antevens/sladdseg/pcb/eu/fab/README.md

# EU boards v0.7 – PCBWay order packs

Generated by `make pcb` (`pcb/eu/tools/build.sh`), one folder per board. Do the review checklist
below before ordering. Spacing values are design targets, not a compliance claim, and the EU stack
depth is still to be tried in a real box (D-36).

| File (in each board's folder) | Use |
| --- | --- |
| `<board>_v0.7_gerbers.zip` | Upload as the PCB file: RS-274X Gerbers, Excellon drills in mm (PTH and NPTH separate), drill maps |
| `<board>_v0.7_bom.csv` | Assembly BOM with MPNs (the mains board's S1 and BAR1–BAR4 have quantity 0: do not fit) |
| `eu_mains_board_busbar_v0.7_bars.dxf` | The mains board's four bars for PCBWay's CNC / laser cutting: mm, one closed outline per bar with its pin holes |
| `<board>_v0.7_centroid.csv` | Centroid, both sides, origin = board centre (S1 and the mounting holes left out) |
| `<board>_v0.7_assembly_front.pdf`, `_assembly_back.pdf` | Assembly drawings (back mirrored) |
| `<board>_v0.7_schematic.pdf` | Schematic |
| `erc.rpt`, `drc.rpt` | ERC and DRC reports of this build (all severities, schematic parity on) |
| `gerbers/` | The unzipped Gerber and drill files |

## Mains board (`eu_mains_board_busbar/`)

- Round, 57.9 mm across, notched for the box's four screw domes; 2 layers, standard FR-4, 1.6 mm, **1 oz** (no PE on
  the board, D-94), **HASL lead-free**; the bars' lands have no solder mask.
- The load runs in four straight laser-cut copper bars on the front, along each WAGO pole's pin row to the rocker
  (D-153). Bars (PCBWay CNC / laser cutting): `eu_mains_board_busbar_v0.7_bars.dxf`, mm, copper C110 **0.5 mm**, tin
  plated, four pieces (BAR1–BAR4 in the BOM, not fitted). Soldered on the front before the board goes onto the
  barrier's bosses; S1 from the back after.
- **The outline has a routed relief slot under the PSU.** It is part of Edge.Cuts, not a drill: add
  "routed isolation slot in outline, do not omit" to the order remarks.
- Three Ø2.2 holes for the barrier's long bosses (M2), no copper within 1.0 mm.
- Front (F): F1, RV1, J3 (SMD). Back (B): J1, J2 (WAGO 2604-3102), PS1 (Zettler ZPI03S0500WC), THT.
- S1 (Marquardt 1802.2504) is **not fitted** by PCBWay: it snaps into the barrier's cup first. **Solder it by
  hand only after the mains board is screwed onto the barrier's bosses**: its holes are 5.2 mm plated slots
  (D-88), so the cup's panel cutout, not the board, locates the rocker.

## pin board (`eu_pin_board/`)

- D-shaped, 57.9 × 27.9 mm, notched round the domes and the mains board's boss; 2 layers, FR-4, 1.6 mm,
  1 oz.
- Front (F): C1 and four Harwin P70-2200045 SMT spring pins with pegs (D-59): P1 (GND) and P2 (+5V) onto the barrier
  board's pads, P3 (+5V) and P4 (GND) onto the battery-free back cover's pads (D-54). Back (B): J1, Samtec
  SSW-102-01-G-S socket (THT, gold contacts) onto the mains board's TSM header.

## Review checklist (before ordering)

- [ ] Isolation targets on the mains board (any two mains nets ≥ 3.2 mm on standard FR4, IEC 60664-1 creepage at
      the 320 V row, PD2; mains to the 5 V island ≥ 8.0 mm plus the slot, D-153) reviewed against IEC 60664-1 /
      62368-1 and the switch standard (IEC 60669-1); L and N bars both on the front (hard constraint 1).
- [ ] Thermal review of the bars (0.5 mm copper) and the 1 oz feeds to F1, RV1 and the PSU (under 1 A).
- [ ] The rocker's pin stems over the bars: on a sample, whether the 1802.2504's stems reach the board at the pads
      (our model of its drawing says they do); the bars lift it by 0.5 mm plus solder (D-153).
- [ ] The room between the board's front and the barrier for the bars (not in the CAD yet).
- [ ] WAGO 2604 pin size against the bars' 1.3 mm holes (MEASURE on a part).
- [ ] Optional conformal coating after assembly (D-152, docs/ASSEMBLY.md): used or not, the coating chosen; not counted towards the spacing.
- [ ] PS1 Zettler ZPI03S0500WC (D-100): its insulation class (reinforced?) and overvoltage category are not in the
      datasheet (I/P-O/P 3600 VAC, UL/EN 62368-1): confirm with Zettler or its UL / CB file before mains use.
- [ ] F1 T1A (Zettler's application circuit shows 0.5 A / 250 V) against the branch circuit's prospective fault current
      (UMT 250 breaking capacity).
- [ ] WAGO 2604-3102 pin rows checked on a part (from WAGO's 3D model).
- [ ] Header / socket stack: TSM-102-02-L-SV post 8.13 mm into the SSW socket (body 8.5 mm), 16.1 mm
      between the boards; 3.07 mm engagement as designed (D-59).
- [ ] Spring pin working height on a printed barrier (6.4–7.2 mm, designed 6.8 ± 0.3).
- [ ] EU stack depth tried in the printed test socket (D-76), then a real 47 mm box (−43.8 mm deepest part).
- [ ] Approvals of S1, J1, J2, PS1, F1 and RV1 adequate for the installation.
- [ ] PE (D-94): joined in the box in a WAGO 221-412, not on the boards; the steel piece in the barrier's pocket floor
      is the one metal part a user can touch with the remote out, insulated from mains only by the V-0 barrier: whether
      that is double / reinforced insulation (no PE needed) is for review.
- [ ] Second-source rocker E-Switch RA412C1100 (D-88): its tab rows on a sample, tabs soldered into the
      slots outside the maker's listed terminations (D-86), its 10(4) A ENEC rating accepted; S1's slot pads
      reach the WAGO bodies' edge (0.05 mm), 3.85 mm from their pins.
