antevens/sladdseg/docs/DESIGN.md

# Design: requirements and decision log

## Context

- NA single-gang device boxes, 2" × 3" opening (≈50.8 × 76.2 mm).
- Every light socket has an IKEA Matter (Thread) smart bulb(s). Typically controlled by Home Assistant.

## Requirements

| ID | Requirement |
|----|---|
| R1 | Replace each light switch with a plate that holds an IKEA BILRESA scroll-wheel remote, flush/recessed. |
| R2 | mmWave presence sensing in every switch location. |
| R3 | Temperature + humidity in every location. |
| R4 | Emergency means to (a) turn lights on when Home Assistant is down and (b) de-power the circuit. Need not be easily accessible. |
| R5 | Emergency off must also de-power the presence sensor. |
| R6 | Keep the face plate as thin as practical. |
| R7 | Same electronics usable in EU/UK (250 VAC-rated parts). |
| R8 | Printable on a hobby FDM printer (Elegoo Centauri Carbon 2 Combo, ElegooSlicer); PCB fab + THT assembly by PCBWay. |
| R9 | No soldered or plugged connection between the face plate and the barrier: every electrical interface across that split is a spring ("pogo") contact, so the face plate lifts off and goes back on blind (human requirement 2026-10-08). |
| R10 | No wires and no soldering at assembly between any two boards or modules. 5 V, NA and EU: spring (pogo) contacts preferred; a flex with a latching connector, long enough to plug and unplug by hand with the latch in view, only where spring contacts cannot reach. Mains: house wiring and mains leads end in WAGO push-in terminals on the board, never soldered (human requirements 2026-10-08). |

## Decision log

| ID | Decision | Why / rejected alternatives |
|----|---|---|
| D-1 | No existing product does R1+R2+R4 → custom plate. | Inovelli Blue mmWave dimmer (Zigbee, smart-bulb mode) considered; has no humidity, no Bilresa mount. |
| D-2 | Don't design own mains switching electronics or put Li-ion cells in the box. | Certification (CEC approved-equipment requirement), heat, fire risk. |
| D-3 | Presence: Apollo MSR-2 (ESPHome, Wi-Fi) rather than Matter sensor. | Aqara FP300 too big (42×42×50) and battery-tuned; IKEA has no mmWave (MYGGSPRAY is PIR); Everything Presence Lite too big, no climate. HA is the controller, so ESPHome native API is fine/better. MSR-2 is 40×24×15 cased. |
| D-4 | Climate: SHT45 on MSR-2 I²C, thermally isolated bay at plate bottom. | MSR-2's DPS310 reads high from ESP32 heat (Apollo says so); IKEA TIMMERFLOTTE (70×70×30) too big. |
| D-5 | Keep BILRESA intact (batteries in), recessed in box, removable. | De-cased board option explored (I-beam PCB, encoder + tactile) but intact is simpler, stays usable as handheld. |
| D-6 | Emergency control = mechanical rocker in series with the load, hidden behind the remote. | Shelly relay dropped: all bulbs are smart, a relay adds nothing. Spring-carrier "push the remote" idea dropped once the switch could be hidden. |
| D-7 | PSU fed from the load side of the rocker. | R5. |
| D-8 | Bulbs' Matter power-on behaviour set to On. | Off→on of the rocker then turns lights on without HA (R4a). Must be verified per bulb. |
| D-9 | **Superseded by D-26.** Rocker: Bulgin/Arcolectric C1300AABBEN602A (16 A 250 VAC, CSA/UL, 27.3×12.3 cutout). | R7. E-Switch RB141C1100 is 125 V only. Würth 471005264152 has ENEC/UL but no Canadian mark listed. ENEC on the Bulgin part still to be confirmed from datasheet. |
| D-10 | **Partly superseded (D-24: the carrier PCB is now the mains board).** PSU: Mean Well IRM-03-5 (85–305 VAC, 5 V 600 mA, 37×24×15, cURus/CB/TÜV) on a carrier PCB with fuse + MOV. | Encapsulated, reputable, universal input (R7). Headroom for MSR-2 CO₂ variant. |
| D-11 | **Partly superseded (D-66: the plate is 14.4 mm thick).** Low-voltage electronics in the plate, mains parts in the box; plate stands ~13 mm proud. | 50 mm box width can't hold remote + sensor side by side; puts sensors in room air; clean barrier. |
| D-12 | **v0.2 (done):** split into V-0 "box insert" (all barrier geometry) + "trim plate". | Face-down single-piece print needs supports in the pocket; limits flame-rated material to the part that needs it. |
| D-13 | Fix the v0.1 scoop leak: the region between the pocket shell and the collar is now **solid barrier material**, and the scoops sit wholly inside the barrier. | In v0.1 that region was hollow under a 2 mm face skin; the finger scoops (bottom at z = 8.5) cut through the skin, opening the mains side to the room. Found by the new barrier test in `checks_na.py`. |
| D-14 | **Partly superseded (D-50, D-68: printed plug-down on supports under the seal lip and the pin board pocket; D-24: no PSU rails or roof).** Barrier printed floor-down with no supports: thick floor down to the bed, 45° taper carrying the flange underside, flange underside chamfered outside a 1.25 mm flat seal band on the wall, PSU rails integral with a **gabled (45°) roof** over the PCB back instead of a flat bridge. | Every downward face is either on the bed, ≤ 45°, or a ≤ 2.3 mm ledge (checked). A separate screwed PSU cradle was considered; no room for screws that don't block the PCB or breach the floor. |
| D-15 | **Superseded by D-23, D-24.** PSU carrier 42 × 44 mm (was 40 × 36), slides in from the bottom end of the rails, stops at a top end stop; the box wall keeps it in. | 37 mm IRM-03 + 2 mm rail keep-outs need ≥ 41 mm; J1/F1/RV1 and the isolation slot need the extra height. Top edge stays 4 mm under the rocker body. |
| D-16 | Face plate–barrier interface: the barrier's island is flush with the face; the face plate's face clamps the barrier flange; both are held by the two #6-32 box screws; two asymmetric Ø3 pins key the orientation. | One screw set, no extra fasteners in the barrier, can't be assembled rotated. |
| D-17 | **Partly superseded (D-74: one straight bore; D-50: stock FFC, no flex jumper).** 5 V pass-through: vertical leg out of the box (room-right, J2 side) then 45° out through the flange into the face plate hollow; carries the 5 V flex jumper (D-31). | Only barrier opening; the jumper never crosses the box rim below the wall plane. |
| D-18 | Barrier material: **Elegoo PC-FR** (retailer listing: UL 94 V-0; Elegoo's data sheet states no UL94 class or thickness. Certification deferred: a spool with a stated V-0 rating is chosen before an installed build, human decision 2026-10-08 → `V0_RATED_T`). Stock "Elegoo PC-FR @ECC2" slicer profile, 6 walls. | Printable on the CC2 (280 °C), has a vendor profile. A filament's V-0 rating is for moulded bars; a printed part is not certified by it. |
| D-19 | F1 = T1A 250 V TR5 (Littelfuse 39211000000). **Designer's choice, needs human review.** | Mean Well's IRM-03 spec and PCB installation manual give no external fuse rating; inrush 20 A typ at 230 VAC (datasheet). |
| D-20 | PCB: all THT, one side, PCBWay turnkey. Isolation targets enforced as KiCad 9 netclass + custom DRC rules (clearance and `creepage`). | See `pcb/SPEC.md` (removed with the v0.2 carrier; in git history). Targets, not a compliance claim. |
| D-21 | BILRESA modelled as 45 × 70 mm with an R8.5 back round-over; pocket clearance `CLR` 0.6 → 0.5 mm. | IKEA UK lists the product at 45 × 70 × 20 mm; a third-party wall mount's pocket measures 45.4 × 70.4 with a quarter-circle back of R≈8.5. At 45 mm, `CLR` 0.6 put the pocket shell 0.1 mm outside the barrier's box-clearance outline. Reference values until measured. |
| D-22 | **Partly superseded (D-44, D-52: the remote's plate is the magnet, the supplied part is steel).** The supplied adhesive magnet goes in a recess in the pocket floor, centred under the remote's flat back, 0.5 mm below the seat (`MAGNET_SETBACK`). | The remote carries a steel plate; the magnet ships separately for wall mounting. Recessing it keeps the seat flat. The setback gap weakens the pull without cutting the magnet; spacers or shims tune it. Replaces the v0.1 "steel target" recess, which assumed the reverse. |
| D-23 | **Mains board:** the house cables (line, neutral, ground in and out) land on push-in terminals on the PCB; the rocker switches line on the board; the PSU is fed from the switched line on the same board. Line on one side, neutral on the other, ground copper along both sides. Copper may be 2–6 oz. Supersedes hard constraint 1 ("15 A never on the PCB"), lifted by the human on 2026-10-07. | No tool-free termination exists for the certified rocker: the screw-terminal Bulgin 6000 option could not be confirmed as made, and users should not solder or crimp pigtails. Removes wire nuts and the internal pigtail. Cost: the uncertified board now carries the branch circuit. |
| D-24 | **Partly superseded (D-102: L–N, in to switched and mains to PE 3.0 mm on high-CTI FR4; D-153, D-155: 3.2 mm on standard FR4, the load in bus bars).** **One board, OVC III (human decision 2026-10-07):** L/N/PE in and out on push-in terminals, rocker on the board in the line path, PSU fed from the switched side, 5 V side isolated; must fit a single-gang box no deeper than 2.5". Spacing targets: L–N and L or N to PE ≥3.5 mm, mains to 5 V ≥8.0 mm plus a routed slot (IEC 60664-1 Tables F.2/F.5: 4 kV basic 3.0 mm, 6 kV reinforced 5.5 mm, 320 V PD2 group III creepage 3.2 mm basic / 6.4 mm reinforced; EN/UL/CSA 62368-1 to be checked for anything stricter). The IRM-03 is rated OVC II, so the fuse + MOV ahead of it carry the OVC III surge duty. | Replaces the two-board concept: the single board fits once the terminals (back, middle) and PSU (back, bottom) no longer overlap and the 5 V connector is surface-mount on the front. |
| D-25 | Field wiring lands on one 6-pole WAGO 2604-1106 push-in lever block (PE, L in, L out, N in, N out, PE; 4 mm², 12 AWG, 5 mm pitch), wire entry parallel to the board, on the board's back. Its pin spacing is covered by its voltage rating; the D-24 spacings apply to the board copper around it. | Human decision 2026-10-07. Rated for the voltage at OVC III / PD2 (verify the exact rating on the WAGO datasheet), so separate 1-pole blocks are not needed. |
| D-26 | Rocker: **Marquardt 1802.2504** (DPST, PCB pins, drawing 1802.2504 rev g 2003-09-16): ENEC 12(4) A 250 V~, UL-recognized/CSA 15 A 125–250 VAC; 5.3 mm above the panel, PCB seat 16.2 mm below; holes 1.3 mm on 7 × 10.2 mm; cutout 19.4 × 21.9 (1.25–2 mm panel). Human decision 2026-10-07. | Stack 21.5 mm against 28.5 mm for the Marquardt 1552.2602 (16(4) A), leaving ~12 mm behind the terminal block in a 2.5" box instead of ~5 mm. 12 A EU rating is above the usual 10 A wall-switch rating; inspector to confirm. Pinout to be checked with a meter on a sample. |
| D-27 | **Superseded by D-50.** **Sensor flex.** One single-layer flex in the face plate connects the MSR-2 and the SHT45 and takes 5 V from the barrier: plug end under the MSR-2 on its rear connector CN2 (stiffened, flex + stiffener + mated stack fit the 1.8 mm behind the board), out through the bay frame, up the top-right corner to just under the face skin, down the right channel (X 34.8-38.8, leaving a 1.2 mm strip along the flange face for the 5 V jumper), along the bottom to the SHT45 bay, the SHT45 soldered on the flex tail under the vents. Signals: 5V, GND, 3V3, SDA = IO1, SCL = IO0 (Apollo pinout + ESPHome config). CN2: 0.4 mm pitch, 2 rows, ~26-30 contacts (measured from Apollo photos, scale from the board in the same plane); P4S / SlimStack / DF40 class; exact part and contact map open. Power contact: two Harwin S7081-42R SMT spring fingers (+5 V, GND; gold contact, 4 A, recommended working height 2.10 mm, minimum 1.70, free 2.30; drawing S7081-42R iss. 7) on the stiffened flex underside, working at 2.0 ± 0.2 mm on the gold pads of the 5 V jumper's stiffened end (0.6 mm, D-31), which lies on a shelf off the flange's right face (flat underside at z 7.0, where the flange is solid to its face, 2.8 mm wide, then 45° to the edge: prints unsupported). The MSR-2 is powered through CN2's 5V (human confirmed 2026-10-07). The flex is single-layer: each 90° corner of the route is a 45° fold, which turns the strip over, so the plug, fingers and SHT45 all sit on the copper side and the flat pattern is one straight strip (`pcb/shared/`). | Replaces the sensor-board + pogo + breakout concept: one part, nothing to unplug when the face plate comes off, and the flex fits the 1.8 mm behind the MSR-2 where a rigid board with Apollo's GPIO add-on (8.5 mm header) does not. Mill-Max 0907 / 825 pins dropped: their 6.5 mm height puts the target below the printable part of the flange (45° chamfer below z 6.8, printed floor-down); spring fingers need ~2 mm. |
| D-28 | **Superseded by D-57.** **Board mounting: screw-in snap posts.** Four PC-FR posts screw into bosses on the barrier's underside and snap through Ø2.6 holes near the board's corners (top right lowered to clear the 5 V pass-through). Bosses stand on the barrier's print-bed plane; their blind holes are printed at M4 tap-drill size (Ø3.3, 7 mm + 45° cone tip) and tapped M4 × 0.7; the posts' studs are printed at Ø4.0 and cut with an M4 die. Post: stud, hex collar, Ø4.5 shoulder under the board's front face, Ø2.3 shaft, split Ø3.2 cone head over the back face; printed lying on a flat. All four board holes are unplated, with a 2.75 mm copper keep-out on both layers; the PE ring detours round MH1 and MH3 and is interrupted at MH2, so PE continuity (checked on F.Cu alone, no vias) never depends on copper under a post (human request 2026-10-08). | Edge arms needed space the box doesn't have; posts grown from the barrier would have to be printed with supports under the whole floor and their snap heads across the layers; a separate frame would be flimsy. Screw-in posts keep the barrier support-free, print the snap prongs along the layers, and a broken post is replaced alone. The top-right boss rises into the pocket corner under the remote's back round-over for a full thread (checked against the remote with `CLR`). |
| D-29 | **Partly superseded (D-50: the microphone on a carrier on the sensor board, no sensor flex; D-61: sound path 1.6 mm; D-83: SPK0641HT4H-1 + ADAU7002 on the board, no carrier; D-154: I²S SCK = IO7, SD = IO4).** **Microphone: push-to-talk voice to Home Assistant** (human decision 2026-10-08). PUI Audio DMM-4026-B-I2S-R (I²S, bottom port, 4.00 × 3.00 × 1.00 mm, 1.62–3.63 V) on the sensor flex's underside in the right channel at y 40.75, on a section widened towards the flange (where the flange corner rounds away; since D-47 below the flange's right band, sound hole at the bottom right). The port faces the face skin through a Ø0.5 hole in flex + stiffener, an adhesive gasket ring and a Ø1.0 sound hole through the skin. I²S on MSR-2 GPIOs SCK = IO4, WS = IO6, SD = IO7 (free on CN2; IO18/IO19 are the USB pins, IO2 a strapping pin); LR and CONFIG to GND (left channel), 100 nF, 100 kΩ SD pull-down per the datasheet. The mic had its own GND and 3.3 V contacts on CN2 (nets MIC_GND, MIC_3V3) so its lanes didn't cross the others on the single layer (since D-47: two layers, GND_SENS and +3V3 shared with the SHT45). Listening starts from Home Assistant (e.g. a BILRESA button) via an ESPHome action calling `voice_assistant.start`; no on-device wake word, no speaker. | The ESP32-C3 on the MSR-2 has one I²S peripheral and no PSRAM; ESPHome supports PDM mics only on ESP32/ESP32-S3, and warns audio components use much RAM/CPU, so streaming only on demand is the realistic load. Rejected: ICS-43434 (TDK: EOL), SPH0645LM4H-B (DigiKey: obsolete), T5848 (1.62–1.98 V, needs a 1.8 V rail and level shifting), MSM261S4030H0R (top port: would have to sit on the SHT45 tail, 150 mm of flex from the MSR-2). Server-side wake word = continuous streaming; an S3-based voice board = a new board. |
| D-30 | **Partly superseded (D-36: rocker and two boards; D-56, D-70: sensor board, no flex, snap-on face plate; D-72: steel piece in the pocket floor; D-78: plate 84.6 × 122.4 mm).** **EU variant (concept, in progress; the push-button and single PSU board below are replaced by D-36)**: a design of its own for a round DIN 49073 flush box (68 mm hole saw, Ø60 inside), neutral assumed present, in `cad/build123d/eu/` (`make eu`). Shares only the BILRESA, the MSR-2, the SHT45 and the microphone with the NA plate (human decision 2026-10-08). The remote sits on a 1.6 mm V-0 barrier floor over the box, centred on it, top flush with the face: plate 79.7 × 122.4 mm, 21.6 mm proud. The barrier is the whole barrier: floor, a cup under the remote's upper half holding a latching DPST push-button (Marquardt 1684.1101, 16(4) A 250 VAC, ENEC/UL/CSA, 4.8 mm tabs), two holes for the spring pins (below); two countersunk screws into the box's top and bottom dome pair, in the pocket floor under the remote; the PSU board is notched round all four screw domes, which the checks model as obstacles. The push-button is hidden until the remote is lifted out. The supplied magnet is glued under the floor (box side). A D-shaped board (`pcb/eu/`, ERC/DRC clean) 6 mm behind the floor carries the PSU (Traco TMPS 03-105, D-32) on its back and fuse, MOV, capacitor on its front, held by two M2 screws in barrier bosses; it carries only the PSU's current; L_SW from the push-button and N from the house neutral end in a WAGO 2604-3102 push-in block on its back (400 V III/2, conductors enter from the back of the box), no soldered leads (D-32). The sensor flex follows the NA topology in the face plate's right channel (MSR-2 CN2, mic with its sound hole, SHT45 under its vents); two SMT spring pins on the PSU board's front (Harwin P70-2200045, 2 A, working height 6.4–7.2 mm, designed at 6.8 ± 0.3) stand through two Ø1.9 holes in the barrier and press on gold pads on the flex where it dips in the channel, backed by a rib in the face plate: no lead, no target board, no solder joint across (R9, R10). The pin barrels fill the holes (0.18 mm radial gap); the barrier check treats the holes as plugged by the pins. The PETG face plate carries the face, pocket walls, 45° finger notches, MSR-2 and SHT45 bays, held by two M2 screws under the remote's rounded back edge. Deepest part −27.8 mm (the WAGO block): 19.2 mm free in a 47 mm box. | The remote cannot go below the wall in a Ø60 box (its flat back alone spans ~Ø60), so the plate is at least the remote's height plus the barrier floor; the magnet under the floor saves 2 mm (holding force to be tested). One piece with the floor and the cup would need supports either way up, hence the flat barrier + face plate split. Open: the push-button's 4.8 mm tabs take crimped receptacle leads (no PCB-mount latching DPST at 16 A 250 VAC found); push-button dimensions above / below the panel (MEASURE), magnet holding force through the floor, face plate tab clearance against the remote's real back shape, KiCad EU sensor flex, fab files, box dimensions (MEASURE). |
| D-31 | **Superseded by D-50.** **5 V flex jumper (NA).** The 5 V lead and the target board are replaced by one single-layer flex (`pcb/shared/`, `cad/build123d/na/jumper_na.py`): a stiffened 6-contact end plugs into J2 on the mains board (Hirose FH12-6S-0.5SH(55), 0.5 mm, slide lock; contacts 1–3 GND, 4–6 +5 V), the strip (3.0 mm wide) runs through a 40 mm Z-fold service loop between board and barrier, up the pass-through (the 3.5 × 0.3 end threads the Ø4.5 hole) and out of the flange, and ends in a stiffened pad end (0.6 mm) on the barrier shelf under the sensor flex's spring fingers. 156 mm flat. Plugged with the board held beside the barrier, latch in view. Connector-end dimensions MEASURE (Hirose FPC drawing). | R10 (human requirement 2026-10-08). Spring pins board-to-flex are not possible on the NA plate: the board's front is about 37 mm behind the flange and the only route is the 45° pass-through, so pogo was the first choice and the human's second choice, a flex plus a snap connector, is used. The service loop sets the length: a 1-2 mm FPC latch needs room for fingers and eyes. |
| D-32 | **EU PSU and mains terminal (board split by D-36).** The IRM-03-5 (37 × 24 mm) is replaced on the EU board by a Traco TMPS 03-105 (25.4 × 25.4 × 16.3 mm, 5 V 600 mA, 780 mA peak 30 s; IEC/UL 62368-1, IEC 60335-1, CB, cURus; OVC II, PD2, reinforced, 3 kVAC; datasheet rev. 2026-07-01), which frees room for a WAGO 2604-3102 (12.4 × 16.7 × 21.3 mm, 2-pole, 4 mm², conductor entry 90° to the PCB, 400 V III/2, 32 A) beside it on the back. L on F.Cu, N on B.Cu. The soldered L_SW / N leads are gone (R10). | Human decision 2026-10-08 (shrink the PSU). A 2604 does not fit next to the IRM-03 in the Ø60 box; the smaller WAGO 2601 is rated 160 V at OVC III / PD2, below hard constraint 3. The 90° entry takes the house wires straight from the back of the box, where the round box has room; a 0° entry would point the wires at the box wall. |
| D-33 | **3.3 V rail for a battery-free BILRESA (EU board, first step). Superseded by D-35: the regulator moves to the face plate side, off the PSU board.** TI TLV75533PDBV (3.3 V, 500 mA, SOT-23-5) on the 5 V side with 1 µF in and out (TLV755P datasheet), net +3V3. Target: an barrier version where the remote rests without batteries and back cover, powered on its battery contacts by spring pins (not placed yet). The IKEA manual (AA-2675003-2) gives 2 × AAA HR03 and recommends LADDA HR03 rechargeables (NiMH, 2.4 V nominal): 3.3 V is above that and near fresh alkaline cells. zigbee2mqtt (E2490 page) reports the remote's battery percentage as tuned for 1.5 V alkaline cells, i.e. a 3.0-3.2 V pack, and the remote reports its supply voltage in mV, so the voltage it sees can be read back. | Human decision 2026-10-08 (3.3 V rather than ~2.7 V). An LDO from 5 V keeps the certified AC-DC module unchanged; no 1 x 1 in certified module with 5 V + 3.3 V outputs was found. FCC ID FHO-E2490 internal photos: the cells are in series (strap at the radio-module end, GND / P1 terminals at the system-button end); the battery contacts face along the cell axis, so a spring pin square to the remote's back cannot press on them directly: a printed dummy-cell pair carrying the 3.3 V to the terminal contacts is the likely interface. Open: battery-contact positions (approx. in MEASUREMENTS) and spring travel, the remote's sleep and peak current, its response to 3.3 V (low-battery indication), the NA board's 3.3 V. |
| D-34 | **Dummy-cell barrier (BILRESA E2490, first design). Superseded by D-35 (code removed).** A printed part replaces the remote's back cover and both AAA cells (`cad/build123d/dummy.py`): the remote's outline up to the parting line with a flat back (45° edge chamfer) and two D-shaped dummy cells (Ø10.3; dummy + stiffener + flex = 44.5, the AAA maximum). A single-layer flex (`pcb/shared/` cell_flex) lies copper-down in a recess on the back with two gold pads 0.3 mm above the back face (+3V3, GND at (15, 2.8) and (15, −1.2), over the EU board's free SELV area at the EU spring pins' working height), runs to the terminal end, bends up once through a slot and stands against the dummy cells' end faces on a 0.4 mm FR4 stiffener, copper outwards: 6 × 6 mm gold pads on each cell axis meet the remote's VBAT (P1) and GND (P2) contacts; between the cells only a 2 mm band passes under the remote's PCB strip. The bridge-end contacts touch plastic (the remote's strap needs no current). The remote's steel plate moves into a pocket in the barrier between the cells (0.4 mm under it). | No wires, no solder at assembly (R10); one bend, copper on the right side at both ends. Positions are REF from the FCC internal photos or MEASURE (cell axis height, PCB strip, steel plate, latch features), so the flex has no fab files (`CELL_CONFIRMED`). Open: how the barrier clips to the remote (the cover's latches, MEASURE), the EU barrier holes and pins for +3V3 / GND (two barrier openings: human approval), E2489 version. |
| D-35 | **Partly superseded (D-41: regulator on the cover flex; D-50, D-54: pads under spring pins, no floor insert or tongue; D-55: end section in slots).** **Replacement back cover (BILRESA E2490).** A printed cover (`cad/build123d/backcover.py`) replaces the remote's back cover: the remote's back shape (below the round-over's 45° point filled out to its 45° tangent so it prints back down without supports) and the remote's steel plate in a pocket (0.4 mm wall under it). Inside, a single-layer flex (`pcb/shared/` cover_flex) lies copper down on a ledge 2.0 mm above the back face; two Harwin S7081-42R spring fingers on it (free 2.30, working 2.0 ± 0.2, ≥ 1.2 N at 2.10, 4 A, 1000 cycles; drawing S7081-42R iss. 7) reach through windows onto the plate's floor pads. The flex runs (3 mm strip, slot under the GND contact block) to the terminal end, bends up once and stands on a 0.4 mm FR4 stiffener against two contact blocks: S7081-42R spring fingers on the cell axes press on the remote's VBAT (P1) and GND (P2) battery contacts (D-40); no dummy cells. On the face plate side a 0.6 mm printed pocket-floor insert (`eu/floor_eu.py`, bonded to the face plate, openings over the push-button and round the face plate tabs) carries a tongue of the sensor flex in a recess, its 4 × 7 mm gold pads flush; the tongue enters under the right pocket wall (notch) and folds 45° once so its copper faces up. The magnet holds the cover's back on the barrier: that hard stop sets the fingers' working height. The 3.3 V regulator goes on the cover flex (D-41). EU plate +0.6 mm (remote seat on the barrier). | Spring contact on the removable cover, flat wipeable pads in the plate (human: pad to pad is not reliable); no new openings in the barrier (D-34's pins would have needed two, exposed under the remote). Open: cover latches, steel plate, cell axis height, contact positions (MEASURE / REF), magnet hold vs. 2 fingers through 2.6 mm (barrier + floor + cover wall), NA pocket (follows the original curve; the cover's 45° fill does not fit it), EU sensor flex KiCad layout with the tongue and regulator, E2489 version. |
| D-36 | **Partly superseded (D-56: sensor pins onto the sensor board; D-59: TSM-102-02-L-SV header, 3.07 mm engaged).** **EU: two boards, PCB rocker.** The latching push-button and the single PSU board are replaced. The emergency rocker is the NA part (Marquardt 1802.2504, PCB pins, D-26), its panel in the barrier's cup under the remote (SW_Y 12.5; the back cover's steel plate and the magnet move to y −8, clear of the cup). Mains board, round, at the rocker's PCB seat (front −20.3): rocker, two WAGO 2604-3102 blocks (L in / switched, N in / switched, wires from the back of the box), F1, RV1, TMPS 03-105 on the back over a routed relief slot; L pours on F.Cu, N pours on B.Cu, ≥ 3.5 mm between any two mains nets; the PSU's outputs land on the 5 V island below the slot, with a 2-pin header. pin board, just under the barrier (as the old board): pin socket on the header (13.8 mm stack, 3.2 mm engagement), C1, the two P70 spring pins to the flex. Three long V-0 barrier bosses carry the mains board (two beside the cup, one through the pin board). | Human request 2026-10-08: the single board had no relief slot and carried 230 V and 5 V side by side, and the push-button needed leads; the rocker on PCB pins removes them, and the only 5 V copper on the mains board is the island behind the slot. Depth: the stack reaches −43.2 mm, 3.8 mm short of 47 mm box; to be tried in a box before changing (human decision 2026-10-08), a 61 mm Elektronikdose leaves 18 mm. Open: load-path copper sizing (2 oz), header / socket engagement with the parts, PE joined in the box. |
| D-37 | **NA J1 re-laid from WAGO's 3D model.** The 2604-1106 has its two solder-pin rows 8.2 mm apart (not 5.0 as inferred from the 2601), the first row 5.0 behind the entry face, the second 2.9 inside the closed back; body 16.1 mm deep at the board, the levers overhang the entry side up top (≥ 13.9 mm above the board past the S1 pads). J1 moves to pin rows y 8.1 / −0.1 (centre at the board y 5.05), pads round 2.2 mm (drill 1.3), the pours reach both rows, the PE ring notch inner edge moves to y −8.9, the N_SW feed under J1 is 0.5 mm at y −5.0 (PSU current, behind F1). J1's closed back is 6.4 mm from the PSU; its entry face 0.2 mm short of the S1 pads. ERC / DRC clean; WAGO's model is the J1 3D model (kept in scratch/). | Human decision 2026-10-08 (re-lay the NA board). The old footprint would not take the part. Cost: the pours beside J1's pads narrow to 1.3–1.8 mm (were 2.4–2.9), for the thermal review. |
| D-38 | **Through-hole pads clear of bodies on the other side; EU WAGO from WAGO's 3D model.** Every through-hole pad keeps its edge `PAD_BODY_GAP` = 1.0 mm from the fab outline of any part on the other side of the board (pin tail, solder fillet, iron); `make check` / `make eu` check it on the KiCad files. NA: rocker S1 moves to y 19.5 (was 18.0; its body sat 0.5 mm over J1's first pin row), J2 to y −19.5 (PS1.5 was 0.95 mm from it). EU: the 2604-3102 has its pin rows 8.2 mm apart, 0.65 mm off the body centre towards the entries; footprint, round 2.2 mm pads and the vendor 3D model follow it; blocks at x ±16.6, y 7.5 with the levers towards the centre (J1 turned 180° from J2), the in / switched pour split steps from the rocker's poles to the blocks', F1 at y −3.0. | Human observation 2026-10-08: the rocker sat on the WAGO pins. EU J3 header pins under the PSU body: see D-39. |
| D-39 | **Partly superseded (D-59: header TSM-102-02-L-SV, 8.13 mm post).** **Rocker footprint centred on the body; combined rocker 3D model; EU pin board kept, SMT header.** Drawing 1802.2504 rev g puts pins 1 / 2 on the body's centre line and 1a / 2a 7 mm off it; the footprint had the body centred on the 7 mm grid (3.5 mm off the panel opening). Footprint origin = body centre (SW_Y in params); `SW_SW_DIR`: NA switched pins 7 mm above (in pins at 19.5, switched at 26.5, pours extended), EU 7 mm below (in 12.5, switched 5.5). 3D model: the 1802.1108 housing (Marquardt LIB_1802.1108: same flange 21 × 24, rocker 5.3, body 22 wide, terminals on the same 10.2 × 7.05 grid, but solder lugs and no PCB seat) above its body bottom, on the 1802.2504 underside from its drawing. EU: the pin board stays; J3 becomes a Samtec TSM-102-01-L-SV SMT header (insulator 2.54, post 5.84, 4.7 A per pin with SSW; datasheet F-226), 3.08 mm into the socket. | Human decisions 2026-10-08: build the combined model; remove the pin board only if it is easier. Board-mount spring pins top out near 10 mm (Mill-Max 3 mm stroke series 9.6 mm, SMT 807 series 8.5 mm); the 22.2 mm span from the mains board to the flex would need test-fixture probes in receptacles, and the 13.8 mm between the boards is too long for a spring pin, so header / socket stay. |
| D-40 | **Back cover: spring fingers on the battery contacts.** The E2490 has, at each end of the compartment, one leaf spring (− side) and one fixed plate with a dimple set in a pocket in the end wall (+ side; FCC FHO-E2490 internal photo 1), so at the terminal end only GND springs back; VBAT is a fixed plate. The cover flex's 6 × 6 mm pads are replaced by two Harwin S7081-42R (J3 VBAT, J4 GND) on the cell axes, long axis across x; the end section stands FINGER_WH (2.0 mm) in from the plate (`BC_COPPER_Y`; plate setback `BC_TERM_SETBACK` MEASURE, 0 for now), so J3 works at 2.0 mm on the plate and J4 shares the travel with the leaf spring. One flat end section, one bend, as before. | Human observation 2026-10-08 (one terminal is recessed and needs a spring); human decision: S7081 at VBAT. A flat GND pad on the same end section would meet the leaf spring 2 mm before the cell end plane, with little or no preload, so GND gets a finger too; it also works whichever side turns out to be the fixed one. Open: plate setback and pocket opening, leaf spring travel (MEASUREMENTS). |
| D-41 | **Partly superseded (D-49, D-50: no NA floor insert, jumper tongue or tunnel; D-54: no EU floor insert; D-53, D-79: pad positions; the regulator on the cover flex stands).** **Battery-free remote on NA and EU.** The 3.3 V regulator moves to the replacement back cover's flex (TI TLV75533PDBVR, SOT-23-5, 1 µF in / out, TLV755P datasheet; copper down in a recess in the cover, 0.4 mm wall left), so the plate brings +5 V and GND to the floor pads on both variants (supersedes D-35's regulator on the sensor flex). Cover fingers at (14, 4.0) +5V and (14, −5.0) GND (moved 0.5 mm down so the NA floor strip clears the switch well's opening). End fingers stand vertical, bend end up: the battery contacts ride down the arm's ramp onto the dome as the cover goes on. NA: a printed floor insert (`floor_na.py`, 0.6 mm, openings over the switch well and the corner board-post boss) raises the remote 0.6 mm (face 2.6 mm proud); the 5 V jumper becomes a 2-layer flex (0.2 mm) whose pad end grows a tongue between its two contact pads (y 18.65): through a 2.8 mm tunnel in the barrier flange at the pad end's height, down a 0.4 mm groove in the pocket wall (the stadium's curved end, wall position computed) to z 0.5, down the wall into the floor's recess, then to two 7 × 4 mm pads under the fingers; copper stays up after the two bends. Tunnel and groove lie wholly above the wall plane, between the face plate hollow and the remote pocket (both low voltage); the mains-air check passes. EU: the floor insert and the tongue from the sensor flex's pin pads already exist in CAD (`floor_eu.py`, `sensor_eu.py`), carrying +5V / GND. | Human decisions 2026-10-08: battery-free on both variants; allow a slot above the wall plane (AGENTS hard constraint 2 wording updated); end contacts with the ramp into the remote. On one copper layer the jumper's GND edge lane cuts +5V off from any tongue on the inner edge (and the sensor flex has no +5V past its fingers), hence two layers. Open: the EU sensor flex has no KiCad layout yet (tongue included), jumper stack-up thickness, plate setback / leaf spring travel (MEASUREMENTS), magnet hold through floor + cover (90 % of the NA magnet over the cover's steel). |
| D-42 | **Partly superseded (D-56: no EU sensor flex; D-53, D-79: pad positions; D-72: EU steel piece; the ESTIMATE values stand).** **EU sensor flex in KiCad; estimates from photos.** `pcb/shared/kicad/eu_sensor_flex` (`eu_flex_parts.py`): the NA topology on the EU route (plug, fold 1, mic on the outer side, dip to the spring-pin pads, fold 2, SHT45), single layer, ERC / DRC clean; fab files withheld with the CN2 placeholder. The battery-free tongue leaves the pad section between the pin pads; to need no crossing after its 45° fold the spring pins swap (P1 GND above, P2 +5V below; C1 on the pin board turned) and the plug brings GND out twice (GND, GND_SHT). EU floor pads x 13.5–16.3 (clear of the switch cup's opening), tongue at y −6.8 between the pins (face plate notch moved), fold at x 17.6. Back cover fingers at x 14.4 (strip to x 16.5 for the estimated back curve), steel plate at y −5.5; NA magnet recess at y −1.0 (`MAGNET_REC_Y`, over the remote's own plate and the cover's steel), EU magnet derived (clear of the cup). `ESTIMATE` values from the FCC photos, the IKEA label drawings (1:1) and the IKEA product page (MEASUREMENTS) replace placeholders for the remote's outline details, seam, wheel, LEDs, steel plate, cell axes. | Human request 2026-10-08: estimates from pictures, finish the EU version. Open: the supplied magnet looks ~47 × 17.5 mm (drawing), too long for the space under the remote (decision); BC_TERM_SETBACK, BC_BRIDGE_H, leaf spring travel stay MEASURE; CN2 part. |
| D-43 | **Partly superseded (D-52: the supplied part is steel; D-72: EU piece in the pocket-floor recess).** **Supplied magnet cut to length.** The BILRESA's magnet (~47.4 × 17.5 mm, full round ends, ESTIMATE from the label drawing) is cut once across by the user: an 18.5 mm piece from one round end. NA: in the barrier's recess from y −13.0 (round end, in the recess's round end) to +5.5 (cut edge, SEAT_T clear of the switch well), 82 % under the remote's own steel plate (battery use) and 93 % under the back cover's. EU: the same piece under the barrier, cut edge 0.5 below the switch cup, 79 % under the cover's steel. | Human decision 2026-10-08. Open: the real magnet size and thickness, pull test. |
| D-44 | **Back cover snap clips, side ribs, plate clips.** As the original cover (human photos IMG_5088-5090 and measurements 2026-10-09): cover 9.8 mm rim to back, 1.6 mm shell; snap clips at the top and bottom ends (x 0), 3.1 × 1.2 mm, standing on the curved floor below the rim, 0.5 mm hook inwards over the housing's wall, the bottom one at the flat-blade pry notch in the rim (top 4.7 mm above the inside floor, hook tip 4.3 mm in from the outside rim); the top one 1.0 mm below the rim, hook tip 3.0 mm in from the outside rim (2.8 measured on the original); both hooks 0.7 mm, 0.2 deeper than the original's after the printed clips did not catch; its back merged into the end wall; free-standing ribs at mid-length on the curved floor, 0.8 mm thick, 36.2 mm apart inside, tops 3.6 mm below the rim (stiffening, no hook); the plate in the cover (a magnet, 12 × 20 × 2) on the full 1.6 mm shell (a thinner floor under it flexed and let the magnet pop out on the first print), located by a ridge round it (0.8 × 1.2 mm, 0.05 mm clearance after 0.15 rattled on the first print, open beside the clips) and held by a clip at each end (6.0 mm wide, 0.8 mm tab rising from a relief down to 0.4 mm of shell, 0.45 mm hook, 0.3 mm over the plate, 2.9 % strain snapping in; the first 4.0 × 0.8 mm tabs on the floor broke in PLA). All print back down without supports. | Human corrections 2026-10-09; the 6.0 mm plate clips also broke in PLA, kept for PETG (the cover's print material, human decision 2026-10-09). Open: whether the plate clips survive in PETG (verify on the first PETG print; fallback: crush ribs or a rigid-lip seat), clip and rib rise, hook size, pry notch size (MEASURE). |
| D-45 | **Partly superseded (D-50, D-56: no flexes or tape in the plates; D-66, D-68: MSR-2 on spacers under the face plate's posts; D-55: end section in slots, no side hooks; D-79: five flex hooks).** **Every part held.** Review 2026-10-09 found loose parts; now: MSR-2 board by two snap hooks at its short ends hanging from the radar skin (0.5 mm lip over its back face, a relief in the bay frame behind each so it flexes; NA and EU face plates); the back cover's flex by a 0.8 mm FR4 stiffener on its pad and regulator sections pressed down past six printed snap hooks on its long edges (each side of each finger and of the regulator; 0.7 mm posts rising from a relief to 0.4 mm of shell, 0.3 mm lip, 0.2 mm over the stiffener's edge, 0.05 mm above it, 2.8 % strain on snapping in; heat-staked pegs replaced, human 2026-10-09: they don't hold on a flex), its end section by a 1.2 mm lip at each contact block's foot and a snap hook beside each block's outer side (1.0 mm post from a relief to 0.4 mm of shell, 0.35 mm lip over the section's outer edge, z 7.0–9.0 below the rim, outside the battery contacts, 1.2 % strain; PETG only, human 2026-10-09; the earlier hooks on the blocks' tops broke in PLA and rose into the housing's contact slots); above the rim the blocks, the end section and its stiffener stay inside a 5.0 mm radius round each cell axis (rounded tops; the square corners stopped the cover snapping on, human 2026-10-09); the 5 V jumper's pad end by a stop at the shelf's lower end plus tape; tape (3M 467MP) at named points for the light parts (sensor-flex stiffeners, SHT45 tail, NA floor insert, tongues). Inventory in docs/ASSEMBLY.md. | Human review 2026-10-09 ("the more I look the more parts I find that aren't secured"); mechanical holds where a spring loads the part, tape where nothing does. Open: MSR-2 board thickness and edge clearances, hook feel on a print. |
| D-46 | **Face plate screw holes for #6 heads.** 3.6 mm clearance hole and an 82° countersink 6.8 mm across at the face (ASME B18.6.3 #6 oval / flat heads 6.05–6.65 mm, 82°), 1.84 mm deep in the 2 mm face skin, the barrier's boss under it. The MSR-2 bay follows the smaller head (0.6 mm lower); the mic's widened flex section ends 0.5 mm earlier. | First print 2026-10-09: the 58° / 8.0 mm countersink and 3.8 mm hole let typical heads sink through. |
| D-47 | **Partly superseded (D-50: no sensor flex, spring fingers or tongue; the plate size stands).** **Smaller NA plate: 72 × 132 mm, centre 7.2 mm above the box centre.** Nothing sits beside the flange any more: the face plate's side wall is 0.25 mm outside it. The 5 V spring fingers (side by side, +5V outer, GND inner) and the jumper's pad end move to the top-right corner, on a shelf printed 45° out from the seal band (the fingers' domes within its 9.8 mm print limit); the pass-through keeps its vertical leg (y 33.5) and leaves the flange's corner at 45°. The sensor flex leaves CN2 to the right, rises, folds into the corner, narrows to 2.4 mm and runs down the flange's right band on the flange top in a 0.3 mm groove of the face plate, then on below the flange (the microphone, turned 180°, its sound hole at the bottom right) to the bottom fold and the SHT45 (bay just under the bottom screw). The flex has two copper layers (0.2 mm): the microphone and the SHT45 share +3V3 and a ground contact of their own (GND_SENS) on B, so the lanes route without crossings whatever CN2's pinout turns out to be; 0.1 mm FR4 under the plug keeps the stack behind the MSR-2. The battery-free tongue needs no tunnel: it lies in the band above the flange, crosses the flange in an open groove and the island rim in a notch a tab on the face plate fills flush, turns in its plane to meet the pocket's top arc square, goes down an open groove in the arc and runs straight down the floor at x 15.4 to the pads. | Human choice 2026-10-09 (plate felt big; the tunnel was hard to print and to thread). Open: the corner shelf and tab on a print; the 2-layer flex's stack-up from PCBWay. |
| D-48 | **Superseded by D-50, D-56.** **Flex retention audit.** Each flex was walked along its centre line against the printed parts: the sensor flexes' sloped runs (NA: the rise from CN2 to the corner fold, 13 mm up to 4.3 mm from any part; EU: the rise and both slopes of the dip to the spring-pin pads, 15–22 mm up to 5.3 mm) hung free. The face plates now carry a ramp over each, down from the skin, the flex 0.1 mm under it and taped to it. Every other run lies within 0.3 mm of a printed surface and has a named tape point (band groove, bottom run, tongue grooves; groove depths checked against the 0.06 mm tape). The 5 V jumper's service loop stays loose on purpose. | Human request 2026-10-09. |
| D-49 | **Partly superseded (D-50, D-54: no tongues or floor inserts; D-55: end section in slots, no side hooks; D-79: run notch along the GND post; the visibility rules stand).** **No flex in sight; the NA tongue on the face plate side; clips over tape.** Human rules 2026-10-09: no bare flex on the barrier with the face plate off, none anywhere with the remote lifted out (inside the face plate is allowed); every opening a flex passes lets its ends through; clips rather than tape where they fit. NA: the battery-free tongue moves from the 5 V jumper to the sensor flex (already two layers): off the finger section's left edge, left in the band above the flange, a 45° fold down the plate (copper up), in a 2.8 × 0.3 mm groove in the face plate's underside over the flange (0.5 at the fold) and under the face plate's tab in the island notch, the in-plane turn to the pocket's top arc, down the arc behind a 4.4 × 1.0 mm strip on the face plate (flush in a 1.35 mm groove in the barrier down to z 0.5, in front of the wall below, 45° between, the groove's end 0.15 behind the strip's jog), onto the pocket floor under the floor insert (a channel in its underside), up through a 2 mm slot onto the pad strip on its top (pads flush), the tail down a second slot; a notch from each slot to the floor's edge lets the tongue in sideways, so nothing is threaded. The floor insert hangs from the strip's foot (0.4 mm hook in the window of a 3.4 mm tab on the floor, 0.3 % strain), so face plate, strip, tongue and floor insert come off together and the barrier keeps only the jumper's pad end; a remote with its own battery cover sits on the floor insert too (on the pocket floor it would touch the strip). The jumper loses its tongue, the barrier its flange groove; the tongue's tape points and the NA floor insert's tape are gone. EU: the tongue runs under the floor insert from the wall notch, folds there, its neck rises through a slot onto the top; the flex is slit 0.3 mm beside the neck so the part carrying the GND pad lies on the top; GND turns to its pad above the slit; a notch from the slot to the edge. Back cover: the closed slot under the GND block (neither end of the flex passes it) becomes a 2.9 mm notch from the ledge up, spanned by the end section's 0.4 mm stiffener behind the GND finger; a snap hook beside each contact block's outer side holds the end section (PETG; replaces its tape). | Visible with the remote out: the floor insert, the strip, the pads with the flex just round them, and the tongue where it turns through the two slots. Open: the jumper's pad end keeps its tape (no room for a clip: MSR-2 frame on its left, finger bodies 0.1 mm from its sides, the shelf cannot reach its top edge); the EU floor insert is still glued to the face plate; hook and window fit, the slit width against PCBWay's flex rules, the 45° fold and the slot bends on a sample. |
| D-50 | **Partly superseded (D-68: no flat back, nuts or screws, sensor board on crush ribs; D-59: Harwin P70 pins on 7 mm spacers; D-74: straight bore; D-79: pin positions).** **v0.4: sensor board, passive face plate, spring pins through the pocket floor.** The barrier's 45° flange underside becomes a flat back (2.8 mm over the board) with a 0.5 mm skirt; under it, against the wall, one 1.6 mm FR4 **sensor board** round the plug, held by five M2 × 4 screws from the front into Würth WA-SMSI M2 L1.5 SMT nuts (9774015243R). On it: the MSR-2 on CN2 (placeholder mate), the SHT45 under its vents, the I²S microphone on a 7 × 6 × 0.8 mm **carrier** soldered flat by castellated edge pads (the bottom-port DMM-4026 on its underside hangs into a milled window in the sensor board, port up through the carrier, a printed sound tube from a 0.3 mm gasket on the carrier to the face hole), and J1 (FH12-6S). Copper keeps 8 mm along the wall from the box opening (front layer 6.4 mm in plan plus the board edge): the back layer only above and below the box, the right side carries three front-layer lanes (SDA, SCL, +3V3, 0.15 / 0.18 mm) to the SHT45, the left side a GND pour. 5 V comes from the mains board's J2 over a stock 152 mm 6-way 0.5 mm FFC (Würth 687606152002) through the pass-through into a pocket under the flat back; J1 / J2 pinout mirror-symmetric (GND 1, 3, 4, 6; +5V 2, 5) so a flipped or other-type FFC keeps the polarity; C1 (22 µF) moves to the sensor board. The **face plate** carries no electronics and no contacts. **Battery-free remote:** two Mill-Max 0919-0-15-20-89-14-11-0 SMT spring pins (3 mm stroke, 85 g at mid-stroke, catalog p. 24) on a 0.8 mm **pin board**, in a pocket under the pocket floor, through two pin-filled holes in the floor (barrel Ø1.50 in Ø1.90) onto Ø2.6 mm gold pads on the back cover flex behind Ø2.1 mm windows (the cover's fingers there become pads); compressed 1.93 of 3.0 mm, the barrels 0.93 mm above the floor inside the windows, the plungers 3.9 mm proud with the remote out. The pin board stands on two spacer posts on the mains board's 5 V area: Würth WA-SMSI M2 L6 SMT spacers (9774060243R, P1 +5V, P2 GND, below J2) with WA-SBRIE M2 male-female 10 mm brass studs (971100244, 5 mm male thread, ending inside the 6 mm spacer short of the board and the PSU behind it), M2 × 5 screws through the pin board into the studs (heads in recesses in the pocket ceiling), heatshrink over each post. Gone: the NA sensor flex, the 5 V jumper, the NA floor insert, the island notch, the face plate's tab, strip, grooves and ramps, the NA tape points. The barrier now prints plug-down on supports from the plate under the flat back, skirt and pockets (+19 g). | Human decisions 2026-10-09/10: the taped, laid-in flexes were "horrible" and flimsy; one sturdy board under the barrier, the face plate on and off without cables; the pin holes are approved barrier openings (2026-10-10, hard constraint 2). No single spring pin spans the 26 mm from the mains board to the pads, and the PSU fills the board behind the 5 V area, hence the pin board on posts; the posts carry the 5 V themselves (human suggestion). No top-port I²S microphone is in production and ESPHome has no PDM input on the ESP32-C3, hence the carrier. Open: the CN2 part and map (sensor board fab withheld), the carrier's castellations and window on a sample, the pins' feel through the windows, the Mill-Max 0919 pad (.082", from the 837 / 839 strips that use the same pin). |
| D-51 | **Partly superseded (D-64, D-66: plate 14.4 mm, skin 0.3 mm clear of the MSR-2).** **Thin radar skin; MSR-2 straight on CN2.** The face skin over the MSR-2 bay is 0.6 mm (three 0.2 mm layers, was 1.2) and the MSR-2 rests on it, plugged on CN2 on the sensor board: plate 13.7 mm (sensor board 1.6 + CN2 stack 1.5 + MSR-2 10.0 + skin 0.6). The remote's seat, the barrier's interior, the spring pins' compression and the mains board stay where they were; the remote stands 2.6 mm proud of the face (was 2.0). Fallback if CN2 has no board-mount mate (only a flex with its own plug): the bare MSR-2 on two clip towers from the barrier's flat back (1.2 mm towers, 0.4 mm lips over its front ends, ledges under its back), front 0.6 mm under the skin, a small flex from CN2 to a 10-way FH12 on the sensor board under it; plate 15.1 mm. | Human request 2026-10-10: thinner skin for better radar readings, the MSR-2 close to the skin, no extra PCB; straight on CN2 when the boards are this close. Open: the CN2 mate (board-mount or flex only), MSR[2], B2B_STACK and the board's edge clearances, all to measure on an MSR-2 (none on hand yet). |
| D-52 | **Partly superseded (D-81: the marker gauge removed).** **Microphone paths; steel plate cutting jigs.** Prior art (InvenSense AN-1003, ST AN4427) and a lossy-tube model: at voice frequencies (wavelengths 43 mm to 1.1 m) a funnel or horn a few millimetres across adds no pressure; what matters is a short, sealed, unobstructed path, or a deliberate resonance. EU (mic under the face skin): the sound hole is Ø1.6 through a 0.6 mm web, with a Ø3.0 recess from the face over it, gasket ID Ø1.6 (model: flat within 0.1 dB to 3.4 kHz, 0.6 dB at 8 kHz; was Ø1.0 through 2.0 mm, +0.3 / +1.7 dB). NA keeps its sound tube as it is (Ø1.0, 11 mm; a quarter-wave resonance near 6 kHz, +3.8 dB at 3.4 kHz in the model; human decision 2026-10-10). The supplied part the remote's magnet holds is a steel plate (human 2026-10-10); two printed jigs (PETG) cut its 18.5 mm piece: a hacksaw guide (walls 8 mm above the plate, 1.2 mm slot at the cut, 0.6 mm into the floor; clamp in a vise) and a marker gauge (a 3 mm fence over the plate at the cut line; mark, then shears, grinder or saw). The whole plate lies in a pocket 0.15 mm larger, round end on the stop. | Human choices 2026-10-10 (E2, NA tube unchanged, both jigs). Horn and tuned-chamber designs avoided: they gain little here, and US 11,432,066 B2 (horn before a MEMS microphone) and US 11,653,143 B2 (Helmholtz resonator, Knowles) are live. Open: the microphone's front volume (the model assumes 1 mm³), the plate's real size and thickness. |
| D-53 | **Partly superseded (D-60: pin board 14 × 10, posts level; D-79: pads 4.7 mm up, pin board 14 × 12).** **Pin board between its posts (B2); back cover pads lower.** The spring pins move to (13.2, −13.6) +5V and (13.2, −18.2) GND, between the two spacer posts at (9.85, −15.9) and (16.65, −16.5): one pin either side of the line through the posts, so the pins' push hardly levers the pin board (it was cantilevered 23.5 mm past the posts). The pin board shrinks to 12.6 × 8.6 mm; its post pads are Ø3.8 under the M2 heads. On the mains board J2 moves to (13.5, −24.8), turned 90° so the FFC leaves to the right, up past the posts at x 21.3 and back to its old run; the service loop shortens to 32 mm so the route (141 mm + 4 mm into each connector) fits the 152 mm stock FFC. P2 sits 0.6 mm below P1 to clear the PSU's unconnected pin 5. The back cover's pads follow the pins; the flex's regulator section moves above the pad section (regulator +3.8 mm, section 6.6 mm), the pad section ends just above the terminal bend, the strip widens to x 10.7 so +3V3 passes inside both pads and GND runs up the outer edge. Same positions on EU (both over its pin board, below the rocker cup); until the EU sensor board is built the EU floor pads stay on the earlier finger positions (params_eu). | Human review 2026-10-10: the B pin board had "way too much leverage on the pcb and the posts"; pins may move within the 5 V area to keep NA and EU compatible. Conductive posts must stand in the mains board's 5 V area (x 7–19.5, y −33.5 to −13), the cover's pads above its terminal bend (y −20.25). |
| D-54 | **Partly superseded (D-59: Harwin P70 pins at 6.8 mm; D-56: no EU sensor flex; D-79: pin positions).** **EU battery-free remote on spring pins through the barrier; floor insert and tongue removed.** Two Mill-Max 0919-0-15-20-89-14-11-0 SMT pins (P3 +5V, P4 GND) on the EU pin board's front at the NA pin positions (13.2, −13.6) / (13.2, −18.2) reach through two pin-filled holes in the barrier (barrel Ø1.50 in its hole) onto the shared back cover's pads; the remote sits straight on the barrier (seat z 1.6, was 2.2 on the 0.6 mm floor insert). Compressed 1.03 of 3.0 mm, barrels 0.03 mm above the barrier inside the cover's windows, 3.1 mm proud with the remote out. P3 takes +5V from the socket's lane, which now runs past it to C1; P4 returns GND to the socket on the front layer. The rocker and mains board drop 0.6 mm with the seat; the P70 pins' design working height goes from 6.8 to 6.9 mm (inside 6.4–7.2 with ±0.3) so the header keeps 2.58 mm in the socket. Gone: the EU floor insert, the sensor flex's tongue and its floor pads (TP3 / TP4), the face plate's tongue notch, the floor print job. | Human review 2026-10-10: the EU plate still had a floor plate with flex contacts beside the pin holes. The EU sensor flex itself stays until the EU sensor board replaces it (microphone placement open). Low compression margin: check the pins' contact force on a printed barrier. |
| D-55 | **Back cover: end section slides into slots inside the contact blocks; terminal end inside the cells' room.** The two snap hooks on the blocks' outer sides (posts at \|x\| 15.6–16.6 mm, up to 9.0 mm above the back face) are removed. Each block's outer face carries a slot inside the block's outline: a 0.8 mm side wall and a 0.8 mm lip 0.1 mm in front of the copper, reaching 0.5 mm over the section's outer edge, from the ledge to the block's top (trimmed to the cell's room above the axis). The end section narrows by 0.9 mm each side (outer edges at \|x\| 14.63, finger pads 1.62 mm inside them) and slides straight down the two slots into the slot behind the foot lips before the strip is laid on the ledge; held at the foot and along both outer edges, the rigid stiffener keeps the inner edges in place (the band joins them below the PCB strip, so no slot can guide them). At the terminal end the blocks, end section and stiffener stay inside r 5.0 round each cell axis outboard of the cells above the axes (before: only above the rim); `make check` tests that and the slide-in path. Same print: the bottom snap clip moves 0.2 mm towards the rim (top 4.9 above the inside floor) and its hook 0.1 mm deeper (0.8, clip face unchanged at 2.9 mm in from the rim). | Test print 2026-10-10: both outer hooks hit the inside of the remote's battery holder shell, which wraps the cells outboard of them (the model has no holder shell); human: side retention is needed, inside the blocks' footprint, "make it a slot where we slide the pcb in". Open: the holder's inner side wall position and how far down it reaches (MEASURE); the slots' fit on a print (0.1 mm round the 0.52 mm flex + stiffener). |
| D-56 | **Partly superseded (D-70: no adapter board, socket or bracket; the MSR-2 straight on a 1.6 mm sensor board).** **EU: no flex; sensor board + adapter board (concept).** The EU sensor flex (D-42) is rejected. It is replaced by a 1.6 mm FR4 sensor board on the barrier (the P70 spring pins from the pin board press on pads on its underside, the SHT45 on it) and a 0.8 mm adapter board carrying the MSR-2's CN2 mate and the microphone on a carrier in a window, joined to the sensor board by a 2×3 2.54 mm SMT socket and header (Samtec SSM / TSM, 5.5 mm stack within the listed 3.81–6.22 mm; part numbers from Samtec's drawings before params), a printed bracket holding the MSR-2 0.6 mm under the radar skin, a 9.3 mm printed tube from the mic to a sound hole beside the MSR-2. Until built, the EU renders and the EU sensor flex KiCad project show the superseded flex. | Human 2026-10-10: "A flex cable is out of the question for the EU board"; adapter board with the mic on it, from the rendered concept. Open: the P70 working height against the battery-free pins' compression once the pads sit on the sensor board's underside; the CN2 part and map (no MSR-2 yet). |
| D-57 | **Partly superseded (D-134: MH3 back at (21, 33.5), its stud full length).** **NA mains board on nylon standoffs (replaces the printed snap posts, D-28).** Four Keystone 25503 nylon 6/6 M3 male-female hex standoffs (15 mm body, 5.0 mm hex, 8 mm stud, 8 mm internal thread; UL94 V-2; catalog M65 p.76) screw into M3 tapped blind holes (2.5 mm tap drill, 8.5 mm deep) in the barrier's bosses, whose faces move to z −11.2 (the board front plus 15 mm, 0.3 above the barrier's lowest point). At the top right (MH3) the pocket corner leaves 1.6 mm wall round a 5.5 mm hole only: that standoff's stud is cut to 5 mm (1.67 × M3 engaged in the printed thread). Nylon M3 × 8 slotted pan head screws (ISO 1580) go through the board from the back, 6.4 mm into the standoff. Board holes 2.6 → 3.2 mm, copper keep-out r 2.75 → 3.39 mm (hex corners 2.89, head 2.8, + 0.5); at MH2 / MH4 the heads reach into PS1's courtyard margin (1.95 mm round its body) but stay 1.35 mm clear of the body: a DRC rule allows that pair, `make check` tests the heads against the board STEP. The printed posts, their print job and the M4 tap / die are gone. | Human 2026-10-10: the printed posts "don't work"; option A (screwed nylon standoffs) of the two proposed, the other being the Keystone 8850 snap support. |
| D-58 | **Superseded by D-68.** **NA MSR-2 held on a ledge; the flat back keeps its top edge.** The barrier's opening over the MSR-2 was sized for the 40 × 24 mm parts envelope and cut past the flat back's top edge (−0.25 mm web: no skirt over 41 mm), and the board hung on CN2 alone. Now a pocket for the bare board (38 × 21.5 mm + 0.25 mm round it) ends on a 1 mm ledge under the board's edges, 0.1 mm below its back so CN2 seats first; CN2 and the board's back parts go through the smaller opening below. The board is held by the ledge underneath and the radar skin on its front. Webs to the top edge: 1.25 mm above the ledge, 2.5 mm below it with the skirt. The MSR-2 model is the bare board (thickness MSR_BOARD_T, MEASURE) with the parts' envelope above it. | Test print 2026-10-10: "not enough material in the skirt at the edge of the mmWave sensor area, it's too flimsy", "how is the mmwave board supposed to be supported?". Open: the board's back must be free of parts for 1 mm along its edges (MSR_LEDGE, MEASURE, no MSR-2 in hand). |
| D-59 | **Partly superseded (D-64, D-67, D-70: sensor board 1.6 mm, no adapter or towers; D-71: carrier pinned by the barrier; D-79: battery-free pin positions).** **All spring pins Harwin P70-2200045 (locating peg); EU sensor board and adapter built.** The Mill-Max 0919 battery-free pins have no peg; Harwin's P70 table has no pegged pin above 7.2 mm working height, so each pin's board moves closer instead. NA: the pin board's spacers become Würth WA-SMSI 9774070243R (7 mm, same land as the 6 mm), the pin board rises 1.0 mm, the pins work at 6.7 mm (6.4–7.0 with ±0.3; range 6.4–7.2); the pocket floor keeps 1.9 mm under the magnet recess and 3.5 mm over the pins' flange recesses; the barrels stand 1.5 mm above the floor in the cover's 2.0 mm windows (0.2 mm under the pads at the shortest working height); pegs 1.3 mm below the pin board. EU: all four pins on the pin board at 6.8 mm (6.5–7.1): the sensor board's underside (pads) is level with the back cover's pads (z 3.6), the pin board's front at z −3.2; the mains header becomes Samtec TSM-102-02-L-SV (8.13 mm post, 3.07 mm into the socket); the sensor pins move to (26.4, −4.8) / (26.4, −7.6) (box edge, dome notch and pocket), the pin board's hole MH2 to (16.8, −20.6) (the pins' Ø2.0 flange). D-56 is built: a 1.0 mm FR4 sensor board on a printed carrier (2.0 mm over the barrier, 3.6 mm beyond it, located by a recess round the barrier disc, two M2 screws), SHT45 on it, a 2 × 3 socket; a 0.8 mm adapter (CN2 mate, header underneath, the NA mic carrier in a window) at a 4.1 mm stack; two printed towers hold the MSR-2's long edges on 1 mm ledges; the face plate's bay frames stop 0.5 mm above the sensor board, the MSR-2 frame has a slot for the adapter, a 9.3 mm sound tube from the skin to the carrier's gasket. KiCad: eu_sensor_board and eu_adapter replace eu_sensor_flex (ERC / DRC clean, no fab files yet). | Human 2026-10-10: "find a pogo pin with a peg at the right height", "yes, do both". Open: the Samtec SSM / TSM parts and stack, the CN2 part and map, the carrier's weight (17.9 cm³ solid, to lighten). |
| D-60 | **Partly superseded (D-79: pin board 14 × 12, pins above and between the posts).** **NA pin board: larger, posts level.** The pin board grows from 12.6 × 8.6 to 14 × 10 mm (centre (13.25, −15.9)); the two spacer posts sit on one line at y −16.5, x 9.85 and 16.65 (before: P1 at y −15.9, P2 at −16.5), the pins either side of it at the back cover's pads (13.2, −13.6) / (13.2, −18.2). The posts' spacing stays 6.8 mm: their footprints plus margin fill the mains board's 5 V area in x (7–19.5), and P2 keeps more than 4.2 mm to the PSU's unconnected pin 5. The mains board's +5V track ends 0.6 mm lower on P1's ring. | Human 2026-10-10: "increase the size of the pcb holding the pogo pins for the remote, just space things out a bit and make the posts line up". |
| D-61 | **Partly superseded (D-83: a sound column with a boot over the mic replaces the tube).** **Sound path 1.6 mm.** The NA face-plate sound hole and the sound tube's bore (NA and EU) go from 1.0 to 1.6 mm (the EU face hole already 1.6); the tube keeps its 3.2 mm OD (0.8 mm wall, two lines). `make check` and the EU checks keep every printed sound path at 1.5 mm or more (MIN_PRINT_HOLE). The gasket under the tube's foot becomes ID 1.6. | Test print 2026-10-10: "the sound guide hole is too small, it's fully plugged". A wider bore also loses less sound in the tube (D-52). |
| D-62 | **Superseded by D-74.** **NA 5 V pass-through as a tunnel in solid barrier; no loop in the box.** The pass-through sat in the barrier's 45° corner taper: below z −6 there was no barrier round it and up to the wall plane only 30–79 % of a 1.6 mm wall, so the FFC climbed in the open beside the plug's corner, about 4 mm from the box's metal wall, where the box rim and corner pass during insertion; a 32 mm Z-fold service loop hung loose in the mains-side gap. Now the pass-through is a Ø4.5 tunnel: up from its mouth on the barrier's underside at (15.6, 26.6) (7.5 mm in from the box wall), across at z −7.6 (1.65 mm under the pocket floor), up at (19.5, 31.5) (1.98 mm from the pocket's wall) past the wall plane, then the 45° leg and the flat slot as before; it passes the top-right standoff boss's side 1.86 mm from its tapped hole (cut after the bosses). The FFC runs from J2 out to the right, up past the spacer posts, straight to the mouth (taut, inside the board outline), 140 mm along the route. The stock 152 mm Würth cable's spare (46 mm) lies folded flat in four layers in a pocket under the flat back beside J1 (y 40.25–44.75, over the sensor board, clear of the #6 screw boss); the 100 mm stock length is 4 mm short. J2 is latched from the side with the board on its standoffs. The overhang check's fallback normal now averages the surface normals at a triangle's corners. | Human 2026-10-10: the routing "seems odd", the cable "is vulnerable to damage from the metal wall socket when the insert is being put in place"; option A (the tunnel), the stock cable for now. Open: a custom-length FFC if the fold's volume is needed; the fold and the tunnel's bends on a print. |
| D-63 | **F1 stays a one-time fuse (D-19); no PTC or e-fuse.** The IRM-03-5's output is short-circuit and overload protected with auto-recovery, so a fault on the 5 V side does not open F1; F1 opens only on an internal PSU failure, which needs the PSU replaced (box opened) anyway. A resettable primary device would re-energise a failed PSU in a closed box; e-fuses are DC parts. F1's rating stays open for human review (D-19). | Human 2026-10-10: "keep the fuse". |
| D-64 | **Partly superseded (D-66: NA plate 14.4 mm; D-67, D-70: EU sensor board thickness).** **MSR-2 modelled part by part, CO2 version.** Apollo publishes no board model (its repository has firmware and datasheets; its "3D files" are the case on Printables). `msr2.py` builds the MSR-2 with the SCD40 add-on from the module datasheets (ESP32-C3-MINI-1 13.2 × 16.6 × 2.4, LD2410B 7 × 35, SCD4x 10.1 × 10.1 × 6.5), Apollo's case (cavity 38.08 × 21.67, face 10.41 above the board plane, USB-C opening, button holes) and Apollo's wiki photos for the positions (ESTIMATE): USB-C at the −x end, the ESP's antenna over a board notch at the −y edge, the radar along the +y edge on a 5-pin header, CN1 at the +x / −y corner with the add-on and the SCD4x on it (front 10.4, the case's face 10.41), Boot / RST side-push switches on the back at the +y edge, two small plated holes on CN2's axis (Ø0.9, ± 4.7, ESTIMATE; too small and too close to one end to mount the board by). The model replaces the box envelope on both variants; MSR[2] is its front, 10.4 (was 10.0): the NA plate is 14.1 mm (was 13.7). The back switches (2.0 deep, ESTIMATE) stand 0.5 mm past the CN2 stack: two notches in the sensor board's top edge (0.5 mm corner radius; two GND stitching vias moved beside them) and reliefs in the barrier's MSR-2 ledge; `make check` tests the MSR-2 against the sensor board. EU: the plate face is fixed by the box, so the MSR-2 sits 0.4 mm lower; the sensor board goes to 0.8 mm FR4 (was 1.0) to keep the socket + header stack in Samtec's range (3.90 mm). | Human 2026-10-10: "find a model or model the msr-2 properly with the addons stacked (co2 version)". Open: caliper readings for every ESTIMATE; the switch depth decides the notches. |
| D-65 | **Partly superseded (D-69: one grille, the light sensor under the middle slot, no light-sensor hole).** **Vents over the CO2 sensor (NA and EU face plates).** The SCD4x sits at the MSR-2's bottom-right corner, under the radar skin and the far side from the bay's top-edge vents. Three 2.0 mm slots (pitch 3.5, along y) go through the 0.6 mm skin over it, inside its 10.1 × 10.1 outline (1.0 mm in from its edges): 45 mm² open, 4.35 mm clear of the radar module's outline; the slot that meets the light-sensor hole stops 0.8 mm short of it. The skin rests on the sensor's cap (both at the stack's front). `msr2.scd_vents()` cuts both face plates; `make check` and the EU checks test that each slot is open, over the sensor, off the radar and clear of the light-sensor hole. | Human 2026-10-10: "add vents over the SCD40 for the CO2 sensor". Open: the sensor's response through the slots on a built plate; the light-sensor hole moves when LUX_POS is measured. |
| D-66 | **NA: the face plate clamps the MSR-2's board, not its add-ons.** With the part model (D-64) the skin rested only on the SCD4x's cap and the radar's header pin tips (both at the stack's front, 10.4), so the clamp went through the CO2 add-on's CN1 and the radar's header. Now three Ø1.8 posts on the face plate (9.1 long) press the MSR-2's board onto the barrier's ledge at part-free spots on its front (board frame (−9.8, −5.0) between USB-C and the ESP32, (6.35, −5.0) between the ESP32 and the add-on, (−17.5, 1.5) at the USB end; ESTIMATE from the photos), and the skin stands 0.3 mm clear of the MSR-2's front: the NA plate is 14.4 mm (was 14.1). `make check` tests each post on solid board inside the outline, 0.05 mm clear of every part, ending on the board's front, and the skin's gap to the SCD4x and the radar. EU: D-67. | Human 2026-10-10: "yes, build it into the NA model" (after the concept render). Open: the post feet against the real board (small parts near them, the ESP32 / add-on gap is 0.15 mm a side). |
| D-67 | **Partly superseded (D-70: no adapter, 1.6 mm sensor board, skin 1.3 mm over the MSR-2).** **EU: the same clamp; thinner sensor board and adapter.** The EU face plate gets the NA posts (`msr2.posts()`, same spots on the MSR-2's board) and the skin stands 0.3 mm clear of the MSR-2's front. The EU face is fixed by the box, so the MSR-2 sits 0.3 mm lower; the sensor board and the adapter go to 0.6 mm FR4 (both were 0.8; a standard PCBWay thickness) and the socket + header stack is 4.00 mm, inside Samtec's 3.81..6.22. The posts and their checks are shared: each post is part of the face plate (this caught the bay's hollow cutting the NA posts away: both face plates now add them after that cut), on solid board, clear of every part, the skin 0.3 mm clear of the SCD4x and the radar. | Human 2026-10-10: "work out the EU clamp". Open: as D-66. |
| D-68 | **NA sensor board straight on the barrier; no flat back.** The barrier's flat back over the sensor board (2.8 mm, with its skirt, pockets for J1, the passives, the FFC fold and the MSR-2's ledge, five M2 screws into SMT nuts) printed on supports and is gone, with the solid block under the flange's sides: the barrier is 55.6 cm³ (was 63.5). The flange's underside is a flat 1.8 mm land over the board's inner edge, then a 45° taper out to the flange's outline; the FFC channel out of the tunnel has a peaked 45° roof. Supports remain only under the seal lip on the wall plane and in the pin board pocket. Fixing: the copper keep-out (8 mm along the wall from the box opening) covers every place the flange overlaps the board, so no SMT nut or spacer can sit there, and hooks cannot catch the board's back (it lies on the wall); the board presses onto eight crush ribs on the collar's outside (1.0 wide, 0.15 mm into its window edge, 45° lead-in at the wall end) for handling, and in the box the land clamps its inner edge, the face plate's posts and frames the rest (frames end 0.25 mm over the board's tallest part). The MSR-2 rests on CN2 and three Würth WA-SMSI 9774015243R spacers (1.5 mm, the CN2 stack; the part the five nuts were) on the sensor board under the face plate's posts, which move 1.1 mm to y −3.9 (EU posts follow; EU otherwise unchanged). The FFC's spare fold moves to y 43.4, between the flange and J1. `make check`: no barrier over the board beyond the flange, the ribs' bite, the land on the board, the spacers under the posts on solid board, clear of the MSR-2's back parts; a crush rib coupon (0.10 / 0.15 / 0.20). | Human 2026-10-10: "investigate mounting the circle pcb directly onto the insert ... get rid of all the extra plastic and simplify printing/manufacturing", then "yes, build it into the NA model". Open: the rib interference on the coupon; the MSR-2's back under the spacers and the CN2 stack (MEASURE); the FFC fold is held only by the face plate above it. |
| D-69 | **One grille for the CO2 and light sensors; no light-sensor hole (NA and EU).** The Ø3 light-sensor hole at LUX_POS cut into the CO2 vents (D-65). The hole is gone; the grille's middle slot is centred on the light sensor (LUX_POS, x and y), the other two beside it at 3.5 mm pitch. The slots keep 1.0 mm off the radar module (VENT_RADAR_CLR): with the placeholder LUX_POS (12, 0) they are 5.5 mm long (the SCD4x allows 8.1), 33 mm² open, 17.8 mm² of it over the SCD4x (was 45). The grille follows LUX_POS when it is measured; Apollo's backplate window and a part on the board's back at (16.7, −8.5) suggest the LTR-390 may face backwards, under the CO2 add-on. `make check` and the EU checks: middle slot centred on the light sensor, >= 15 mm² over the SCD4x, off the radar. | Human 2026-10-11: "remove the hole and line up the grill so the light sensor is in the middle of the middle slit". Open: LUX_POS and the sensor's face (MEASURE). |
| D-70 | **Partly superseded (D-71: carrier bored round the barrier and pinned by it, no cone; D-77: snaps into closed windows in the carrier; D-78: plate 84.6 mm wide).** **EU: the MSR-2 straight on the sensor board, the remote proud as on NA, a snap-on face plate.** The face plate is 19.0 mm (was 21.6): the remote stands 2.6 mm proud, as the NA one. That only fits without the adapter: the adapter board, its 2 × 3 socket / header and the MSR-2 bracket are gone; the sensor board is 1.6 mm FR4 (was 0.6) with the MSR-2 on its CN2 mate and three Würth WA-SMSI 9774015243R spacers under the face plate's posts and the mic carrier over a window, as on the NA sensor board (skin 1.3 mm over the MSR-2; notches in its top edge for the MSR-2's back switches; four M2 × 6 screws into the carrier). The printed carrier is beefed up with a 1.6 mm rim round the board; over the barrier disc its underside is a 45° cone from the disc's edge (open inside r 35.8), so it prints bottom down without supports. The face plate's screws, tabs and the barrier's screw bosses are gone: four snap fingers (2.4 × 6 mm, 16.8 mm long, from the face skin) at the corners, outside the pocket walls, drop into flat notches in the barrier disc's edge (0.6 deep; they locate the plate and stop it turning; the top right one 8 mm wide keys it) and a 45° bump on each catches a 0.6 mm groove in the notch face (0.4 mm engaged, 0.7 % bend), 1.15 mm outside the seal band. Snaps under the barrier floor (closed bosses inside the box) did not fit between the pocket walls and the Ø60 box. The sensor board's lanes run outside the snap windows and screws; ERC / DRC clean. Checks: the remote's protrusion, the skin gap, the spacers, the snaps (part of the face plate, keyed, bump in the groove, strain, clear of the barrier, carrier and board, barrier band), the carrier's printability. | Human 2026-10-11: "The snaps need to be more beefy and there need to be at least 4 of them ... corners ... the circular plate should have the snaps and should include a socket ... can't be rotated. The depth of the faceplate should be reduced ... get rid of the extra backplate ... bare PCB mounted into the ring plate ... beefed up"; "the printed carrier, build it into the EU model". Open: the snaps' hold on a PETG test fit; the 1.6 mm board spans the open centre over the barrier (only the sensor pins push it there). |
| D-71 | **Partly superseded (D-77: no snap notches in the barrier, the teeth stay; D-78: carrier whole at the sides).** **EU: the barrier pins the carrier to the wall.** The carrier goes on the wall before the barrier. A 0.8 mm lip on its wall face (from r 35.95) reaches 1.65 mm under the barrier's edge into a 0.8 mm rebate in the barrier's underside, which starts 0.5 mm outside the seal band (r 35.75; the barrier stays 1.6 mm over the seal band and 0.8 mm over the lip); the barrier's two dome screws pin the lip to the wall, line-to-line. Round each snap notch the barrier keeps a full-thickness tooth (notch + 1.5 mm each side) that sits in a gap in the lip (0.2 mm each side, ≤ 0.32° turn); the key tooth is 11.3 mm against 9.7 mm gaps elsewhere, so the carrier fits one way only. The 45° cone over the barrier's edge is gone: the carrier is bored 0.2 mm round the barrier disc from the lip up, so the barrier goes in from the front; the rim stops where the bore cuts through the carrier's sides (x ±37.35 < r 37.8), and the two halves are joined there by the lip only (1.4 × 0.8 mm). The face plate no longer holds the carrier. Checks: rebate outside the seal band, barrier over the lip, lip on the wall against the rebate, carrier clear of the barrier disc above the lip, the teeth and keying. | Human 2026-10-11: "the carrier plate is simply locked in place by the cap plate ... pinned against the wall and all we'll need are some guides to make sure it doesn't twist/turn". Open: the clamp on a PETG print (line-to-line; crush ribs on the lip if it rattles); the lip's side links when handling the carrier. |
| D-72 | **EU: the steel piece in a recess in the pocket floor.** The cut steel piece (D-43) was glued under the barrier, inside the box, with nothing to locate it. It moves to a recess in the barrier's pocket floor as on NA: the NA outline (round end down, 0.3 mm clearance), its face 0.5 mm below the seat (`MAGNET_SETBACK`), centred at y −9.65 (1.6 mm from the switch cup; 82 % under the back cover's magnet). A cup under the recess keeps 1.6 mm of barrier under and round it, its underside at z −2.5, 0.7 mm over the pin board's front. The gap to the cover's magnet drops from 3.2 to 2.1 mm. The barrier prints face down, so the recess floor is an 18.1 mm bridge (the overhang check accepts bridges up to 20 mm at that level). Checks: the cup in the box, the wall to the switch cup, the setback and the floor, the cup over the pin board, the bridge. | Human 2026-10-11: "we're missing the place for the steel plate in the eu version for the magnet in the remote to latch on". Open: the bridge's sag under the piece on the PC-FR print; the pull test (MEASUREMENTS). |
| D-73 | **EU: finger scoops both sides, NA style.** The single 45° rectangular finger notch left of the pocket is replaced by two rounded scoops, one each side, centred 0.6 mm outside the pocket as on NA. Each follows the NA ellipsoid, wider (radii 7.5 × 16 × 9, NA 6 × 16 × 9; centre 2.5 mm above the face): 14.4 × 30.7 mm at the face (NA 11.5 × 30.7). The face plate prints face down, so where a wall of the ellipsoid gets flatter than 45° it carries on at 45° to a 2.0 × 15.3 mm flat bottom, 8.2 mm deep (NA 6.5, which would leave an unsupported ~8 mm wide dome in a face-down print). A 1.6 mm solid wall round each, 3.2 mm over the sensor board's parts. Checks: open at the face, through the pocket wall, the wall over the sensor board, the face plate's overhangs. | Human 2026-10-11: "the cutout to lift the remote out for the eu version should be replaced with NA style rounded cutouts on both sides, they can be a bit wider though". Open: the grip on a test print. |
| D-74 | **Superseded by D-134 (slit in the bottom wall).** **NA 5 V pass-through: one straight bore.** The D-62 tunnel (up 3.9, across 6.3 under the pocket floor, up 7.2, 45° for 2.8, then the slot: 90°, 90°, 45° and 45° bends in 20 mm, the cable twisting at each) could not be threaded, and it was not enclosed: its second bend broke through the barrier's 45° corner taper (z −9.2 to −4.9). It is replaced by one Ø4.5 bore, 13.4 mm, 77° from horizontal along the corner (45° in plan), from the underside to the same flat slot at (20.9, 32.9, 2.3); its run in plan (3.0 mm) is the most that keeps 1.6 mm to the remote pocket (2.61 mm). In this corner only the taper is left between the pocket wall and the box outline, so the bore's lower part is an open groove in the taper; it is closed from z −4.4. Its axis meets the underside plane at (18.8, 30.8), 6.6 mm from the box wall; 2.91 mm from MH3's tapped hole. The FFC is pushed up from the underside round one bend into the slot. The mouth moved behind the top-right standoff, so the free span passes a waypoint at (15.5, 24.8, −14) between the rocker and that standoff; the route stays 140 mm, the fold grows to 12.0 mm. Checks: the bore's walls, the groove's top, the mouth, threading through one bend. | Human 2026-10-11, after the renders of the current and straight routes and the full cable path: "looks good to me, update the tunnel". Open: pushing the stock FFC through on a print. |
| D-75 | **Back cover: 0.1 mm more room inside.** The printed cover could not snap onto the remote. Its side wall goes from 1.6 to 1.5 mm on the inside (`BC_SIDE_WALL`): 0.1 mm more room all round; the outside and the 1.6 mm back stay. | Test print 2026-10-11: "the remote back cover is slightly too small, it can't snap onto the remote". Open: the fit on the next print. |
| D-76 | **EU test socket.** A printed stand-in for the flush box (`eu/testbox_eu.py`, `print/eu_testbox_PLA.3mf`) to try the EU stack before a real wall: the box Ø60 inside / Ø68 outside (`BOX_DIA`, `BOX_HOLE`), 65 mm inside depth, 2 mm floor; the four device screw domes (Ø7, 60 mm pitch, `DOMES`) with Ø2.7 × 20 mm pilots for the barrier's screws; 0.5 mm V-grooves inside and outside at 40, 43, 60 and 63 mm below the wall plane; a 10 mm inspection window at −45° (45° gable top) and a fin beside it with a tick and the depth engraved at each marker. A 3 mm wall plate, 10 mm beyond the face plate's outline, sits on a 45° shoulder on the box so the box's rim is flush with its face; a key at the top sets the orientation. Box floor down, plate flat, no supports. Checks: depth, domes and pilots, markers, the stack inside (deepest part 43.8 mm, 21.2 mm above the floor), the plate's size and fit, overhangs. | Human 2026-10-11: "make a 3d print project of an eu wall socket for testing, 68mm ... with markers for 40mm, 43mm, 60mm and 63mm depths, total inside depth 65mm"; 68 mm is the box's outer diameter, the screws stay 60 mm apart (human answer). |
| D-77 | **EU: the face plate snaps into the carrier; closed windows.** The snap fingers reached notches in the barrier's edge, so their windows opened into the carrier's bore and cut its inner edge at all four corners. The fingers move out 3.0 mm (inner face r 40.15) into closed windows in the sensor board and the carrier: 1.6 mm of carrier (`SNAP_WEB`) stays between each window and the bore over the full height; 0.75 mm room inside each finger to bend in; the bump (now on the finger's outer face) catches a 0.6 mm 45° groove in the carrier window's outer wall (z 0.2–1.4), reaching 0.40 mm into it; the sensor board's windows let the bumps through. The barrier loses its notches and grooves and keeps its teeth, which key the carrier (D-71); the face plate is held by the carrier, which the barrier pins to the wall. The windows stay keyed (8 mm top right, 6 mm elsewhere). Three sensor board screws move from y ±30 to ±36 (2.78 mm from a window). The lip's tooth gaps now cut only the lip. Checks: windows closed towards the bore, bend room, bump in the groove, strain (0.70 %), screws clear of the windows. | Human 2026-10-11: "having the edge cutouts in the eu carrier would severely weaking it"; "go with A" after the renders of the as-built windows, windows cut to the finger (B) and closed windows (A). |
| D-78 | **EU face plate 4.9 mm wider: the carrier whole at the sides.** The carrier's bore round the barrier disc (r 37.8, the barrier goes in from the front after the carrier, D-71) reached past the carrier's side edges (37.35 from the centre), so for \|y\| < 5.8 only the 0.8 mm lip joined its top and bottom halves. The face plate's width now follows the carrier: `PW = 2 × (CAP_R + CARRIER_CAP_CLR + CARRIER_SIDE + SB_EDGE + SKIN)`, 79.7 → 84.6 mm, leaving 2.0 mm of carrier (`CARRIER_SIDE`) outside the bore along both sides, full height. The sensor board and the test socket's wall plate grow with it; the sensor board's KiCad outline and snap windows (D-77) are regenerated (ERC / DRC clean). Check: the carrier's side wall, full height. | Human 2026-10-11: "the curved cutouts ... cut into the edge of the carrier on both sides and weaken it"; "1" (wider face plate) after the renders of a wider plate and flats on the barrier. |
| D-79 | **Back cover: the GND contact post one piece; spring pins 4.7 mm up.** The post that backs the end section and the GND battery contact (x 6.3–15.5, y −19.7 to −15.7) was cut into three pieces: the run's drop-in notch through its middle (x 10.55–13.45, 102 mm³), the reliefs round the GND pad's snap hooks (31 mm³), the pad section and its stiffener under it (26 mm³) and the GND pin's window (5 mm³). The pads move 4.7 mm up to (13.2, −8.9) / (13.2, −13.5), so the pad section, its hooks and the windows clear the post; the regulator, its recess and the regulator section move with them. The run moves to x 7.2–9.8, past the post's inner face and clear of the steel plate's ridge, with a 2 mm jog from the pad section's inner edge (no snap hook on that edge beside the GND pad); its notch runs along the post's inner face, so the post stays one piece from x 9.95 (208 mm³) and the end section's stiffener spans 2.1 mm of the GND finger's pad over the notch. The pin board's spacer posts stay in the mains board's 5 V area (y −16.5); the pin board grows to 14 × 12 mm (centre (13.25, −13.4)) with the pins above and between the posts. The NA floor holes, the EU pin board's pins and the EU barrier's holes follow the pads. KiCad: cover flex (jog, +3V3 down the pad section's inner edge and across the jog above the GND lane), pin board (label between the pins), EU pin board regenerated; ERC / DRC clean. Checks: the post one piece, the stiffener's span over the notch, the hook count. | Human 2026-10-11: "The pogo pins into the remote cover ... interfere with the battery post and cut it in half, the smaller part is too weak"; "go head and make the change" after the analysis of what cuts the post. |
| D-80 | **Barrier rules cover the EU barrier; one pin-hole size; unsourced values retagged.** AGENTS hard constraint 2 and SAFETY rules 8–9 now name both barriers: NA, the barrier (5 V bore D-74, two pin holes); EU, the barrier (four pin holes D-54/D-59, two device-screw holes, each filled by its pin or screw); the rocker cutout closed by the rocker body on both. The removed island notch and tongue groove (D-41, D-49) are dropped from the rule. All four EU barrier pin holes (and the carrier's) are Ø1.94, the barrel plus PIN_RADIAL each side as on NA (the sensor pins' were Ø1.9); `make eu` checks the count and size. `V0_RATED_T` and the EU pin `SOCKET` were tagged DATASHEET without a cited source; both are MEASURE placeholders now. | Human 2026-10-11: "apply 1, 3 restore, 4 and 5" after the review. |
| D-81 | **Steel plate: the hacksaw guide only.** The marker gauge (a fence to mark the cut line for shears or a grinder, D-52) is removed; the hacksaw guide stays (`plate_jig.py`, `print/plate_jig_PLA.3mf`). | Human 2026-10-11: "delete the cutting guide that isn't meant for saws". |
| D-82 | **Superseded by D-154.** **CN2: Molex SlimStack, assumed 51338-2474 on the MSR-2.** The MSR-2's CN2 is taken to be a Molex 51338-2474 receptacle (24 contacts, 0.4 mm, 2 rows), the more common of the two receptacles the add-ons' Molex 55909-2474 plug mates (the other, 500913, stacks 1.8 mm). J2 on the sensor board and the EU sensor board becomes the 55909-2474: 24 contacts (was a 30-contact placeholder), 0.4 mm; `B2B_STACK` 1.5 mm is Molex's mated height for 55909 on 51338, so the stack, the MSR-2's height and the 1.5 mm spacers stay. The land pattern beyond pitch and count (row spacing, pads, fitting nails) and the contact map are still placeholders: Molex's drawing could not be downloaded here, and Apollo's pinout is open; `CN2_CONFIRMED` stays false, the two boards stay fit-test prototypes and PCBWay does not fit J2. The placeholder map moved to contacts 13–24; the sensor board's vias follow the pins. ERC / DRC clean. | Human 2026-10-11: "Make a guess on which one they use based on popularity, assume they use the more popular one". Open: confirm on an MSR-2 (or with Apollo), Molex drawing SD-55909 for the land pattern, the contact map. |
| D-83 | **Microphone on the board: Knowles SPK0641HT4H-1 (top port, PDM) + Analog Devices ADAU7002 (PDM to I²S); no mic carrier.** The mic sits on the sensor board's front (NA) and the EU sensor board, port end up, port at `MIC_AT`; the ESP32-C3 has no PDM receiver, so the ADAU7002 (WLCSP-8, 0.4 mm pitch) beside it turns the PDM into I²S on CN2's I²S lines (CONFIG high = I²S, PDM clock = 64 × fs, so ≥ 16 kHz keeps the mic in its 1.0–4.8 MHz performance mode). Land patterns from the datasheets (SPK0641 rev A example land pattern; ADAU7002 rev C ball map, 0.20 mm NSMD lands as KiCad's ADI 0.4 mm WLCSPs, the datasheet gives none). Parts round the port in `MIC_PARTS` (U2, C4 100 nF, R1 SD pull-down, C3 100 nF), shared by both boards (`mic_parts`, `route_mic`); the placeholder CN2 map puts WS before SCK so the lanes reach U2's balls without crossings. The face plate's sound tube becomes a column (`sound_column`, NA and EU): rounded 5.0 × 6.0 mm, from the skin down to a 0.3 mm gasket on the board round the mic, hollow over it (0.2 round, 0.3 over), the Ø1.6 bore from the cavity up over the port; vertical walls only, prints face down without overhangs. A round foot cannot seal on the mic's top: its port is 1.03 mm from the body's end. EU: the mic moves right to x 32.0 (`MIC_SPAN`) so its parts and lanes sit between it and the MSR-2's bay frame. The sensor board takes the EU sensor board's fine vias (0.45 / 0.2 mm); pads 5 and 6 of the mic's GND ring get their own vias (the signal escapes enclose them). Removed: the mic carrier board, its land and window, `MIC_CARRIER`, `MIC_WIN`, `MIC_FLEX_HOLE_D`, its fab and order packs and renders. Both boards ERC / DRC clean; `make check` and the EU checks verify the column (foot on the gasket, cavity clear of the mic, bore over the port and open, no part under the gasket). The ADAU7002 is not a hand part: the two boards need PCBWay assembly in either order option. | Human 2026-10-11: "Investigate options to drop the mic board for both NA and EU versions", then "yes, implement option A"; parts rule: active and stocked at DigiKey or Mouser (SPK0641HT4H-1 active, DigiKey 11,697 / Mouser 19,290; ADAU7002ACBZ-R7 active, Mouser 1,487, DigiKey 0 with stock due; search snapshots 2026-10-11). Open: the face hole is 1.6 nominal against Knowles' 1.0–1.5 (prints smaller, D-61); firmware: which I²S slot carries the mic with SELECT low, on an MSR-2. |
| D-84 | **Parts rule: in production and stocked at DigiKey or Mouser; audit.** Every part must be active (not NRND, last-time-buy or obsolete) and in stock or normally stocked at DigiKey or Mouser. Audit of the order lists: F1's MPN was wrong: 3404.2416.22 is the UMZ 250 (fuse in a clip, 11.3 × 4.2 mm) in Schurter's datasheet, the boards carry the UMT 250 footprint; now 3403.0166.11 (UMT 250 T1A, bag of 100; .24 = reel), same rating. The cover flex's 1 µF CL05A105KP5NNNC was out of stock at both: now CL05A105KO5NNNC (16 V, same 0402 and thickness code). The Harwin P70-2200045 is a surface-mount pin with a peg (Harwin's drawing title); DigiKey's "T/H" refers to the peg. The Marquardt 1802.2504 rocker: Mouser 979-1802.2504, in stock (human, from Mouser 2026-10-11; not at DigiKey; 01802.2504-03 is a separate, non-stocked Mouser listing). Several parts showed 0 at DigiKey with stock at Mouser or due (the posts' 9774070243R and 971100244, the P70 and S7081 pins, FH12, the FFC). | Human 2026-10-11: "We only want to go with components that are listed as normally stocked or in stock at digikey/mouser and still being manufactured"; "audit all parts". Distributor pages could not be read from here: stock figures are search snapshots, to be checked when ordering. Since 2026-10-11 `make stock` (and `make order` with keys) checks the rule against DigiKey's and Mouser's APIs (`pcb/tools/distributors.py`). First live DigiKey check (2026-10-11): 24 of 26 active with stock; the 100 nF 0402 GRM155R71C104KA88D had 0, now GRM155R71C104KA88J (the same capacitor on the larger reel, 7.6 M); the Hirose FH12-6S-0.5SH(55) has 0 at DigiKey (Mouser to confirm); the Marquardt rocker is Mouser-only. |
| D-85 | **Mic decoupling C3: KEMET C1206C104J3GACTU (100 nF C0G, 25 V, 1206) on both boards.** Knowles (SPK0641HT4H-1 rev A): bypass capacitors next to the mic's VDD pin, no Class 2 dielectrics near the mic (piezoelectric). Moving C3 away does not help: it stays on VDD electrically, and the column's gasket already shuts the acoustic path. 100 nF C0G starts at 1206 (KEMET C1003_C0G 2/20/2025; TDK, Kyocera AVX, Murata catalogs: none in 0603 / 0805). Body 3.20 × 1.60 ± 0.20, thickness code EH 1.60 ± 0.20 (1.8 max, as C1: no new height over the sensor board). Upright at (3.5, −2.525) from the port, pin 1 on the +3V3 bus, outside the gasket. Both boards ERC / DRC clean, no GND islands; `make check` and the EU checks pass. | Human 2026-10-11: "can the c3 cap be moved away from the mic", then "Yes" to a stocked C0G part, "digikey has stock from Kemet". |
| D-86 | **Rocker sourcing: push-on and solder tabs count as board terminals.** A rocker with 6.3 × 0.8 (or 4.8 × 0.8) push-on tabs or flat solder tabs can be soldered into plated slots on the mains board (slot ≈ tab + 0.2, e.g. 1.0 × 6.6 for 6.3 × 0.8): no leads, so R10 holds. This widens the choice well beyond PCB-pin parts. Conditions, for the human safety review: the maker's approvals were tested with the termination it lists (push-on receptacles on wire, wire solder, or PCB pins), so a tab soldered into a board is outside that; the board must carry the tab's heat at 15 A; a large tab takes a high-power iron, its heat goes into the contacts and body. Parts checked 2026-10-11 (drawings in `scratch/sources/datasheets/rocker_alts/`, `rocker_bulgin/`): **Marquardt 1802.6123-01** (Mouser 979-1802.6123-01): the 1802.2504's body, cutout (19.4 × 21.9), 7 × 10.2 terminal pattern and ratings (ENEC 12(4) A 250 V~, UL/CSA 15 A 125–250 VAC), solder tabs "2.6x1.6" (cross-section to confirm on a sample) to 16.0 below the panel, body 11.7 deep: the board would sit ≈ 12.5 below the panel (now 16.2) with slots; nearest fallback. Marquardt 1832.9103: right-angle PCB pins, board at right angles to the panel, 30.2 × 22.2 cutout. Marquardt 1552.0102 (27.2 × 12.2 cutout, 26 deep), 1832.0113 (30.2 × 22.2), Bulgin C1350AABB-602AW (6.3 tabs, 27.2 × 22.3, 25.3 deep, ENEC 16(4) A, UL/CSA 20 A 250 VAC), C6050ALBB-1197W (6.3 tabs, 30.0 × 22.1, 30 deep, UL/CSA 20 A 277 VAC): new well, latches and ≈ 9–14 mm more depth. Bulgin C1553PBNAW (lit, neon) and Carling LTGNO500-TB-B-R/125N (lit, 125 V neon, no ENEC): unsuitable. The 1802.2504 stays (PCB pins, Mouser 979-1802.2504 in stock). | Human 2026-10-11: Mouser stock list of rockers, Bulgin C1350AABB-602AW, C1553PBNAW, C6050ALBB-1197W; "can't push tabs be soldered onto pcbs?"; "make a note of the fact that push tabs can be soldered onto boards since this drastically changes the availablity of suitable rocker switches". |
| D-87 | **Back profile gauges: the modelled back (flat, quarter-ellipse round-over, straight sides), round-over in five sizes.** The new back cover must snap onto the remote, so the back's round-over (`B_BACK_RUN` 9.1 × `B_BACK_RISE` 9.0, ESTIMATE, likely within 1 mm) is read from the original cover. `coupons.back_gauges()` / `print/back_gauges_PLA.3mf`: five flat gauges, 2 mm thick, the original cover's inside side to side as modelled (B_W − 2 × BC_WALL = 41.8 wide, floor to the rim B_SEAM_Z − BC_WALL = 8.2, the round-over as in `bilresa.back()`), with run and rise changed by −2 / −1 / 0 / +1 / +2 (engraved R7.1 … R11.1; the 45° point moves ≈ 0.4 mm per step), a line at the rim. No clearance: the matching gauge sits on the floor and touches round the curve. Reading (human 2026-10-11): R8.1 fits best, the gauge had 0.1–0.2 of burr: `B_BACK_RUN` 8.1, `B_BACK_RISE` 8.0 (MEASURED); the gauges now step −0.5 / −0.25 / 0 / +0.25 / +0.5 round it (R7.60 … R8.60, deburr before use) to confirm. | Human 2026-10-11: "round out the radius ... contious radius", then "I spoke incorrectly, the back of the remote should not be a contignious curve. Revert back to the previous profile for the remote and base the gauges on that ... less than 1mm but it needs to be exact for the new back lid to snap into place". |
| D-88 | **Rocker second source: E-Switch RA412C1100 on the NA mains board and the EU mains board.** Search 2026-10-11 (two passes, files in `scratch/sources/datasheets/rocker_search_a/`, `rocker_search_b/`): no part with both approvals has ≥ 1,000 at DigiKey or Mouser. Ranked: **E-Switch RA412C1100** (RA4: DPST off-on, 4.8 × 0.8 tabs, cutout 22.0 × 19.2 (19.4 for a 1.25–2 mm panel), bezel 21.0 × 24.2, tab rows 7.1 apart, poles 10.2, body 12.2 deep, tabs to 18.4, rocker 6.0 above the panel; UL/cUL 16 A 125 VAC, 10 A 250 VAC (E194579); ENEC 10(4) A 250 V~ T125, Intertek SE-ENEC-2600045 to 2030, tab versions only; DigiKey 584, 9 weeks; Mouser 2,497 per a search snippet): the 1802.2504's cutout and terminal grid. Marquardt 1802.1121 / 1802.1123 (the 1802.2504 with 4.8 tabs; Mouser 314 / not at DigiKey or Mouser) and 1802.2112 (pins, not stocked at either). Bulgin H8550VBBBEN551W (DigiKey 11,027; 19.3 × 12.9 cutout, 14 deep; ENEC 2013 10(6) A; UL 15 A at 250 V, none stated at 125 V): new well, human decision. Würth 471016264143 (DigiKey 480; UL rating at 125 V not confirmed). The NA footprint (`Rocker_DPST_Marquardt_1802.2504_E-Switch_RA412C1100`) has plated slots 5.2 × 1.2, pads 6.2 × 2.3, on 10.2 × 7.05 (`SW_PAD`, `SW_SLOT_DY`): the 1802.2504's 0.8 pins (7.0) and the RA4's tabs (7.1) both fit; the RA4 snaps in whichever way round puts its tabs on the slots (no marking). Its tabs reach 0.6 mm through the board at the 16.2 seat. The slots leave the pins free along x, so the panel cutout locates the rocker: it is soldered last, after the board is screwed down (`docs/ASSEMBLY.md`, both fab READMEs). Rocker top 0.3 mm under the remote's back at nominal (1802.2504: 0.5 at max tolerance); RA4 tolerance not stated. EU mains board, the same footprint: the 6.2 mm pads come 0.05 mm from the WAGO blocks' bodies on the back (moving the blocks out hits the box's domes and the PSU); accepted by the human as long as the pads stay off the WAGO pins: `S1_WAGO_BODY_GAP` 0 and `S1_WAGO_PIN_GAP` 3.5 (closest 3.85 mm, S1.1a to J1.1, same net; other nets 5.36), checked by `make eu`; the IN / LOAD labels moved between the slots, the WAGO silk outlines open on the lever side. Open: which of the RA4's three tab rows the DPST version has (sample; both ends would put one over J1), its ENEC 10 A rating vs the 1802.2504's 12 A, D-86's conditions for soldered tabs. | Human 2026-10-11: "now look for suitable alternatives for the switch if push tabs are a valid option, only having a supply of a dozen or so switches is going to be a big bottleneck"; "yes, record it and add the RA412C1100 footprint"; "If the slot pad is 0.05 from the case of the wago that's fine as long as it's not close to any of the pins, go ahead and make the change to the EU version". |
| D-89 | **Superseded by D-154.** **CN2 plug land pattern from Molex's drawing.** J2 (`Molex_SlimStack_55909-2474_2x12_P0.40mm_Vertical`, NA and EU sensor boards) from Molex SD-55909-003 rev J (released 2023-02-23, sheet 2 "P.C.BOARD PATTERN DIMENSION (REFERENCE)"; the series drawing, its table lists 55909-2474, B = 4.4): signal pads 0.22 × 0.9 at 0.4, rows 1.73 apart at the inner edges (centres ±1.315), four fitting nail pads 0.5 × 0.85 centred 0.8 beyond the end pads (±3.0) and 0.63 apart (±0.74); housing 6.8 × 2.13, tails 3.13, 1.14 high, 1.5 mated on 51338. `B2B` (the mated pair's footprint) 7.9 × 3.4 from SD-51338-003 rev K (51338-2474 A = 7.9, 3.4 with tails), was 7.6 × 3.0 from a photo. The drawing numbers no pins: pin 1 and the contact map stay placeholders (`CN2_CONFIRMED` false). The fan-out follows the pads (pad ends from `CN2_PAD`; the EU +5V via 0.4 over the upper row; the I²S SCK lane 2.5 below the mic's port, was 2.6). The pads' mask webs are 0.18 mm, under PCBWay's 0.19 (green): one opening per row (PCBWay's "without solder bridge"). Both boards ERC / DRC clean, no GND islands. | Human 2026-10-11: PCBWay's solder-bridge query on the sensor board prototype; "Since you now know which connector we're using you should be able to use it's real footprint". Drawings in `scratch/sources/datasheets/molex_55909/` (Wayback copies of Molex's series drawings). |
| D-90 | **Back cover: small tabs inside both long side walls, into slots in the housing.** The original cover has four small tabs on the inside of its long side walls, two per side either side of the mid-length rib, that sit in slots in the remote housing's long sides (seen by the blue rub on the gauges, photo `scratch/IMG_5097.jpg`). Measured (human): the slots 18 apart inside, 25 apart outside along y (corrected from 23 / 25; the human gives each slot as about 4 long, the spacings give 3.5), the tab's top 1.0 below the rim, 0.8 high; protrusion 0.25 (the human's 0.5, then halved) (`BC_TAB`). The replacement cover's tabs (`backcover.tabs()`): y 9.15–12.35 either side of mid-length (3.2 long), 0.15 clear of each slot end (`BC_TAB_CLR`), 1.0–1.8 below the rim, a vertical inner face 0.25 in from the side wall's inside face at the tab's mid-height (the wall still curves there: 0.18 out at the tab's foot, 0.30 at its top). `make check`: size and position, clear of the snap clips and the side ribs; no unsupported overhangs (back down). First modelled as slots in the end walls, then in the side walls: corrected by the human the same day. | Human 2026-10-11: "there are very small tabs on the side of the remote housing now visible because of the blue highlight rub"; "23mm inside to inside and 25mm outside to outside they start 1mm from the edge and are 0.8mm in width"; "some clearance is required on 11.5/12.5. Let's go with 0.5mm protrusion, they are on both sides"; "the tabs are on the long sides of the remote, the slots are in the mating piece"; "the tabs are in the cover we're building, the slots are in the mating piece"; "each slot is 4mm wide so they will fit, the correct measurements for the slots they fit in is 25mm outside to outside, 18mm inside to inside, adjust size for appropriate clearance, also cut the protrusion of the tabs by half". |
| D-91 | **NA pin board: snap clips in its pocket.** The pin board (14 × 12 × 0.8 FR4) sits on the two posts at its lower corners; the pins stand above and between them, so the remote's push on the pins bent its free edge back. Two clips in the barrier's pin board pocket (`sensor_board_na.pin_board_clips()`, `PB_CLIPS`, `PB_CLIP`): fingers 3.0 wide, 0.8 thick, hanging from the pocket floor past the pin board's edge, freed by a 0.3 mm relief slot all round from the barrier's underside up to 1.6 mm (`POCKET_WALL`) under the seat; a hook 0.4 under the pin board's back face, its catch 0.1 below it, a 45° ramp underneath. The pin board snaps past them as the mains board goes on. Clips at the top edge (x 13.25, in line with the pins: a three-point hold with the posts) and the right edge (y −11.2, between the pins); none on the left edge, where the steel piece's recess above leaves no 1.6 mm floor over a relief slot. Fingers 4.9 mm free: 2.0 % bending strain at 0.4 mm deflection (PC-FR snap limit to check on a print; PLA test prints are more brittle). `make check`: barrier (mains air) unchanged, 1.6 mm over the steel recess, the pin holes and the remote pocket, hooks under the pin board, clear of the pins, posts, sleeves and screws; barrier overhangs unchanged. | Human 2026-10-11: "make sure there are clips in the pogo stick mini-pcb in the NA version to hold the PCB in as the pogo pins are pressed down". |
| D-92 | **Back cover after the first print: bottom clip wider and deeper, side tabs further out.** The cover snapped on once, then not again. Bottom clip (the battery-contact end, −y): 3.1 → 3.7 wide (`BC_LATCH_W` per end: the housing's slot there is 4.0, less 0.15 each side), hook 0.8 → 1.1 inwards (`BC_LATCH_HOOK`; its tip 4.0 in from the outside rim, the clip's body unchanged, its back 1.7 from the outside). Top clip unchanged (3.1, hook 0.7). Side tabs (D-90): protrusion 0.25 → 0.45 at mid-height (0.38 at the foot, 0.50 at the top). `make check`: clip widths and hook reach, clips clear of the flex, stiffener, contacts and regulator, tabs clear of the clips and ribs, no unsupported overhangs. | Human 2026-10-11: "modify the size of the bottom tab in the remote cover, the one on the end on the side of the battery posts. The slot it goes into is 4mm wide so it can be wider and it can also protrude further out, another 0.3mm should do it. The lid snapped on for the first time but after the first time it doesn't snap again"; "The four tabs on the sides can protrude out 0.2mm more". |
| D-93 | **Superseded (D-96: back to 1.50 mm walls, the narrower inside fit better).** **Back cover: inside 0.1 wider across x.** The long side walls go from 1.50 to 1.45 (`BC_SIDE_WALL_X`); the outside stays 45.0 (flush with the housing), the ends stay 1.50 (`BC_SIDE_WALL`). Inside at the rim 42.10 × 67.00 (was 42.00 × 67.00). `back_shape()` takes a separate inset across x; the side tabs (D-90) stand from the new wall face. | Human 2026-10-11: "The shell needs to be 0.1mm wider on the short axis"; "Inside only" (more room for the housing, outside unchanged). |
| D-94 | **EU: protective earth joined in the box in a WAGO 221-412.** The EU boards carry no PE (D-36): an all-insulating light switch has no PE terminal, the lights' PE stays continuous by joining the supply's and the lights' PE conductors in the box. A WAGO 221-412 (2 conductors, 0.2–4 mm²; DigiKey 2946-221-412-ND, active, 397,434 in stock 2026-10-11) is in the EU order lists (`EXTRA_EU`), BOM and ASSEMBLY (step 5); a third PE conductor (a looped feed) takes a 221-413. Open for review: the steel piece in the barrier's pocket floor is the one metal part a user can touch with the remote out, insulated from mains by the V-0 barrier only (double / reinforced insulation or not); older circuits without PE. Not a compliance statement. | Human 2026-10-11: "The EU board doesn't include any ground, is it not required in the EU?"; "We only need a wago 221-412, one ground in one ground out I believe". |
| D-95 | **22 µF C1: KEMET C1206C226M4PACTU (16 V X5R 1206) on the sensor board, the EU sensor board and the EU pin board.** The Samsung CL31A226KPHNNNE (10 V X5R) is active with 152,280 at DigiKey, but its maker shows a 61-week lead time and no stock (DigiKey: in-stock date unavailable). DigiKey keyword search 2026-10-11, 22 µF 1206 ≤ 1.8 mm, active: KEMET C1206C226M4PACTU (16 V X5R ±20 %, 1.80 max, 67,951, 19 weeks; cut tape 399-12290-1-ND), Murata GCM31CR71A226KE02L (10 V X7R, 79,827, 21 weeks), Taiyo Yuden EMK316BB7226ML-T (16 V X7R, 78,696, 21 weeks); Murata GRM31CR61A226 obsolete, several Taiyo Yuden NFND, the 1.9 mm parts too tall. 16 V keeps more capacitance at 5 V than 10 V. Same 1206 footprint and 1.8 mm height (`SB_SMALL`). | Human 2026-10-11: the DigiKey list's "Estimated in-stock date unavailable" on CL31A226KPHNNNE; "KEMET 16 V X5R". |
| D-96 | **Back cover: D-93 undone; the steel plate, its ridge and clips 0.3 mm deeper.** On the print the old width fitted better than D-93's (inside 42.1); a post holding the plate touched the housing. The long side walls are 1.50 again (inside 42.0 × 67.0, `BC_SIDE_WALL_X` and the separate x inset removed). `BC_STEEL_FLOOR` 1.6 → 1.3: the plate's seat, the ridge round it and the clips' hooks sit 0.3 lower (1.3 mm of wall under the plate). The clip tabs still root 0.4 above the back face (less would leave under one printed layer under their reliefs), so they are 0.3 shorter: 0.65 thick (was 0.8) keeps the snap-in strain at 2.8 % (target ≤ 3 %); the hook still reaches 0.30 over the plate's ends. | Human 2026-10-11: "the old width was better than the new width, it looks like one of the posts for holding the magnet is interfering, can we sink the magnet another 0.3mm deeper and the posts that hold it?" |
| D-97 | **Order lists: one NA plate, one EU plate and a devkit of each; the NA lists order the E-Switch rocker.** `make order` writes `unit_na`, `unit_eu`, `devkit_na`, `devkit_eu` (4 sets of parts per variant, `DEVKIT_SETS`), exact counts, no spares, each with its DigiKey / Mouser file and the `_rest_` files; the PCBWay packs are the devkit (5 PCBs of every design, PCBWay's minimum; 8 cover flexes, used by both variants). The test-plate lists (3 NA + 2 EU with spares) are gone. Rocker: both variants' lists take the E-Switch RA412C1100 (D-88; at DigiKey, a fraction of the Marquardt's price): E-Switch's RA4 datasheet (https://configured-product-images.s3.amazonaws.com/Datasheets/RA4.pdf), rating option C: UL/cUL 16 A 125 VAC and 10 A 250 VAC; Intertek ENEC SE-ENEC-2600045: 250 V AC, 10(4) A, tab versions; against the Marquardt's ENEC 12(4) A. First NA only (the human read it as 125 V only), then both once the datasheet's 250 VAC rating was shown. The Marquardt stays the design's reference part on the same footprint. `make order-push` follows the lists (its DigiKey-only swap is gone). The ADAU7002 goes to the DigiKey list in Mouser orders: Mouser does not restock it once sold out. | Human 2026-10-11: "make sure we have BOM files for 1 unit each EU and NA and then a \"devkit\" which is 5 PCBs and 4 sets of all the parts, given the cost of the rocker switch perhaps we should also switch the default for mouser"; "(north americal only since it's not rated for EU voltages)"; Mouser's notice on the ADAU7002; "If the eswitch is truly rated for 250v then we should default to it everywhere". |
| D-98 | **Cost: SHT40, Murata C0G, GCT FFC.** DigiKey prices (API, 2026-10-11, CAD, quantity 1): a plate's parts 90.04 (NA) / 88.51 (EU). Same footprint and function, cheaper: U1 SHT45-AD1B-R2 (9.76) → **SHT40-AD1B-R2** (3.10; same SHT4x DFN-4 and I²C address 0x44; Sensirion SHT4x datasheet: ±0.2 °C / ±1.8 %RH typical against the SHT45's ±0.1 / ±1.0, enough for room climate); C3 KEMET C1206C104J3GACTU (3.52) → **Murata GRM3195C1H104JA05D** (0.58; 100 nF C0G 50 V ±5 % 1206, 0.95 max, so lower than before: D-85's Class 1 rule holds); W1 Würth 687606152002 (4.67) → **GCT 05-06-A-0152-A-4-06-4-G** (3.26; 6 × 0.5 mm, 152 mm, contacts on the same side at both ends, 4.0 exposed; DigiKey 476, the Würth stays the alternative). About 11.0 (NA) / 9.6 (EU) less per plate. Not done, for a decision: the EU PSU Traco TMPS 03-105 (24.09) → Zettler ZPI03S0500WC (8.72; 25 × 25 × 16, 600 mA, 3.6 kVAC, UL/EN 62368-1; other pinout: a new footprint and the mains board's slot and 5 V island re-laid, safety review); the WAGO blocks (NA 16.70, EU 2 × 6.26) and the FH12 connectors (2 × 3.05) only with new footprints. | Human 2026-10-11: "Let's see if we can find a way to bring the prices down, go over the bom and see if we can easily reduce the price". |
| D-99 | **Back cover: the magnet plate as deep as its clips allow.** A lower plate pulls harder on the steel piece in the pocket floor. The limit is the plate clips, not the floor: their tabs flex from a root 0.4 above the back face (the relief round them needs that much shell), so a lower plate means shorter tabs, and a thinner tab to stay at ≤ 3 % snap-in strain. `BC_STEEL_FLOOR` 1.3 → 0.8 (the plate, its ridge and the clips' hooks 0.5 lower, 0.8 below the original's full shell; gap to the steel piece ≈ 1.3, was ≈ 2.1 on the original cover), clip tabs 0.65 → 0.48 (2.7 free, 2.9 % strain; the hook still 0.30 over the plate's ends). Below 0.8 the tabs would print thinner than about one nozzle line: the plate would need another retention. The cover's print settings detect thin walls so the 0.48 tabs print. To try on a PETG / ABS print: the clips hold the plate, the 0.8 floor under it. | Human 2026-10-11: "the magnet compartment and the arms that hold it need to move further, another 0.2mm"; "If we have that much clearance why don't we move the magnet down as far as it can safely go"; "Floor 0.8". |
| D-100 | **EU PSU: Zettler ZPI03S0500WC instead of the Traco TMPS 03-105.** DigiKey 2026-10-11: 8.72 against 24.09 CAD (an EU plate's parts ≈ 63.5 from 78.9); 5 V 600 mA, 90–264 VAC / 120–370 VDC, I/P-O/P 3600 VAC 60 s, UL/EN 62368-1, EN 61558-2-16, plastics to EN 60335-1 clause 30, CB / cURus / TÜV / UL (DigiKey); body 25.0 × 25.0 × 16.0 ± 0.5 (`PSU` the maximum, 25.5 × 25.5 × 16.5: 0.2 deeper than the Traco). Datasheet ZPI03SXX00WC (issue 2021-11-22) PCB layout, top view: AC/N, AC/L 15.0 apart, V−, V+ 5.0 apart, rows 15.0 apart (`PSU_ROWS`), Ø1.2 holes (pads 2.2); no NC pin (its DRC rule gone). Mains board re-laid round it: the fused line's track 5.2 under the AC row (3.5 to the N pin), the relief slot y −17.5 → −15.0 (between that track and the outputs, 8.2 mm mains to 5 V copper), the 5 V header J3 x −5.0 → 8.5 (beside V+; 1.0 clear of the PSU pins' tails on the front, the pin board's socket follows), F1 (14.0, −3.0) → (15.0, −2.5) (1.0 clear of AC/L's tail), the front logos above the slot. Both EU boards ERC / DRC clean; `make eu` passes (slot between the rows, header on the 5 V island, PSU inside the box, pad-body gaps). Open for review: the datasheet does not state reinforced insulation or the overvoltage category (the Traco's: reinforced, OVC II); Zettler's application circuit shows a 0.5 A / 250 V input fuse (F1 is T1A); DigiKey stock 142. The NA plate keeps the IRM-03-5 (8.24, cheaper than the Zettler). | Human 2026-10-11: "commit existing changes and then work on the Zettler for the EU variant". |
| D-101 | **Remote end shape: plan-view gauges.** Print 2 of the replacement cover (photo `scratch/IMG_5099.jpg`) shows the housing rubbing just below the rim where the rounded ends meet the long sides: the model's outline is a stadium (45 × 70, semicircular ends), the remote's ends are likely squarer. Measuring it with calipers is not practical, so `coupons.end_gauges()` / `print/end_gauges_PLA.3mf`: five flat 2 mm '#' frames for the original back cover, bars along y at x ±13 (4 wide: tips on the ends where the marks are, clear of the end clips at x 0) and along x at y +7.5 and −20 (3 wide: above and below the magnet holder, clear of the side tabs at |y| 9–12.5), the open centre clear of the holder; the bar tips cut to the original's inside outline (B_W, B_H less BC_WALL each side, 0.05 under) as a rounded rectangle with corner radius 20.9 (the stadium) / 18 / 15 / 12 / 9. The model's outline changes once the radius is read (`B_END_R`, MEASUREMENTS). Reading: R18 fits best of R20.9 / 18 / 12 / 9 (R15 failed in print). A flat gauge sits wherever its tips wedge, possibly low in the round-over, so a second set checks the whole inside up to the rim: `coupons.shell_gauges()` / `print/shell_gauges_PLA.3mf`, liners 1.6 thick whose outside is the cover's inside (plan corner radius 15 / 16.5 / 18 / 19.5 / 20.9, the measured round-over from its 45° point, the wall to the rim; nothing below the 45° point, where a printing chamfer would stand 0.7 proud of the curve), open in the middle, notched for the end clips (bridged round their inner side at the top), side ribs and side tabs; the right one sits on the curve with its top flush with the rim. Result (human 2026-10-11): the roundest shell gauge, R20.9, fits the original best: the model's stadium outline is right (our cover's inside 42.0 × 67.0, 0.1 more each side by D-75); the flat gauges' R18 was the outline lower in the round-over. The rub marks on print 2 come from something else (the side tabs, the clips, print shrink or that print's older geometry). | Human 2026-10-11: "It looks what is preventing the remote backcover from working correctly is the curvature of the case, see blue areas"; "I can't measure that with calipers, let's try printed gauges but they would have to have to be in a # stile pattern with two arms touching each side but without interfering with the original magnet holder"; "R15 got messed up, printer dragged it R18 seems to fit the best out of the ones I have"; "don't we also need a set that fits inside the whole shell and stands up to the edge to verify the curve there?"; "yes, build the set". |
| D-102 | **Superseded by D-153 / D-155 (standard FR4, 3.2 mm, the load in bus bars).** **Mains spacing 3.0 mm on high-CTI FR4 (hard constraint 3).** D-24's 3.5 mm came from IEC 60664-1 (as recorded there): OVC III, 4 kV basic clearance 3.0 mm; creepage at 270 V (the 320 V row), PD2, material group III 3.2 mm; plus margin. The mains boards (NA mains board, EU mains board) are to be made in high-CTI FR4 (CTI ≥ 600, material group I): creepage then about 1.6 mm (from Table F.5 as I understand it, to confirm in the review), so the 3.0 mm clearance sets the target: L–N, in to switched / fused, mains to PE ≥ 3.0 mm (`MAINS_GAP`, NA `pcb/na/tools/parts_na.py`, EU `params_eu.py`: DRC rules, the EU pours and fused line track, the EU rocker-slot check). Mains to 5 V stays 8.0 mm with the slot; the rated-part exception stays (the WAGO 2604 pads 2.8 mm apart on their 5 mm pitch, covered by WAGO's 400 V III/2 rating). OVC II was considered and set aside: a fixed-installation switch is OVC III, and the varistor protects only the PSU feed. Solder mask does not count as insulation in IEC 60664-1, so our copper is not taken as closer than the WAGO's poles. Routed slots between terminals help creepage only, not clearance. PCBWay notes ask for high-CTI FR4 on both mains boards. Boards ERC / DRC clean, `make check` / `make eu` pass. Open: the switch product standard (IEC 60669-1), the copper weight (2 oz recommended for the mains boards). Not a compliance claim. | Human 2026-10-11: "make a note of the preference for High-CTI FR4 and use 2.8mm like the Wago since our conductors have insulation while their poles are bare"; then, told that solder mask does not count and 3.0 is the OVC III clearance, "3.0 mm". |
| D-103 | **Superseded (D-107: undone, the longer inside did not improve the fit).** **Back cover: 0.2 mm longer inside.** The end walls go from 1.50 to 1.40 mm (`BC_END_WALL`): 0.1 mm more room at each end, inside 42.0 × 67.2 at the rim (was 42.0 × 67.0); the long side walls stay 1.50 (`BC_SIDE_WALL`), the outside stays 45.0 × 70.0. `back_shape()` takes a separate inset along y. The end clips stay where they were (their reach is from the outside rim). | Print in ABS after D-75 (`scratch/IMG_5101`): the housing still rubs on the rounded short ends. Human 2026-10-12: "perhaps increasing the internal area from end to end (lengthening up/down) by 0.1 or 0.2mm would help". Open: the fit on the next print. |
| D-104 | **NA mains board: switched line kept 3.0 mm from the fused line; switched-line pour towards the rocker.** A rule now holds any two different mains nets 3.0 mm apart (`MAINS_GAP`); before, only L_IN–L_SW / L_F and N_IN–N_SW had rules, and the L_SW pour came within 0.20 mm of PS1.1 (L_F) and 0.85 mm of it near F1. The fused line runs from F1.2 straight to RV1.1, F1 takes L_SW through two vias below it, and the L_SW pour also runs up from J1.4 into the band between J1's upper pin row and the rocker's in pins (a second path in parallel with the one under J1). The necks between the WAGO pins stay about 1.9 mm (5 mm pitch less the pads and 2 × 3.0). The EU mains board already had the general rule: its L_SW pour is 3.0 mm from F1.2 and PS1.2, its pour necks are wider than the pads, no change. Extending the PE arms to the WAGO pads' inner edges was dropped: it would narrow the L and N copper at the same pins. | Human 2026-10-11/12: "pull back the Neutral fill around the square pad of the power supply"; "keep separation between the paths before the fuse and after the fuse"; "up and then to the right between the rocker and the wago"; PE arms: "that would impact the thermals and copper of the mains leads". |
| D-105 | **Silkscreen: rocker second source; bare renders of every board.** The rocker's label on the NA mains board and the EU mains board reads "E-Switch RA412C1100 or Marquardt 1802.2504" (the order lists take the RA412C1100, D-97); the EU pin board's socket reads its part (Samtec SSW-102-01-G-S). `make renders` writes the bare 3D views (all components removed) for every board, not only the mains board. | Human 2026-10-12: "some of the component silkscreens need to be updated ... like with switches alternative components"; "make sure there are renderings of the PCBs without any components". |
| D-106 | **Version v0.5.** Board revisions, title blocks, silkscreen, fab and PCBWay packs, the order lists' names and the plate renders go from v0.4 to v0.5 (2026-10-12); the v0.4 files are removed. v0.5 holds D-80..D-106. | Human 2026-10-12: "bump the version to 0.5 and commit changes". |
| D-107 | **Back cover: D-103 undone; both end clips nearer the ends.** The end walls are 1.50 again (`BC_END_WALL` and the separate y inset removed; inside 42.0 × 67.0). Bottom clip: hook tip 3.25 mm in from the outside rim (was 4.0), the whole clip 0.75 nearer the end. Top clip: 0.3 nearer the end, hook tip 2.7 (was 3.0), its back 0.8 from the outside (was 1.1). Both clips' backs now merge into the end wall (`BC_LATCH_REACH`). | Human 2026-10-12: "undo the 0.2mm lengthening, it did not improve the back cover fit, then move the tab at the bottom from 4mm from the edge to 3.25mm from the edge"; "move the top side tab from 1.3mm from the edge to 1mm from the edge" (measured on the print: the top clip's back; the model moves it 0.3). Open: the fit on the next print. |
| D-108 | **Back cover: bottom hook 0.2 deeper; side tabs 0.1 higher.** The bottom clip stays where D-107 put it; its hook stands 1.3 mm in (was 1.1), the tip 3.45 mm in from the outside rim (`BC_LATCH_HOOK`, `BC_LATCH_REACH`). The four tabs in the long side walls (D-90) move 0.1 towards the rim: 0.9..1.7 below it (was 1.0..1.8, `BC_TAB`). | Human 2026-10-12: "the lower tab on the remote back cap needs to protrude out 0.2mm more, the 4 tabs on the sides need to come up 0.1mm". Open: the fit on the next print. |
| D-109 | **Partly superseded (D-122: three editions; D-127: one barrier; D-146: EU plain plate 84.6 × 84.6).** **Two editions per variant: full and plain.** Full: rocker, battery-free remote, MSR-2 (optional CO2), SHT40, microphone. Plain: rocker and battery-free remote only, on the same mains board(s), 5 V parts, spring pins, pin board (NA), back cover and cover flex. NA plain: `barrier_na.build(plain=True)` without the 5 V cable channel and bore (its only barrier openings are the two spring-pin holes), no sensor board, FFC or J2; face plate `face_plate_na.build(plain=True)`, a standard-size single-gang outline, 2-3/4 × 4-1/2 in (69.85 × 114.3 mm, NEMA WD 6), centred on the box, the same keys and #6 screws; its side wall beside the barrier's flange is 1.11 mm (`PLAIN_WALL_MIN` 1.0). EU plain: `barrier_eu.build(plain=True)` with the battery-free pins' holes only, no sensor board, P1 / P2 left off the pin board; carrier without the sensor board's rim, screws or pin holes (its lip under the barrier and the four corner snap windows; nothing beside the barrier at the sides); face plate 80 × 80, centred, 0.4 mm between its walls and the barrier. `make check` / `make eu` check both editions (barrier, fits, snaps, printability); order lists `unit_*_plain`, `make order-push VARIANT=na-plain|eu-plain|both-plain`; print jobs `plain_*`, `eu_plain_*`. | Human 2026-10-12: "We should have ... versions of both the NA and EU boards: 1. Fully featured ... 2. Just batteryless operation and the rocker switch. Make separate face plate designs ... which can be smaller ... They can still re-use the core PCBs and pogo pin components and backplate + flex PCB setup"; two versions only; plate size: standard wallplate size. |
| D-110 | **Back cover: bottom hook 0.2 deeper again, the bottom clip 0.1 further from the end.** Hook 1.5 mm (was 1.3), tip 3.75 mm in from the outside rim (was 3.45); the clip's body moves 0.1 inwards (`BC_LATCH_HOOK`, `BC_LATCH_REACH`). | Human 2026-10-12: "The bottom tab on the remote back-cover needs to protrude even more out to the middle, another 0.2mm and move 0.1mm further away from the edge". Open: the fit on the next print. |
| D-111 | **Back cover: magnet plate clips 0.8 thick.** The two tabs that hold the steel plate go from 0.48 to 0.8 mm (`BC_STEEL_CLIP`): about 2.8 times the bending strength; snap-in strain 4.8 % (the check's limit raised from 3 to 5 %: strength before flex). Width 6.0 and the 0.30 hook over the plate's ends unchanged. | Human 2026-10-12: "Make the magnet holding clips a fair bit more stiff/thicker, flex hasn't been an issue so far but they snap off far too easily". Open: the fit on the next print (the plate still snaps in). |
| D-112 | **Back cover: bottom clip's hook 0.2 deeper, 0.1 lower.** Hook 1.7 mm (was 1.5), tip 3.95 mm in from the outside rim (was 3.75); the clip's body stays; its top 4.8 above the inside floor (was 4.9), so the hook sits 0.1 lower (`BC_LATCH_HOOK`, `BC_LATCH_REACH`, `BC_LATCH_TOPS`). | Human 2026-10-12: "Move the hook tip of the bottom clip 0.2mm further away from the edge and 0.1mm down". Open: the fit on the next print. |
| D-113 | **Back cover: the bottom clip's hook gets a flat underside.** The bottom hook sits in the shell's round-over: at its tip (3.95 mm in) the inner surface is at z 3.87, so its 45 deg underside and the lower part of its tip face lay inside the wall and nothing faced down to catch the housing's slot. Now a 0.3 mm tip face under the 45 deg top, then a flat underside back to the column (`BC_LATCH_CATCH`): 2.80 above the inside floor, 0.51 mm proud of the shell's inner surface (check: >= 0.4, clear under the tip); printed as a 0.5 mm ledge. The top clip keeps its 45 deg underside (it stands about 1 mm clear of the wall and holds). | Human 2026-10-12: "If the renderings in scratch are correct the clip doesn't actually hold anything down because the angle on the bottom side is vertical". Open: the fit on the next print. |
| D-114 | **Cover flex 0.10 mm thick.** `FLEX_T` 0.12 → 0.10 mm: PCBWay's default single-sided flex thickness (polyimide base, copper, coverlay), cheaper than a custom one; 0.12 was a round figure without a source. The pads sit 0.02 lower in the cover, inside the spring pins' 0.3 mm tolerance. | Human 2026-10-12: PCBWay's default "without stiffeners"; "set it to 0.10 and rebuild, it's probably cheaper". |
| D-115 | **Back cover: the bottom clip 0.77 mm higher, its hook's top 3.25 mm below the rim.** On the print the hook's top (where its 45 deg ramp leaves the shell's curved inner surface) measured 4.6 mm below the rim (model 4.35). The clip's top goes from 4.8 to 5.57 above the inside floor (`BC_LATCH_TOPS`), so that point is 3.25 below the rim in the model (`BC_LATCH_SHOW`, held by `make check`); hook 1.7, tip 3.95 in from the rim and the flat underside (D-113) move up with it. The print measured 0.25 deeper than the model here. | Human 2026-10-12: "the top of the catch/tab should be 3.25mm down from the edge/rim instead of the currently measured 4.6mm". Open: the fit on the next print. |
| D-116 | **Cover flex: review fixes (parts, bend, stiffeners, coverlay, fab files, hooks).** Parts: C3 / C4 1 µF X5R 0603 Samsung CL10A105KO8NNNC (0.85 µF at 5 V, 0.93 µF at 3.3 V; the 0402 CL05A105KO5NNNC kept 0.31 µF at 5 V, below the TLV755P's 0.47 µF effective minimum, TI SBVS320D §5.3 / Samsung DC-bias data); D1 TI TPD1E10B06DYAR (bidirectional TVS, 5.5 V, SOD-523, TI's DYA0002A land pattern) on +5V, the pin pads being exposed with the cover off; the regulator section 6.6 → 8.0 mm long and its recess to y 1.1 for them. Bend: inside r 0.6 mm (`BC_BEND_R`, 6 × the 0.10 mm flex, IPC-2223 single-sided bend-to-install; PCBWay 3–6 ×), copper outside (the fingers face the contacts and the pads the windows); the run leaves the ledge 0.7 mm short of the copper face; relief slits 0.9 mm wide either side of the run up to 0.4 mm past the bend zone keep the end section's lower edge on the ledge; the flat layout maps heights with the bend's developed length (`flat_y`). Tracks cross the bend zone straight; the +3V3 lane turns 0.85 mm past it (`BC_LANE_H` 0.6 → 1.55, 0.3 under the band's top edge). Outline inside corners r 0.76 (slit ends full round). Stiffeners: real outlines on User_1 (named, filleted); the 0.4 mm one notched round the run and slits up to 0.76 mm past the bend zone, the finger pads still wholly on it. Coverlay: openings 0.1 mm beyond the pads, gang openings over U1 / D1's pin rows; the pin pads Ø3.0 copper under a Ø2.6 opening (the coverlay holds the edge); teardrops at the pads. Cover: the stiffeners on 0.05 mm of adhesive (`BC_STIFF_ADH`), the snap hooks 0.15 mm over the stack (was 0.05) and 0.30 mm over its edges (was 0.20; post strain 3.7 %). Fab: the drawing says FIT-TEST PROTOTYPE with a stackup note and a title block; no empty drill files, no 2-layer job file, no bottom silkscreen in the PCBWay pack. KiCad keeps the board 2-layer internally (B.Cu empty). Battery polarity checked on a unit (MEASUREMENTS). | Human 2026-10-12: "We'd better get all the details about the flex PCB correct, validate all assumptions and parameters, routing and attachment"; "make all the flex fixes and regenerate the files". Review: TI, Harwin, Samsung, Mean Well datasheets; IPC-2223 summaries, PCBWay / JLC / FCT / Sierra flex guides. Open: positions REF / MEASURE (cell axes, VBAT setback, PCB strip clearance), the remote's current, whether PCBWay takes two stiffener thicknesses in one order, 3.3 V vs the remote's SoC. |
| D-117 | **Back cover: the bottom clip 0.7 mm lower, to test.** The print of D-115 measured the hook's top 1.1 mm too high; it moves 0.7 lower: its top (where the ramp leaves the shell) 3.95 mm below the rim in the model (`BC_LATCH_SHOW`), the clip's top 5.07 above the inside floor (`BC_LATCH_TOPS`); the flat underside moves with it. The full 1.1 would put it back where it was before D-115 (model 4.35, measured 4.6). | Human 2026-10-12: "the catch/tab on the bottom side of the remote now measures 1.1mm too high"; "let's move it down by 0.7 and test again". Open: the fit on the next print. |
| D-118 | **Back cover: the bottom clip set by its catch height and the top clip's protrusion.** D-117 did not snap. The bottom clip's flat underside goes 0.15 mm up, 3.22 mm above the inside floor (`BC_LATCH_CATCH_Z`), and its tip stands as far clear of the shell's inner surface as the top clip's tip, 0.89 mm (`BC_LATCH_PROUD`, from the top clip's 2.7 mm reach at the foot of its tip face): the reach follows the round-over, 3.99 mm in from the outside rim, so moving the catch up or down keeps the protrusion. Clip top 5.22 above the floor, hook 1.7. `BC_LATCH_SHOW` removed; `make check` holds the two protrusions equal. | Human 2026-10-12: "The remote backplate now doesn't snap ... we moved it too far down (need to move it back up 0.15mm) and as you move the clasp/tab up and down the amount it protrudes from the inside face changes, we need to keep that constant. make it protrude the same amount from the inside surface as the top claps/tab". Open: the fit on the next print. |
| D-119 | **Order lists: three per distributor.** `make order` writes `unit_na`, `unit_eu` and `devkit` (5 NA and 5 EU plates, `DEVKIT_SETS` default 5) for DigiKey and Mouser, nothing else; parts a distributor does not carry are listed last in its file with the other's part number (no `_rest_` files). The battery-free edition's lists and the separate per-variant devkit lists are gone; `make order-push VARIANT=na-plain|eu-plain` still uploads the battery-free parts. The PCBWay devkit packs take 5 sets of parts per variant. | Human 2026-10-12: "Clean up the csv bom files, all we need is single board eu for mouser and digikey, single board na for mouser and digikey, one devkit with 5 of each na/eu for both mouser and digikey". |
| D-120 | **Version v0.6.** Board revisions, title blocks, silkscreen, fab and PCBWay packs, the order upload's name and the plate renders go from v0.5 to v0.6 (2026-10-12); the v0.5 files are removed. v0.5 is tagged and kept on the `v0.5` branch at its last commit. | Human 2026-10-12: "commit, tag v0.5 and bump to v0.6". |
| D-121 | **NA face plate: the edge chamfer uniform all round.** The MSR-2 and SHT40 bay frames were added after the 1.2 mm front edge chamfer and filled it where their outer walls reach the plate's edge: a square step about 0.8 mm tall above the MSR-2. The frames and the sound column are now clipped to the chamfered outline; `make check` probes the chamfer along the top and bottom edges. The EU face plate was already uniform. | Human 2026-10-12: "Looking at a print of the NA fully featured front trim the edge is not uniform all the way around, where the MSR-2 is located it turns into a sharp corner, we should fix to make uniform". |
| D-122 | **Three editions: switch only, battery-free, full.** Switch only: the rocker switch and the terminal blocks on the mains board, nothing else; the remote runs on its own cells and back cover. NA: the mains board with S1 and J1 and its standoffs; `barrier_na.build(switch=True)` without the spring pins' holes, the pin board pocket and clips or the cable bore (the pocket floor solid there; barrier check without pin plugs); the plain face plate. EU: the mains board with S1, J1, J2; no pin board; `barrier_eu.build(switch=True)` without pin holes or pin board bosses; the plain carrier and face plate; the PE lever connector. Battery-free: the mains board fully populated (NA: J2 now fitted too), the 5 V path to the spring pins, the back cover with its flex. Order: `make order-push VARIANT=na-switch|eu-switch` (`switch_keep`); print jobs `switch_*`, `eu_switch_*`; renders `switch_*`, `eu_switch_*`; `make check` / `make eu` check both switch-only barrier parts. | Human 2026-10-12: "The \"Switch only\" version should have the rocker switch and the wago terminals but nothing else. The battery free should have the fully populated back board plus any parts required to deliver 5v to the pogo pins plus the battery back cover with the parts inside it". |
| D-123 | **Back cover: the walls 0.2 mm further out, the inside round-over 0.2 wider.** It still rubbed in the middle of the round-over. The side walls go from 1.5 to 1.3 mm (`BC_SIDE_WALL`, inside 42.4 × 67.4 at the rim) and the inside round-over from 8.1 to 8.3 mm across (`BC_IN_RUN`, 8.0 up as before), so it still leaves the flat back where it did and its middle is 0.10 mm further from the housing. The clips keep their tips where they were (now 1.08 mm proud of the wall, both). | Human 2026-10-12: "There is still a little bit of rubbing on the remote back cover, it's in the same spot as before, in the middle of the radius. Can we move the walls out by 0.2mm on back and increase the radius to compensate hopefully giving us 0.1mm more clearance on the inside in the middle of the radius". Open: the fit on the next print. |
| D-124 | **Gauges removed.** The back profile gauges (D-87), the end gauges and the shell gauges (D-101) have done their job (the round-over and end shape are measured, `docs/MEASUREMENTS.md`): their models, print jobs and OrcaSlicer projects are deleted. | Human 2026-10-12: "delete the gauges, they are no longer needed". |
| D-125 | **Variants equal: no default variant.** Every file, render, print job, board and part name that belonged to the NA plate without saying so now carries its variant, as the EU ones did, and equivalent parts share one name. Parts: barrier (NA insert, EU cap), face plate (was trim), mains board (NA wiring board), sensor board (NA ring board, EU cap board), pin board (NA riser, EU 5 V board); the EU carrier and test socket keep theirs. CAD: the parts both variants use stay in `cad/build123d/` (`params.py` holds only shared values, `checks.py` the shared checks, `render.py` the render helpers, `render_shared.py` the shared parts' renders); NA code moves to `cad/build123d/na/` (`params_na.py`, `barrier_na.py`, `face_plate_na.py`, `sensor_board_na.py`, `standoff_na.py`, `jumper_na.py`, `coupons_na.py`, `assembly_na.py`, `checks_na.py`, `render_na.py`, `sections_na.py`), EU's to `barrier_eu.py`, `face_plate_eu.py`, `sensor_board_eu.py`; parameters renamed to match (`MB` mains board, `SB_` sensor board, `PB_` pin board, `MSR_NUT`, `PIN_WORK`, `SCOOP`, `WAGO2`). Builds go to `build/na/`, `build/eu/`. PCB: `pcb/na/`, `pcb/eu/` and `pcb/shared/` (cover flex and the low-voltage generator `gen_lv.py na|eu|shared`), each with `kicad/`, `tools/`, `fab/`; shared helpers in `pcb/tools/` (`fplib.py` from `gen_libs.py`, `common_parts.py`); boards `na_mains_board`, `na_sensor_board`, `na_pin_board`, `eu_mains_board`, `eu_pin_board`, `eu_sensor_board`, `cover_flex`; silkscreen titles to match. Renders `na_*` (the NA plate renders lose the version in their name, as the EU ones never had it), print jobs and projects `na_*` / `eu_*`; `make na` beside `make eu`, `make check` runs both. Earlier entries in this log are rewritten to the new names and paths, quotes excepted. | Human 2026-10-12: "go back and rename and rephrase all things so that we don't assume that the default variant is the NA variant, each file that has an _eu_ indicates that perhaps there is an equivelent file that probably should have a _na_ in it, variants shouldn't be second class citizens they should all be equal"; layout na/ eu/ shared, the same names for equivalent parts, paths rewritten in the log (human choices 2026-10-12). |
| D-126 | **Back cover: no ledges, the inside eased out where the housing rubs; bottom clip 0.1 nearer the rim with a 30° ramp under its hook.** The 45° frustum below the round-over met the curve at the curve's 45° parameter point, which is not where its slope is 45° when run ≠ rise: since D-123 (inside 8.3 across, 8.0 up) that left a 0.09 mm step inside at z 3.9–4.0, in the band that rubbed, and 0.03 mm outside at z 2.35 (8.1 / 8.0). The frustum now meets the curve where its slope is 45° (`params.back_run`), outside and inside. The inside (`params.shell_in`, `backcover.cavity()`) is eased out by up to 0.42 mm (horizontal) at 4.0 above the back face (`BC_EASE`), sin² taper to nothing at the floor and at the straight wall; the outside stays, the thinnest wall is 1.30 mm, as the straight side walls. The bottom clip's catch goes from 3.22 to 3.32 above the inside floor (`BC_LATCH_CATCH_Z`) and a 30° ramp (`BC_LATCH_RAMP`) under the hook carries it; the clips' tips and the side tabs stay where they were (placed from the profile before the ease, `shell_in_base`): bottom 3.95, top 2.7 in from the outside rim, so they stand 1.46 / 1.19 mm clear of the eased wall. `make check`: no steps, thinnest wall, room gained, tips. | Human 2026-10-12: "Move the bottom clasp/tab on the remote back cover closer to the rim by 0.1mm, also but a 30 degree ramp on the bottom to make sure it doesn't get crushed"; on the proposal (scratch/bc_bottom_clip_proposal_green.png): "that area needs more clearance, we can either move the outside wall further out or thin the walls depending on structural integrity"; "yes, keep the tip where it is and build it". Open: the fit on the next print. |
| D-127 | **One barrier per variant for every edition; a printed blank board in place of the pin board in switch only.** The edition barriers (D-109, D-122) differed only by holes: NA by the spring pins' holes, the pin board's pocket and clips and the cable bore, EU by the four pin holes and the pin board's bosses. Now each variant has one barrier with all of them (`barrier_na.build()`, `barrier_eu.build()`). Switch only: a blank board, printed in the barrier's job (`na_barrier_*` / `eu_barrier_*` take `na_blank_board` / `eu_blank_board`), in V-0, takes the pin board's place. NA (`sensor_board_na.blank_board()`): the pin board's outline and thickness, held in its pocket by the same clips, a peg up each pin hole to 0.1 under the seat (`BLANK_CLR`). EU (`boards_eu.blank_board()`): the pin board's outline on its bosses and screws, a peg up each of the four holes to 0.1 under the barrier's face, a ledge along the round edge up to 0.2 under the barrier (`BLANK_LEDGE`) closing the box. Gone: the plain and switch-only barrier print jobs. `make check` / `make eu`: the blank boards clear of the barriers and the boards, held, their pegs in the holes, the barrier test with them. Open: in battery-free and switch only the NA cable bore is not filled (no FFC), in EU battery-free the sensor pins' two holes (P1 / P2 not fitted); the barrier tests plug them and print OPEN. | Human 2026-10-12: "we don't need different versions of the barriers/inserts, the only difference is 2 or 4 holes that can just always be there, just have one version with the holes for each the NA and EU versions"; "For the NA version we simply print a small plate that replaces the PCB with pogo pins, it always prints with the insert/barrier. For the eu version we do the same, blank plate to replace the PCB holding the pogo pins. with a ledge that closes off the box."; "Both of the fake PCBs can have printed pins on them to fill the holes, I think the fake EU board should be able to fill/cover all 4 holes"; the cable bore to be addressed after this. |
| D-128 | **Partly superseded (D-129: the ridge rests on the pin board's front, round its edge).** **EU: a ridge along the pin board's straight edge; the sensor pins' holes stay open in battery-free. NA: a third pin board clip.** EU: a ridge under the barrier (`barrier_eu.ridge()`, `PB_RIDGE`), 1.6 thick, 0.2 from the pin board's straight edge, from the barrier's underside to 0.5 below the board's back, 51.7 mm across the box between the dome notches (it joins the switch cup and the steel piece's cup). In battery-free the sensor pins P1 / P2 stay off and their two holes stay open, over the pin board, behind the ridge, under the face plate. Measured: mains air still reaches those two holes round the pin board's round edge (0.75 mm from the box wall) and through its screw holes, long-boss holes and dome notches; the EU barrier test plugs them and prints a note. NA: a clip on the pin board's bottom edge, between the posts (`PB_CLIPS`): with the top and right ones it holds the printed blank board (switch only), which has no posts; strain and clearances as the other two. | Human 2026-10-12: "Add a ridge on the EU barrier board that would sit up against the straight edge of the EU pin board, this way we don't need to plug the sensor holes since they don't provide access to high voltage and are covered by the face plate."; "The NA pin board will need more more clip to support a blank without the posts". Open: whether the open path round the pin board is acceptable (human review). |
| D-129 | **EU: the pin board rests on a ridge that ties its bosses together; two more screws.** The ridge (`barrier_eu.ridge()`) now stands from the barrier's underside down onto the pin board's front face, 1.6 wide, 0.3 in from the board's edges: from the far left boss out to the round edge, round it to the straight edge, along the straight edge, down inside the two sensor pins by the round edge (`PB_RIDGE_PATH`), back out to the round edge and round to the far right boss; 0.4 clear of the parts on the front and of the mains board's long boss, 521 mm3. Two more M2 screws into bosses on it (`PB_MOUNT`, the board's MH3 / MH4): at the straight edge's left end (−16, −3.2) and by the sensor pins (22.4, −11.0), where the board has no copper on either side; none in the middle (under the steel piece the boss would be too short for the thread, a track runs on the board's back beside it). Four M2 × 5 thread-forming screws per plate. The board's front bears on the ridge; the spring pins push it away from the barrier, which the four screws take, the two new ones near the pins. The blank board (switch only) rests and screws the same way. `make eu`: the ridge one piece on the board's front, inside its outline, joined to all four bosses, clear of the parts. | Human 2026-10-12: "The EU pin board could use more support close to the straigt edge and to support the pogo pins from flexing the PCB, we also might as well have it rest on a complete ridge along the edge that ties into the standoffs it attaches to for added rigidity of the barrier"; "The ridge can be interrupted by pogo pins, it can simply run on the other side of the ones by the edge"; "then we can add more screws/bosses for rigidity". |
| D-130 | **Back cover: bottom clip 0.3 nearer the rim, its tip kept.** The catch goes from 3.32 to 3.62 above the inside floor (`BC_LATCH_CATCH_Z`), the clip's top to 5.62 (2.58 under the rim); the hook tip stays 3.95 in from the outside rim (`BC_LATCH_TIP_Z`, the height it was placed at), so it stands 1.29 mm clear of the wall before the ease, 1.64 with it. | Human 2026-10-12: "The remote back cover now fits quite well, we need to move the lower tab up closer to the rim by 0.3mm". Open: the fit on the next print. |
| D-131 | **EU: the barrier's ridge and the blank board's ridge drawn as a pair, rounded.** Both come from one plan (`ridges_eu.py`, shapely): the barrier's ridge along the path of D-129, merged into its four bosses with r 0.5 fillets (`RIDGE_ROUND`), 0.3 in from the board's edges, 0.4 clear of the parts on the front and the long boss; the blank board's ridge replaces its ledge round the edge (D-127): 1.6 wide, its centre line the barrier ridge's moved 1.8 towards the board's middle, 0.2 from the barrier's ridge (`BLANK_GAP`), from the blank board up to 0.2 under the barrier, so the two stand side by side; it breaks, with round ends, at the steel piece's cup (it hangs 2.5 under the barrier over the board's middle), the long boss and the bosses, in four pieces (69 mm2; stubs under 8 mm2 dropped). Every corner of both is rounded in plan (r ≥ 0.45, checked); both print standing up from their faces, no overhangs. `make eu`: gap, rounding, clearances. | Human 2026-10-12: "we might as well extend the ridge on the faux pcb board to meet up with the ridge on the ridge on the barrier board, redesign both ridges so that they provide ridigity to the pieces they are on but also complement each other without creating hard to print patterns or sharp corners." |
| D-132 | **NA: the face plate surrounds each screw and forms the top of the pocket's ends.** The #6 countersinks (6.8 across, centred 41.65 from the box centre) reached into the face plate's window round the barrier's island (edge at 38.55), so neither part was whole round the screw. Each screw now has a face plate lobe (`face_plate_na.screw_lobes()`, `SCREW_LOBE`): 7.0 round the screw, from the window's edge in to the remote pocket's end arc, so the face plate forms the pocket wall's top 2 mm there (6 mm along the arc each end), filleted r 1.5 where it meets the window's edge, its tips rounded; it sits on the barrier's pocket wall, which is cut to the lobe's shape with a 0.15 seam (both editions' face plates). The boss clearance under the face plate ended 1 mm into its 2 mm skin; it now ends at the skin, so the plate is solid 1.0 mm all round each countersink, down to its underside. `make check`: countersink surround, seam, the lobes on the pocket wall. | Human 2026-10-12: "I don't like how on the NA faceplate there isn't a solid piece of plastic surrounding the screws, add an area around the screw to the faceplate that can be substracted from the insert so that the faceplate forms part of the inside of the chamber for the remote, something nice and curved but making a close seam." |
| D-133 | **EU: the barrier's ridge a loop round the pin board's whole edge.** It ended at the two bosses at the far edge, leaving the bottom of the round edge open. It now runs round the whole board (`ridges_eu.path()`): along the straight edge, inside the two sensor pins, round the round edge, smoothly inside the bottom dome notch (r = notch + 0.3 + half its width), with a spur out to each far boss; 866 mm3. J3 (the mains board's header) and the socket J1 on it stay where they are: the loop passes 2 mm from the socket, 0.4 or more from its pin tails (added to the keep-outs). The blank board's ridge becomes a ring just inside the loop, 0.2 from it, broken at the bosses, the long boss and the steel piece's cup, in five pieces (113 mm2). | Human 2026-10-12: "If we move the Samtec J3 connector I believe we can have a ridge along the whole edge of the pin board again" (it did not need to move). |
| D-134 | **NA 5 V cable straight from J2 to J1 through a slit in the barrier's bottom wall (replaces the bore, D-74).** Threading the 152 mm FFC up the bore and folding its spare was too fiddly. J2 on the mains board turns to 0° at (12.7, −23.3), cable out downwards between PS1's +5V and GND pins (its +5V pins to vias above them, joined on the back to PS1.16; GND to a bar above the vias; the +5V track from PS1.16 to P1 moves to x 7.8). J1 moves to the bottom of the sensor board, 180° at (12.7, −50.0), cable in from above; C1 at (20.0, −54.2), the KiCad logo in the bottom-right corner at (26.4, −49.6). The cable stays in the plane x 12.7 (`params_na.ffc_curve()`): 1 mm straight out of J2, a 3 mm bend up, one straight run (20.4 mm high, 81° from horizontal), a 4 mm bend over onto the sensor board, into J1; no folds, no twist. The barrier's slit (`barrier_na.ffc_slot()`) follows it, 4.4 mm wide, 0.25 mm round the cable: its mouth in the taper under the plug's bottom face, the straight run up through the wall behind a lip (0.84 mm at its lower end, z −8.1, cut back below that so no knife edge prints; 0.87 at the wall plane), the bend guided by the slit's curved wall, a channel under the flange to J1. Open along its left side through a 1.1 mm notch: the cable, bent to shape, slides in sideways. Below the wall plane the cable stays inside the plug's outline; it crosses the box wall's line 1.45 mm in front of the wall plane. Slit 1.87 mm from the remote pocket (≥ 1.6), 4.86 from the nearest tapped hole. Two arrows (4.5 mm, 0.35 deep) engraved in the plug's bottom face either side of it. The collar's crush ribs on the top and bottom sides move from x ±14 to ±18 (the bottom one sat in the cable's channel). Cable: GCT 05-06-A-0050-A-4-06-4-G (50 mm, contacts on the same side at both ends, Würth 687606050002 the alternative; DigiKey 2026-10-12: active, 486 in stock, CAD 2.06 against 3.26): the route 37.1 mm + 4.0 into each connector leaves 4.9 mm to bow in the free span. Sensor board: +5V from J1 runs on the back along the bottom band, on the front up the left edge (0.35 mm, outside the 6.4 mm keep-out) beside a 0.3 mm GND track, on the back across the top band to CN2: about 0.4 Ω round trip in 1 oz copper, 40 mV per 100 mA. With the bore gone MH3 returns to (21, 33.5), in line with the other holes, its stud full length (8 mm, boss top −1.6). Silkscreen: mains board "↑ UP / THIS SIDE TO THE ROOM" (front), "↑ UP THIS SIDE INTO THE BOX" (back), "FFC ↓ TO THE SLOT" (both); sensor board "↑ UP THIS SIDE TO THE ROOM" (front), "THIS SIDE TO THE WALL ↑ UP" (back), "↑ FFC FROM THE SLOT" (both). The slit is the barrier's single cable opening (hard constraint 2); the barrier test plugs it. Checks: J2, J1 and the slit on one x, the run leaning outwards, the stock length, the cable inside the plug's outline, the lip, the slit's walls to the pocket and the tapped holes, clearances, KiCad J1 against SB_J1. All three NA boards ERC / DRC clean. Open: sliding the bent cable in on a print. | Human 2026-10-12: "The cable between NA ring board and main power board running through insert is going to be way too fiddly to install, let's change strategies and just provide a slot in the top of the insert"; then "if we put the cable on the bottom and rotate J2 we should be able to have a straigt cable without any folds", "a single 90 degree bend is sufficient and we can do gendle curve into the barrier", "the entry into the the barrier/insert also doesn't need to be vertical, it can be at the natural angle for the cable"; on the renders: "Now that's a lovely design", "Do it". |
| D-135 | **NA: the cable slit stays open in battery-free and switch only.** With no FFC in these editions the slit (D-134) is not filled, and nothing is added to fill it. It is 0.5 mm wide (4.4 long); its mouth faces into the box under the plug's bottom face, and its upper end lies under the barrier's flange, behind the face plate, where it turns 81° into the wall along a 4 mm bend. Reaching the box through it from the front needs the face plate off and something 0.5 mm thick pushed round that bend. The barrier test still plugs it and prints a NOTE (not OPEN) for these editions. Supersedes the open item on the NA cable opening in D-127. | Human 2026-10-12: "Mark the slit unfilled as not an issue due to angles and placement, it would be almost impossible to stick anything in there from the front." |
| D-136 | **Back cover: the flex's pad and regulator section 1.5 mm towards the middle.** On the print the cover fitted except that one side of the remote rested on the snap hooks beside the stiffened pad section: the outer hooks reached x 17.3, past the cell's room (axis x 11.2 ESTIMATE, Ø10.5: x 5.95–16.45). The section (`BC_STRIP` 10.7–16.5 → 9.2–15.0), its pads (`BC_FINGERS` x 13.2 → 11.7), the regulator's parts (`BC_REG`) and its recess move 1.5 mm in; the hooks now span x 8.40–15.80, where the cell would be. The run to the terminal end stays at x 7.2–9.8 (clear of the steel plate's ridge). The battery-free spring pins follow the pads on both pin boards and through both barriers. 2 mm, as asked, puts the NA pin board's GND pin 3.29 mm from the +5V post P1: 0.29 mm between the pin's flange and the M2 screw head, courtyards overlapping; 1.5 mm leaves 0.52 mm and moves the hooks inside the cell's room. EU pin board: its GND tracks re-routed round the moved pins (front: straight down from the GND pin to the socket; back: right of the pins). New check: the hooks within the cell's room. ERC / DRC clean, `make check` passes. | Human 2026-10-12: "The remote control lid is very very close to fitting, right now the only issue is that one of the sides rests against the tabs for the PCB holding the pads for the 5v. Can we move the 5v flex cable backed with FR4 towards the middle, say 2mm?" |
| D-137 | **Superseded by D-142 (0.3 mm, tapered).** **Back cover: rim 0.2 mm lower round the bottom end.** On the print the cover's rim stopped the remote's lower lip, so its lower button could not be pressed. The shell's wall (not the contact blocks or clips inside) is cut 0.2 mm down from y −12.5 (where the straight sides end) round the bottom end, with a 3 mm straight ramp back up to the full rim (`BC_LIP_RELIEF`, `backcover.lip_relief()`): 18.6 mm3. The rim elsewhere, the clips' and tabs' heights below it are unchanged. | Human 2026-10-12: "the lower lip of the remote needs to be able to be pressed to operate the lower button on the remote, currently the rim/edge of the back cover prevents it from operating, can we pull the edge of the rim down by 0.2mm" |
| D-138 | **Back cover: the steel plate's clips 10 mm wide (were 6).** Still too weak on the print. Thicker tabs would raise the strain as the plate snaps in past the 5 % limit (D-111: 0.8 thick, 2.7 mm free, 4.8 %); wider ones do not: 10 of the plate's 12 mm ends, so 1.67 × the strength and stiffness at the same 4.8 %. The ridge round the plate stays open 0.4 mm each side of each clip; the reliefs widen with them. | Human 2026-10-12: "the clips around the magnet are still a bit too weak, beef them up more" |
| D-139 | **45° chamfer round the remote pocket's mouth.** The same 45° × 1.2 mm as the face plates' outer edge (`POCKET_CHAMFER = FACE_CHAMFER`, `common.mouth_chamfer()`), round the pocket's stadium at the face: NA in the barrier's island and in the face plate's screw lobes where they form the pocket's ends (D-132), EU in the face plate's pocket walls; every edition. The finger scoops are left as they are. | Human 2026-10-12: "apply the same sort of 45 degree angle that's on the outside of all the face places to the slot for the remote so the corners arent as sharp" |
| D-140 | **Partly supersedes D-111, D-138.** **Back cover: the steel plate's clips solid in the shell.** At 0.8 mm thick on a 0.4 mm root in a relief they were still weak, at 6 and at 10 mm wide. Now the tabs are 1.6 mm thick (the shell's wall), 10 wide, and grow straight out of the floor: no relief round them, the cover's shell flexes to let the plate in, so the 5 % strain rule for the tab (D-111) goes. The hook (0.45, 0.30 over the plate) has a 0.2 mm vertical tip face and a 45° lead-in up to the tab's flat top, z 3.55 (was 3.8 at the tab's back, a lead-in of about 12° once the tab was this thick). The ridge round the plate runs 0.1 mm into each clip's sides (`BC_STEEL_RIDGE_GAP = -0.1`, was 0.4 open), so the clips are braced at both ends. Checks: the tabs at least the wall's thickness, the ridge joined to them, the hook's reach. | Human 2026-10-12: "The magnet holders are still structurally very weak, we can make them thicker and simply use the flex in the whole shell to allow the magnet to be pushed in" |
| D-141 | **Back cover: the bottom clip's lead-in 45°.** The lead-in on top of the bottom clip ran from the column's outer face down to the hook's tip over the hook's depth: 1.7 mm over 2.9, 30.4° from horizontal (drawn as 45° when the hook was shallower). It is now 45° (`BC_LATCH_LEAD`): the column's top rises 1.20 mm to 6.82 above the inside floor (z 8.42), 1.18 under the lowered rim at the bottom end, with more plastic over the hook against being pressed down. Catch (3.62), hook (1.7), tip and the 30° ramp under it (D-126) unchanged; the top clip unchanged. | Human 2026-10-12: "The ramp down to the bottom clasp on the remote back cover needs to be a bit more gentle and that will also strengthen the clasp"; on the dimensioned options: "Change the lead-in of the top of the bottom clip to 45 degrees leave the lower/back ramp the same" |
| D-142 | **Partly superseded by D-145 (0.45 mm, fine layers).** **Back cover: rim 0.3 mm lower at the bottom end, tapered, no ledge (replaces D-137's 0.2 mm cut).** The lower button still needed more room. The shell's wall is cut 0.3 mm down from the bottom end up to y −25, then in a straight taper to nothing at y +30 (5.5 µm per mm): 0.23 at y −12.5 where the bottom curve starts, 0.16 at the middle, 0.10 at y +12.5; full height from y +30 to the wheel end, so the top clip stays 1.0 under its rim (`BC_LIP_RELIEF = (0.3, −25, 30)`, `backcover.lip_relief()`, 38.6 mm3). The contact blocks and clips inside are not cut; the bottom clip's top is 1.08 under the rim at the bottom end. | Human 2026-10-12: "The edge/rim needs to be cut down a bit further on the bottom to allow the button to be pressed, by another .1mm and we should try to make the change gradual from the other side so there isn't a ledge"; "it should start angling at the -25 and finish at the 30 mark"; on the redrawn profile: "Looks great, update the model" |
| D-143 | **Back cover: the pry notch 0.3 mm deeper.** The screwdriver notch in the rim at the bottom end goes from 1.2 to 1.5 mm deep (`BC_PRY = (6.0, 1.5)`), 6 mm wide as before; its floor at z 8.3. It cuts the shell's wall only: the bottom clip, whose top (z 8.42, D-141) now stands above the notch's floor, is left whole. | Human 2026-10-12: "Make the little slot at the bottom 0.3mm deeper" |
| D-144 | **Print projects built with ElegooSlicer 1.5.3.5 (was OrcaSlicer 2.4.2).** ElegooSlicer warned that the projects might be incompatible and, with the whole project imported, still sliced the EU barrier with supports (a tangle in the steel piece's recess, an 18.1 × 19.1 mm ceiling 2.5 mm over the bed face down) and its own fill: OrcaSlicer 2.4.2's command line stamps its projects `BambuStudio-02.06.00.51`. ElegooSlicer (an OrcaSlicer fork on 2.4.2, same CLI) stamps them `ElegooSlicer-1.5.3.5` with the same settings (EU barrier: 6 walls, 6 top / bottom layers, 40 % gyroid, no supports). The Makefile pins its Linux AppImage (`SLICER_VERSION`, sha256 7b3b3f08…01afc); `SLICER=` still takes another fork. Estimates in PRINTING from it (about 0.4 g more per job than OrcaSlicer). The process overrides are also written onto each object in the project (`slice.object_settings()`): the slicer's command line will not load a process marked for every printer, and object settings stay with the parts on any printer or process preset; checked on a Bambu Lab P1S with its stock process (EU barrier 11.99 g, NA face plate 23.41 g, the same as with the overrides in the process; 11.40 / 23.08 without them). OrcaSlicer 2.4.2 opens and slices the projects with these settings. | Human 2026-10-13: "I'm using the default settings in ElegooSlicer"; "ElegooSlicer does warn when opening projects now that the 3MF file may be incompatible, I always instruct it to import the whole file rather than model only but the fill still seems to be wrong"; "Make sure the projects are still compatible with other printers" |
| D-145 | **Depth superseded by D-147 (0.64).** **Back cover: rim 0.45 mm lower at the bottom end, printed in 0.08 mm layers.** The print of D-142 still stopped the lower button and had a firm ledge at y −25. In 0.2 mm layers, sliced at each layer's mid-height (9.5, 9.7), the 0.3 mm cut printed as 0.2 (the rim 9.6 from the bottom end to y +11.7, 9.8 above, one 0.2 step), and the bottom end's flat top (z 9.5) lay on a slicing plane, which leaves that layer borderline there and a step at −25. Now the cut is 0.45 mm from the bottom end up to y −25, the same straight taper to nothing at y +30 (`BC_LIP_RELIEF = (0.45, −25, 30)`), and both back cover jobs print 0.08 mm layers from z 8.6 to the top (`COVER_FINE`, a height range in the project, `slice.layer_ranges()`). The flat (z 9.35) lies between the slicing planes 9.28 and 9.36. From the G-code: the rim prints at 9.32 (0.48 down) to y −23.8, then rises 0.08 mm at a time at y −23.8, −14.0, −4.2, +5.6, +15.3 and +25.1 to 9.80. The projects are now sliced as exported (the estimates include the fine layers): back cover in PETG 26 m / 8.1 g. | Human 2026-10-13: "the lower rim needs to come down further, probably another 0.15mm, there also seems to be a firm ledge at the -25 mark rather than a smooth trasition" |
| D-146 | **EU plain face plate 84.6 × 84.6 mm (was 80 × 80): the plain carrier whole on all four sides.** On the 80 × 80 plate the carrier's outline (±37.5) lay inside its bore round the barrier disc (r 37.8), so at the middle of each edge (over 9.5 mm) only the 0.8 mm lip joined it, as on the full plate's sides before D-78. The plain plate is now square and as wide as the full plate (`PLAIN_PW = PLAIN_PH = PW`: 2 × (disc 37.6 + 0.2 + `CARRIER_SIDE` 2.0 + 0.5 + skin 2.0)), so the carrier stands 2.0 mm outside its bore, full height, on all four sides; the barrier is unchanged. Plain face plate 44 m / 29.5 g, plain carrier 20 m / 7.5 g in PLA. Check: the plain carrier's room outside its bore on all four sides. | Human 2026-10-13: "the plain eu plane carrier still has weak spots on each side where the edge disappears"; "it's not enough to just fix the sides, we also need to fix the top/bottom, even if it means increasing the footprint of the plane switch" |
| D-147 | **Back cover: rim 0.64 mm lower at the bottom end.** 0.16 mm below what D-145 printed (0.48): `BC_LIP_RELIEF = (0.64, −25, 30)`, the same taper to nothing at y +30, 0.08 mm layers over the top. The flat (z 9.16) lies midway between the slicing planes 9.12 and 9.20; from the G-code the bottom end prints at 9.16 (0.64 down) and the rim rises 0.08 mm about every 6.9 mm. | Human 2026-10-13: "move the bottom rim down another 0.16mm" |
| D-148 | **Steel piece 1.0 mm thick; its recess 1.3 mm shallower.** The supplied steel plate is 0.5 mm steel and 0.5 mm tape (human reading), not the 2.0 mm estimate: `MAGNET[2] = 1.0`. The recess in both barriers' pocket floors goes from 2.5 to 1.2 mm deep, so the piece's face sits 0.2 mm below the seat (`MAGNET_SETBACK`, was 0.5): 1.0 mm from the back cover's magnet (0.2 + the cover's 0.8 floor; the cover's magnet stays 2.0 mm, measured). EU: the cup under the recess keeps its 1.6 mm floor. The steel plate hacksaw guide's pocket follows the thickness. | Human 2026-10-13: "the indentation for the steel plate can be reduced by 1.3mm"; "the steel plate isn't 2mm thick, it's 0.5mm and the tape is another 0.5mm"; "the magnet inside the remote control backplate is still 2mm thick" |
| D-149 | **MSR-2 12 mm left (NA and EU): its front grille on the face plate's centre line; ant logos in the sensor boards' lower-left corners.** The grille is centred on the MSR-2's light sensor, `LUX_POS` 12.0 mm right of the board's centre (MEASURE: Apollo's case has its light window nearer (16.7, −8.5)). The MSR-2 now stands at `MSR_X = −LUX_POS[0]` on both variants, so the grille follows the light sensor whatever it measures; CN2, the three spacers, the switch notches, the bay frame, the posts and the top-edge vents move with it (`common.frame` takes x; the MSR-2 checks take `msr_x`). NA: the bay's left wall reaches x −34.1, against the plate's side wall. EU: the microphone and its sound hole move with the bay; the top-left screw into the carrier moves from (−32, 48) to (−32, 36), out of the bay. Sensor boards: the existing routing follows CN2's pads; the NA board's GND stitching vias sit beside the moved switch notches (from `MSR_SW_CUTS`). The ant logo (8 mm) sits in each sensor board's lower-left corner, NA (−28.0, −48.5), EU (−31.0, −43.5); the NA URL and orientation texts and the EU board name move right. All boards ERC / DRC clean. | Human 2026-10-13: "Can we move the MSR-2 sideways on both the EU and NA versions so that the air vents on the front line up on the center of the face plate?"; on the prototype renders: "apply the changes, also move all ant logos on the sensor boards to the lower left corner, even if you have to resize" |
| D-150 | **EU plain carrier: the full carrier's rim.** The plain carrier stopped at the sensor board's level (z 3.6) and was still too flexible. It now has the same rim as the full carrier: 1.6 mm wide round its outer edge, up to z 5.2 (`CARRIER_RIM`, the sensor board's top), the snap windows through it as before. It clears the plain face plate and the barrier. | Human 2026-10-13: "the plain carrier plate needs more stiffnes, it needs the same height lip on it as the regular carrier for stiffness" |
| D-151 | **Version v0.7.** Board revisions, title blocks, silkscreen, fab and PCBWay packs, the order upload's name and the section renders go from v0.6 to v0.7 (2026-10-13); the v0.6 files are removed. v0.6 is tagged and kept on the `v0.6` branch at its last commit. | Human 2026-10-13: "commit the current changes bump the version". |
| D-152 | **Conformal coating on the mains boards (optional).** After assembly both mains boards may get a brushed-on conformal coating over their mains copper and solder joints, front and back, as protection against dust, moisture and solder residue between mains conductors; the design does not depend on it. The front is coated before the board is fitted (it faces the barrier after), the back after the rocker is soldered (its joints included). Kept out of the WAGO blocks' openings and levers and off the rocker's slots, the header / J2 and the spacer posts' threads. It is not counted towards clearance or creepage (IEC 60664-1 allows that only for a coating qualified to IEC 60664-3 on that board); the spacing targets are unchanged. Candidate: an acrylic-silicone coating that can be brushed on, such as MG Chemicals 422B / 422C (listed at DigiKey; stock and part number to check when ordering). | Human 2026-10-13: "We should also recommend conformal coating over the area after for added safety" |
| D-153 | **Since D-155 the only mains boards.** **Bus-bar versions of both mains boards (`na_mains_board_busbar`, `eu_mains_board_busbar`).** Beside each mains board (unchanged) a second board whose load paths are laser-cut copper bars soldered onto it, so the board copper no longer sets the current: the high-CTI laminate (PCBWay quoted 497.01 for five) is not needed. Standard FR4 (material group III), mains spacing 3.2 mm (IEC 60664-1 creepage at the 320 V row, PD2; `BB_GAP`), 8 mm to the 5 V side as before. **Bars only between the terminal blocks and the rocker**, on the front (the only side where both the WAGO pin tails and the rocker pads are reachable), 0.5 mm copper sheet, tin plated (`BB_BAR_T`); each bar covers its rocker pad and its terminal pole's pads with a hole per pin (WAGO pins 1.3 mm = the board drill, pin size MEASURE on a part; rocker tabs 5.4 × 1.4 mm). Its land is board copper of the same outline with no solder mask (HASL lead-free); vias inside a land are left open. Narrowest bar 1.4 mm (between two WAGO poles: 5.0 pitch less 2 × (1.1 pad + 3.2)): 0.70 mm², IPC-2221 about 21 A at 10 °C rise (15 A needs 0.44 mm²). Between the pins of the WAGO block its own pitch applies (hard constraint 3 exception). **NA** (`pcb/na/tools/bars_na.py`): L_IN / N_IN straight up from their pole (1.4 mm between the poles), then straight sides out to the rocker pad's lower corners; N_SW from J1.2 up the right of the rocker onto S1.2a (2.6 mm); L_SW from J1.4 down, round J1.5 and J1.6 at exactly 3.2 mm (inner edge concentric with their keep-outs, 3.0 mm wide), straight up the left, over the top with the same radii onto S1.1a. Thin feeds (board copper, under 1 A): J1.2 → back → via → RV1.2 → PS1.3 (via 8 mm from P1's ring); a via in the L_SW land → back → via → F1.1. PE as a ring: a 7 mm band round the front edge and all free copper on the back, arms to J1.1 / J1.6, 22 stitching vias (1.3 / 0.8 mm, 5 mm grid); PE J1.6 – J1.1 continuous on B.Cu alone (the L_SW bar runs between J1.6 and the left edge on the front). Narrowest PE: front 2.87 mm, back 4.60 mm over the top, 2.08 mm under the slot: at 2 oz about 27 A at 10 °C rise and about 1.5 kA for one cycle before it melts (14 AWG: about 4.6 kA); 2 oz recommended. The routed slot under the PSU is closed (2 mm, both ends full round for the router) and stops 5.5 mm above the bottom edge so the back ring closes under it; every mains copper stays 8 mm from the 5 V side by straight line, so the slot only adds. The inner PE leg beside the PSU is gone; logos on the back. **EU** (`pcb/eu/tools/bars_eu.py`): four straight bars along each pole's pin row (BB_BARS: in bars above their row 3.85 mm, switched below it 2.85 mm L / 1.95 mm N, the latter stopping above RV1), round ends past the outer pin, clear of the 6 mm barrier bosses; short links to F1.1 and to the RV1 / PSU feed. The EU board carries no PE (D-94), so 1 oz is enough. Both: DRC 0 at 3.2 mm, ERC 0, PCBWay packs with the bars' DXF (`<board>_<rev>_bars.dxf`, outlines with the pin holes, mm) and the bars in the BOM as not fitted; `kigen.place_labels` keeps silkscreen labels off solder-mask openings. No inline fuse on these boards: the bars carry the branch circuit's 15 A. Departures for review: L and N load copper on the same (front) side (hard constraint 1 says one side each); standard FR4 instead of high-CTI (hard constraint 3) for these boards. Open: the Marquardt's pin stems (2.8 × 2.8 in our model of its drawing) reach the board at the pads, so a bar under them lifts the rocker by the bar and its solder: check on a sample and in the CAD (the bars are not in the CAD yet), as is the room between the board's front and the barrier; the rocker tab to bar joint is made by solder through the plated slot from the back (the front faces the barrier once the board is fitted). | Human 2026-10-13: "The cost for 5 High-CTI(>=600V) boards is $497.01, it's out of the question"; "I'd use PCBWay cnc service to make the copper bus bars"; "bus bars should be a pretty tight fit around the pins"; "make sure bus bars are only used between Wago and the switch"; "Keep PE on the NA version with the ring"; "No need for a fuse with the bus bar version"; "Add both the bar versions". |
| D-154 | **CN2: Hirose DF40, Apollo's contact map and pin 1.** Apollo confirmed the MSR-2's board connector as a Hirose DF40C-24DS-0.4V(51) receptacle and sent its add-on schematics: J2 on both sensor boards becomes the mating DF40C-24DP-0.4V(51) header (was the assumed Molex 55909-2474). Land pattern from Hirose's DF40 catalog (2012-03, p. 7): contact pads 0.23 × 0.66 at 0.4 (rows 3.37 outside, 2.05 inside, centres ±1.355), 12 a row spanning 4.4, and a 0.35 × 0.66 corner bracket pad 0.3 past each end contact (Apollo's header symbol: pins 25–28, GND; left unnumbered here, Hirose: they carry no current). DS on DP stacks 1.5 mm (catalog p. 3), so `B2B_STACK`, the MSR-2's height and the 1.5 mm spacers stay; `B2B` 7.4 × 3.38 (the receptacle, was 7.9 × 3.4); the header is 6.32 × 2.97 × 1.14. Contact map (`CN2_MAP`): GND 1, 2, 4, 23, 24; SCL = IO0 3; IO7 5; IO6 7; +3V3 9; +5V 10; IO4 13; SDA = IO1 21; IO2 11, IO19 16, IO18 18; the rest open. The add-on's 2 × 6 header listing (IO2, 4, 6, 7, 18, 19, I²C, 3V, 5V, GND) agrees. **Pin 1** (the connector is not polarized): the GPIO add-on's silkscreen triangle marks pin 1 of its header CN4 at the corner nearest the add-on's X; the MSR-2's X sits at CN2's corner towards the board's centre, on the row away from the radar edge. The MSR-2's traces at CN2 (Apollo wiki photo, 4032 px) agree: on that row the contacts 15–19 counted from the X end (3rd–5th from the far end) have no traces, and the other row's traces leave near the far end (IO18 / IO19); with pin 1 at the far end, IO7 / IO6 / +3V3 would sit on those bare contacts. On the sensor boards (room view) pin 1 is the left end of the lower row, the odd contacts along it, +5V on the upper row. I²S on the free GPIOs in the order the lanes reach the ADAU7002 without crossing: SCK = IO7, WS = IO6, SD = IO4 (IO2 is a strapping pin, IO18 / IO19 the USB lines). Fan-out on both boards: I²S down from the lower row, right and on to the microphone's parts (NA: up round the header's right end; EU: down), +3V3 down to a via and on the back between the rows to the parts' +3V3, SCL and SDA down and out past the header's ends to vias, +5V up from the upper row to a via, GND 1 / 2 / 4 and 23 / 24 to two vias between the rows. Both boards ERC / DRC clean; `CN2_CONFIRMED` true, the sensor boards get fab files and PCBWay fits J2 (they stay fit-test prototypes: CN2's position on the MSR-2 is a photo estimate). DF40 contacts are rated 0.3 A each and the MSR-2's +5V comes in on contact 10 alone. DigiKey H11620CT-ND, active, 24,192 in stock (API 2026-10-13). | Human 2026-10-13: Apollo: "On the board side we use DF40C-24DS-0.4V(51)"; their schematics (CN1 DF40C-24DS, add-on CN4 DF40C-24DP) in `scratch/`; "Check the pictures in scratch, they have the pinout for the connector, compare with the datasheet and you'll know which corner holds pin 1". Hirose DF40 catalog in `scratch/sources/datasheets/hirose_df40/`. |
| D-155 | **High-CTI mains boards dropped: the bus-bar boards are the mains boards.** The NA and EU mains boards with the load in board copper on high-CTI FR4 (`na_mains_board`, `eu_mains_board`; D-24, D-102) are out of the design. `na_mains_board_busbar` and `eu_mains_board_busbar` (D-153) are the mains boards of every edition: standard FR4 (material group III), mains spacing 3.2 mm, the load in 0.5 mm copper bars on the front between the terminal blocks and the rocker, NA PE as a ring at 2 oz, EU 1 oz with no PE (D-94). Hard constraint 1 now reads with the bars and hard constraint 3 with 3.2 mm on standard FR4; BOM, ASSEMBLY, the board READMEs and the fab checklists describe one mains board per variant. The dropped boards' generator mode, KiCad projects, fab packs, STEP and renders are still in the tree, the Makefile and the CAD checks still read `na_mains_board.kicad_pcb` for the board positions, and the bus-bar files keep their `_busbar` names: removal and renaming are backlog item 4. | Human 2026-10-14: "We dumped the high-cti version"; the laminate's price (D-153: PCBWay 497.01 for five). |

## Known risks / to verify

- Metal boxes: ears may collide with the pocket; BILRESA Thread signal may drop when recessed.
- Neutral may be missing in switch-loop boxes → PSU can't be fed there.
- BILRESA scroll wheel reportedly laggy/flaky over Matter in HA; test before scaling.
- Concealed emergency switch vs. code expectation of a wall switch: ask inspector.
- Plate is 72 × 132 mm (D-47), 14.4 mm thick (D-51, D-64, D-66); larger than a standard plate.
- The barrier reaches z = −10.8 (rocker panel, `Z_BOT`) with a 45° corner taper to −10 mm, and the mains board with the WAGO block and PSU sits behind it: include both in the box-fill calculation. The taper reaches into the box's opening corners; check against your box ears / device-screw bosses.
- The rocker body closes the panel cutout and is part of the barrier: never energise with the rocker removed.
- The barrier's four standoff bosses (D-57) are tapped M3 by hand: cut the threads square and clear the chips before fitting.
- Elegoo PC-FR V-0 rating thickness unknown until the datasheet is on file.
- Microphone (D-83): the ADAU7002 clocks the mic at 64 × fs; the SPK0641 needs ≥ 1.0 MHz for its
  performance mode (350–800 kHz is its low-power mode), so sample at ≥ 16 kHz. Whether the C3 runs
  the voice pipeline alongside the radar, Wi-Fi and BLE is untested.
- Microphone and ADAU7002 pin 1: the footprints follow the datasheets' top views (SPK0641 example land
  pattern, ADAU7002 ball A1 top left); check against parts before the first assembly order.
- CN2 (D-154): pin 1 comes from Apollo's silkscreen and the MSR-2's traces in photos; check on an MSR-2 (meter
  from contact 10 to the MSR-2's 5 V) before the first sensor board is powered.
- CN2 (D-154): the MSR-2's +5V on one DF40 contact, rated 0.3 A; measure the MSR-2's 5 V current (Wi-Fi
  transmit peaks, radar) before relying on it.
- A microphone in every room: listening is on demand only, but the device can stream audio.
- The two spring-pin holes in the pocket floor (D-50) are barrier openings filled by the pins' barrels: never energise with the pin board or a pin missing.
- The spacer posts carry 5 V on bare metal between the mains board and the pin board; the heatshrink is their only cover. They sit in the SELV area, 8 mm from mains copper, behind the barrier.
- Sensor board: the copper keep-out from the box opening (8 mm along the wall) assumes the board lies flat on the wall; check the plate sits flat on uneven drywall.
