antevens/sladdseg/docs/renders/eu_mains_board_back.png

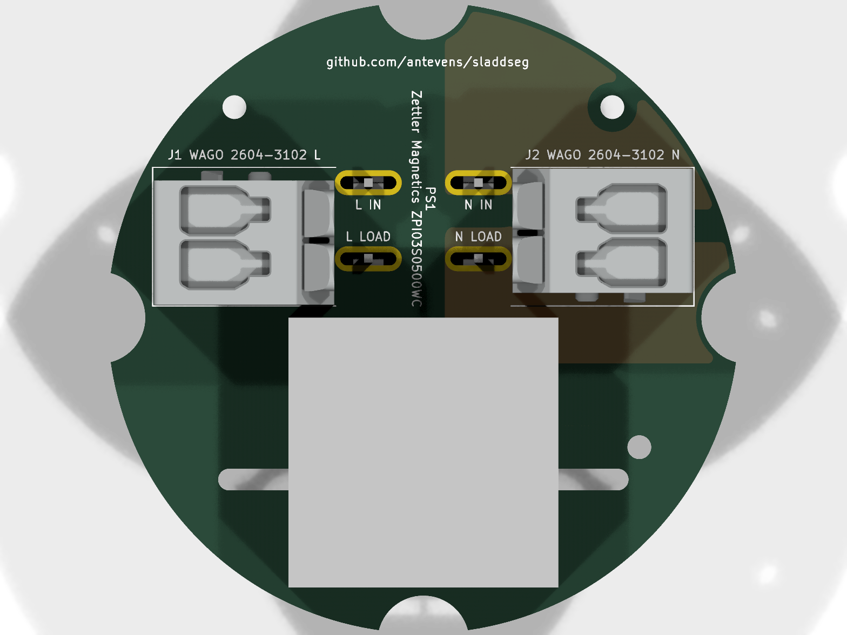
docs/renders/eu_mains_board_back.png
