antevens/sladdseg/docs/renders/eu_mains_board_bare_back.png

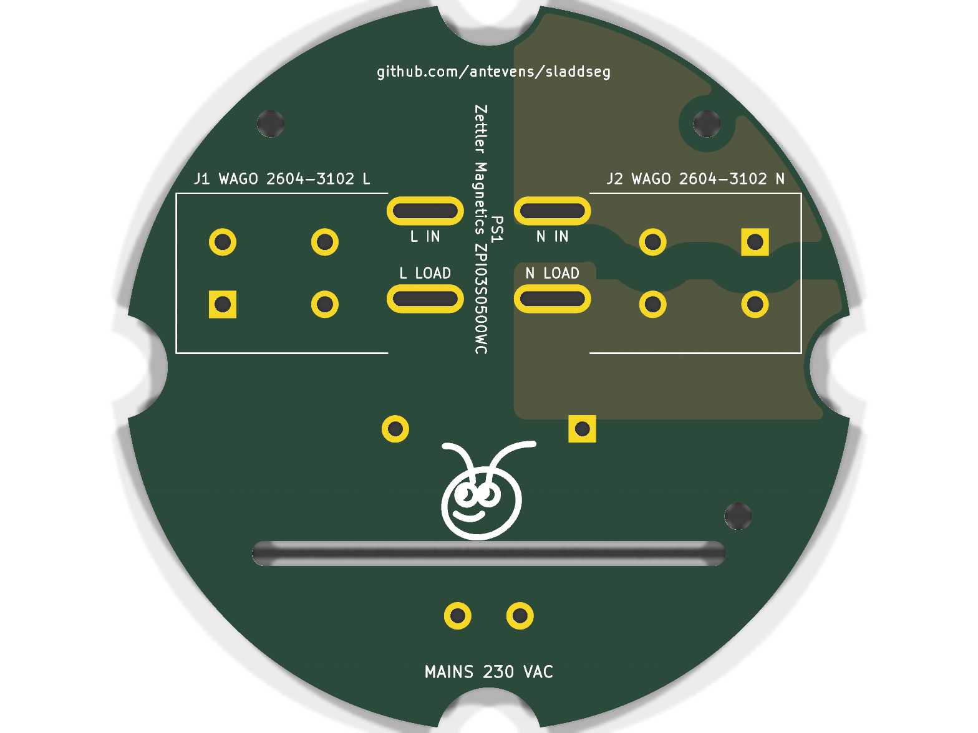
docs/renders/eu_mains_board_bare_back.png
