antevens/sladdseg/docs/renders/eu_mains_board_bare_front.png

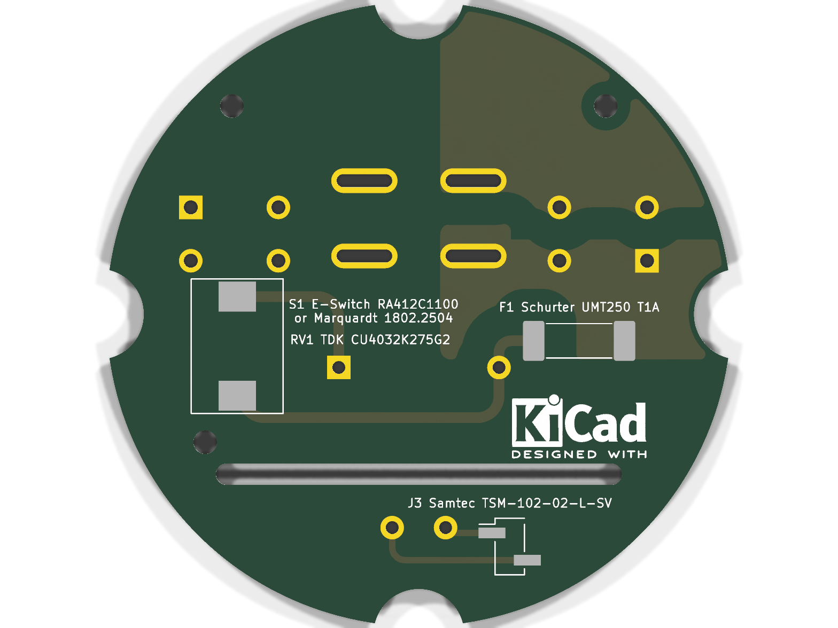
docs/renders/eu_mains_board_bare_front.png
