antevens/sladdseg/docs/renders/eu_mains_board_bare_iso.png

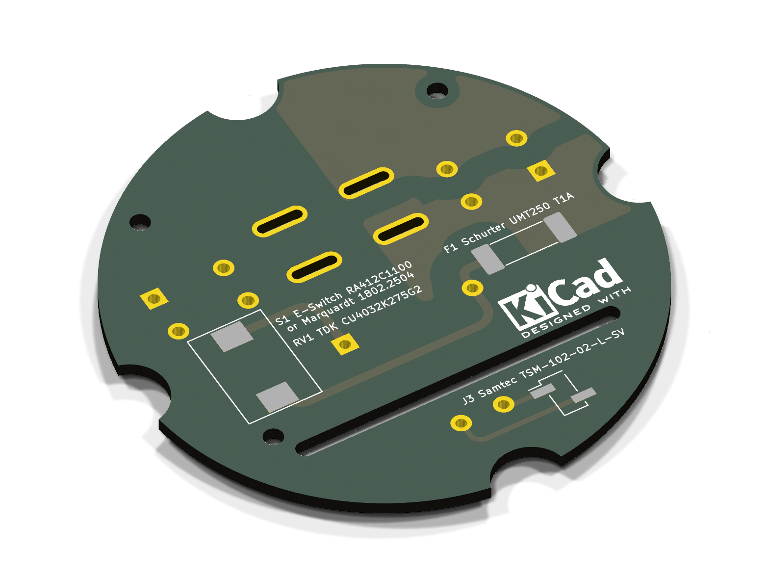
docs/renders/eu_mains_board_bare_iso.png
