antevens/sladdseg/docs/renders/eu_mains_board_copper_back.png

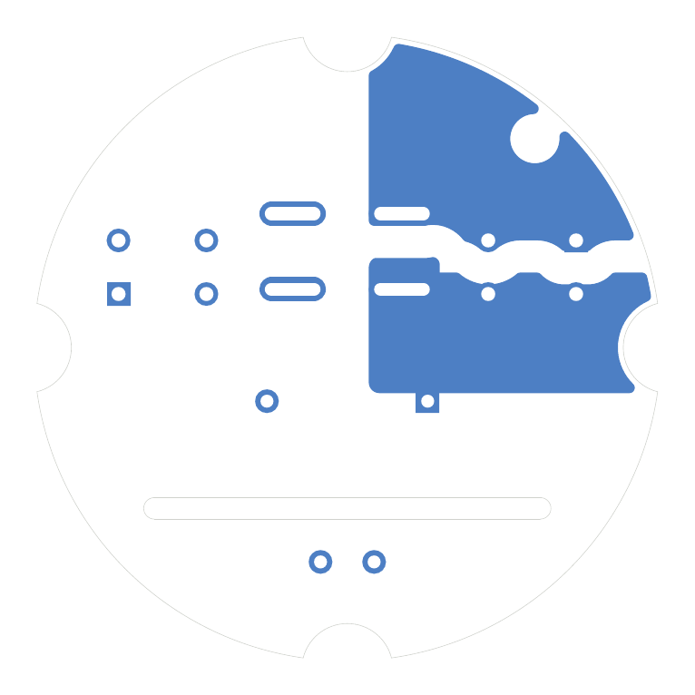
docs/renders/eu_mains_board_copper_back.png
