antevens/sladdseg/docs/renders/eu_mains_board_copper_front.png

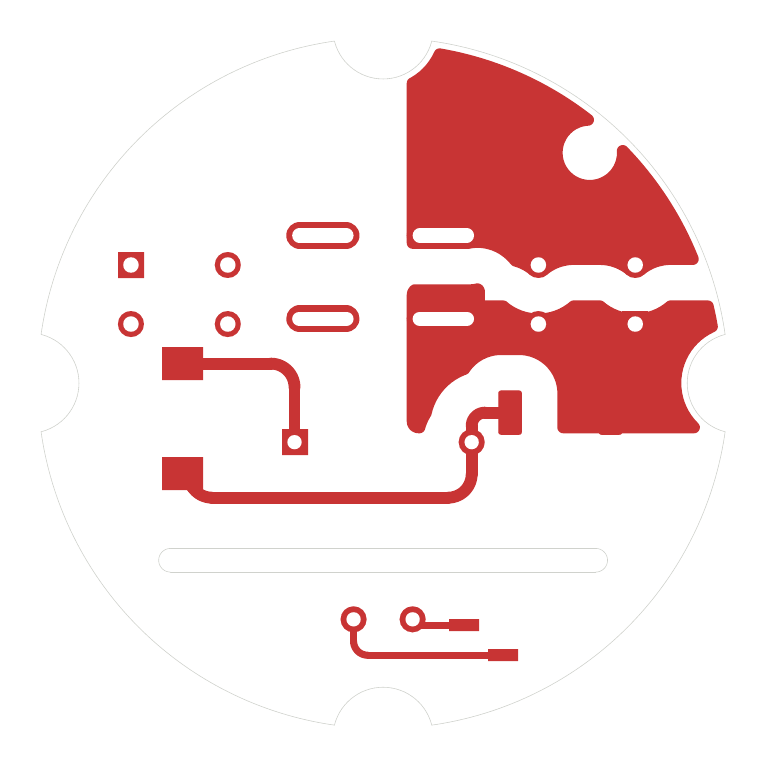
docs/renders/eu_mains_board_copper_front.png
