antevens/sladdseg/docs/renders/eu_mains_board_front.png

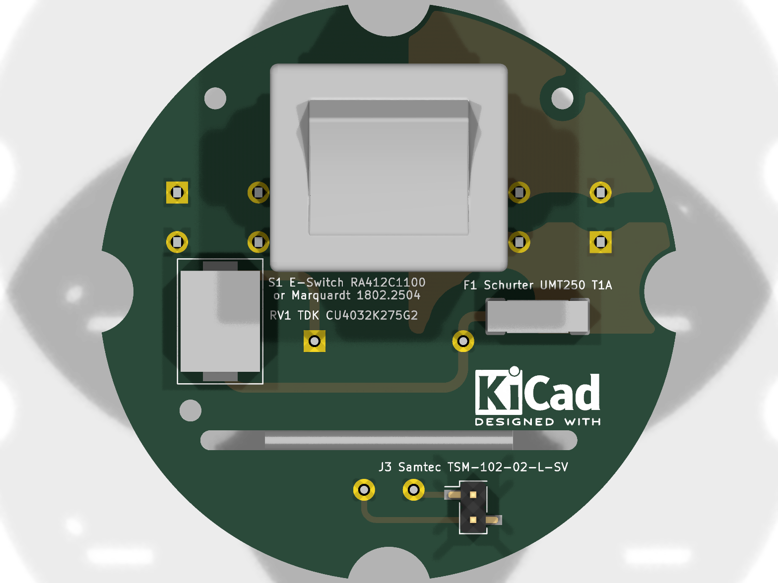
docs/renders/eu_mains_board_front.png
