antevens/sladdseg/docs/renders/na_mains_board_back.png

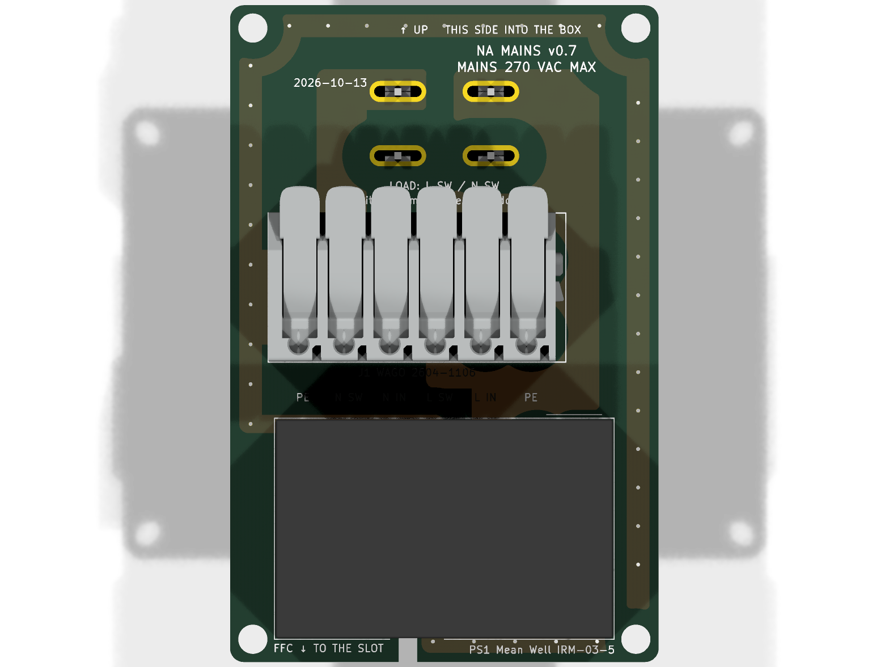
docs/renders/na_mains_board_back.png
