antevens/sladdseg/docs/renders/na_mains_board_bare_back.png

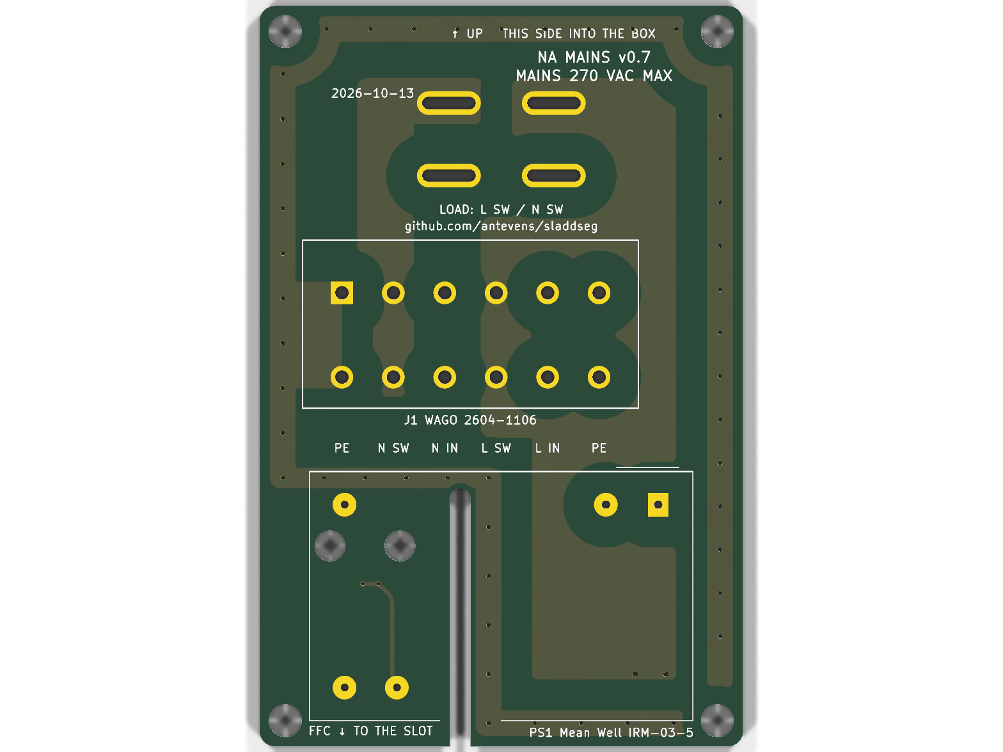
docs/renders/na_mains_board_bare_back.png
