antevens/sladdseg/docs/renders/na_mains_board_bare_front.png

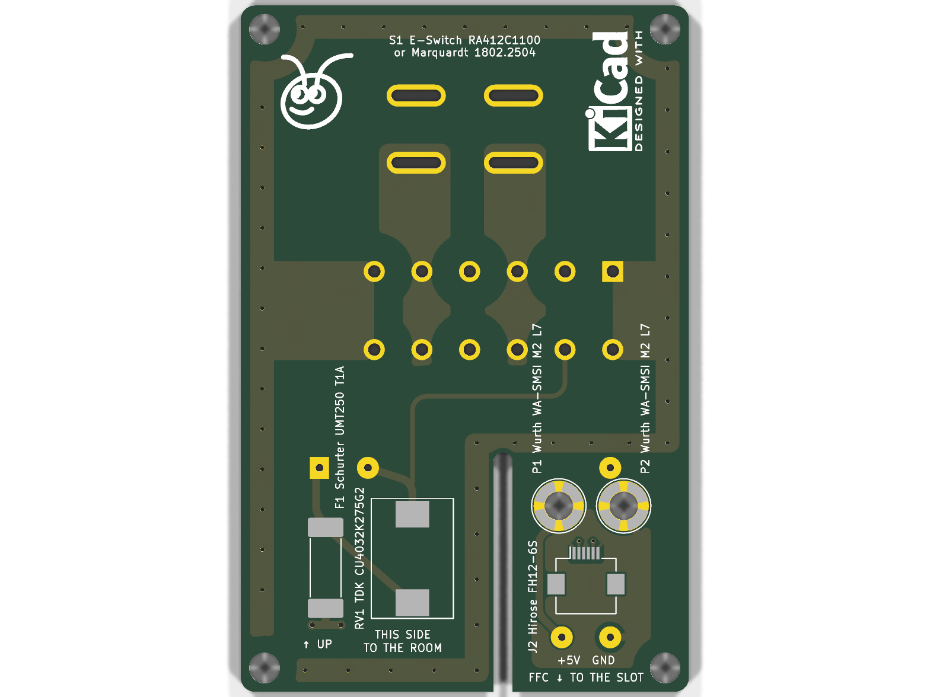
docs/renders/na_mains_board_bare_front.png
