antevens/sladdseg/docs/renders/na_mains_board_bare_iso.png

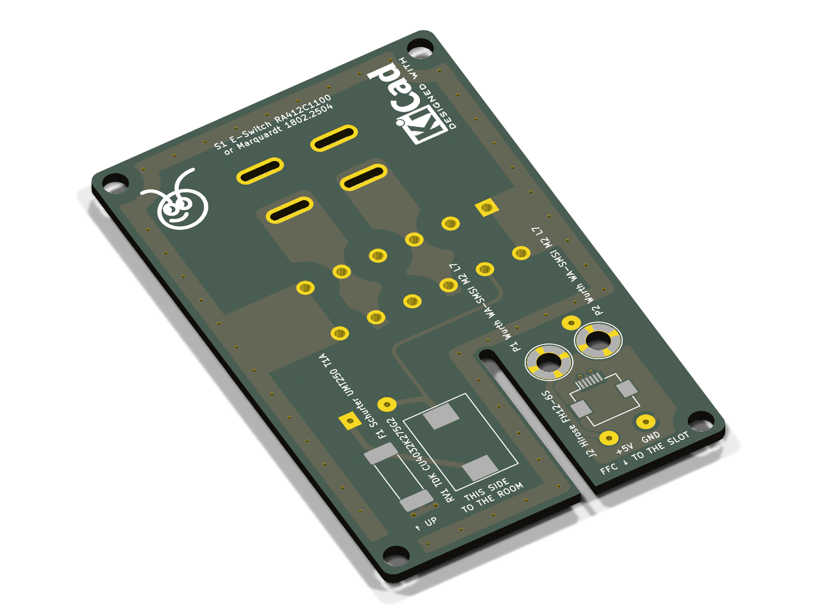
docs/renders/na_mains_board_bare_iso.png
