antevens/sladdseg/docs/renders/na_mains_board_copper_back.png

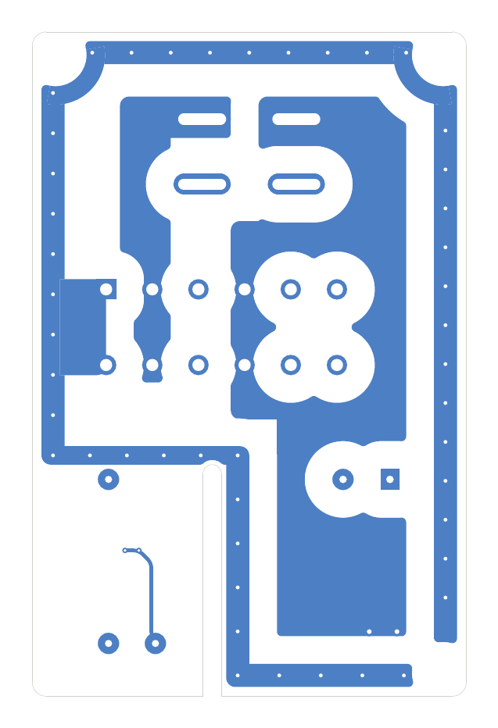
docs/renders/na_mains_board_copper_back.png
