antevens/sladdseg/docs/renders/na_mains_board_copper_front.png

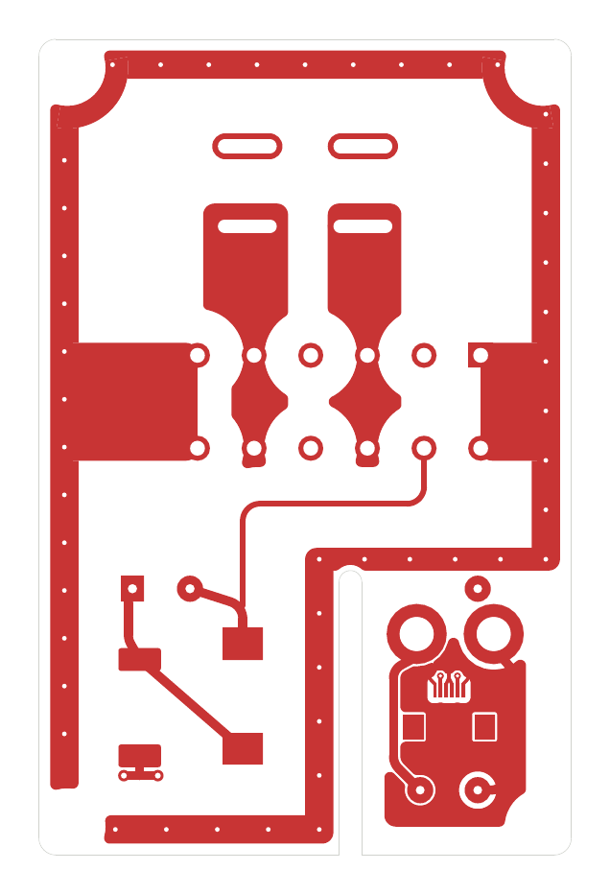
docs/renders/na_mains_board_copper_front.png
