antevens/sladdseg/docs/renders/na_mains_board_front.png

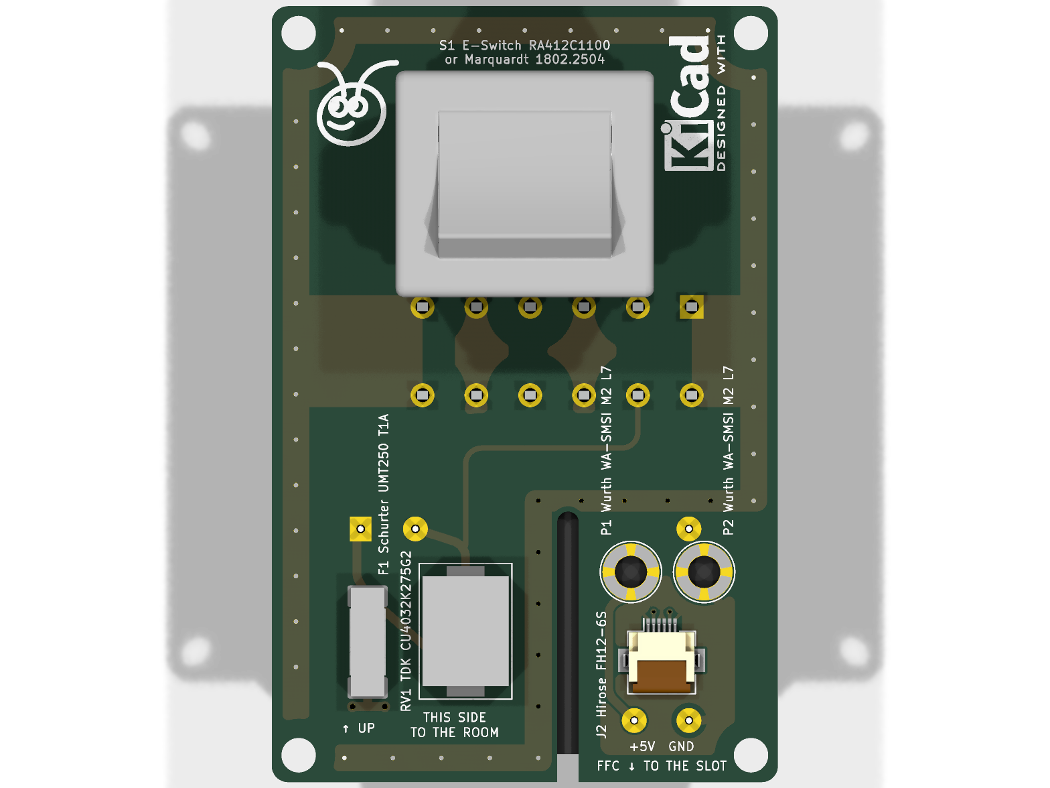
docs/renders/na_mains_board_front.png
