antevens/sladdseg/docs/renders/na_mains_board_iso_back.png

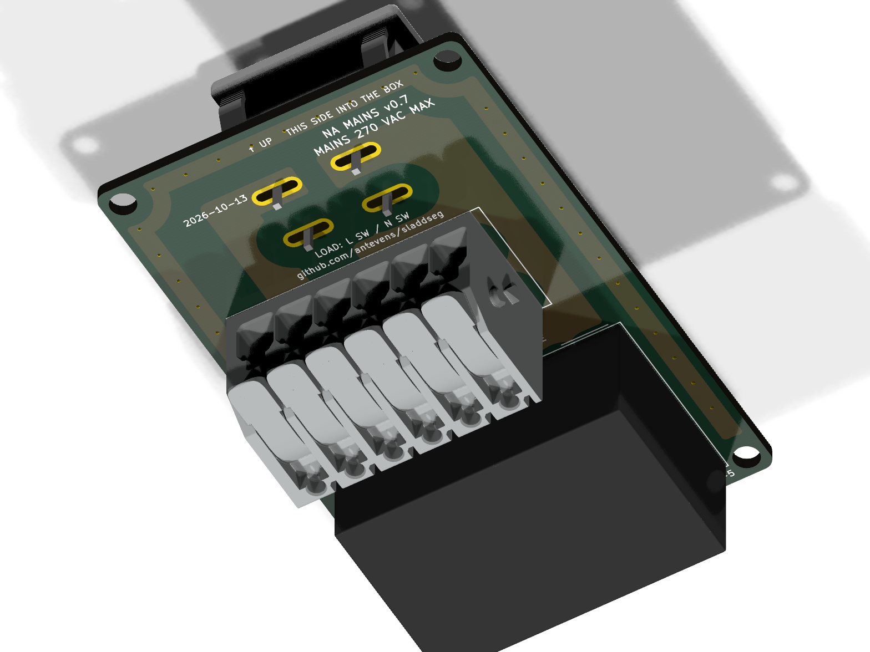
docs/renders/na_mains_board_iso_back.png
