antevens/sladdseg/docs/renders/na_mains_board_iso_front.png

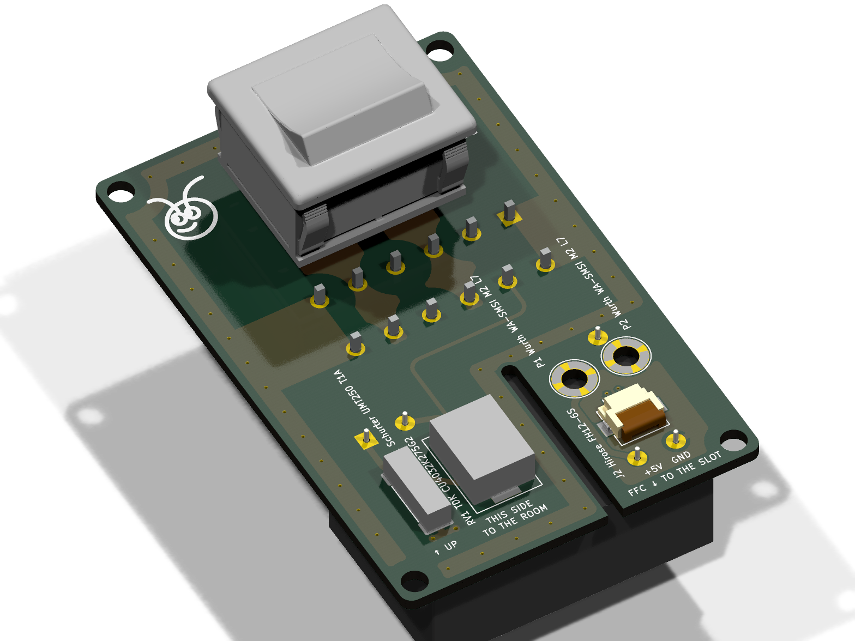
docs/renders/na_mains_board_iso_front.png
