antevens/sladdseg/pcb/order/pcbway/README.md

# PCBWay order

Generated by `make order` (`pcb/tools/order_pcbway.py`): a devkit of each variant, 5 PCBs of every design (PCBWay's minimum; more where both variants use the board) and 5 sets of parts per variant (`make order DEVKIT_SETS=…`), in two options:

- **Option A** (`option_a_pcbway_smt/`): PCBWay makes the boards and fits the SMD parts (turnkey, they source the parts). You solder the THT parts and the rockers.
- **Option B** (`option_b_self_solder/`): PCBWay makes bare boards; you buy every part and solder everything.

Do the human reviews in `pcb/na/fab/README.md` and `pcb/eu/fab/README.md` (fuse rating, isolation, thermal, approvals) before ordering the mains boards. Nothing here is a compliance claim.

**Prototypes.** The sensor board, the EU sensor board and the back cover flex are not confirmed yet; their files are named `_PROTOTYPE` and are for fit tests only:

- na_sensor_board: FIT-TEST PROTOTYPE: J2 is the Molex 55909-2474 plug for the MSR-2's CN2 (D-82) on Molex's land pattern (D-89), but its pin 1 and contact map are placeholders until Apollo's pinout is in hand: the MSR-2's signals will not line up. PCBWay does not fit J2.
- eu_sensor_board: FIT-TEST PROTOTYPE: J2 is the Molex 55909-2474 plug for the MSR-2's CN2 (D-82) on Molex's land pattern (D-89), but its pin 1 and contact map are placeholders until Apollo's pinout is in hand: the MSR-2's signals will not line up. PCBWay does not fit J2.
- cover_flex: FIT-TEST PROTOTYPE: pad, contact and regulator positions come from photos and drawings (REF / MEASURE) until measured on a remote.

## Boards

| Board | Plates | PCBs to order | Size | Copper / thickness | Finish | PCBWay fits (option A) | You fit (option A) |
| --- | --- | --- | --- | --- | --- | --- | --- |
| na_mains_board | 5 (NA) | 5 (assemble 5) | 47.0 × 72.0 mm | 2 layers FR4 / 1.60 mm | HASL lead-free or ENIG | F1, RV1, P1, P2, J2 | S1, J1, PS1 |
| na_pin_board | 5 (NA) | 5 (assemble 5) | 14.1 × 12.1 mm | 2 layers FR4 / 0.80 mm | ENIG | J1, J2 | - |
| eu_mains_board | 5 (EU) | 5 (assemble 5) | 58.0 × 58.0 mm | 2 layers FR4 / 1.60 mm | HASL lead-free or ENIG | F1, RV1, J3 | S1, J1, J2, PS1 |
| eu_pin_board | 5 (EU) | 5 (assemble 5) | 58.0 × 27.9 mm | 2 layers FR4 / 1.60 mm | ENIG | C1, P1, P2, P3, P4 | J1 |
| na_sensor_board (prototype) | 5 (NA) | 5 (assemble 5) | 66.4 × 125.9 mm | 2 layers FR4 / 1.60 mm | ENIG | J1, C1, U1, C2, MK1, U2, C4, R1, C3, H1, H2, H3 | - (not fitted: J2) |
| eu_sensor_board (prototype) | 5 (EU) | 5 (assemble 5) | 76.0 × 113.8 mm | 2 layers FR4 / 1.60 mm | ENIG | C1, MK1, U2, C4, R1, C3, U1, C2, H5, H6, H7 | - (not fitted: J2) |
| cover_flex (prototype) | 10 (NA, EU) | 10 (assemble 10) | 29.7 × 30.1 mm | 1 layer flex / 0.10 mm | ENIG | J3, J4, U1, C3, C4, D1 | - |

Order settings common to the rigid boards: FR4 TG150 or standard (the two mains boards: high-CTI FR4, see their notes), 1 oz copper (see the mains board's note), green solder mask and white silkscreen both sides, no impedance control, no V-cut. Gerbers are RS-274X with Excellon drills in mm; Gerbers, drills and centroid share the board's drill / aux origin.

Per board (add to the order remarks):

- **na_mains_board** (`na_mains_board_v0.7_gerbers.zip`): Routed isolation slot in the outline (Edge.Cuts), 5 mm wide from the bottom edge up under PS1: do not omit; Copper weight 1 oz as designed; 2 oz is the option under thermal review (pcb/na/fab/README.md); Four 3.2 mm unplated mounting holes; Laminate: high-CTI FR4, CTI >= 600 V (PLC 0, IEC 60664-1 material group I): the mains spacing targets assume it (D-102).
- **na_pin_board** (`na_pin_board_v0.7_gerbers.zip`): 0.8 mm FR4; Two plated 2.2 mm holes for the M2 screws (P1, P2) and plated 1.2 mm holes for the spring pins' pegs; Small board: let PCBWay panelize it for assembly.
- **eu_mains_board** (`eu_mains_board_v0.7_gerbers.zip`): Routed relief slot under the PSU in the outline (Edge.Cuts): do not omit; Mains board: do the review in pcb/eu/fab/README.md before ordering; Laminate: high-CTI FR4, CTI >= 600 V (PLC 0, IEC 60664-1 material group I): the mains spacing targets assume it (D-102).
- **eu_pin_board** (`eu_pin_board_v0.7_gerbers.zip`): Plated 1.2 mm holes for the spring pins' pegs.
- **na_sensor_board** (`na_sensor_board_v0.7_PROTOTYPE_gerbers.zip`): Copper keeps 8 mm from the box opening (do not let PCBWay add copper fill there); Fit test: outline, crush-rib window, spacers H1-H3, SHT40, FFC connector J1; microphone MK1 and the ADAU7002 U2 (WLCSP 0.4 mm pitch: order this board with PCBWay assembly, option A, either way).
- **eu_sensor_board** (`eu_sensor_board_v0.7_PROTOTYPE_gerbers.zip`): Closed snap windows at the corners (routed cut-outs inside the outline): do not omit; Fit test: outline, snap windows, screws, spacers H5-H7, SHT40, sensor pin pads; microphone MK1 and the ADAU7002 U2 (WLCSP 0.4 mm pitch: order this board with PCBWay assembly, option A, either way).
- **cover_flex** (`cover_flex_v0.7_PROTOTYPE_gerbers.zip`): FLEX PCB: one copper layer (F.Cu), polyimide, 0.10 mm thick without stiffeners (PCBWay's default), 1/2 oz copper, yellow coverlay, ENIG; no holes (no drill files); Coverlay openings as F_Mask: 0.1 mm beyond the pads; one opening over each pin row of U1 / D1; the two 3.0 mm pin pads open 2.6 mm (the coverlay holds their edges); FR4 stiffeners on the bottom (non-copper) side: 0.8 mm on the pad and regulator sections, 0.4 mm on the end section (notched round the run); outlines on the User_1 Gerber and the fab drawing; One 90 deg bend in the run, inside r 0.6 mm, copper outside, installed once: bend zone marked on the fab drawing, no stiffener or track turn within it.

## Option A: PCB + SMD assembly by PCBWay

Per board in `option_a_pcbway_smt/<board>/`: the Gerber zip, `<board>_pcbway_bom.csv`, `<board>_pcbway_centroid.csv`, the assembly or fab drawings.

1. pcbway.com → PCB Assembly → Turnkey (the cover flex: Flex PCB with assembly). Upload the Gerber zip and fill the board settings from the table.
2. Assembly: SMT only, the sides the centroid lists; the quantity to assemble is the plate count (column "PCBs to order").
3. Upload the BOM and the centroid. The BOM lists only the SMD parts PCBWay fits; THT parts, the rockers and the prototypes' placeholder CN2 mates are not in it (do not fit). Safety-critical parts (F1, RV1) must be the listed MPN: no substitutes without review.
4. Add the board's notes above to the order remarks.
5. Buy the rest from DigiKey or Mouser: `parts_digikey.csv` / `parts_mouser.csv` (the lines marked NOT AT … go to the other distributor), imported as described in `pcb/order/README.md`. They hold the THT parts, the rockers and the parts not on a board (NA: studs, standoffs, FFC; EU: the PE lever connector).

## Option B: bare boards, you solder

Per board in `option_b_self_solder/<board>/`: the Gerber zip (the prototypes also their fab drawing).

1. pcbway.com → PCB Instant Quote (the cover flex: Flex PCB). Upload the Gerber zip, fill the board settings from the table.
2. Optional: add a stencil (framework-less, top) for the boards with SMD parts: the paste layers are in the Gerbers. The microphone (LGA), the SHT40 (DFN), the WA-SMSI posts and spacers and the P70 spring pins are reflow parts (hot plate or hot air with paste). The ADAU7002 (WLCSP-8, 0.4 mm pitch) is not a hand part: order the sensor board and the EU sensor board with PCBWay assembly (option A) even here.
3. Buy every part: `parts_digikey.csv` / `parts_mouser.csv` (the lines marked NOT AT … go to the other distributor).

## Quantities

Part quantities are exactly 5 sets per variant, no spares (`pcb/order/README.md`). PCBWay's minimum is 5 boards per design; the spare board costs little and covers a failed assembly.
