antevens/sladdseg/pcb/order/devkit_digikey.csv

Digi-Key Part Number | Manufacturer Part Number | Manufacturer | Quantity | Customer Reference | Description
EG5628-ND | RA412C1100 | E-Switch | 10 | WP EU NA S1 | Rocker switch DPST, 4.8 mm tabs into the slots, UL/cUL 16 A 125 VAC and 10 A 250 VAC, (1/plate NA, 1/plate EU; NA mains board S1; EU mains board S1)
 | 2604-1106 | WAGO | 5 | WP NA J1 | PCB terminal block, push-in, lever, 6-pole, 5 mm pitch, 4 mm2 / 12 AWG, entry parallel to (1/plate NA; NA mains board J1)
1866-3020-ND | IRM-03-5 | Mean Well | 5 | WP NA PS1 | AC-DC module 85-305 VAC in, 5 V 600 mA, 37x24x15 mm (1/plate NA; NA mains board PS1)
 | 3403.0166.11 | Schurter | 10 | WP EU NA F1 | SMD fuse UMT 250, time-lag 1 A 250 VAC (1/plate NA, 1/plate EU; NA mains board F1; EU mains board F1)
495-1467-1-ND | B72660M0271K093 | TDK | 10 | WP EU NA RV1 | SMD varistor SIOV-CU4032K275G2K1, 275 VAC (1/plate NA, 1/plate EU; NA mains board RV1; EU mains board RV1)
 | 9774070243R | Wurth Elektronik | 10 | WP NA P1 | SMT steel spacer, internal thread M2, 7 mm, tin (2/plate NA; NA mains board P1; NA mains board P2)
HFJ106CT-ND | FH12-6S-0.5SH(55) | Hirose | 10 | WP NA J2 | FPC connector 0.5 mm, 6 contacts, slide lock (2/plate NA; NA mains board J2; NA sensor board J1)
399-12290-1-ND | C1206C226M4PACTU | KEMET | 15 | WP EU NA C1 | Ceramic 22 uF 16 V X5R 1206 at J1, 1.8 mm max (1/plate NA, 2/plate EU; NA sensor board C1; EU pin board C1; EU sensor board C1)
WM3787CT-ND | 55909-2474 | Molex | 10 | WP EU NA J2 | SlimStack plug 24 contacts, 0.4 mm, 2 rows, mating the MSR-2's CN2 (1/plate NA, 1/plate EU; NA sensor board J2; EU sensor board J2)
1649-SHT40-AD1B-R2CT-ND | SHT40-AD1B-R2 | Sensirion | 10 | WP EU NA U1 | Humidity and temperature sensor, I2C 0x44 (1/plate NA, 1/plate EU; NA sensor board U1; EU sensor board U1)
490-6328-1-ND | GRM155R71C104KA88J | Murata | 20 | WP EU NA C2 | Ceramic 100 nF 16 V X7R 0402 (2/plate NA, 2/plate EU; NA sensor board C2; NA sensor board C4; EU sensor board C4; EU sensor board C2)
6017-SPK0641HT4H-1CT-ND | SPK0641HT4H-1 | Knowles | 10 | WP EU NA MK1 | PDM MEMS microphone, top port, 1.6-3.6 V; SELECT low (1/plate NA, 1/plate EU; NA sensor board MK1; EU sensor board MK1)
505-ADAU7002ACBZ-R7CT-ND | ADAU7002ACBZ-R7 | Analog Devices | 10 | WP EU NA U2 | Stereo PDM to I2S converter, WLCSP-8 0.4 mm; CONFIG high = I2S (1/plate NA, 1/plate EU; NA sensor board U2; EU sensor board U2)
311-100KLRCT-ND | RC0402FR-07100KL | Yageo | 10 | WP EU NA R1 | Resistor 100 kOhm 1 % 0402 (1/plate NA, 1/plate EU; NA sensor board R1; EU sensor board R1)
490-GRM3195C1H104JA05DCT-ND | GRM3195C1H104JA05D | Murata | 10 | WP EU NA C3 | Microphone decoupling, C0G 50 V 1206 (1/plate NA, 1/plate EU; NA sensor board C3; EU sensor board C3)
 | 9774015243R | Wurth Elektronik | 30 | WP EU NA H1 | SMT steel spacer M2, 1.5 mm, tin (3/plate NA, 3/plate EU; NA sensor board H1; NA sensor board H2; NA sensor board H3; EU sensor board H5; EU sensor board H6; EU sensor board H7)
952-3124-ND | P70-2200045 | Harwin | 30 | WP EU NA J1 | SMT spring pin with peg, 2 A, gold (2/plate NA, 4/plate EU; NA pin board J1; NA pin board J2; EU pin board P1; EU pin board P2; EU pin board P3; EU pin board P4)
952-1734-1-ND | S7081-42R | Harwin | 20 | WP EU NA J3 | SMT spring finger, gold, 4 A, working height 2.0 mm (2/plate NA, 2/plate EU; NA cover flex J3; NA cover flex J4; EU cover flex J3; EU cover flex J4)
296-50411-1-ND | TLV75533PDBVR | Texas Instruments | 10 | WP EU NA U1 | LDO 3.3 V 500 mA, 1.45-5.5 V in, SOT-23-5 (1/plate NA, 1/plate EU; NA cover flex U1; EU cover flex U1)
1276-1034-1-ND | CL10A105KO8NNNC | Samsung Electro-Mechanics | 20 | WP EU NA C3 | LDO input capacitor, 1 uF 16 V X5R 0603 (2/plate NA, 2/plate EU; NA cover flex C3; NA cover flex C4; EU cover flex C3; EU cover flex C4)
296-TPD1E10B06DYARCT-ND | TPD1E10B06DYAR | Texas Instruments | 10 | WP EU NA D1 | ESD protection, bidirectional TVS, 5.5 V working, SOD-523 (1/plate NA, 1/plate EU; NA cover flex D1; EU cover flex D1)
 | 971100244 | Wurth Elektronik | 10 | WP NA ST1 | Brass spacer stud M2 male-female, 10 mm, 4 mm hex (2/plate NA; NA mechanical ST1; NA mechanical ST2)
36-25503-ND | 25503 | Keystone | 20 | WP NA SO1 | Nylon M3 male-female hex standoff, 15 mm, 5.0 mm hex (4/plate NA; NA mechanical SO1; NA mechanical SO2; NA mechanical SO3; NA mechanical SO4)
2073-05-06-A-0050-A-4-06-4-G-ND | 05-06-A-0050-A-4-06-4-G | GCT | 5 | WP NA W1 | FFC 0.5 mm, 6 contacts, 50 mm, Type 1 (1/plate NA; NA mechanical W1)
 | 2604-3102 | WAGO | 10 | WP EU J1 | PCB terminal block, push-in, 2-pole, 4 mm2, entry 90 deg to the PCB, 400 V III/2 (2/plate EU; EU mains board J1; EU mains board J2)
3388-ZPI03S0500WC-ND | ZPI03S0500WC | Zettler Magnetics | 5 | WP EU PS1 | AC-DC module 90-264 VAC in, 5 V 600 mA, 25x25x16 mm, I/P-O/P 3600 VAC, UL/EN 62368-1 (1/plate EU; EU mains board PS1)
SAM10268-ND | TSM-102-02-L-SV | Samtec | 5 | WP EU J3 | SMT pin header 1x2, 2.54 mm, 8.13 mm post, gold on post (1/plate EU; EU mains board J3)
612-SSW-102-01-G-S-ND | SSW-102-01-G-S | Samtec | 5 | WP EU J1 | 5 V from the mains board's header (1/plate EU; EU pin board J1)
2946-221-412-ND | 221-412 | WAGO | 5 | WP EU PE1 | Lever splicing connector, 2 conductors, 0.2-4 mm2 (1/plate EU; EU mechanical PE1)
