antevens/sladdseg/pcb/eu/fab/eu_mains_board/eu_mains_board_v0.7_bom.csv

Item | Designator | Qty | Manufacturer | Manufacturer Part Number | Description/Value | Package/Footprint | Layer | Datasheet | Notes
1 | S1 | 0 | Marquardt | 1802.2504 | 1802.2504 - Rocker switch DPST, ENEC 12(4) A 250 V~, UL/CSA 15 A 125-250 VAC, PCB pins: emergency off (line and neutral of the load) | Rocker_DPST_Marquardt_1802.2504_E-Switch_RA412C1100 | Top | Marquardt drawing 1802.2504 rev g, 2003-09-16 (K-drawing 18022504.03) | Do not fit. Soldered by hand after the rocker is snapped into the printed barrier
2 | J1 | 1 | WAGO | 2604-3102 | 2604-3102 - PCB terminal block, push-in, 2-pole, 4 mm2, entry 90 deg to the PCB, 400 V III/2: house line in, switched line to the load | WAGO_2604-3102_1x02_P5.00mm_Vertical | Bottom | https://www.wago.com/global/pcb-terminal-blocks-and-pluggable-connectors/pcb-terminal-block/p/2604-3102 | Safety-critical, do not substitute. Back (B) side, levers towards the board centre
3 | J2 | 1 | WAGO | 2604-3102 | 2604-3102 - PCB terminal block, push-in, 2-pole, 4 mm2, entry 90 deg to the PCB, 400 V III/2: house neutral in, switched neutral to the load | WAGO_2604-3102_1x02_P5.00mm_Vertical | Bottom | https://www.wago.com/global/pcb-terminal-blocks-and-pluggable-connectors/pcb-terminal-block/p/2604-3102 | Safety-critical, do not substitute. Back (B) side, levers towards the board centre
4 | F1 | 1 | Schurter | 3403.0166.11 | T1A 250V - SMD fuse UMT 250, time-lag 1 A 250 VAC (Zettler's application circuit shows 0.5 A / 250 V: review, D-100) | Fuse_Schurter_UMT250 | Top | https://us.schurter.com/bundles/snceschurter/epim/_ProdPool_/newDS/en/typ_UMT_250.pdf | T1A 250 V; Zettler's application circuit shows 0.5 A / 250 V for the ZPI03 - confirm before ordering (D-100)
5 | RV1 | 1 | TDK | B72660M0271K093 | CU4032K275G2 - SMD varistor SIOV-CU4032K275G2K1, 275 VAC | Varistor_TDK_CU4032 | Top | https://www.farnell.com/datasheets/2921094.pdf | Safety-critical, do not substitute without review
6 | PS1 | 1 | Zettler Magnetics | ZPI03S0500WC | ZPI03S0500WC - AC-DC module 90-264 VAC in, 5 V 600 mA, 25x25x16 mm, I/P-O/P 3600 VAC, UL/EN 62368-1 (D-100) | Converter_ACDC_Zettler_ZPI03_THT | Bottom | https://www.zettlermagnetics.com/media/pdfs/magnetics/datasheets/ZPI03SXX00WC.pdf | Safety-critical, do not substitute. Back (B) side over the routed relief slot, sit flush
7 | J3 | 1 | Samtec | TSM-102-02-L-SV | TSM-102-02-L-SV - SMT pin header 1x2, 2.54 mm, 8.13 mm post, gold on post: 5 V to the pin board's pin socket (5 V island) | PinHeader_1x02_P2.54mm_Vertical_SMD_Pin1Left | Top | https://suddendocs.samtec.com/catalog_english/tsm.pdf | SMT header on the 5 V island (no pin tails under the PSU)
