antevens/sladdseg/pcb/eu/fab/eu_pin_board/eu_pin_board_v0.7_bom.csv

Item | Designator | Qty | Manufacturer | Manufacturer Part Number | Description/Value | Package/Footprint | Layer | Datasheet | Notes
1 | J1 | 1 | Samtec | SSW-102-01-G-S | Socket 1x2 2.54 - 5 V from the mains board's header (5 V island) | PinSocket_1x02_P2.54mm_Vertical | Bottom | https://suddendocs.samtec.com/catalog_english/ssw.pdf | THT socket on the back (B), mates the mains board's J3 (Samtec TSM): confirm 8.51 mm body (SOCKET)
2 | C1 | 1 | KEMET | C1206C226M4PACTU | 22uF 16V X5R - Ceramic 22 uF 16 V X5R 1206, 1.8 mm max | C_1206_3216Metric | Top | https://yageogroup.com/content/datasheet/asset/file/KEM_C1006_X5R_SMD
3 | P1 | 1 | Harwin | P70-2200045 | P70-2200045 GND - Spring pin with peg, 2 A: GND to the sensor board's pad through the barrier | Harwin_P70-2200045 | Top | https://content.harwin.com/asset/7e702b12-8f84-42b5-9282-d7e22f3466f3/DRG-02624-Technical-Drawing-Datasheet-P70-220-pdf.pdf | SMT spring pin, front (F), peg into the 1.2 mm hole
4 | P2 | 1 | Harwin | P70-2200045 | P70-2200045 +5V - Spring pin with peg, 2 A: +5 V to the sensor board's pad through the barrier | Harwin_P70-2200045 | Top | https://content.harwin.com/asset/7e702b12-8f84-42b5-9282-d7e22f3466f3/DRG-02624-Technical-Drawing-Datasheet-P70-220-pdf.pdf | SMT spring pin, front (F), peg into the 1.2 mm hole
5 | P3 | 1 | Harwin | P70-2200045 | P70-2200045 +5V - Spring pin with peg, 2 A: +5V onto the back cover's pad through the barrier | Harwin_P70-2200045 | Top | https://content.harwin.com/asset/7e702b12-8f84-42b5-9282-d7e22f3466f3/DRG-02624-Technical-Drawing-Datasheet-P70-220-pdf.pdf | SMT spring pin, front (F), peg into the 1.2 mm hole
6 | P4 | 1 | Harwin | P70-2200045 | P70-2200045 GND - Spring pin with peg, 2 A: GND onto the back cover's pad through the barrier | Harwin_P70-2200045 | Top | https://content.harwin.com/asset/7e702b12-8f84-42b5-9282-d7e22f3466f3/DRG-02624-Technical-Drawing-Datasheet-P70-220-pdf.pdf | SMT spring pin, front (F), peg into the 1.2 mm hole
