antevens/sladdseg/pcb/na/fab/na_mains_board/na_mains_board_v0.7_bom.csv

Item | Designator | Qty | Manufacturer | Manufacturer Part Number | Description/Value | Package/Footprint | Layer | Datasheet | Notes
1 | S1 | 0 | Marquardt | 1802.2504 | 1802.2504 - Rocker switch DPST, ENEC 12(4) A 250 V~, UL/CSA 15 A 125-250 VAC, PCB pins, emergency off (line and neutral) | Rocker_DPST_Marquardt_1802.2504_E-Switch_RA412C1100 | Top | Marquardt drawing 1802.2504 rev g, 2003-09-16 (K-drawing 18022504.03) | Do not fit. Soldered by hand after the rocker is snapped into the printed barrier
2 | J1 | 1 | WAGO | 2604-1106 | 2604-1106 - PCB terminal block, push-in, lever, 6-pole, 5 mm pitch, 4 mm2 / 12 AWG, entry parallel to PCB | WAGO_2604-1106_1x06_P5.00mm_Horizontal | Bottom | https://www.wago.com/global/pcb-terminal-blocks-and-pluggable-connectors/pcb-terminal-block/p/2604-1106 | Safety-critical, do not substitute. Back (B) side, wire entries face the board's top edge
3 | PS1 | 1 | Mean Well | IRM-03-5 | IRM-03-5 - AC-DC module 85-305 VAC in, 5 V 600 mA, 37x24x15 mm | Converter_ACDC_MeanWell_IRM-03-xx_THT | Bottom | https://www.meanwell.com/Upload/PDF/IRM-03/IRM-03-SPEC.PDF | Safety-critical, do not substitute. Back (B) side, sit flush on the board
4 | F1 | 1 | Schurter | 3403.0166.11 | T1A 250V - SMD fuse UMT 250, time-lag 1 A 250 VAC. Rating is a designer's choice: human review | Fuse_Schurter_UMT250 | Top | https://us.schurter.com/bundles/snceschurter/epim/_ProdPool_/newDS/en/typ_UMT_250.pdf | Rating T1A is the designer's choice (Mean Well gives none) - confirm before ordering
5 | RV1 | 1 | TDK | B72660M0271K093 | CU4032K275G2 - SMD varistor SIOV-CU4032K275G2K1, 275 VAC | Varistor_TDK_CU4032 | Top | https://www.farnell.com/datasheets/2921094.pdf | Safety-critical, do not substitute without review
6 | P1 | 1 | Wurth Elektronik | 9774070243R | +5V post - SMT steel spacer, internal thread M2, 7 mm, tin: +5V to the pin board (D-50, D-59) | Wurth_WA-SMSI_M2_SMT_Spacer_L7mm | Top | https://www.we-online.com/catalog/datasheet/9774070243R.pdf
7 | P2 | 1 | Wurth Elektronik | 9774070243R | GND post - SMT steel spacer, internal thread M2, 7 mm, tin: GND to the pin board (D-50, D-59) | Wurth_WA-SMSI_M2_SMT_Spacer_L7mm | Top | https://www.we-online.com/catalog/datasheet/9774070243R.pdf
8 | J2 | 1 | Hirose | FH12-6S-0.5SH(55) | 5V out (FFC to the sensor board) - FPC connector 0.5 mm, 6 contacts, slide lock: 5 V to the sensor board FFC (D-50) | Hirose_FH12-6S-0.5SH_1x06-1MP_P0.50mm_Horizontal | Top | https://www.hirose.com/product/en/products/FH12/FH12-6S-0.5SH(55)/
