antevens/sladdseg/pcb/order/pcbway/option_a_pcbway_smt/cover_flex/cover_flex_pcbway_bom.csv

Item # | Designator | Qty | Manufacturer | Mfg Part # | Description / Value | Package/Footprint | Type | Your Instructions / Notes
1 | J3,J4 | 2 | Harwin | S7081-42R | S7081-42R VBAT - SMT spring finger, gold, 4 A, working height 2.0 mm | Harwin_S7081-42R | SMD | Source this MPN exactly
2 | U1 | 1 | Texas Instruments | TLV75533PDBVR | TLV75533PDBVR - LDO 3.3 V 500 mA, 1.45-5.5 V in, SOT-23-5 | SOT-23-5 | SMD | Source this MPN exactly
3 | C3,C4 | 2 | Samsung Electro-Mechanics | CL10A105KO8NNNC | 1uF 16V X5R 0603 - LDO input capacitor, 1 uF 16 V X5R 0603 | C_0603_1608Metric | SMD | Source this MPN exactly
4 | D1 | 1 | Texas Instruments | TPD1E10B06DYAR | TPD1E10B06DYAR - ESD protection, bidirectional TVS, 5.5 V working, SOD-523 | D_SOD-523_TI_DYA0002A | SMD | Source this MPN exactly
