antevens/sladdseg/pcb/order/pcbway/option_a_pcbway_smt/eu_pin_board/eu_pin_board_pcbway_bom.csv

Item # | Designator | Qty | Manufacturer | Mfg Part # | Description / Value | Package/Footprint | Type | Your Instructions / Notes
1 | C1 | 1 | KEMET | C1206C226M4PACTU | 22uF 16V X5R - Ceramic 22 uF 16 V X5R 1206, 1.8 mm max | C_1206_3216Metric | SMD | Source this MPN exactly
2 | P1,P2,P3,P4 | 4 | Harwin | P70-2200045 | P70-2200045 GND - Spring pin with peg, 2 A | Harwin_P70-2200045 | SMD | Source this MPN exactly
