antevens/sladdseg/pcb/order/pcbway/option_a_pcbway_smt/na_pin_board/na_pin_board_pcbway_bom.csv

Item # | Designator | Qty | Manufacturer | Mfg Part # | Description / Value | Package/Footprint | Type | Your Instructions / Notes
1 | J1,J2 | 2 | Harwin | P70-2200045 | +5V pin - SMT spring pin with peg, 2 A, gold | Harwin_P70-2200045 | SMD | Source this MPN exactly
