antevens/sladdseg/pcb/eu/kicad/3d/Sensirion_DFN-4_1.5x1.5mm_P0.8mm_SHT4x_NoCentralPad.step

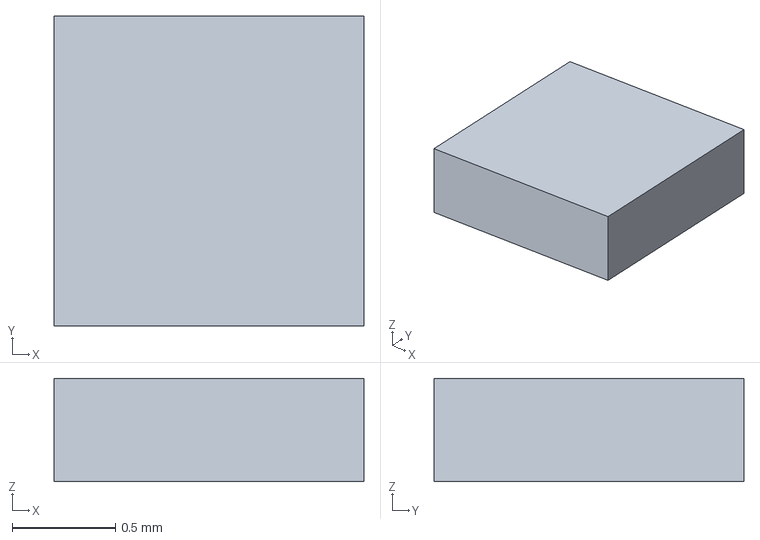
[picture p70: CAD file, 2026-10-13]
pcb/eu/kicad/3d/Sensirion_DFN-4_1.5x1.5mm_P0.8mm_SHT4x_NoCentralPad.step
1.50 x 1.50 x 0.5 mm
