antevens/sladdseg/pcb/na/kicad/3d/Harwin_P70-2200045.step

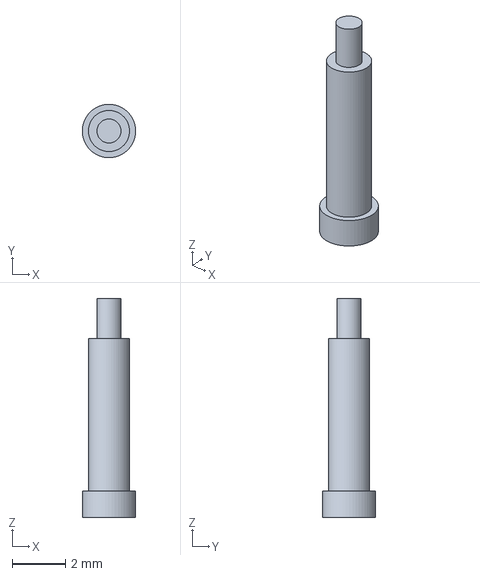
[picture p71: CAD file, 2026-10-13]
pcb/na/kicad/3d/Harwin_P70-2200045.step
2.00 x 2.00 x 8.20 mm
