antevens/sladdseg/pcb/shared/kicad/3d/Knowles_SPK0641HT4H-1_3x4mm.step

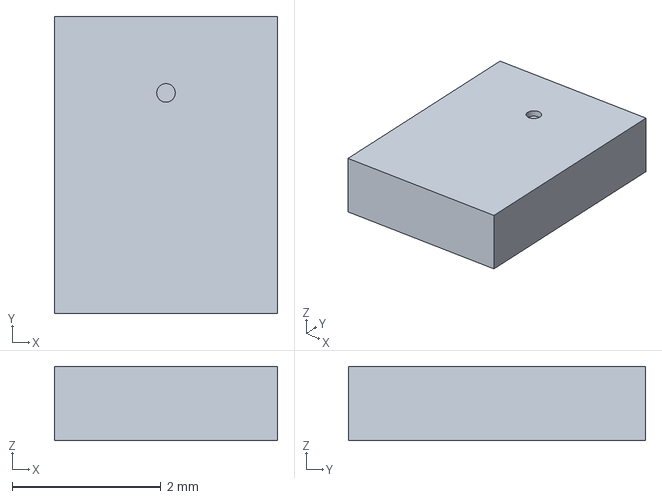
[picture p72: CAD file, 2026-10-13]
pcb/shared/kicad/3d/Knowles_SPK0641HT4H-1_3x4mm.step
3.00 x 4.00 x 1.00 mm
