antevens/sladdseg/print/plate_jig_PLA.3mf

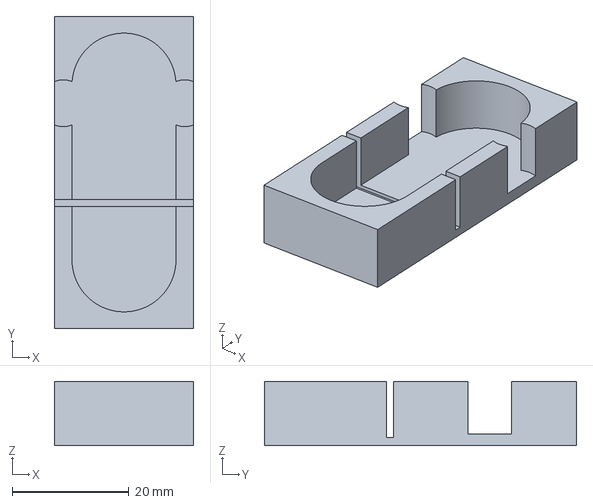
[picture p73: CAD file, 2026-10-13]
print/plate_jig_PLA.3mf
23.8 x 53.4 x 11.0 mm
