antevens/sladdseg/pcb/eu/kicad/3d/Analog_WLCSP-8_0.76x1.56mm_P0.4mm.step

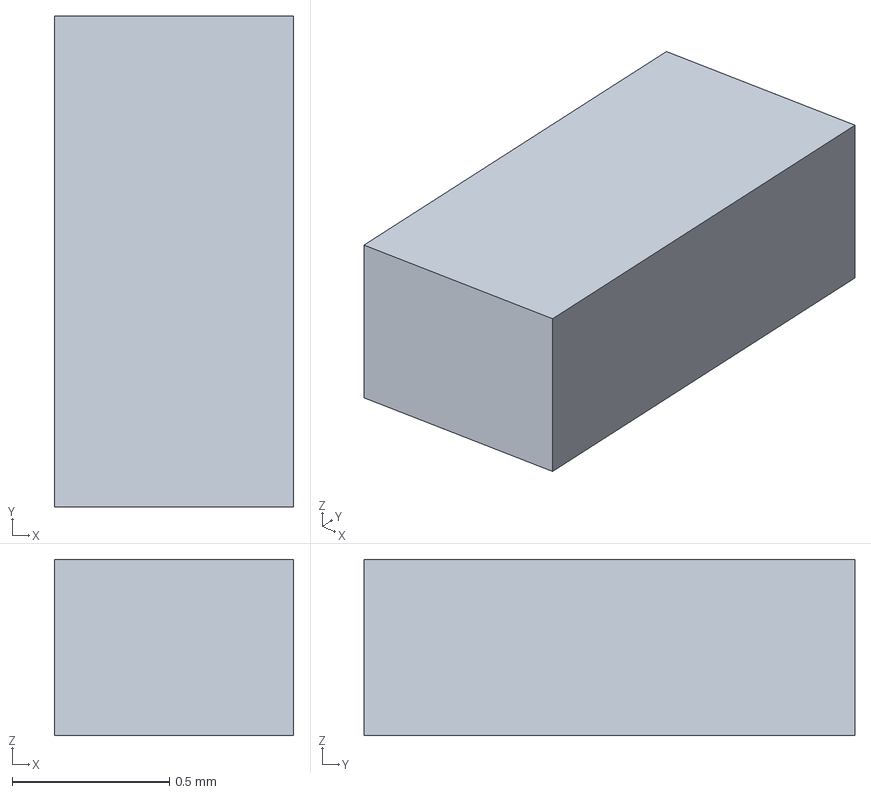
[picture p74: CAD file, 2026-10-13]
pcb/eu/kicad/3d/Analog_WLCSP-8_0.76x1.56mm_P0.4mm.step
0.76 x 1.56 x 0.56 mm
