antevens/sladdseg/pcb/na/kicad/3d/Harwin_S7081-42R.step

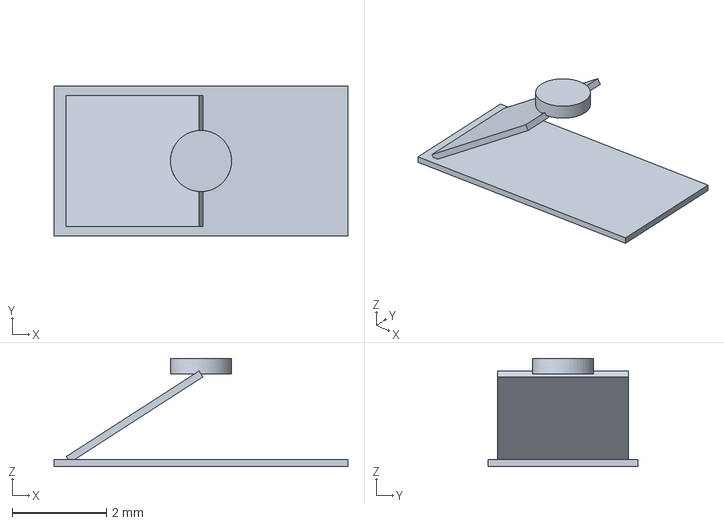
[picture p75: CAD file, 2026-10-13]
pcb/na/kicad/3d/Harwin_S7081-42R.step
6.25 x 3.18 x 2.30 mm
