antevens/sladdseg/print/backcover_ABS.3mf

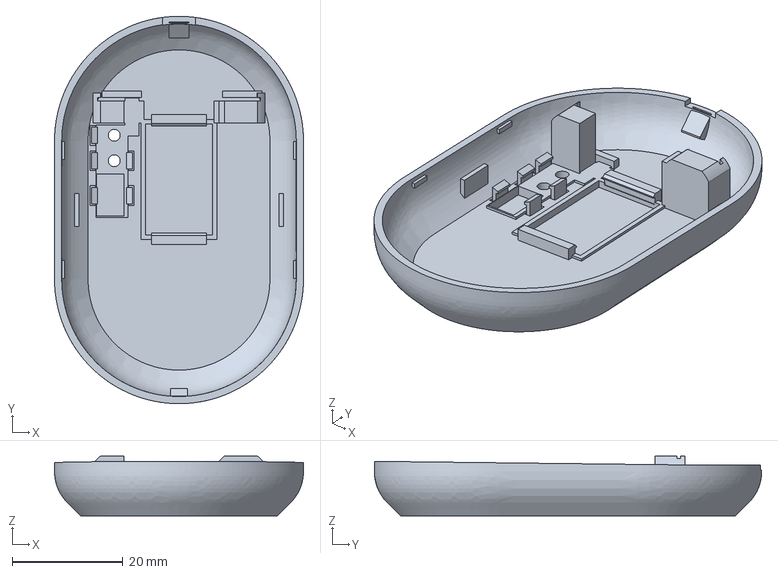
[picture p76: CAD file, 2026-10-13]
print/backcover_ABS.3mf
45.0 x 70.0 x 10.8 mm
