antevens/sladdseg/pcb/eu/kicad/3d/Fuse_Schurter_UMT250.step

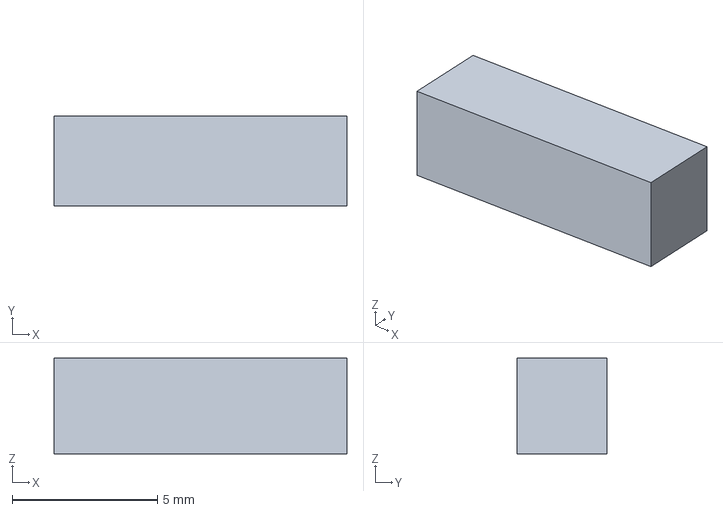
[picture p77: CAD file, 2026-10-13]
pcb/eu/kicad/3d/Fuse_Schurter_UMT250.step
10.1 x 3.10 x 3.30 mm
