antevens/sladdseg/pcb/eu/kicad/3d/Marquardt_1802.2504.step

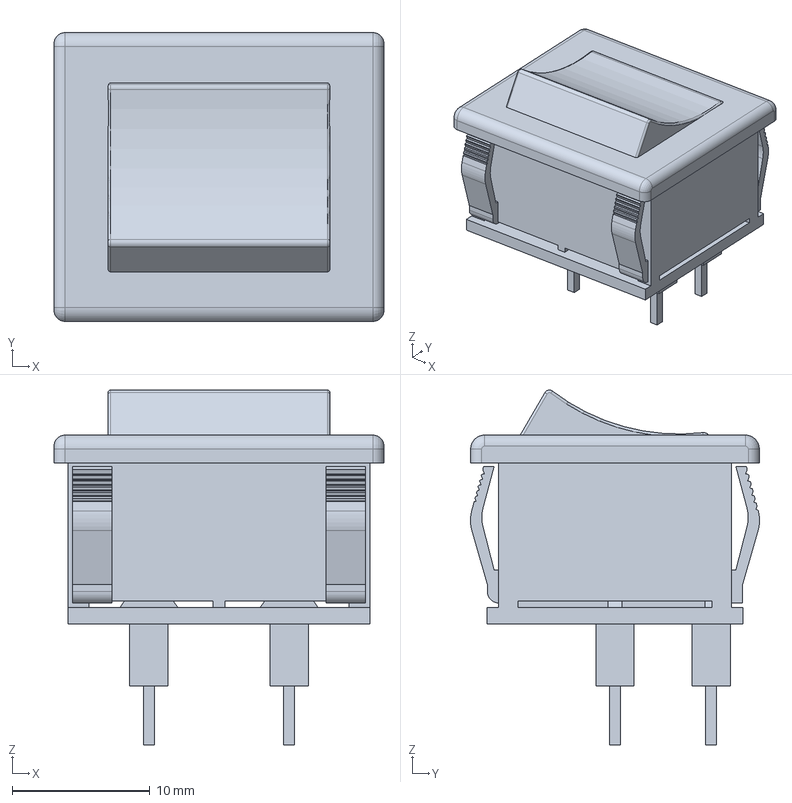
[picture p78: CAD file, 2026-10-13]
pcb/eu/kicad/3d/Marquardt_1802.2504.step
24.0 x 21.0 x 25.8 mm
