antevens/sladdseg/print/na_barrier_PLA_testfit.3mf

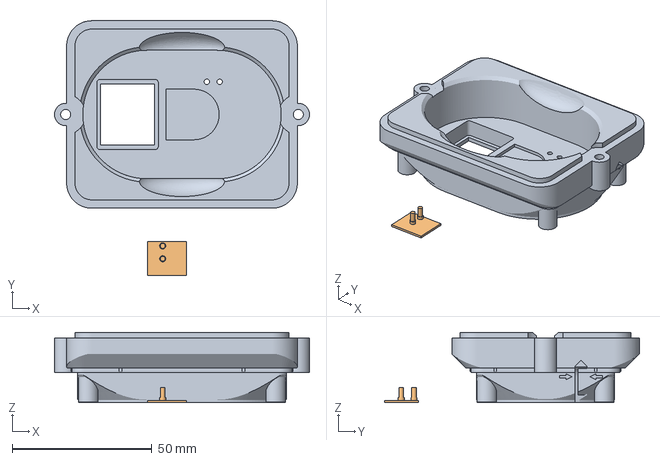
[picture p79: CAD file, 2026-10-13]
print/na_barrier_PLA_testfit.3mf
91.3 x 91.1 x 25.2 mm
na_barrier.stl
na_blank_board.stl
