antevens/sladdseg/print/eu_plain_carrier_PLA.3mf

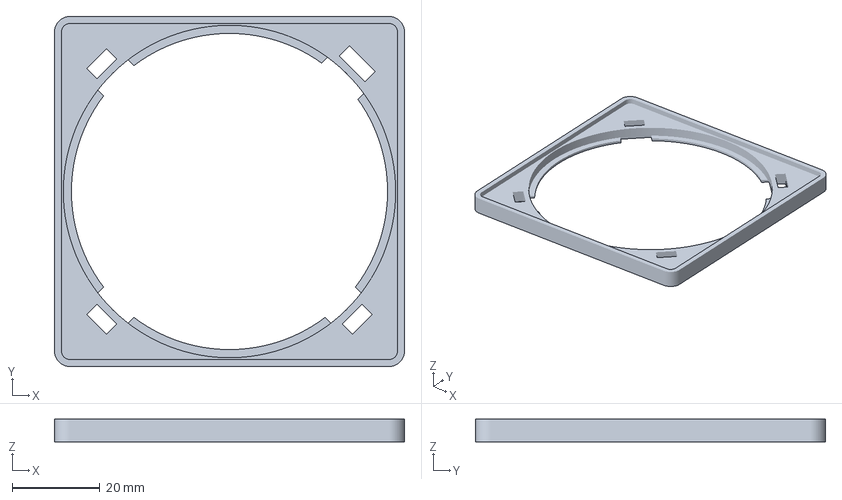
[picture p80: CAD file, 2026-10-13]
print/eu_plain_carrier_PLA.3mf
79.6 x 79.6 x 5.20 mm
