antevens/sladdseg/print/na_plain_face_plate_PLA.3mf

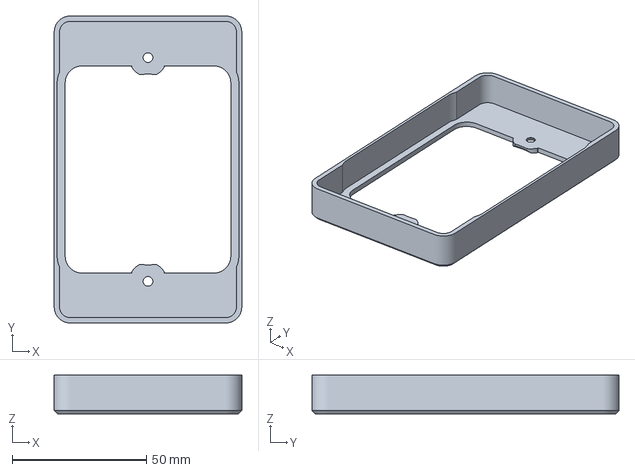
[picture p81: CAD file, 2026-10-13]
print/na_plain_face_plate_PLA.3mf
69.8 x 114.3 x 14.4 mm
