antevens/sladdseg/pcb/na/kicad/3d/WAGO_2604-1106.step

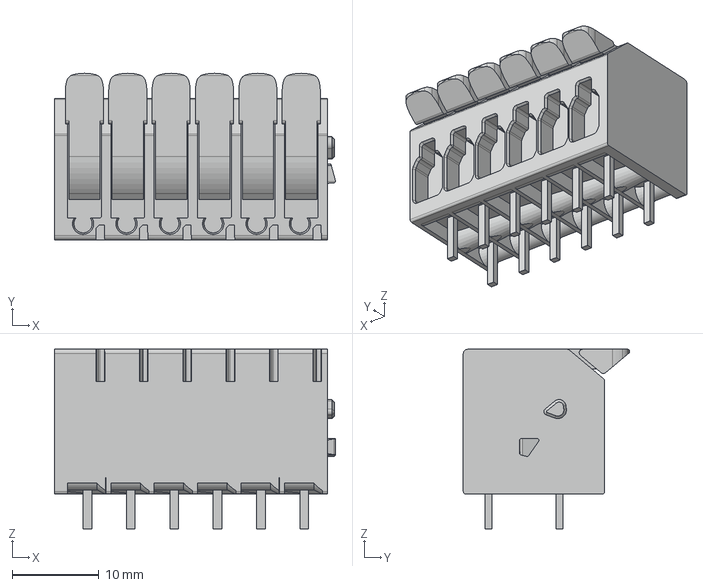
[picture p82: CAD file, 2026-10-13]
pcb/na/kicad/3d/WAGO_2604-1106.step
32.4 x 19.2 x 20.7 mm
