antevens/sladdseg/print/eu_barrier_PC-FR.3mf

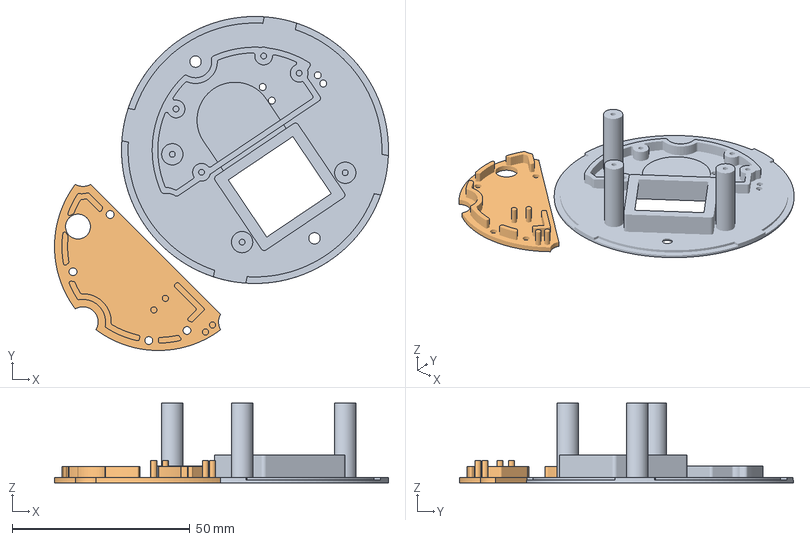
[picture p83: CAD file, 2026-10-13]
print/eu_barrier_PC-FR.3mf
94.1 x 94.1 x 22.5 mm
eu_barrier.stl
eu_blank_board.stl
