antevens/sladdseg/pcb/eu/kicad/3d/Converter_ACDC_Zettler_ZPI03_THT.step

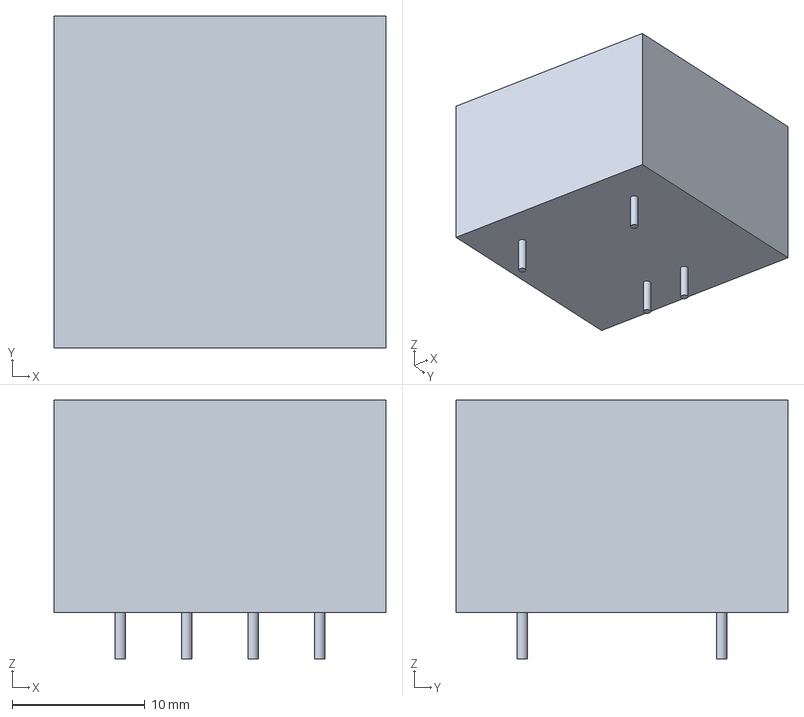
[picture p84: CAD file, 2026-10-13]
pcb/eu/kicad/3d/Converter_ACDC_Zettler_ZPI03_THT.step
25.0 x 25.0 x 19.5 mm
