antevens/sladdseg/print/na_face_plate_PLA.3mf

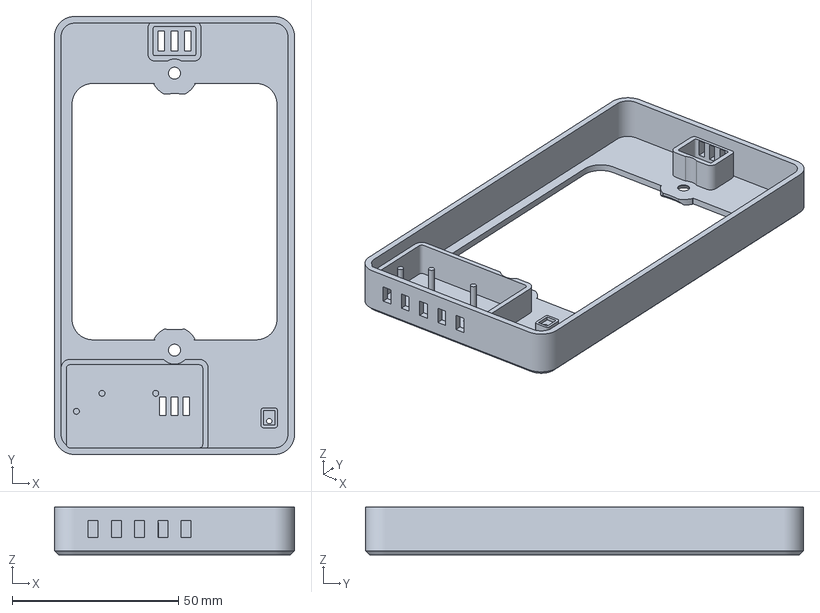
[picture p85: CAD file, 2026-10-13]
print/na_face_plate_PLA.3mf
72.2 x 131.8 x 14.4 mm
