antevens/sladdseg/pcb/na/kicad/3d/Varistor_TDK_CU4032.step

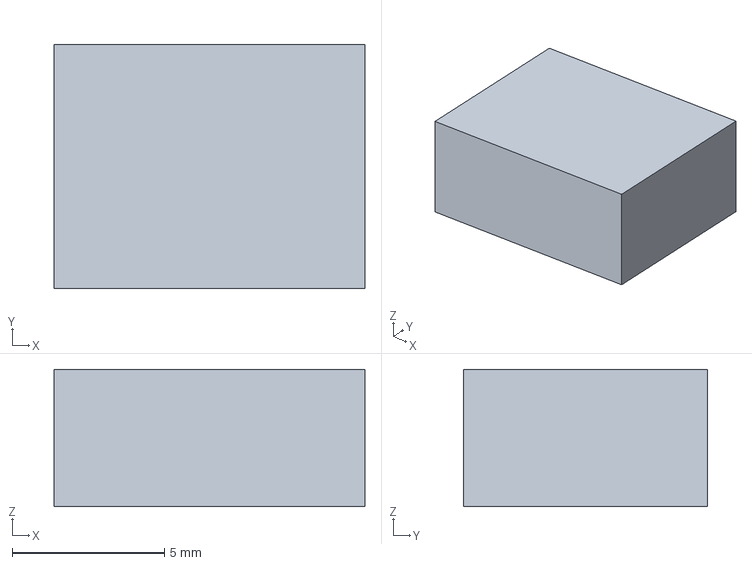
[picture p87: CAD file, 2026-10-13]
pcb/na/kicad/3d/Varistor_TDK_CU4032.step
10.2 x 8.00 x 4.50 mm
