antevens/sladdseg/print/eu_plain_face_plate_PLA.3mf

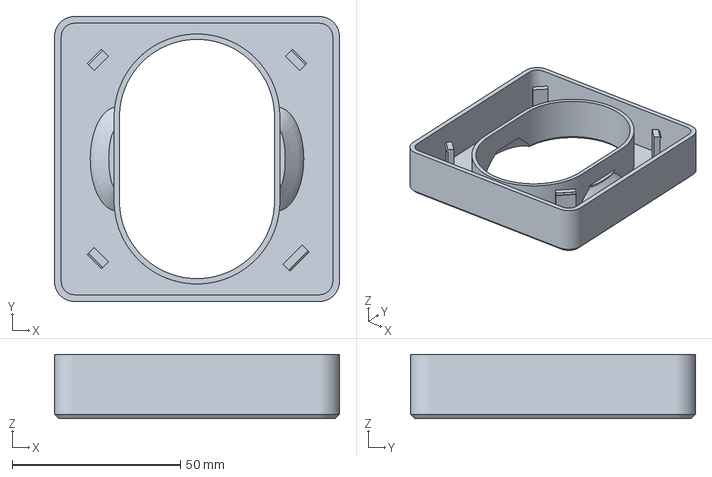
[picture p88: CAD file, 2026-10-13]
print/eu_plain_face_plate_PLA.3mf
84.6 x 84.6 x 19.0 mm
