antevens/sladdseg/print/eu_carrier_PLA.3mf

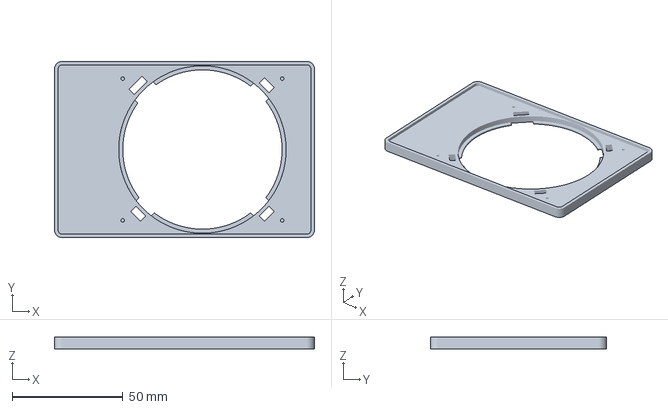
[picture p89: CAD file, 2026-10-13]
print/eu_carrier_PLA.3mf
117.4 x 79.6 x 5.20 mm
