antevens/sladdseg/print/na_coupons_PLA.3mf

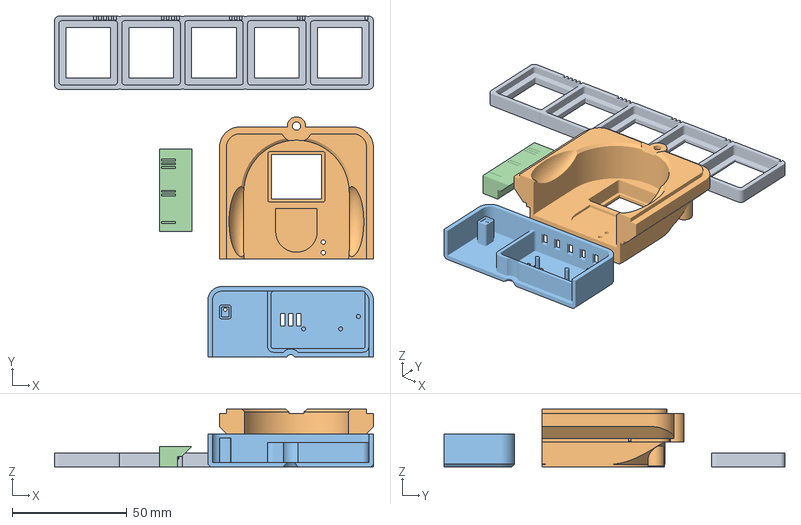
[picture p90: CAD file, 2026-10-13]
print/na_coupons_PLA.3mf
139.0 x 148.5 x 25.2 mm
na_coupon_rocker.stl
na_coupon_pocket_well.stl
na_coupon_msr.stl
na_coupon_ribs.stl
