antevens/sladdseg/print/eu_testbox_PLA.3mf

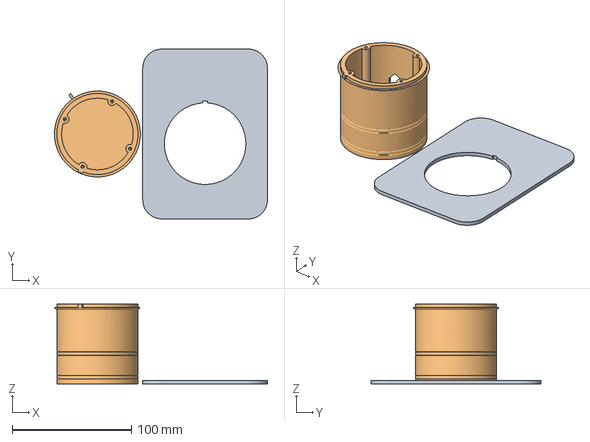
[picture p91: CAD file, 2026-10-13]
print/eu_testbox_PLA.3mf
178.6 x 142.4 x 67.0 mm
eu_testbox_plate.stl
eu_testbox.stl
