antevens/sladdseg/print/eu_face_plate_PLA.3mf

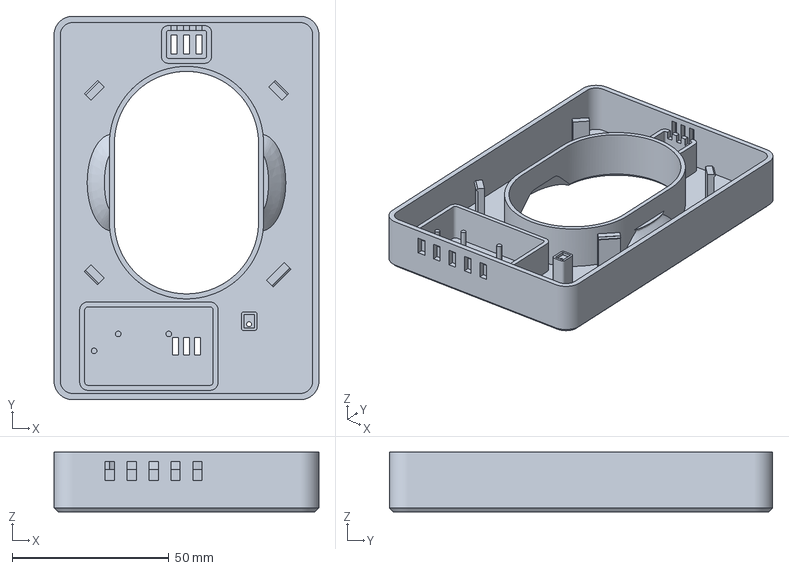
[picture p92: CAD file, 2026-10-13]
print/eu_face_plate_PLA.3mf
84.6 x 122.4 x 19.0 mm
