antevens/sladdseg/(list of files, cad)

Other CAD files:
pcb/shared/kicad/3d/Sensirion_DFN-4_1.5x1.5mm_P0.8mm_SHT4x_NoCentralPad.step
pcb/na/kicad/3d/Fuse_Schurter_UMT250.step
pcb/shared/kicad/3d/Analog_WLCSP-8_0.76x1.56mm_P0.4mm.step
print/backcover_PETG.3mf
pcb/na/kicad/3d/Analog_WLCSP-8_0.76x1.56mm_P0.4mm.step
pcb/shared/kicad/3d/Harwin_S7081-42R.step
pcb/eu/kicad/3d/Harwin_S7081-42R.step
pcb/na/kicad/3d/Sensirion_DFN-4_1.5x1.5mm_P0.8mm_SHT4x_NoCentralPad.step
print/na_barrier_PC-FR.3mf
pcb/eu/kicad/3d/Varistor_TDK_CU4032.step
print/eu_barrier_PLA_testfit.3mf
