antevens/sladdseg/docs/ASSEMBLY.md

# Assembly: what holds each part

Every board, flex and electronic part is held by a screw, a solder joint, or a printed snap, hook or slot; no
tape. Nothing here is a compliance statement; mains work is a human decision (SAFETY).

> **Solder the rocker (S1) last, NA and EU.** Snap the rocker into its panel first, mount the board on its
> standoffs (NA) or bosses (EU) and tighten all its screws, and only then solder the rocker's pins or tabs from the
> board's back. The board's rocker holes are plated slots 5.2 mm long (D-88), so they do not locate the rocker: the
> panel cutout does. A rocker soldered before the board is fixed can end up off its cutout, stressing the snap
> latches and the joints, or not seating in the panel.

## NA plate

| Part | Held by | Notes |
| --- | --- | --- |
| Barrier | the two #6-32 box screws through its flange | |
| Face plate | clamped by the same screws; two pins key it | passive: no electronics, no contacts (D-50) |
| Mains board | four nylon M3 standoffs (Keystone 25503) screwed into the barrier's tapped bosses, a nylon M3 × 8 screw through each corner hole (D-57) | studs as supplied (D-134) |
| Rocker, WAGO, PSU, F1, RV1, J2, spacer posts P1 / P2 | soldered; the rocker also snaps into the barrier's panel | rocker soldered last, with the board screwed down (see the note at the top) |
| Bus bars BAR1–4 | soldered on the board's front over the WAGO pin tails, before the board is fitted | D-153 |
| Spacer studs (WA-SBRIE) | screwed into P1 / P2; heatshrink over each post | D-50 |
| Pin board | two M2 × 5 screws into the studs; in its pocket under the pocket floor, three snap clips in the pocket (top, right and bottom edges) hold its back face against the pins' push (the bottom one also holds the blank board in switch only, D-128) | D-50, D-91 |
| Spring pins | soldered on the pin board; their barrels stand in the floor holes | D-50 |
| FFC, mains board end | FH12 slide latch on J2 | |
| FFC, run | in the plane x 12.7: down out of J2, one bend up, straight through the slit in the barrier's bottom wall (behind its lip), the slit's curved top bending it over onto the sensor board; no fold, no twist | D-134 |
| FFC, sensor board end | FH12 slide latch on the sensor board's J1 | |
| Sensor board | pressed onto eight crush ribs on the collar's outside (0.15 mm into its window edge) for handling; in the box the flange's 1.8 mm land clamps its inner edge against the wall, the face plate's posts and frames the rest | D-50, D-68 |
| MSR-2 | CN2 on the sensor board and three 1.5 mm SMT spacers under its board; three posts on the face plate press its board onto the spacers (the skin stands 0.3 mm clear of the CO2 add-on and the radar) | D-50, D-66, D-68 |
| SHT40, passives, J1, SMT spacers H1–H3 | soldered on the sensor board | D-68 |
| Microphone, ADAU7002 | soldered on the sensor board (PCBWay assembly: the ADAU7002 is a 0.4 mm WLCSP); the face plate's sound column presses its gasket on the board round the mic | D-83 |
| Supplied steel plate (cut piece) | its own adhesive in the pocket-floor recess; cut with the hacksaw guide | D-43, D-52 |

## Order of work for the NA plate

0. Cut the supplied steel plate: lay it whole in the hacksaw guide, round end on the stop, clamp the guide in a vise
   and saw down the slot. Deburr the cut edge.
1. Mains board: solder P1 / P2 with the SMD parts (reflow). Bars (D-153), S1 not fitted: lay each bar on its land on
   the front (bare copper, HASL) over its WAGO pin tails; solder it on a hot plate or with a large iron, filling the
   pin holes; clean the flux off. Screw the WA-SBRIE studs in; heatshrink.
   Optional (D-152): brush conformal coating over the front's mains copper and joints, the bars' edges included; keep
   it off the rocker's slots, J2 and the spacer posts' threads; let it cure.
2. Sensor board: solder the hand parts (PCBWay fits the SMD parts); stick the mic gasket round the mic; plug the MSR-2
   onto CN2.
3. Barrier: snap the rocker into its panel from the front. Do not solder it yet.
4. Pin board: screw it onto the studs (M2 × 5); check that each pin moves freely.
5. Latch the FFC into J2 (contacts towards the board; J2's cable side faces down), then fit the mains board on its
   standoffs (the pins enter the floor holes from behind; the rocker's pins or tabs pass the bars' slots into the board's; the pin
   board snaps past the two clips in its pocket; the cable hangs down past the board's bottom edge) and tighten all
   four screws. To take the board off again, press the two clip hooks outwards with a pick while pulling it back.
6. **Now solder the rocker** from the board's back, with the board screwed down and the rocker seated in the panel;
   its solder fills the plated slots up to the bars. Optional (D-152): clean the flux off and brush conformal coating over the back's mains copper and joints, the
   rocker's included, round the WAGO block's and the PSU's pins; keep it out of the WAGO block's openings and
   levers; let it cure.
7. Sensor board: slide it over the plug from behind (the window passes the mains board) and press it onto the collar's
   ribs until it sits under the flange's land. Then bend the cable roughly to its shape (up from J2, over at the top),
   slide it sideways into the slit in the barrier's bottom wall from the left through the notch, its end out under
   the flange over the sensor board, and latch it into J1 from the front. Follow the engraved arrows: the cable is in
   the slit, not between the barrier and the box.
8. In the box: wire the WAGO block, screw the barrier to the ears, put the face plate on.

## EU plate

| Part | Held by | Notes |
| --- | --- | --- |
| Barrier | two screws into the box's top and bottom domes | |
| Face plate | four snap fingers at the corners drop into closed, keyed windows in the sensor board and the carrier (the wide one top right) and catch the grooves in the carrier's windows | D-70, D-77 |
| Mains board | M2 screws on the barrier's long bosses | |
| Pin board | four M2 × 5 thread-forming screws into the barrier's bosses; its front rests on the ridge that runs along its straight edge, inside the sensor pins and round its edge between the bosses (switch only: the printed blank board, the same way; its own ridge stands beside the barrier's, D-131) | D-129, D-131 |
| Rocker, WAGO blocks, PSU, header, socket, spring pins | soldered; the rocker also snaps into the cup | rocker soldered last, with the mains board screwed onto the barrier's bosses (see the note at the top) |
| Bus bars BAR1–4 | soldered on the mains board's front over the WAGO pin tails, before the board goes onto the bosses | D-153 |
| Cut steel piece | adhesive, in the recess in the barrier's pocket floor (round end down), 0.5 mm below the seat | D-72 |
| Carrier | on the wall before the barrier; its lip under the barrier's edge, pinned to the wall by the barrier's two screws; the barrier's four teeth in gaps in the lip stop it turning (keyed, one way only) | D-56, D-71 |
| Sensor board | in the carrier's rim, four M2 × 6 screws into the carrier; the pin board's sensor pins press up on its pads | D-56, D-70 |
| MSR-2 board | CN2 on the sensor board and three 1.5 mm SMT spacers under its board; three posts on the face plate press its board onto the spacers (the skin stands 1.3 mm clear of its front) | D-67, D-70 |
| Microphone, ADAU7002 | soldered on the sensor board (PCBWay assembly); the face plate's sound column on its gasket round the mic | D-83 |
| SHT40 | soldered on the sensor board under its vents | D-56 |

## Order of work for the EU mains board

1. Snap the rocker into the barrier's cup from the front. Do not solder it yet.
2. Screw the pin board onto its bosses just under the barrier.
3. Bars (D-153), S1 not fitted: lay each bar on its land on the front (bare copper, HASL) over its WAGO pin tails;
   solder it on a hot plate or with a large iron, filling the pin holes; clean the flux off. Optional (D-152): brush
   conformal coating over the front's mains copper and joints, the bars' edges included, keep it off the rocker's
   slots and the header; let it cure. Then put the mains board (WAGO blocks, PSU, F1, RV1 and the header already
   soldered) onto the barrier's long bosses from behind, its header into the pin board's socket and the rocker's
   pins or tabs through the bars' slots into its own, and tighten the M2 screws (D-36, D-59).
4. **Now solder the rocker** from the mains board's back, with the board screwed down and the rocker seated in the
   cup; its solder fills the plated slots up to the bars. Optional (D-152): clean the flux off and brush conformal coating over the back's mains copper and joints,
   the rocker's included, round the WAGO blocks' and the PSU's pins; keep it out of the WAGO blocks' openings; let
   it cure.
5. In the box (breaker off): join the protective earth from the supply and to the lights in the WAGO 221-412
   lever connector (D-94); the boards carry no PE. Keep whatever PE the box has continuous; a third PE conductor
   (a looped feed) takes a 221-413. Then L and N into the two 2604-3102 blocks on the mains board's back.

## Plain plates (D-109)

As the full plates, without the sensors' parts:

- NA: no sensor board and no FFC; the same barrier as the full plate (D-127; its cable slit stays open, D-135). The plain face plate (69.85 × 114.3 mm) is clamped
  by the same two screws and keyed by the same two pins. The pin board, its spacer posts and the spring pins as the full plate.
- EU: no sensor board and no sensor pins (P1 / P2 left off the pin board); the same barrier as the full plate (D-127; the
  sensor pins' two holes unfilled: open). The plain carrier's lip goes under the barrier's edge as before; the plain face plate (84.6 × 84.6 mm, D-146) snaps into the
  carrier's four corner windows.

## Replacement back cover

| Part | Held by | Notes |
| --- | --- | --- |
| Cover on the remote | two snap clips (top, bottom) on the housing's wall; side ribs keep it from flexing; four small tabs inside the cover's long side walls sit in slots in the housing (D-90) | pry it off at the notch |
| Plate (magnet, 12 × 20 × 2) | a ridge round it on the full-thickness shell, a clip at each end | snap in from above; print the cover in PETG (the clips broke in PLA) |
| Cover flex, pad and regulator sections | 0.8 mm FR4 stiffener on top, pressed down past five snap hooks on its long edges (each side of each pin pad and of the regulator, none on the inner edge beside the GND pad, D-79) | press straight down until all five click; to remove, spread the hooks on one edge with a pick |
| Cover flex, run | lies on the ledge, in a notch along the GND contact post's inner face (D-79) | drops in from above |
| Cover flex, end section | slides down a slot along each contact block's outer face (lip over its outer edge) into the slot behind the foot lips (D-55) | slide the end section in from above first, then lay the strip on the ledge and press the pad section down past its hooks |

## Order of work for the back cover

1. Snap the plate into its pocket.
2. Slide the end section (bent up, fingers facing the battery contacts) straight down the slots along the two contact
   blocks' outer faces until its foot sits in the slot behind the foot lips.
3. Lay the run on the ledge, in the notch along the GND contact post's inner face.
4. Press the pad and regulator sections straight down onto the ledge, the pin pads over their windows and
   the regulator into its recess, until the five snap hooks click over the stiffener.
5. Check that no hook is left standing on the stiffener's top.
6. Snap the cover onto the remote (both clips), notch at the bottom end.

## Back cover flex, rendered

The back cover with its flex drawn 2.5 mm off it, so both show (`cad/build123d/render_shared.py`).

NA and EU plates: no flex (D-50, D-56).

Replacement back cover: snap hooks hold the pad and regulator sections, the end section slides down a slot
along each contact block (D-55), the run lies in the notch along the GND contact post (D-79).

| Cover | End section |
| --- | --- |
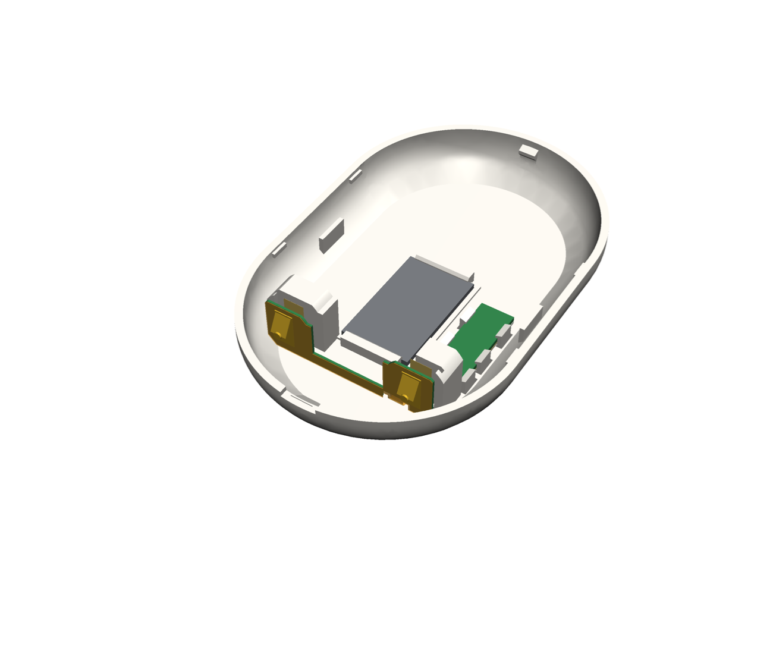
[picture p93: docs/renders/bc_flex.png]
Back cover and flex
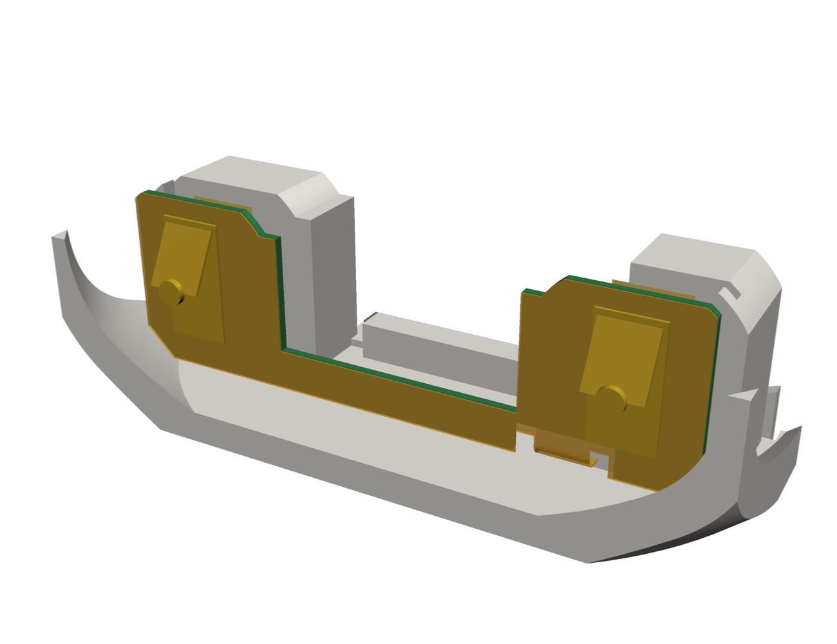
[picture p94: docs/renders/bc_flex_end.png]
Back cover end section
|  |  |

## Detail views

NA plate: the face plate lifted off (it carries no electronics), the 5 V path (FFC from the mains board through the
slit in the barrier's bottom wall to the sensor board), the spring pins of the battery-free remote, the microphone's sound column, and a
section of every printed part (dashed line: the wall surface).

| Face plate off | 5 V path |
| --- | --- |
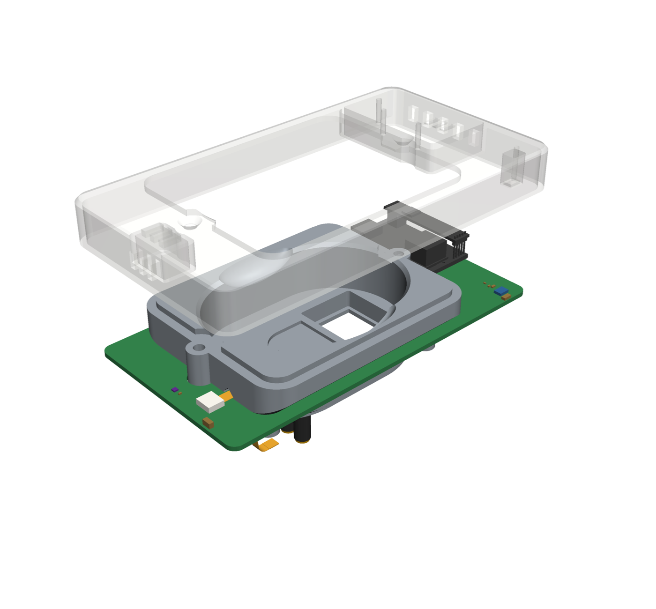
[picture p95: docs/renders/na_face_off.png]
NA face plate lifted off
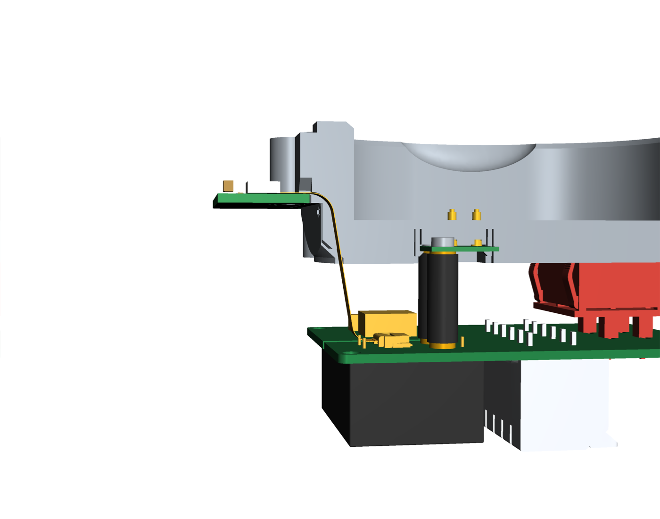
[picture p96: docs/renders/na_power.png]
NA 5 V path
|  |  |

| Battery-free remote | Spring pins, section |
| --- | --- |
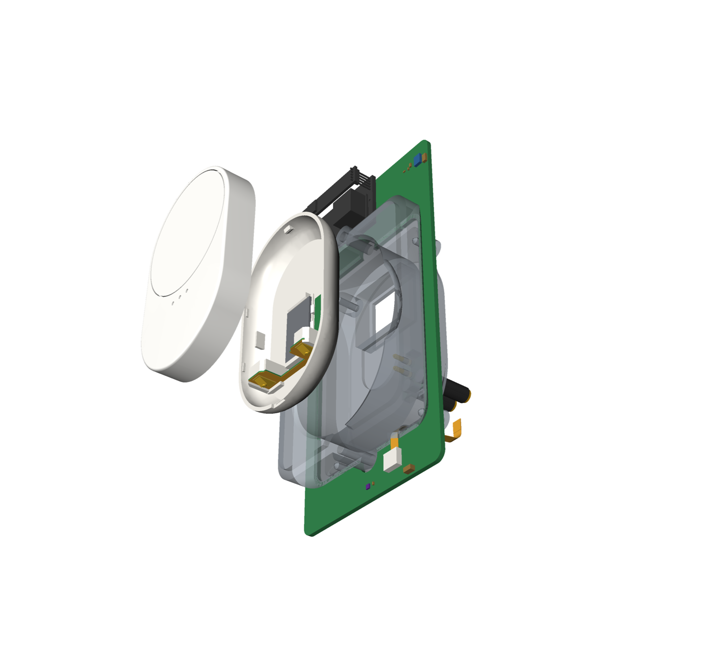
[picture p97: docs/renders/na_battery_free.png]
NA battery-free remote
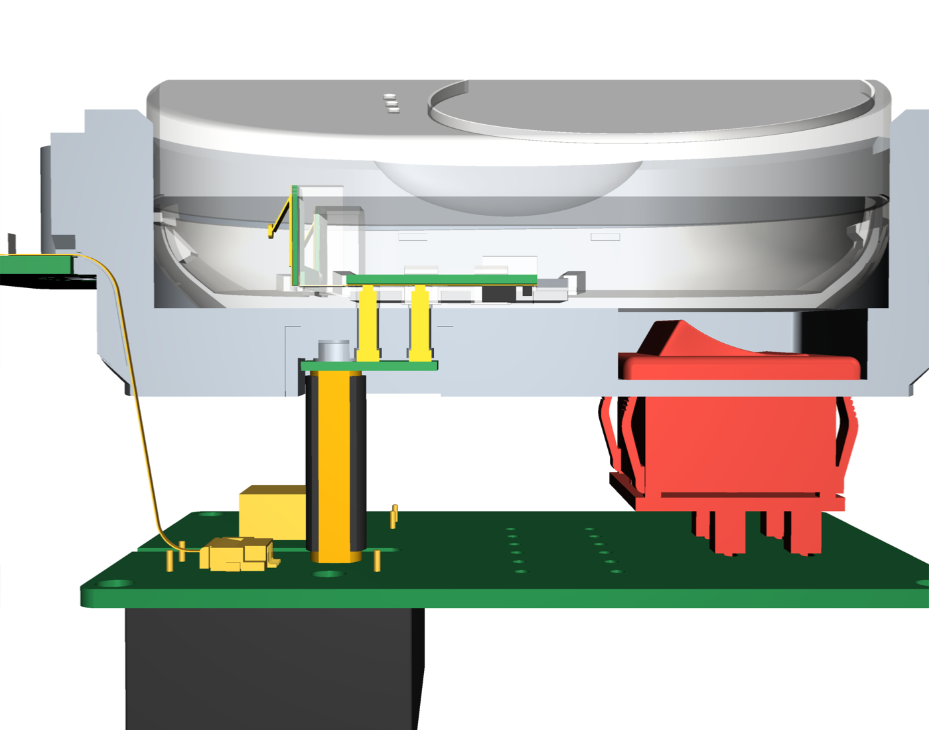
[picture p98: docs/renders/na_pins.png]
NA spring pins
|  |  |

| Sensor board (red: copper keep-out round the box opening) | Microphone sections |
| --- | --- |
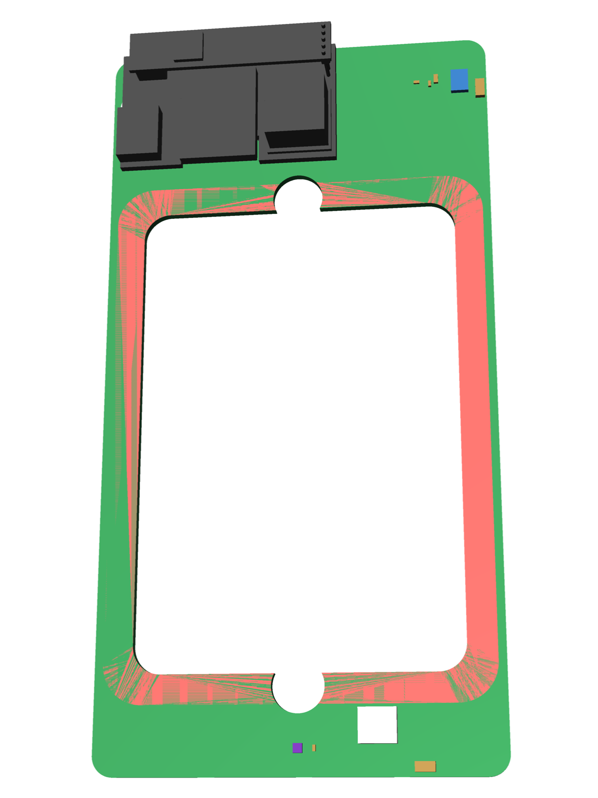
[picture p99: docs/renders/na_sensors.png]
NA sensor board
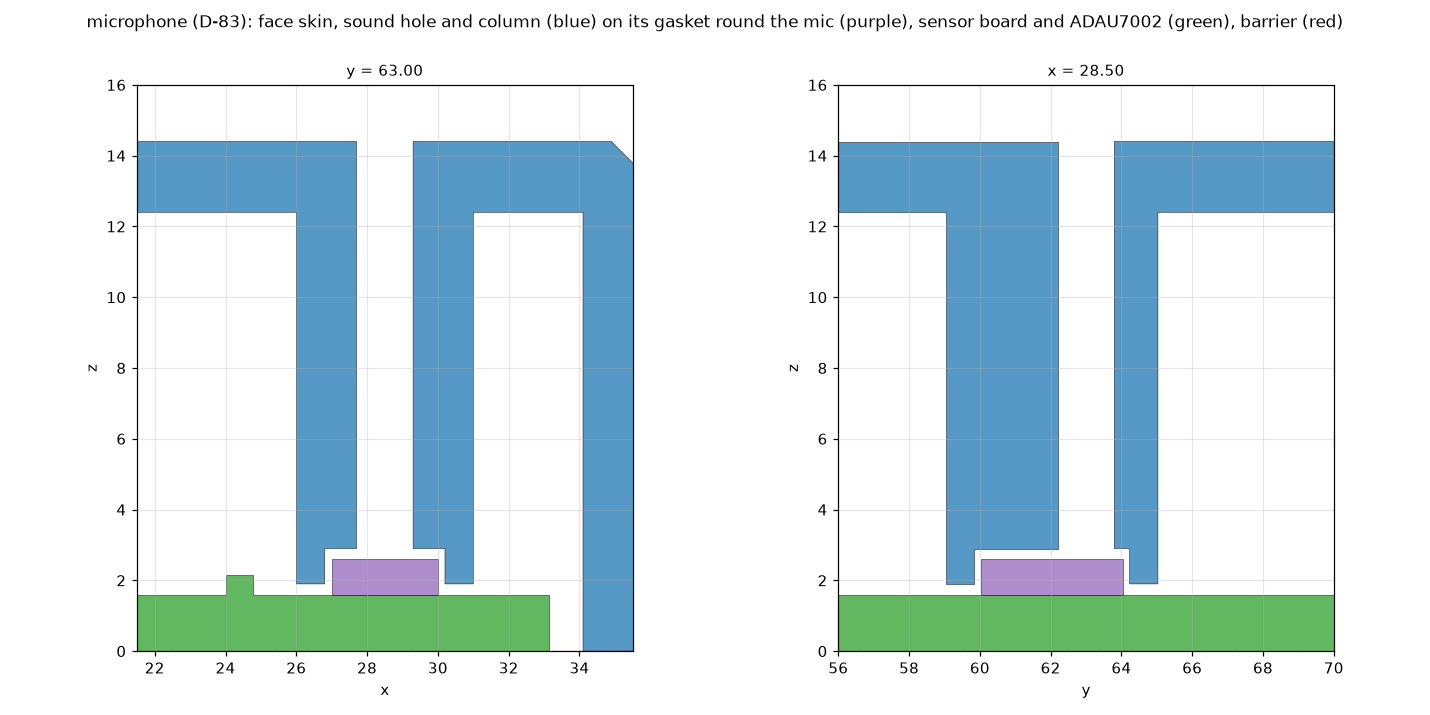
[picture p100: docs/renders/na_mic_section.png]
NA microphone sections
|  |  |

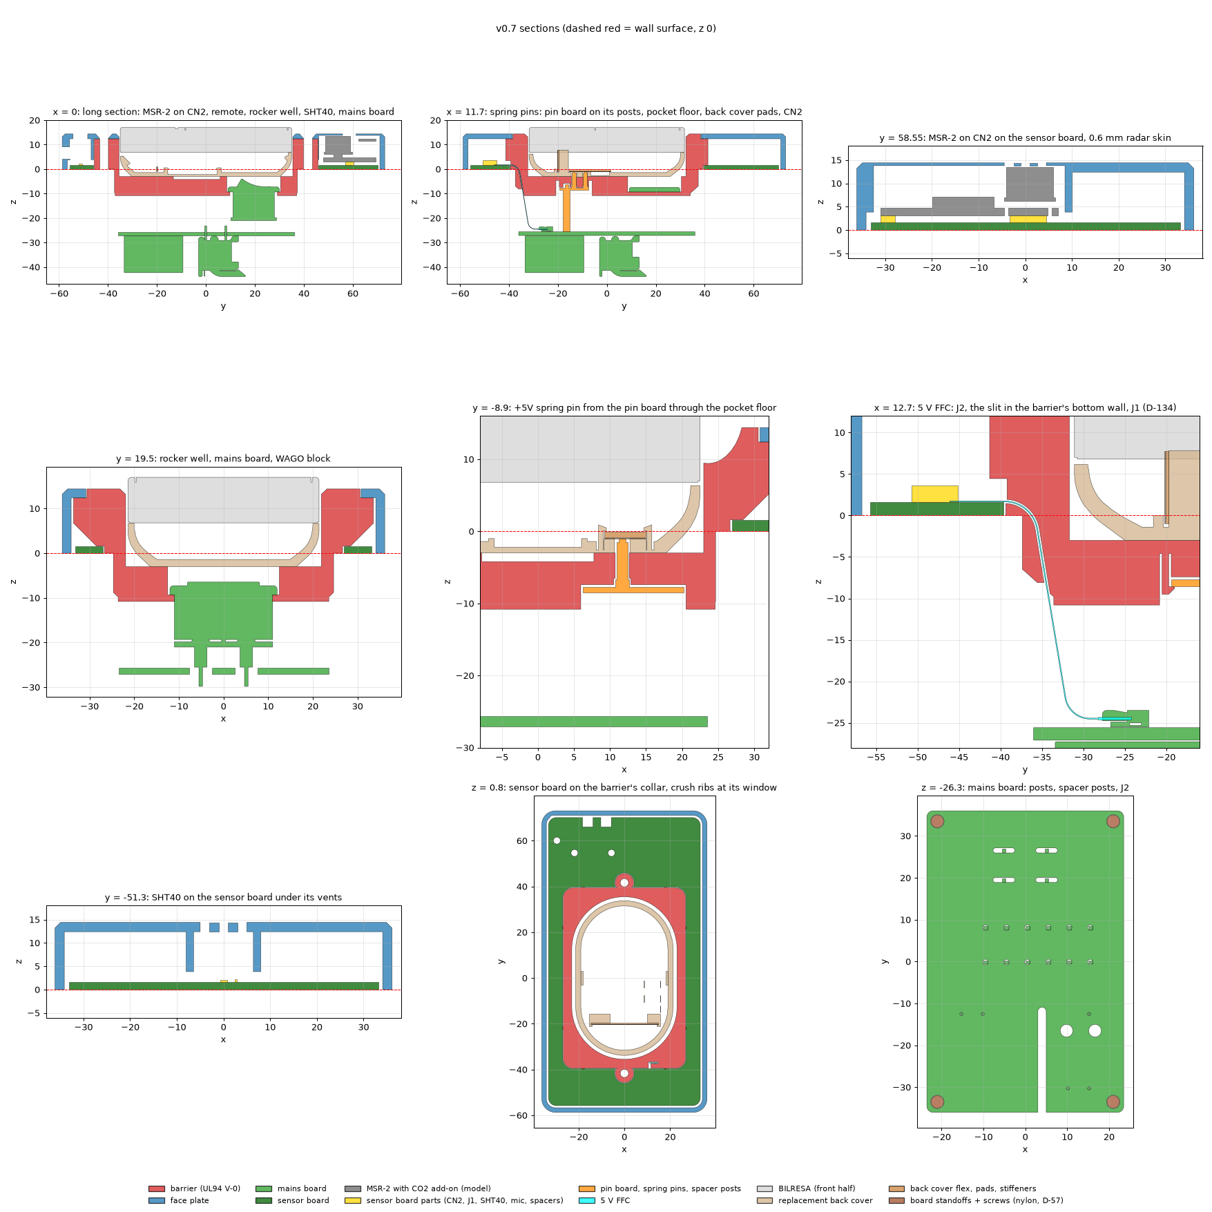
[picture p101: docs/renders/na_sections.png]
NA cross-sections


EU plate: the sensors' side (carrier, sensor board, MSR-2, microphone, SHT40), the carrier clamp from the wall side and
its lip in section, the sensor pins onto the sensor board's pads, a face plate snap, a section and the box from behind.

| Sensors | Box from behind |
| --- | --- |
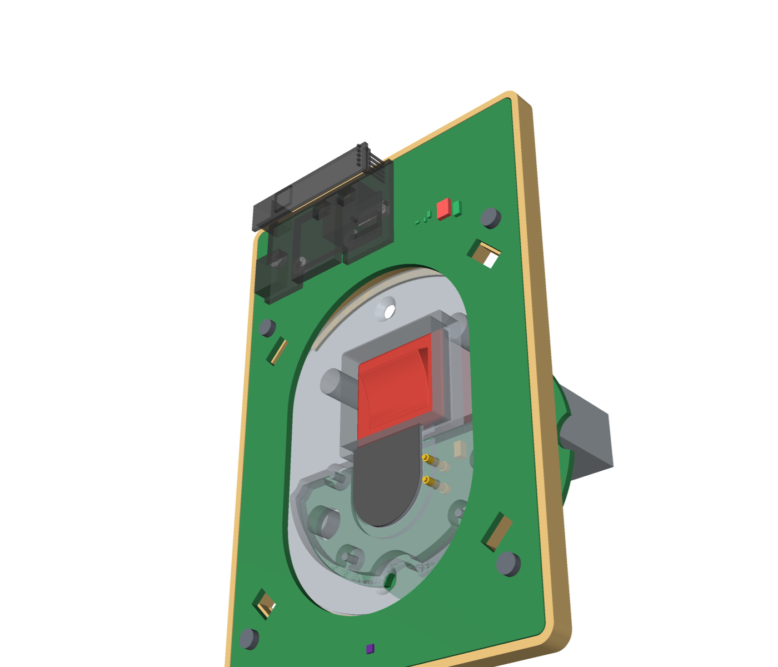
[picture p102: docs/renders/eu_sensors.png]
EU sensors
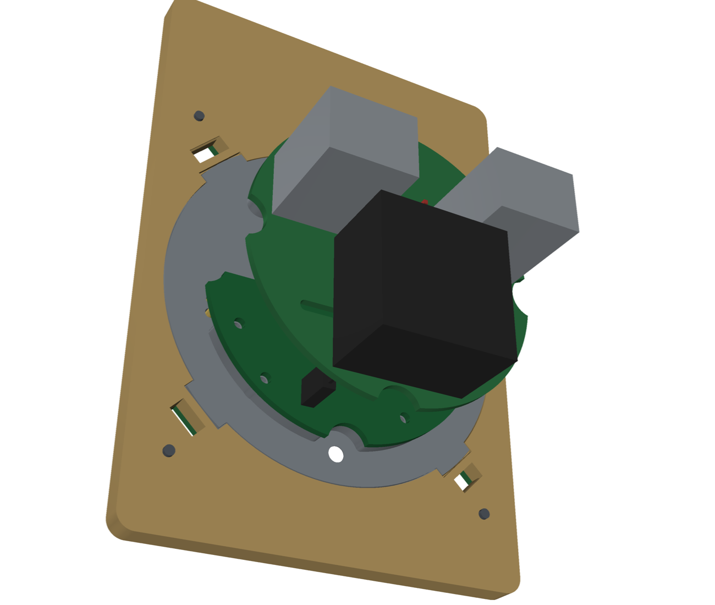
[picture p103: docs/renders/eu_box.png]
EU box from behind
|  |  |

| Carrier clamp | Carrier lip |
| --- | --- |
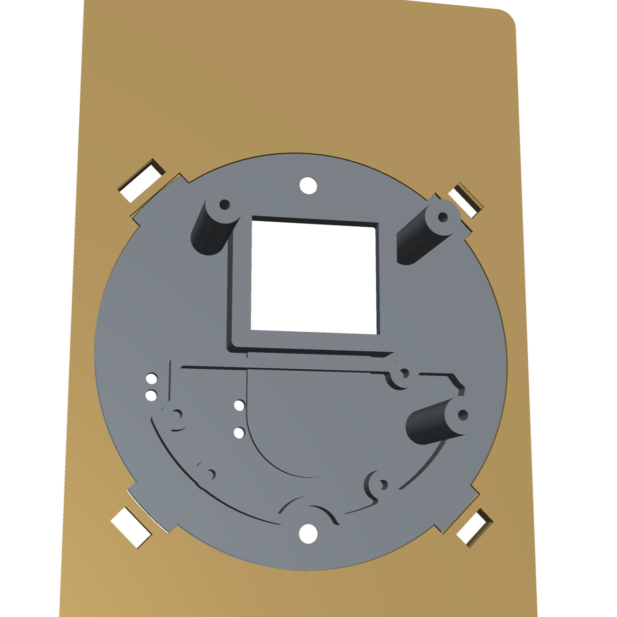
[picture p104: docs/renders/eu_carrier_clamp.png]
EU carrier clamp
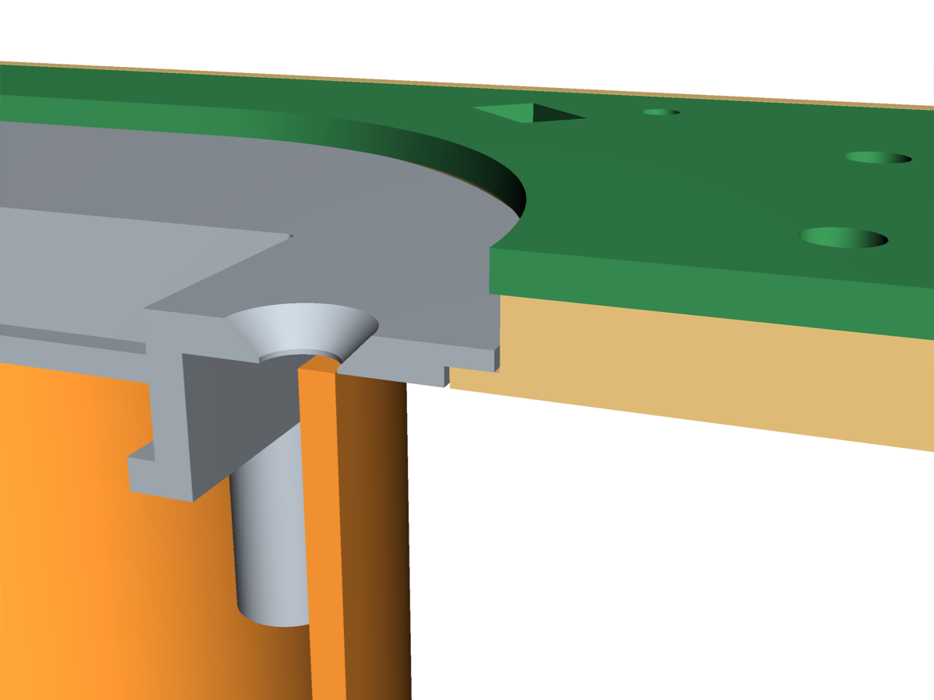
[picture p105: docs/renders/eu_carrier_lip.png]
EU carrier lip
|  |  |

| Sensor pins | Face plate snap |
| --- | --- |
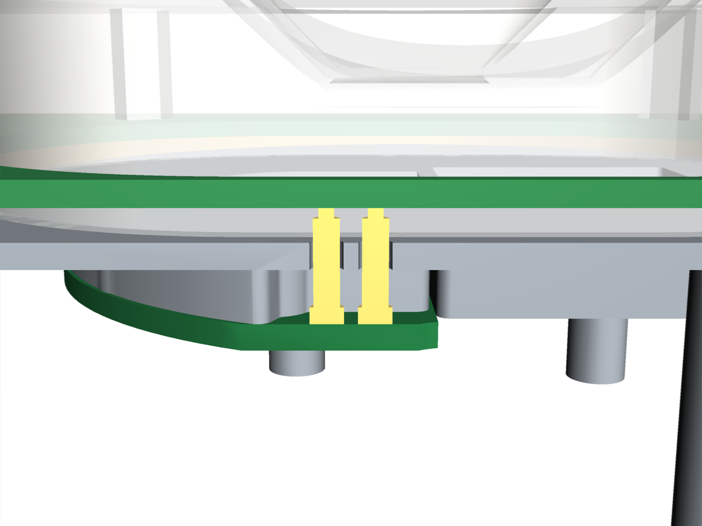
[picture p106: docs/renders/eu_sensor_pins.png]
EU sensor pins
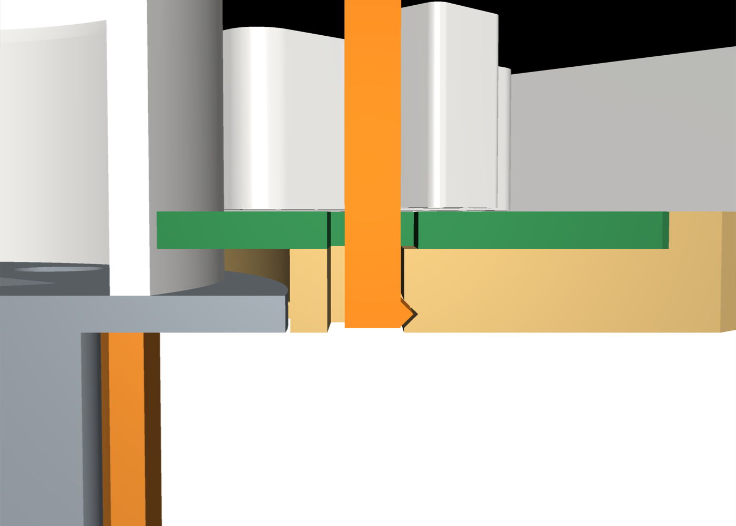
[picture p107: docs/renders/eu_snaps.png]
EU face plate snap
|  |  |

EU section

Back cover: its back with the two pin windows, a section through a pin pad and one through the VBAT contact.

| Back | Pin pad, section |
| --- | --- |
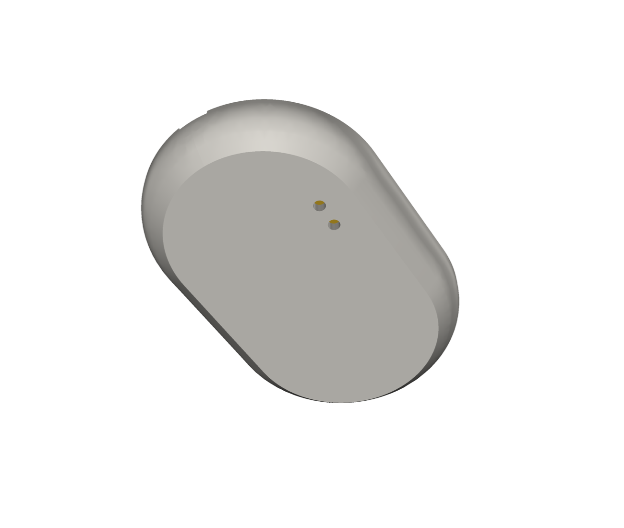
[picture p108: docs/renders/bc_back.png]
Back cover, back
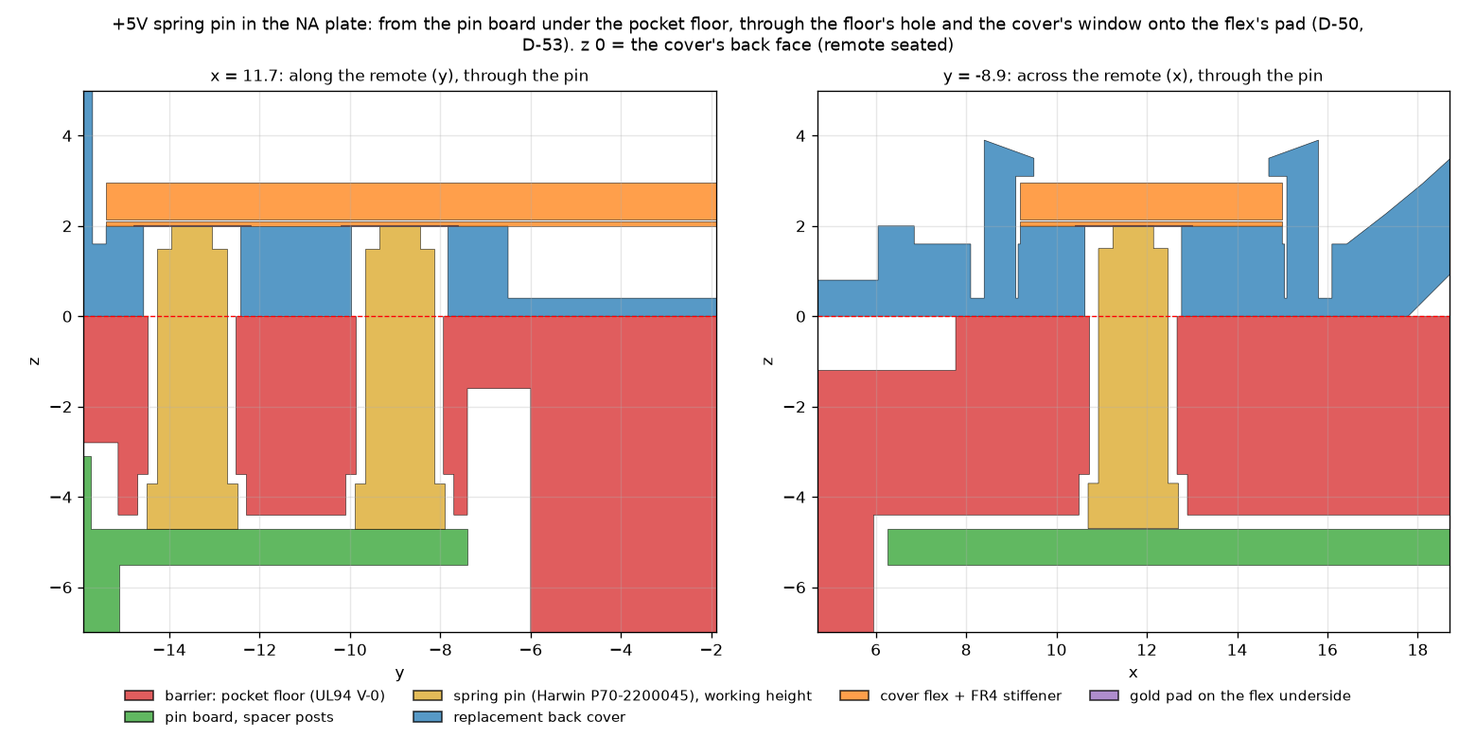
[picture p109: docs/renders/bc_pin_section.png]
Back cover, pin section
|  |  |

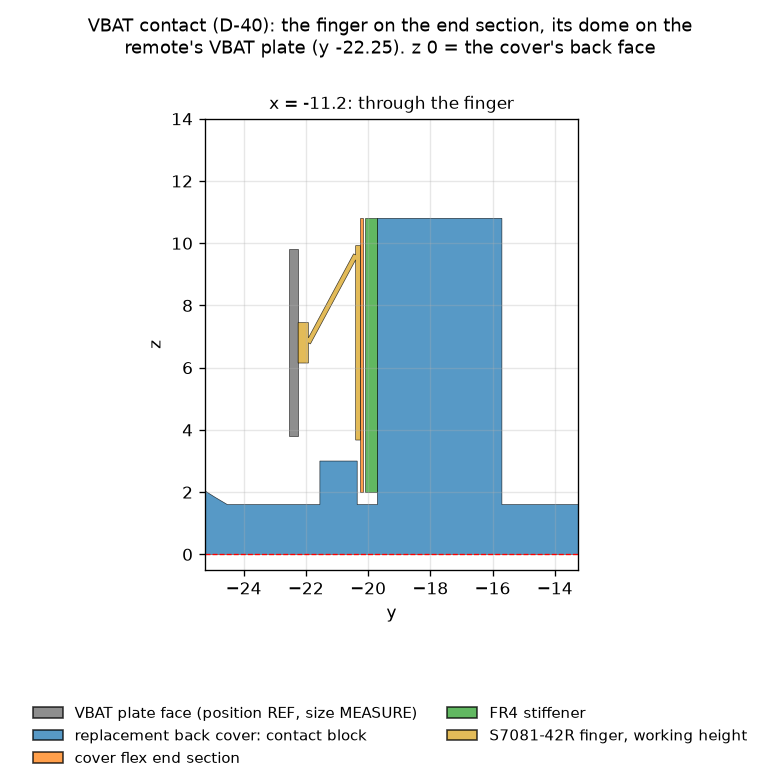
[picture p110: docs/renders/bc_contact_section.png]
Back cover, VBAT contact section


Steel plate hacksaw guide (red: the cut line).

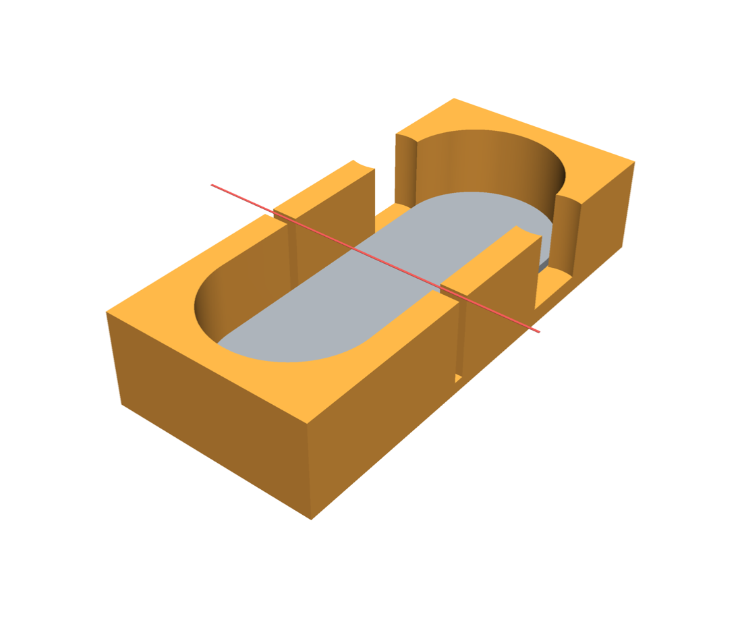
[picture p111: docs/renders/plate_jigs.png]
Steel plate hacksaw guide
