antevens/sladdseg/pcb/eu/fab/eu_mains_board/eu_mains_board_v0.7_assembly_back.pdf

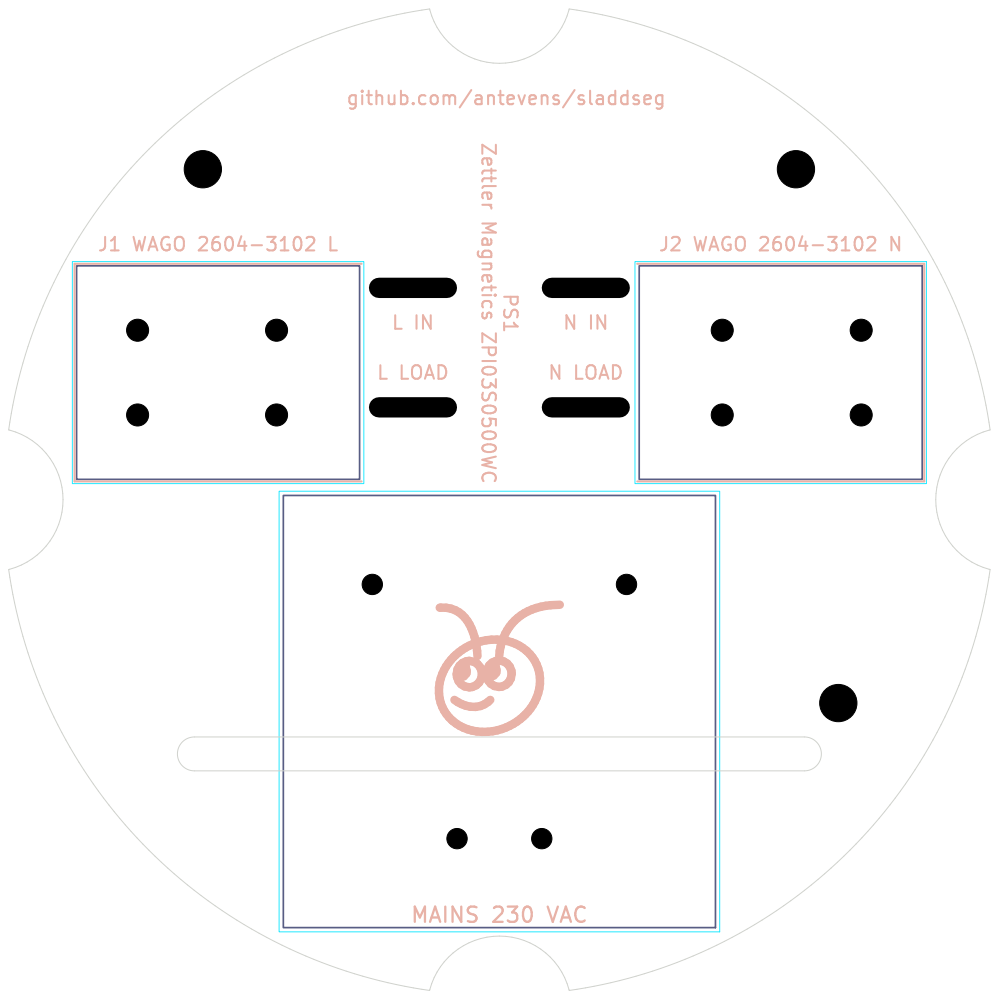
[picture p116: page 1]

github.com/antevens/sladdseg

Id: 1/1 Title: File: eu_mains_board.kicad_pcb Sheet:
