antevens/sladdseg/pcb/eu/fab/eu_mains_board/eu_mains_board_v0.7_assembly_front.pdf

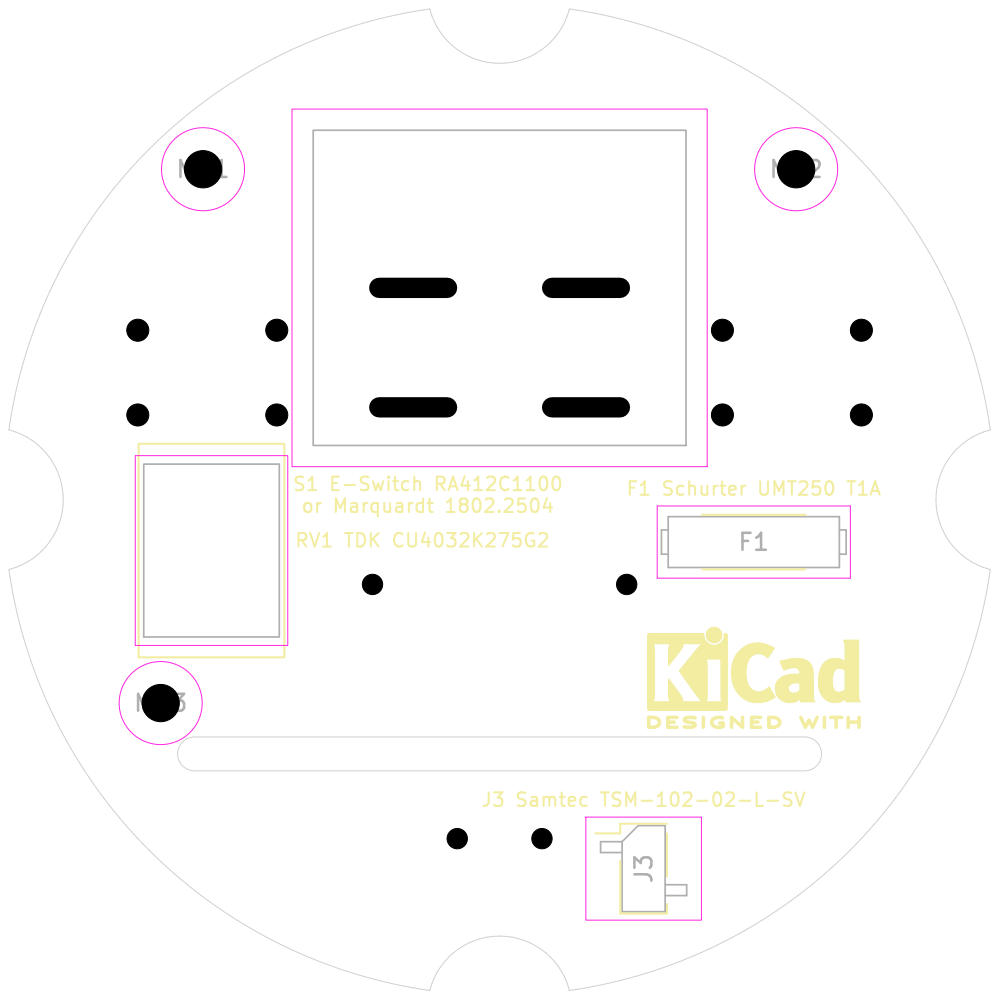
[picture p117: page 1]

Id: 1/1 Title: File: eu_mains_board.kicad_pcb Sheet:
