antevens/sladdseg/pcb/eu/fab/eu_mains_board/eu_mains_board_v0.7_schematic.pdf

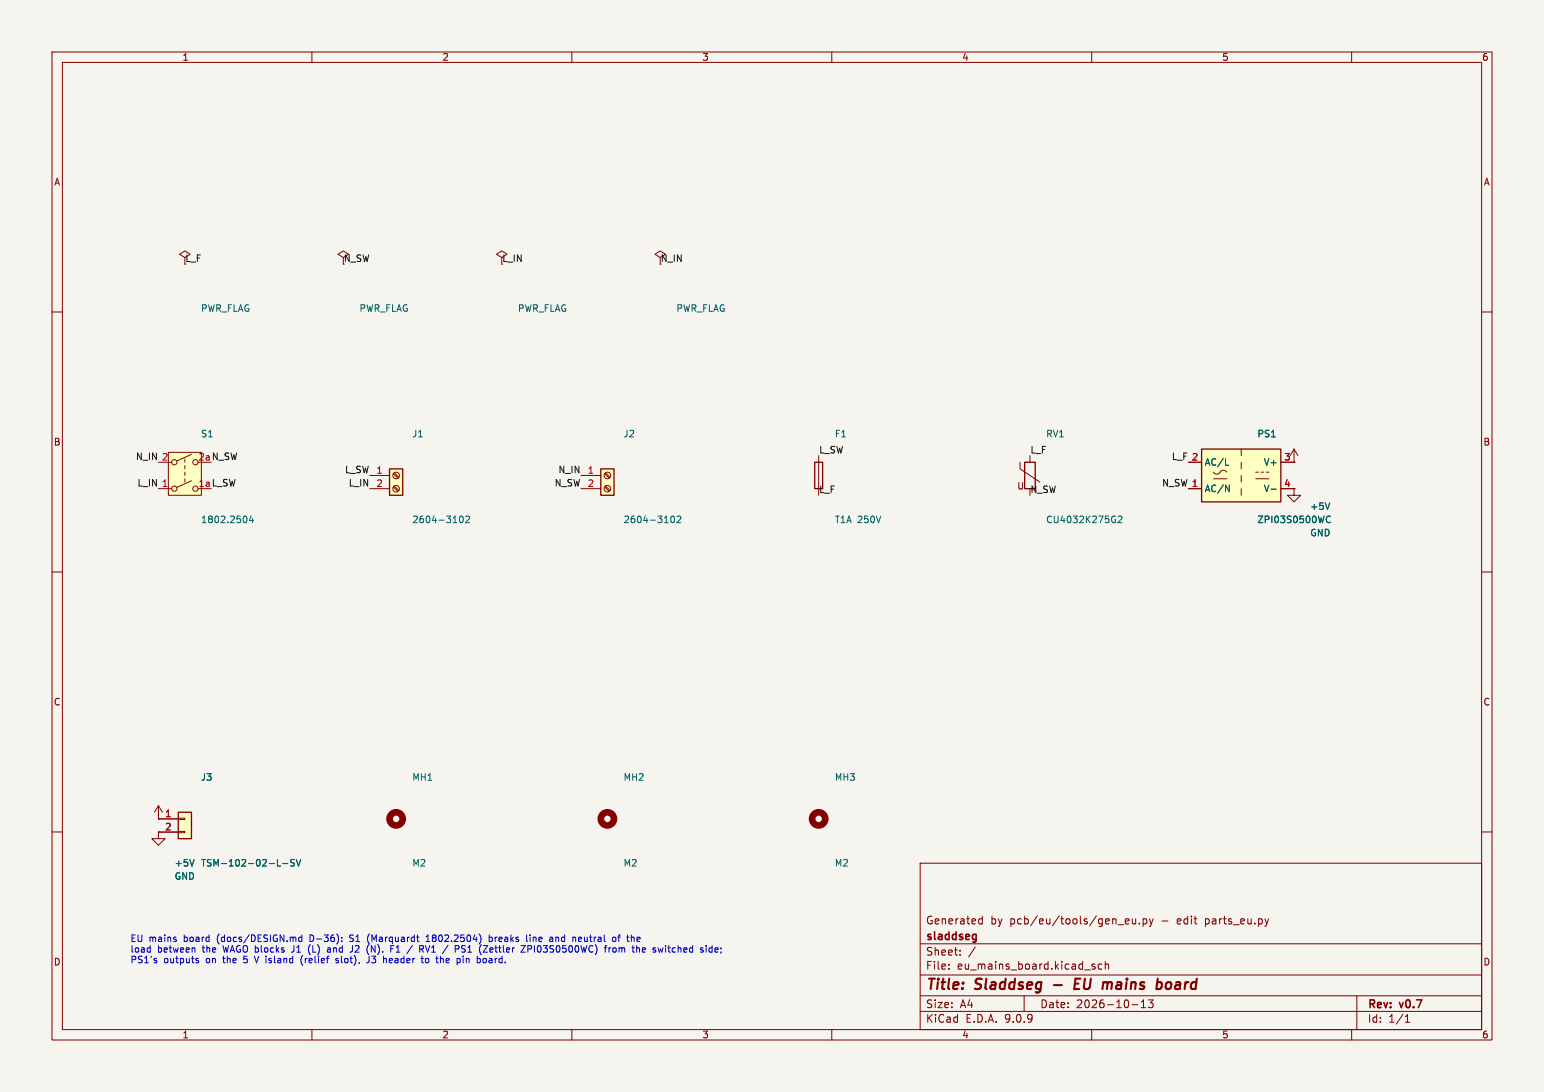
[picture p118: page 1]

Id: 1/1 Title: Sladdseg - EU mains board
