antevens/sladdseg/pcb/eu/fab/eu_pin_board/eu_pin_board_v0.7_schematic.pdf

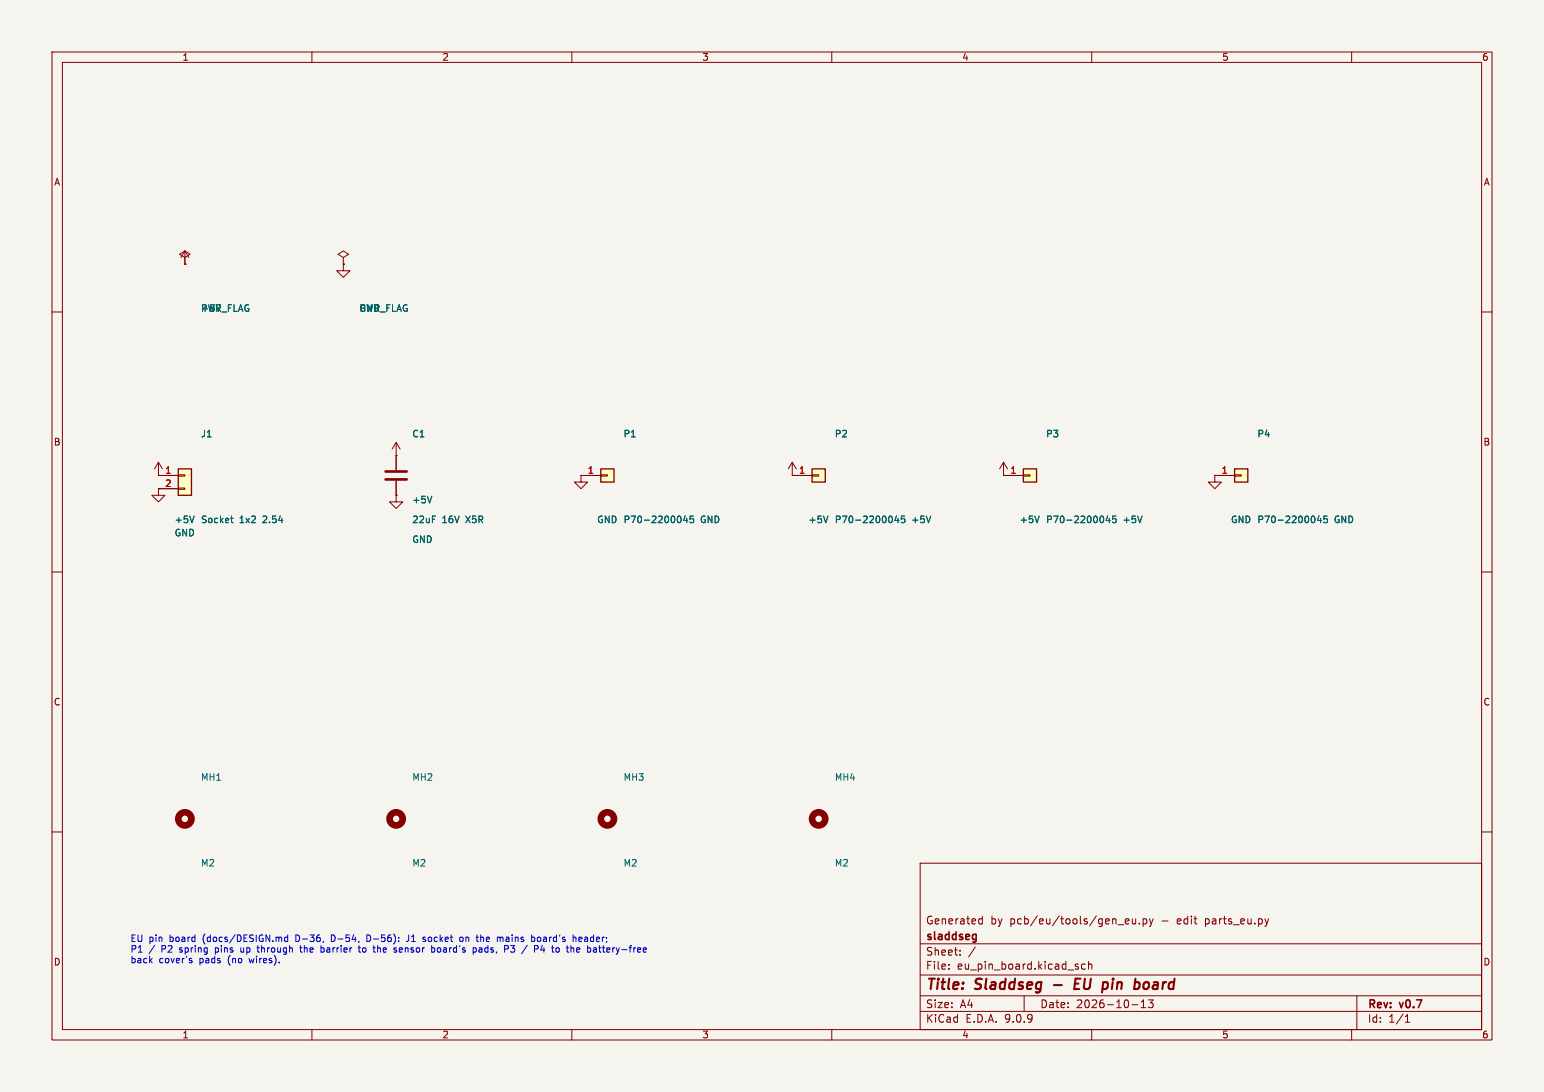
[picture p119: page 1]

back cover's pads (no wires).

Id: 1/1 Title: Sladdseg - EU pin board
