antevens/sladdseg/pcb/na/fab/na_mains_board/na_mains_board_v0.7_assembly_front.pdf

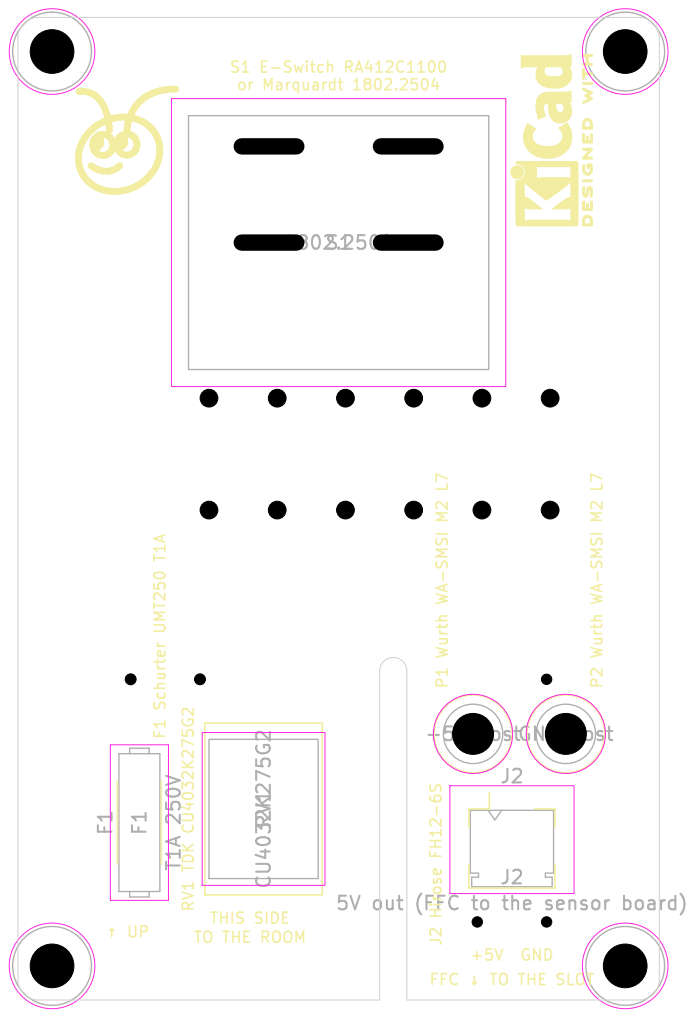
[picture p120: page 1]

Id: 1/1 Title: File: na_mains_board.kicad_pcb Sheet:
