antevens/sladdseg/pcb/na/fab/na_mains_board/na_mains_board_v0.7_schematic.pdf

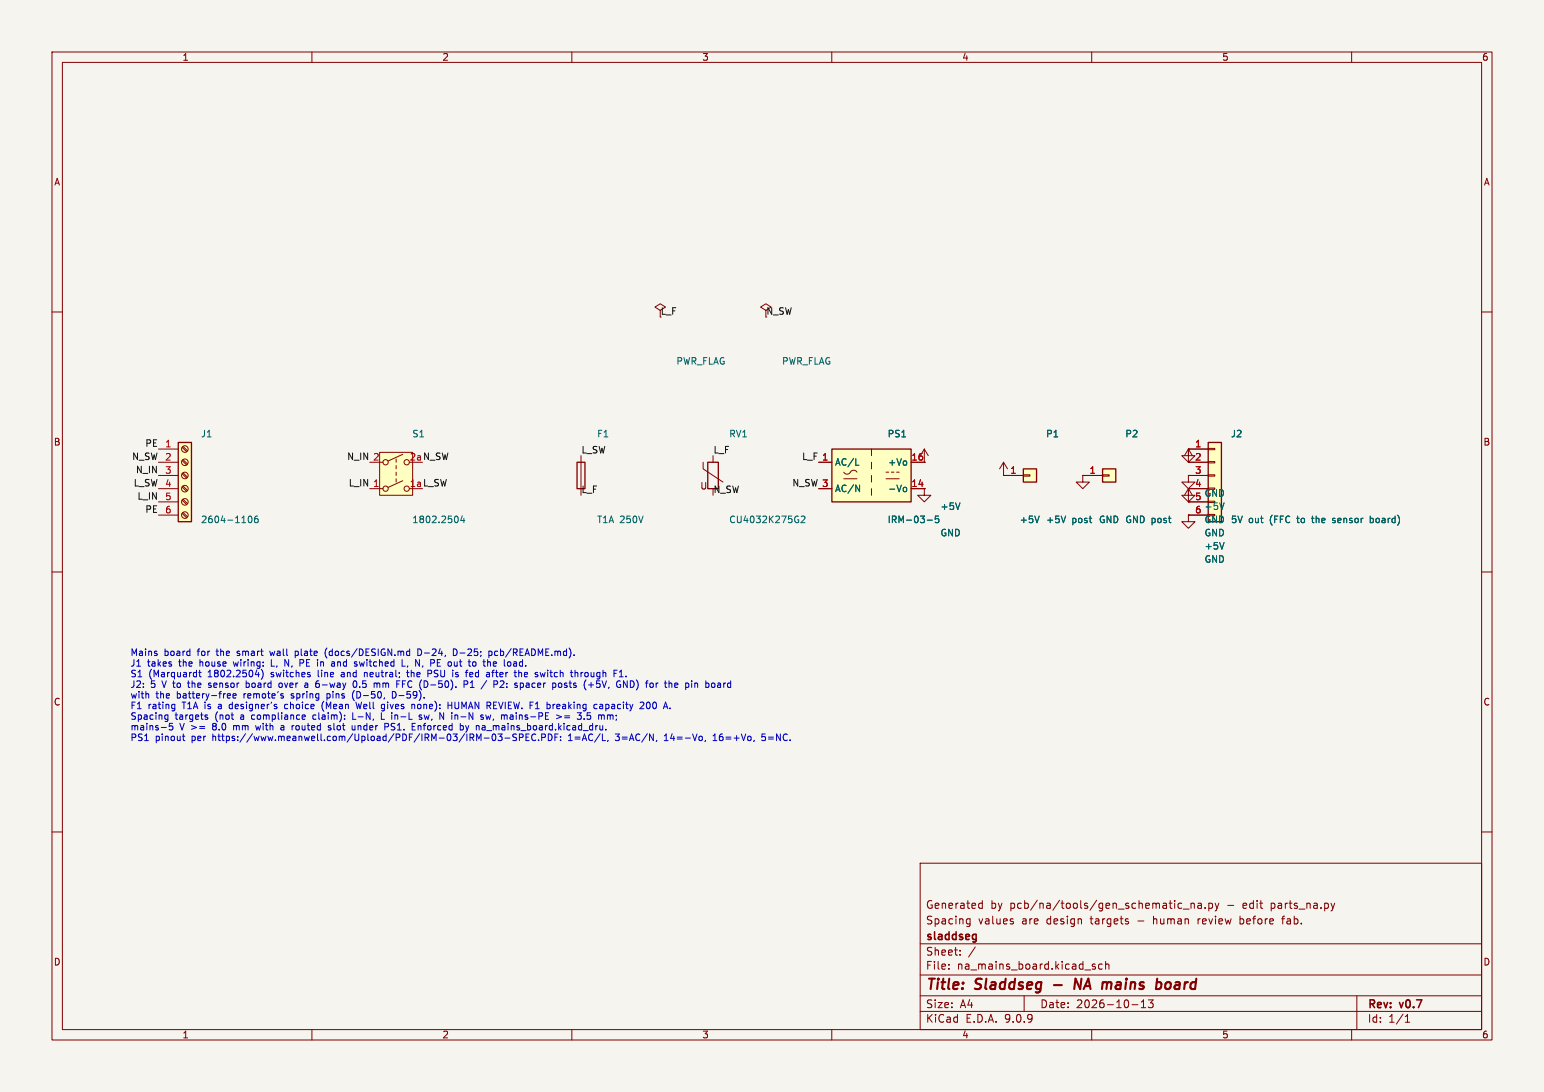
[picture p121: page 1]

Id: 1/1 Title: Sladdseg - NA mains board
