antevens/sladdseg/pcb/order/pcbway/option_a_pcbway_smt/eu_sensor_board/eu_sensor_board_v0.7_PROTOTYPE_fab.pdf

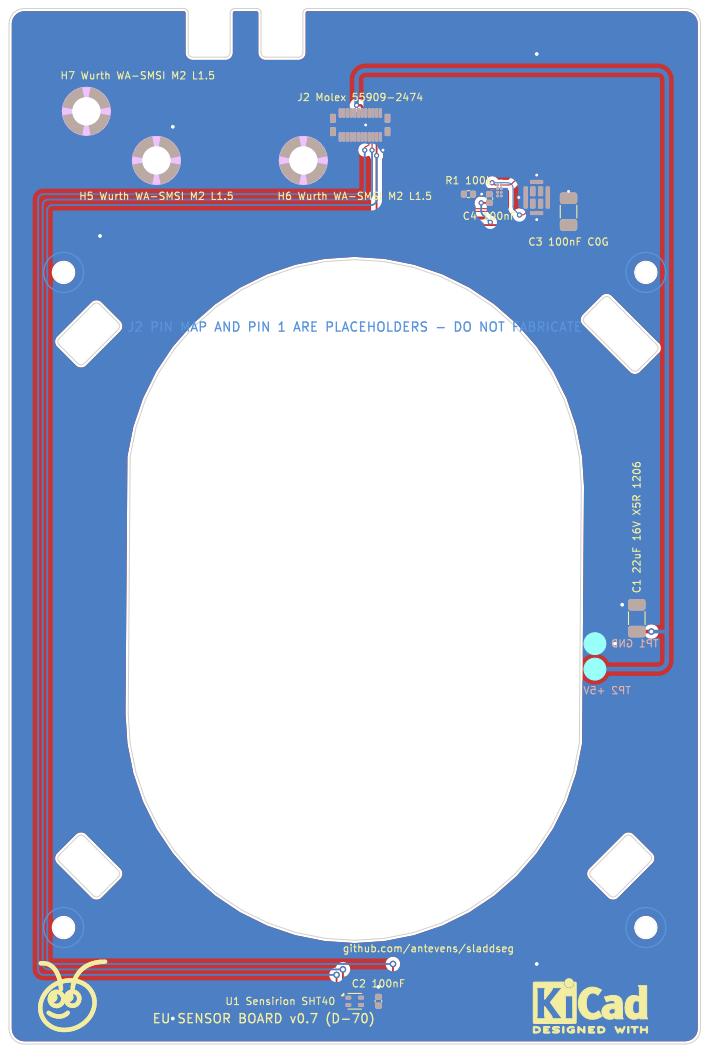
[picture p122: page 1]

H7 Wurth WA-SMSI M2 L1.5 H5 Wurth WA-SMSI M2 L1.5

github.com/antevens/sladdseg

Id: 1/1 Title: File: eu_sensor_board.kicad_pcb Sheet:
