antevens/sladdseg/pcb/order/pcbway/option_a_pcbway_smt/na_pin_board/na_pin_board_v0.7_fab.pdf

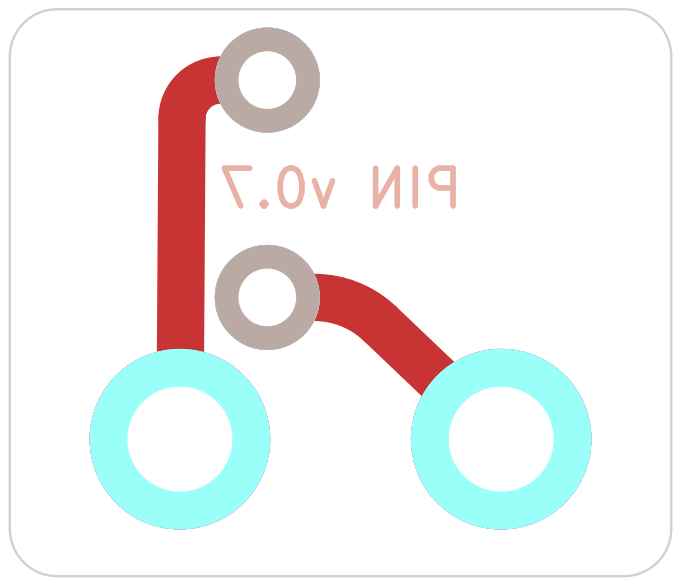
[picture p123: page 1]

Id: 1/1 Title: File: na_pin_board.kicad_pcb Sheet:
