antevens/sladdseg/pcb/order/pcbway/option_a_pcbway_smt/na_sensor_board/na_sensor_board_v0.7_PROTOTYPE_fab.pdf

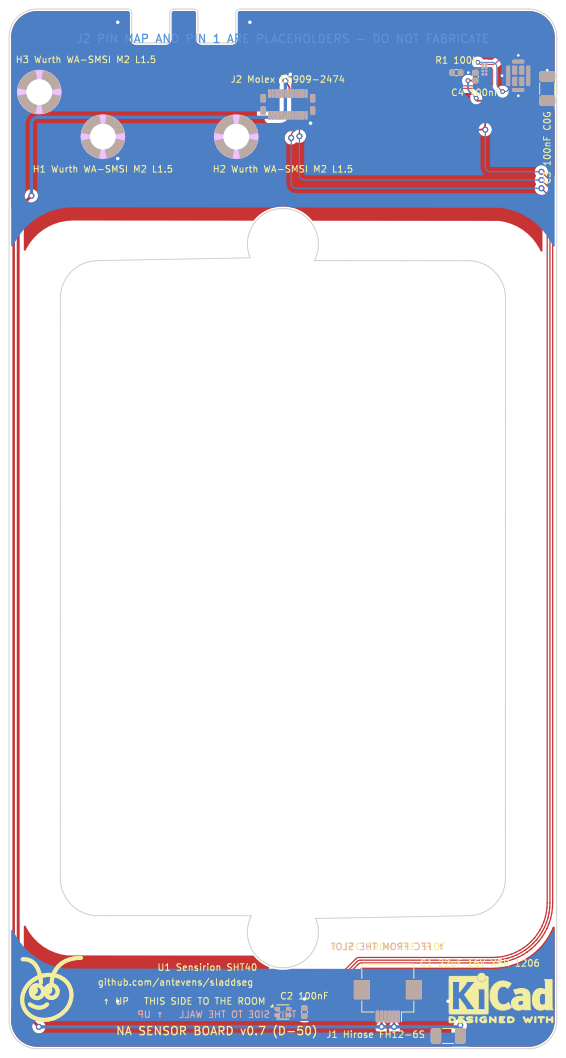
[picture p124: page 1]

J2 PIN MAP AND PIN 1 ARE PLACEHOLDERS - DO NOT FABRICATE

H3 Wurth WA-SMSI M2 L1.5 H1 Wurth WA-SMSI M2 L1.5

þÿ!‘FFC FROM THE SLOT

github.com/antevens/sladdseg

Id: 1/1 Title: File: na_sensor_board.kicad_pcb Sheet:
