antevens/sladdseg/pcb/eu/fab/eu_pin_board/eu_pin_board_v0.7_assembly_back.pdf

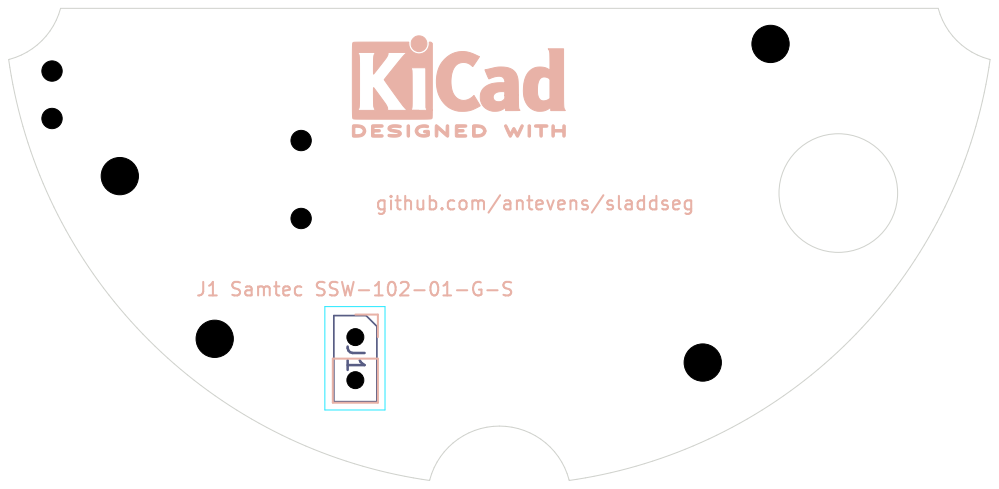
[picture p125: page 1]

github.com/antevens/sladdseg
