antevens/sladdseg/pcb/eu/fab/eu_pin_board/eu_pin_board_v0.7_assembly_front.pdf

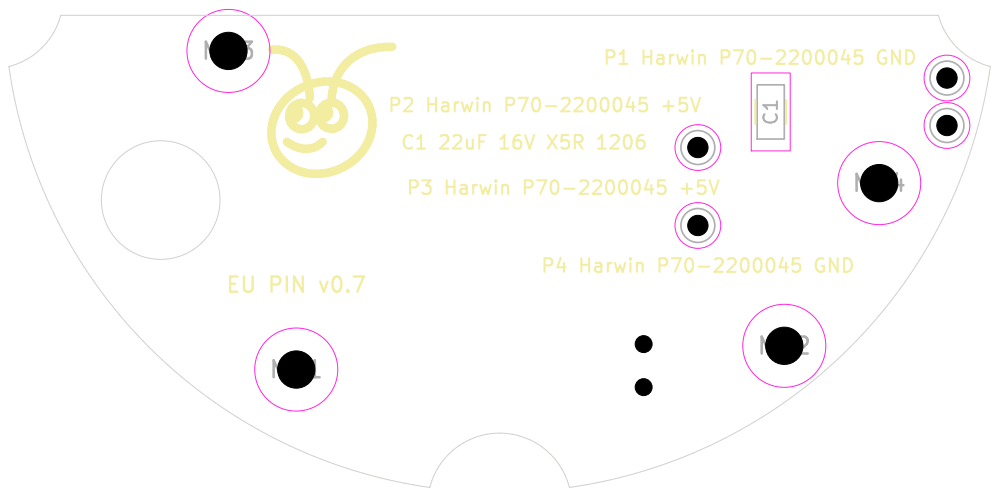
[picture p126: page 1]
