antevens/sladdseg/pcb/na/fab/na_mains_board/na_mains_board_v0.7_assembly_back.pdf

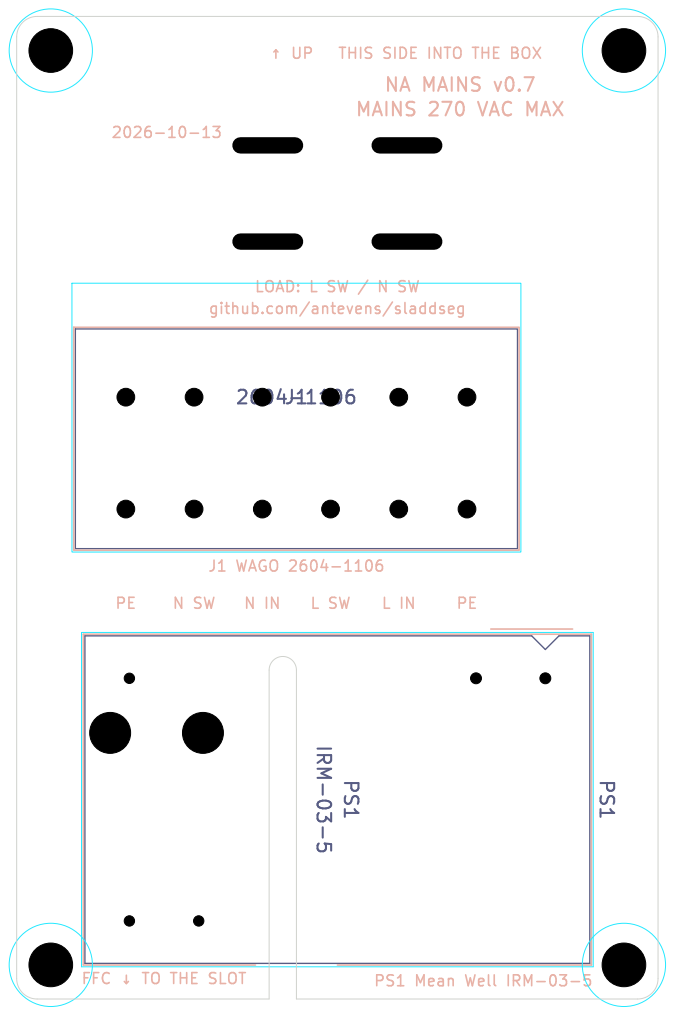
[picture p127: page 1]

LOAD: L SW / N SW
github.com/antevens/sladdseg

PS1 Mean Well IRM-03-5 PE
