antevens/sladdseg/pcb/order/pcbway/option_a_pcbway_smt/cover_flex/cover_flex_v0.7_PROTOTYPE_fab.pdf

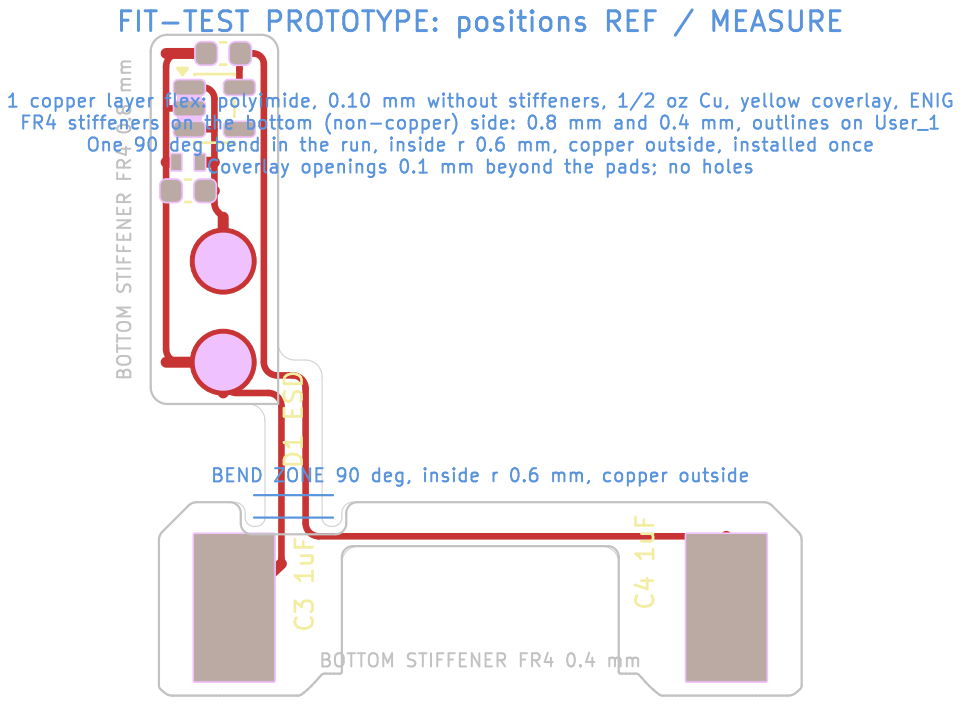
[picture p128: page 1]

Id: 1/1 Title: Sladdseg - back cover flex
