antevens/sladdseg/pcb/order/pcbway/option_b_self_solder/cover_flex/cover_flex_v0.7_PROTOTYPE_fab.pdf

Id: 1/1 Title: Sladdseg - back cover flex
