antevens/sladdseg/pcb/shared/kicad/cover_flex.kicad_pcb

## KiCad design pcb/shared/kicad/cover_flex.kicad_pcb (2026-10-13)

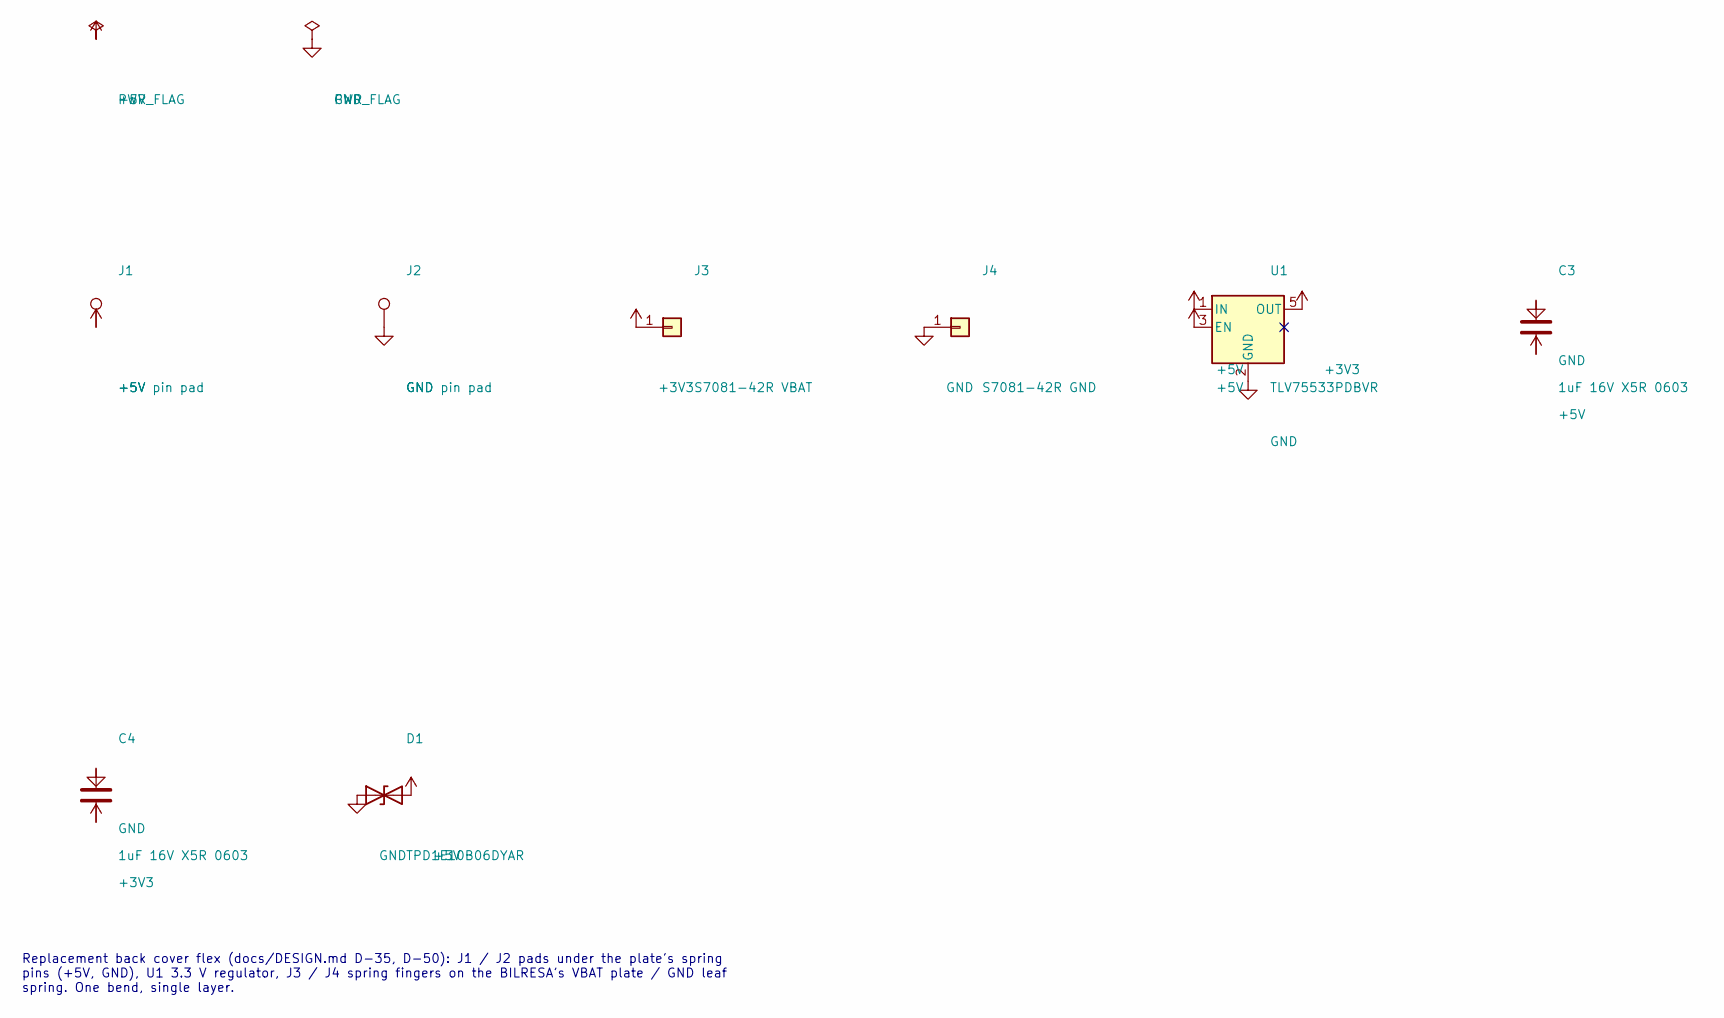
[picture p129: schematic cover_flex.kicad_sch, Sladdseg - back cover flex]

Parts:
C3, C4: 1uF 16V X5R 0603; C_0603_1608Metric; MPN CL10A105KO8NNNC
D1: TPD1E10B06DYAR; D_SOD-523_TI_DYA0002A; MPN TPD1E10B06DYAR
J1: +5V pin pad; Contact_Pad_D2.6mm
J2: GND pin pad; Contact_Pad_D2.6mm
J3: S7081-42R VBAT; Harwin_S7081-42R; MPN S7081-42R
J4: S7081-42R GND; Harwin_S7081-42R; MPN S7081-42R
U1: TLV75533PDBVR; SOT-23-5; MPN TLV75533PDBVR

Connections:
+3V3: C4.2, J3.1, U1.5 (OUT)
+5V: C3.2, D1.2 (A2), J1.1, U1.1 (IN), U1.3 (EN)
GND: C3.1, C4.1, D1.1 (A1), J2.1, J4.1, U1.2 (GND)

Notes on the sheet:
Replacement back cover flex (docs/DESIGN.md D-35, D-50): J1 / J2 pads under the plate's spring pins (+5V, GND), U1 3.3 V regulator, J3 / J4 spring fingers on the BILRESA's VBAT plate / GND leaf spring. One bend, single layer.

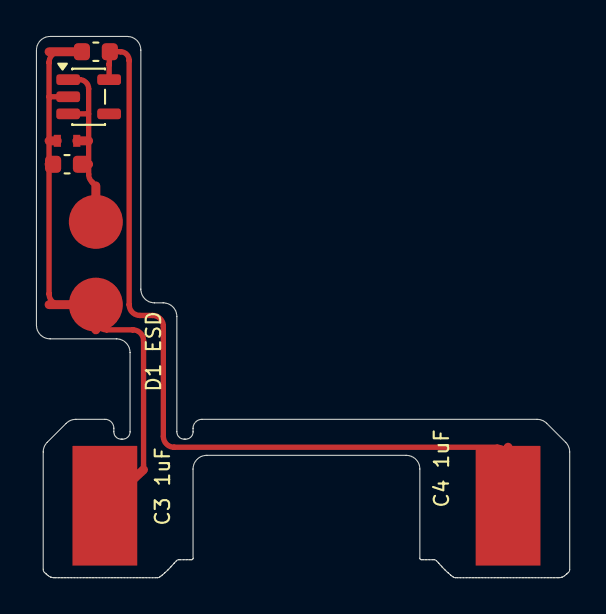
[picture p130: board cover_flex.kicad_pcb from above]

Board: 2 copper layers, 29.6 x 30.1 mm, 8 parts (0 on the bottom side), 3 nets.
