antevens/sladdseg/pcb/eu/kicad/eu_pin_board.kicad_pcb

## KiCad design pcb/eu/kicad/eu_pin_board.kicad_pcb (2026-10-13)

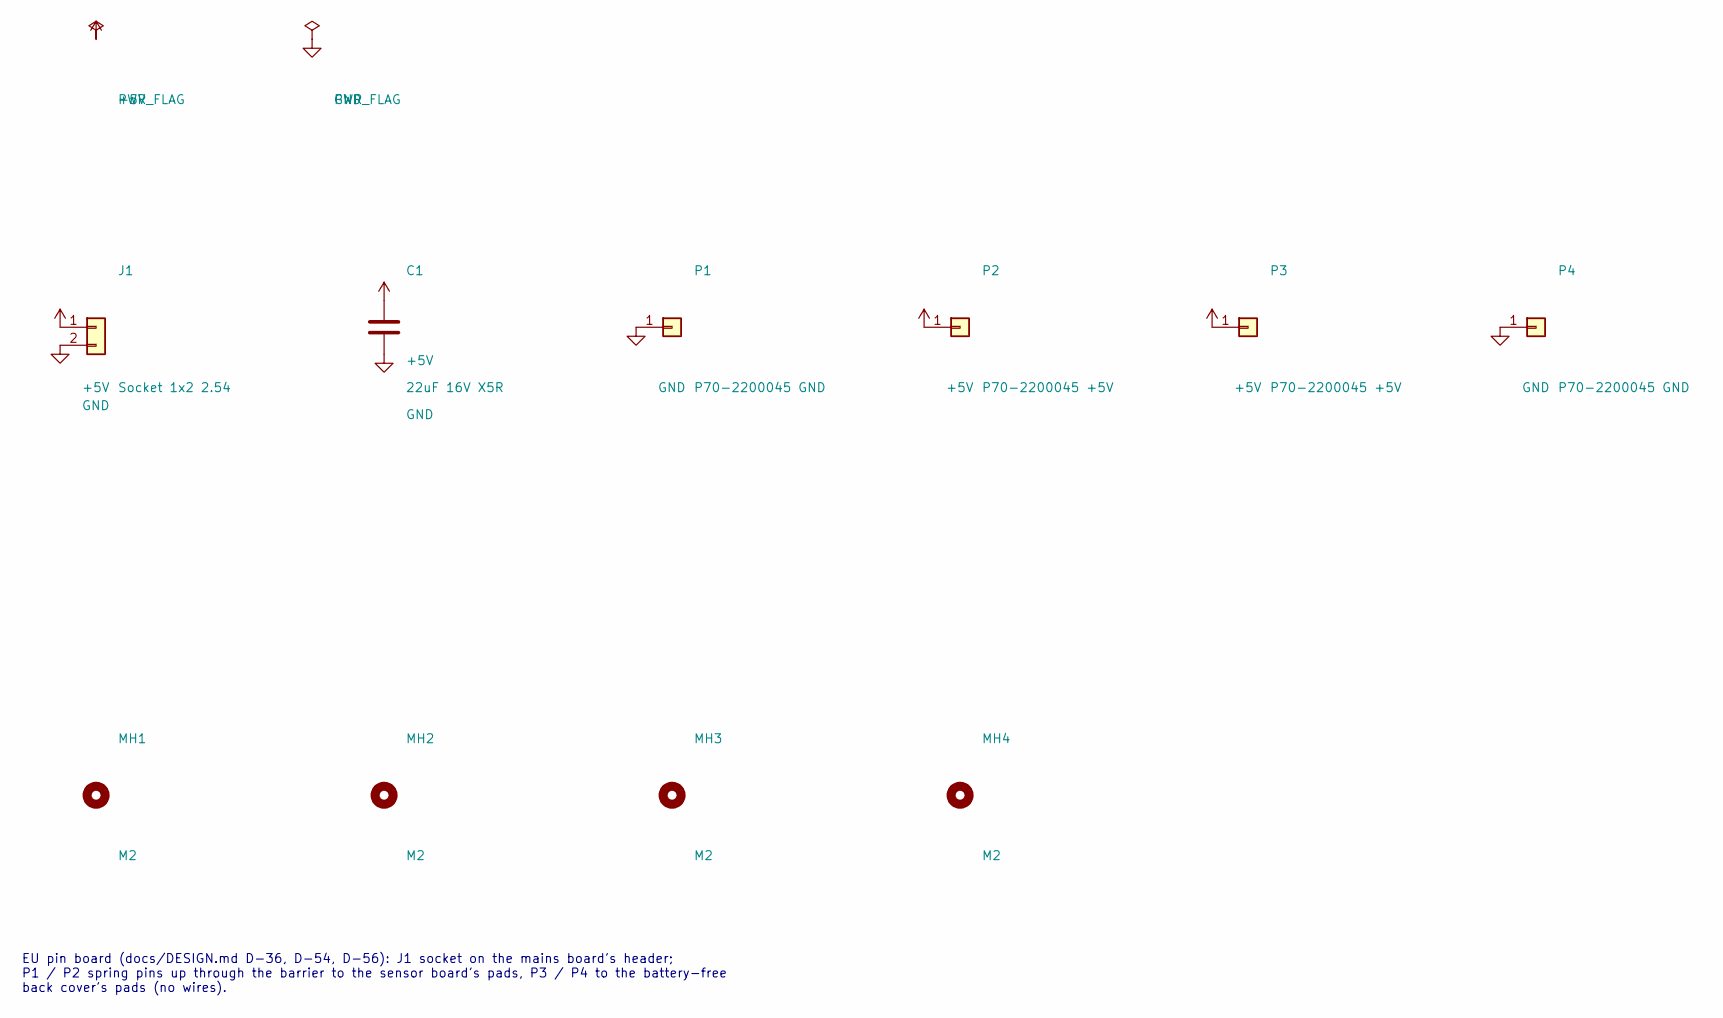
[picture p131: schematic eu_pin_board.kicad_sch, Sladdseg - EU pin board]

Parts:
C1: 22uF 16V X5R; C_1206_3216Metric; MPN C1206C226M4PACTU
J1: Socket 1x2 2.54; PinSocket_1x02_P2.54mm_Vertical; MPN SSW-102-01-G-S
MH1, MH2, MH3, MH4: M2; MountingHole_2.2mm_M2
P1, P4: P70-2200045 GND; Harwin_P70-2200045; MPN P70-2200045
P2, P3: P70-2200045 +5V; Harwin_P70-2200045; MPN P70-2200045

Connections:
+5V: C1.1, J1.1, P2.1, P3.1
GND: C1.2, J1.2, P1.1, P4.1

Notes on the sheet:
EU pin board (docs/DESIGN.md D-36, D-54, D-56): J1 socket on the mains board's header; P1 / P2 spring pins up through the barrier to the sensor board's pads, P3 / P4 to the battery-free back cover's pads (no wires).

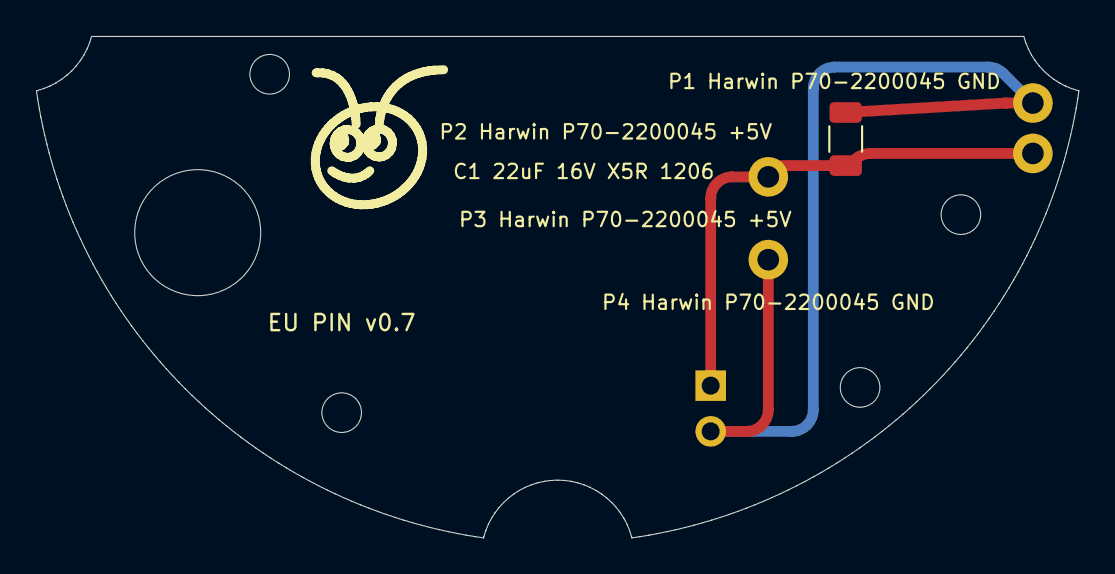
[picture p132: board eu_pin_board.kicad_pcb from above]

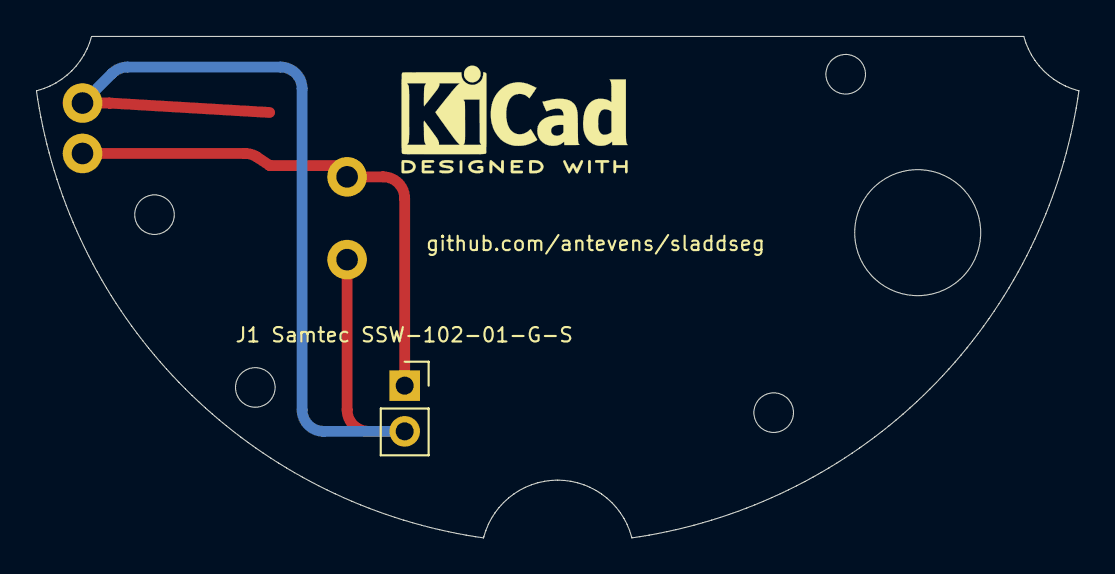
[picture p133: board eu_pin_board.kicad_pcb from below]

Board: 2 copper layers, 57.9 x 27.9 mm, 12 parts (2 on the bottom side), 2 nets.

Other parts of the board:
LOGO1: Ant_Logo_8mm_SilkScreen
LOGO2: KiCad-Logo2_5mm_SilkScreen
