antevens/sladdseg/pcb/eu/kicad/eu_mains_board.kicad_pcb

## KiCad design pcb/eu/kicad/eu_mains_board.kicad_pcb (2026-10-13)

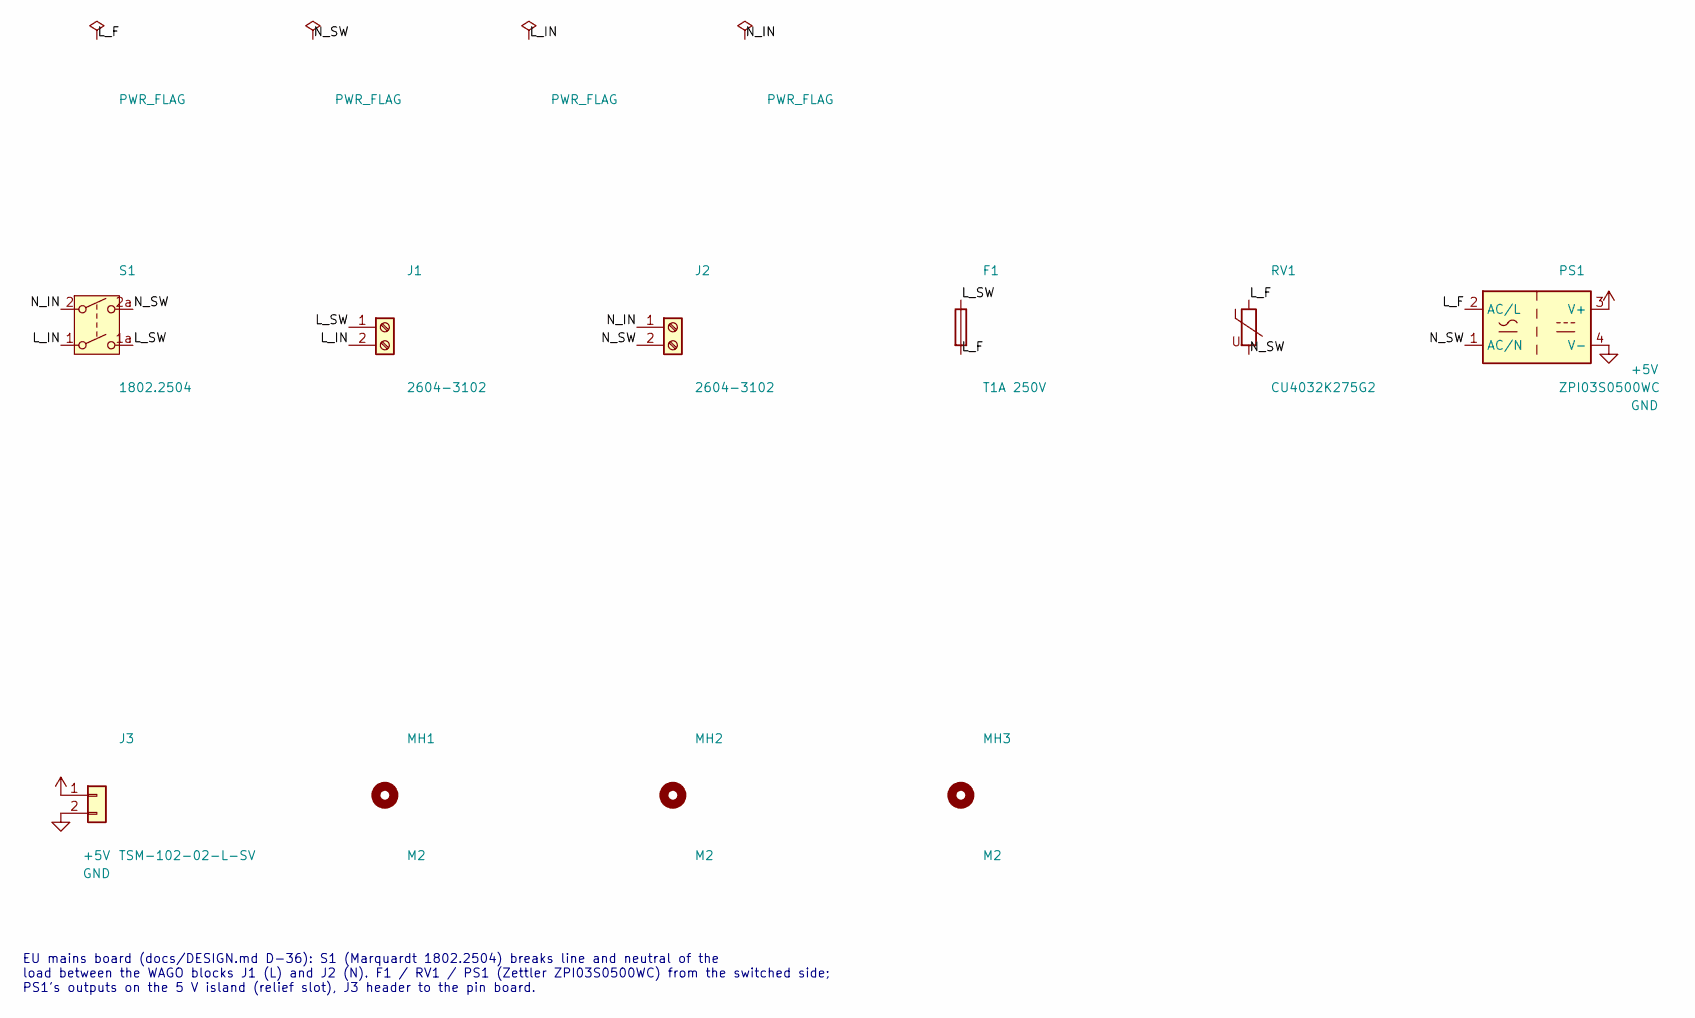
[picture p134: schematic eu_mains_board.kicad_sch, Sladdseg - EU mains board]

Parts:
F1: T1A 250V; Fuse_Schurter_UMT250; MPN 3403.0166.11
J1, J2: 2604-3102; WAGO_2604-3102_1x02_P5.00mm_Vertical; MPN 2604-3102
J3: TSM-102-02-L-SV; PinHeader_1x02_P2.54mm_Vertical_SMD_Pin1Left; MPN TSM-102-02-L-SV
MH1, MH2, MH3: M2; MountingHole_2.2mm_M2
PS1: ZPI03S0500WC; Converter_ACDC_Zettler_ZPI03_THT; MPN ZPI03S0500WC
RV1: CU4032K275G2; Varistor_TDK_CU4032; MPN B72660M0271K093
S1: 1802.2504; Rocker_DPST_Marquardt_1802.2504_E-Switch_RA412C1100; MPN 1802.2504

Connections:
+5V: J3.1, PS1.3 (V+)
/L_F: F1.2, PS1.2 (AC/L), RV1.1
/L_IN: J1.2, S1.1
/L_SW: F1.1, J1.1, S1.1a (2)
/N_IN: J2.1, S1.2 (3)
/N_SW: J2.2, PS1.1 (AC/N), RV1.2, S1.2a (4)
GND: J3.2, PS1.4 (V-)

Notes on the sheet:
EU mains board (docs/DESIGN.md D-36): S1 (Marquardt 1802.2504) breaks line and neutral of the load between the WAGO blocks J1 (L) and J2 (N). F1 / RV1 / PS1 (Zettler ZPI03S0500WC) from the switched side; PS1's outputs on the 5 V island (relief slot), J3 header to the pin board.

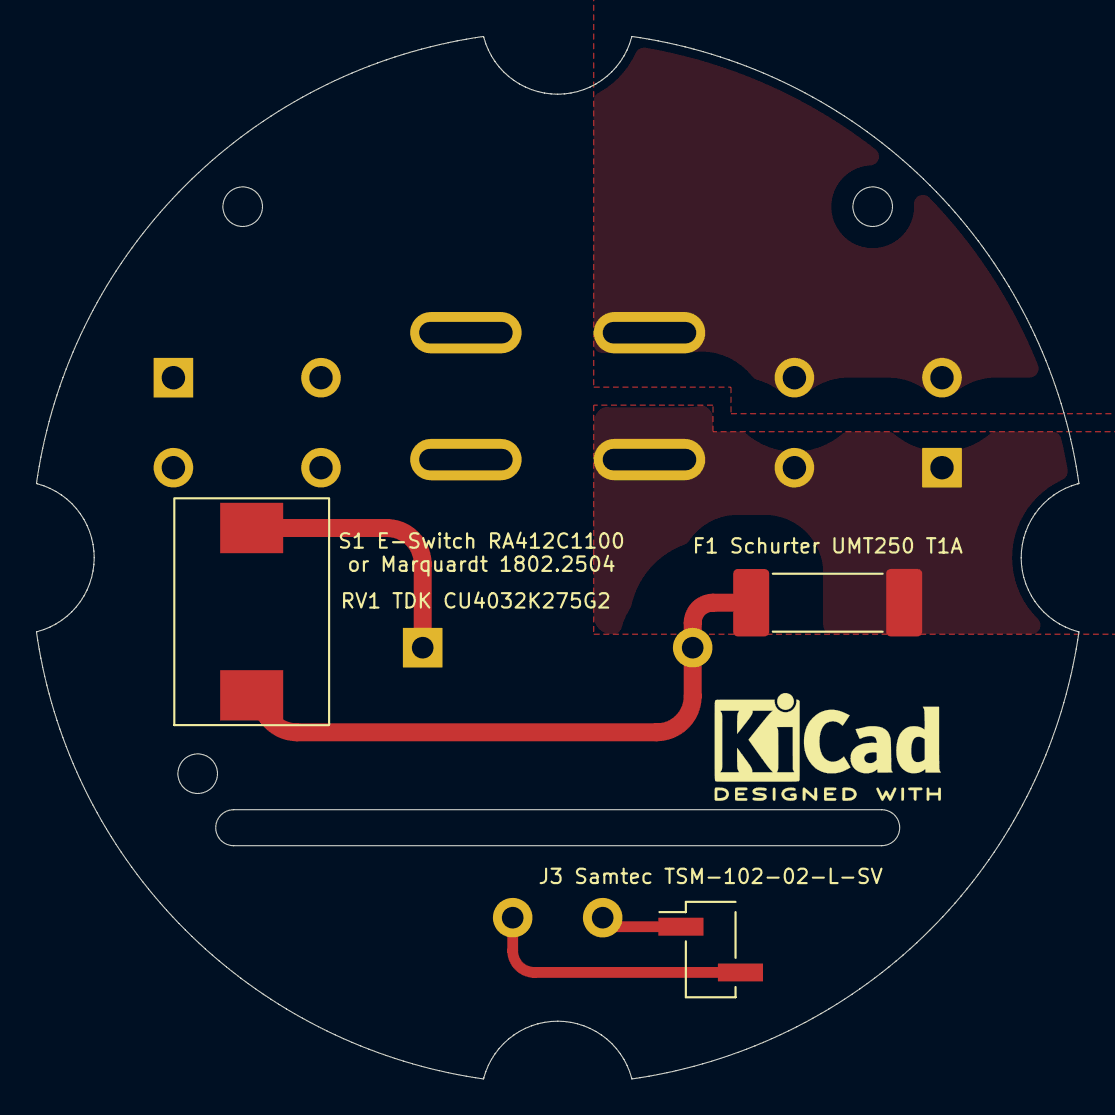
[picture p135: board eu_mains_board.kicad_pcb from above]

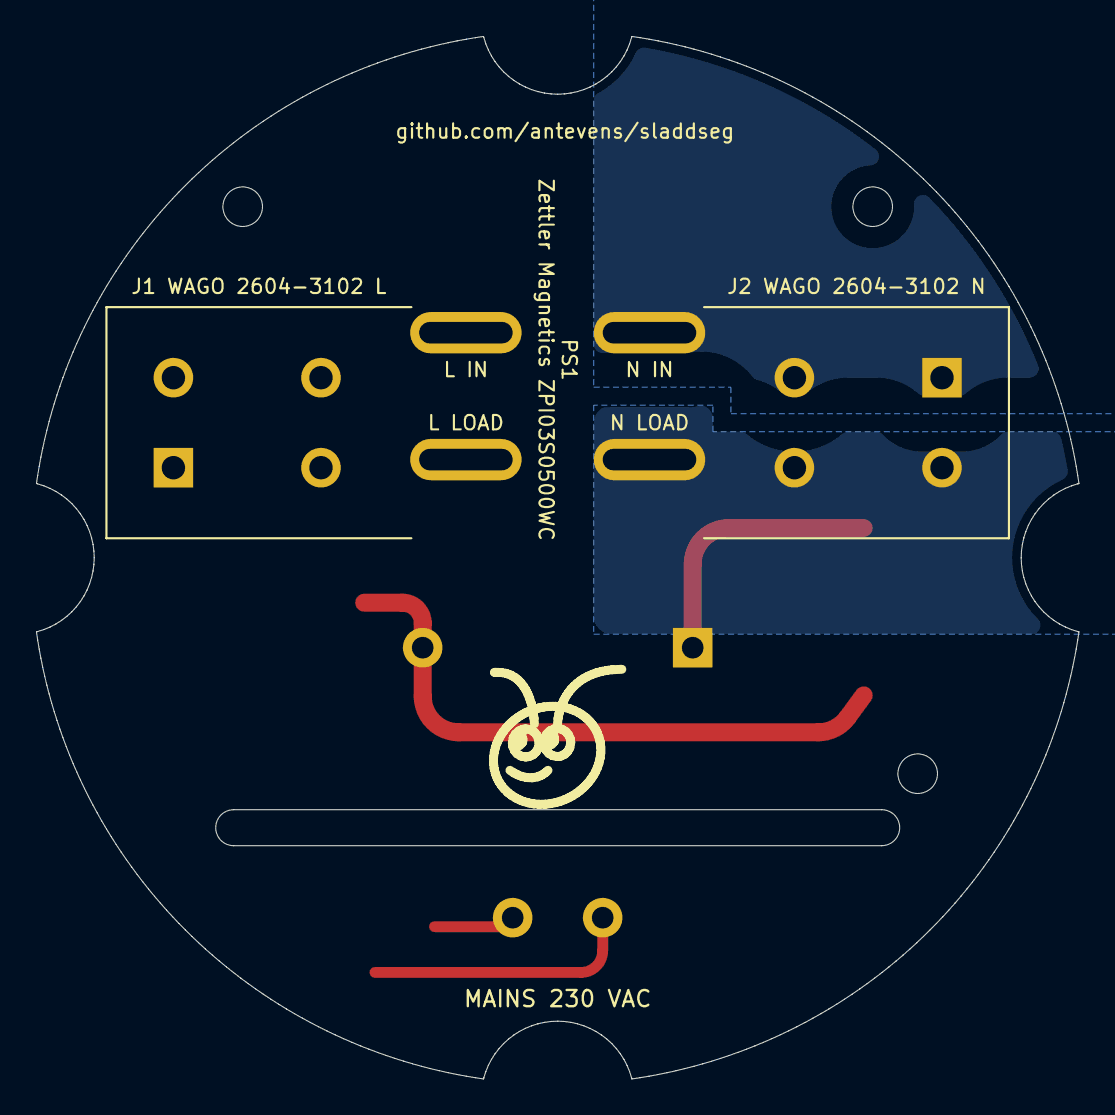
[picture p136: board eu_mains_board.kicad_pcb from below]

Board: 2 copper layers, 57.9 x 57.9 mm, 12 parts (4 on the bottom side), 7 nets.

Other parts of the board:
LOGO1: Ant_Logo_8mm_SilkScreen
LOGO2: KiCad-Logo2_5mm_SilkScreen
