antevens/sladdseg/pcb/na/kicad/na_sensor_board.kicad_pcb

## KiCad design pcb/na/kicad/na_sensor_board.kicad_pcb (2026-10-13)

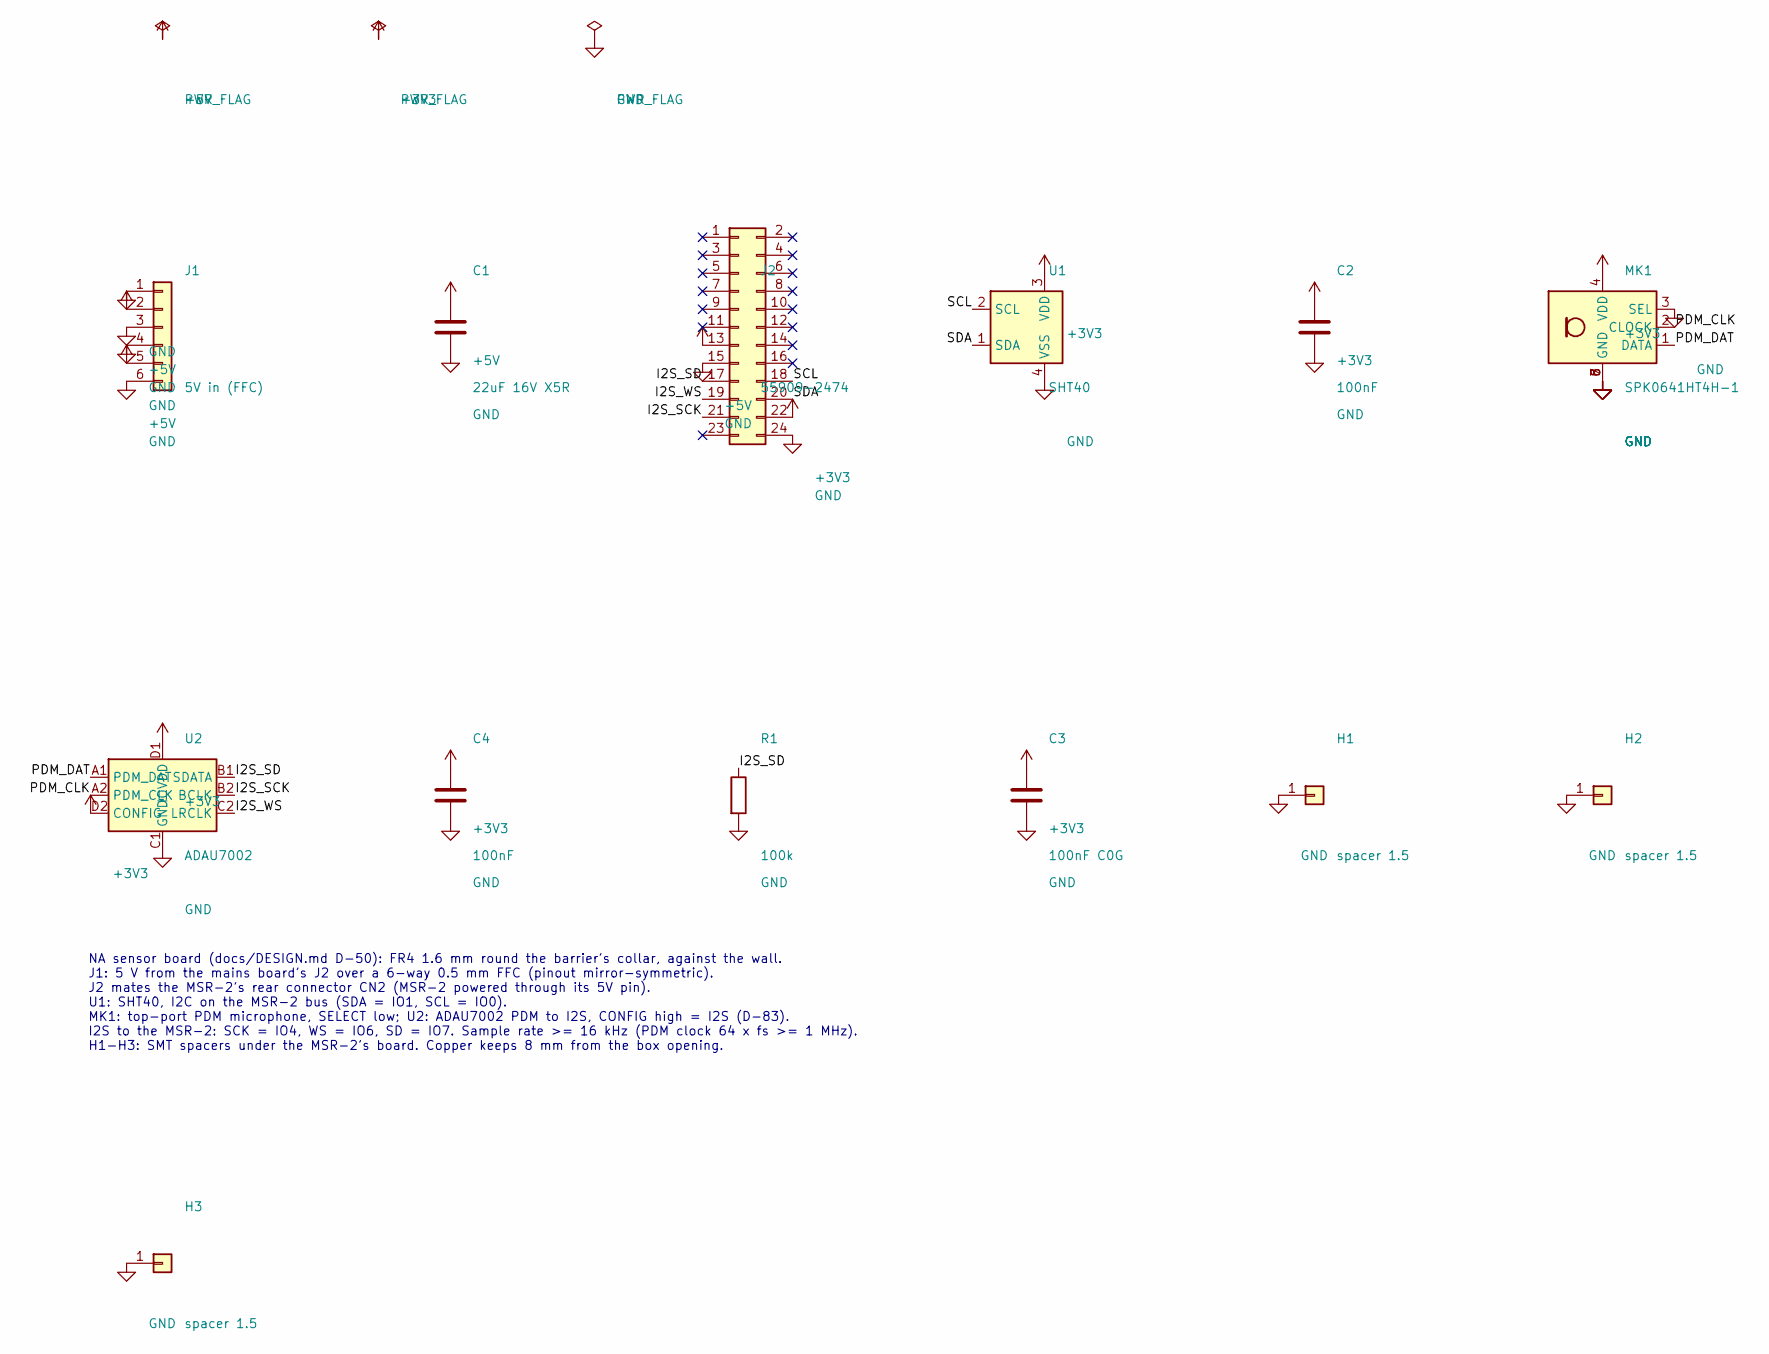
[picture p137: schematic na_sensor_board.kicad_sch, Sladdseg - NA sensor board]

Parts:
C1: 22uF 16V X5R; C_1206_3216Metric; MPN C1206C226M4PACTU
C2, C4: 100nF; C_0402_1005Metric; MPN 0402 X7R 100 nF 16 V
C3: 100nF C0G; C_1206_3216Metric; MPN GRM3195C1H104JA05D
H1, H2, H3: spacer 1.5; Wurth_WA-SMSI_M2_SMT_Spacer_L1.5mm; MPN 9774015243R
J1: 5V in (FFC); Hirose_FH12-6S-0.5SH_1x06-1MP_P0.50mm_Horizontal; MPN FH12-6S-0.5SH(55)
J2: 55909-2474; Molex_SlimStack_55909-2474_2x12_P0.40mm_Vertical; MPN 55909-2474
MK1: SPK0641HT4H-1; Knowles_SPK0641HT4H-1_3x4mm; MPN SPK0641HT4H-1
R1: 100k; R_0402_1005Metric; MPN 0402 1% 100 kOhm
U1: SHT40; Sensirion_DFN-4_1.5x1.5mm_P0.8mm_SHT4x_NoCentralPad; MPN SHT40-AD1B-R2
U2: ADAU7002; Analog_WLCSP-8_0.76x1.56mm_P0.4mm; MPN ADAU7002ACBZ-R7

Connections:
+3V3: C2.1, C3.1, C4.1, J2.22, MK1.4 (VDD), U1.3 (VDD), U2.D1 (IOVDD), U2.D2 (CONFIG)
+5V: C1.1, J1.2, J1.5, J2.13
/I2S_SCK: J2.21, U2.B2 (BCLK)
/I2S_SD: J2.17, R1.1, U2.B1 (SDATA)
/I2S_WS: J2.19, U2.C2 (LRCLK)
/PDM_CLK: MK1.2 (CLOCK), U2.A2 (PDM_CLK)
/PDM_DAT: MK1.1 (DATA), U2.A1 (PDM_DAT)
/SCL: J2.18, U1.2 (SCL)
/SDA: J2.20, U1.1 (SDA)
GND: C1.2, C2.2, C3.2, C4.2, H1.1, H2.1, H3.1, J1.1, J1.3, J1.4, J1.6, J2.15, J2.24, MK1.3 (SEL), MK1.5 (GND), MK1.6 (GND), MK1.7 (GND), MK1.8 (GND), R1.2, U1.4 (VSS), U2.C1 (GND)

Notes on the sheet:
NA sensor board (docs/DESIGN.md D-50): FR4 1.6 mm round the barrier's collar, against the wall. J1: 5 V from the mains board's J2 over a 6-way 0.5 mm FFC (pinout mirror-symmetric). J2 mates the MSR-2's rear connector CN2 (MSR-2 powered through its 5V pin). U1: SHT40, I2C on the MSR-2 bus (SDA = IO1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

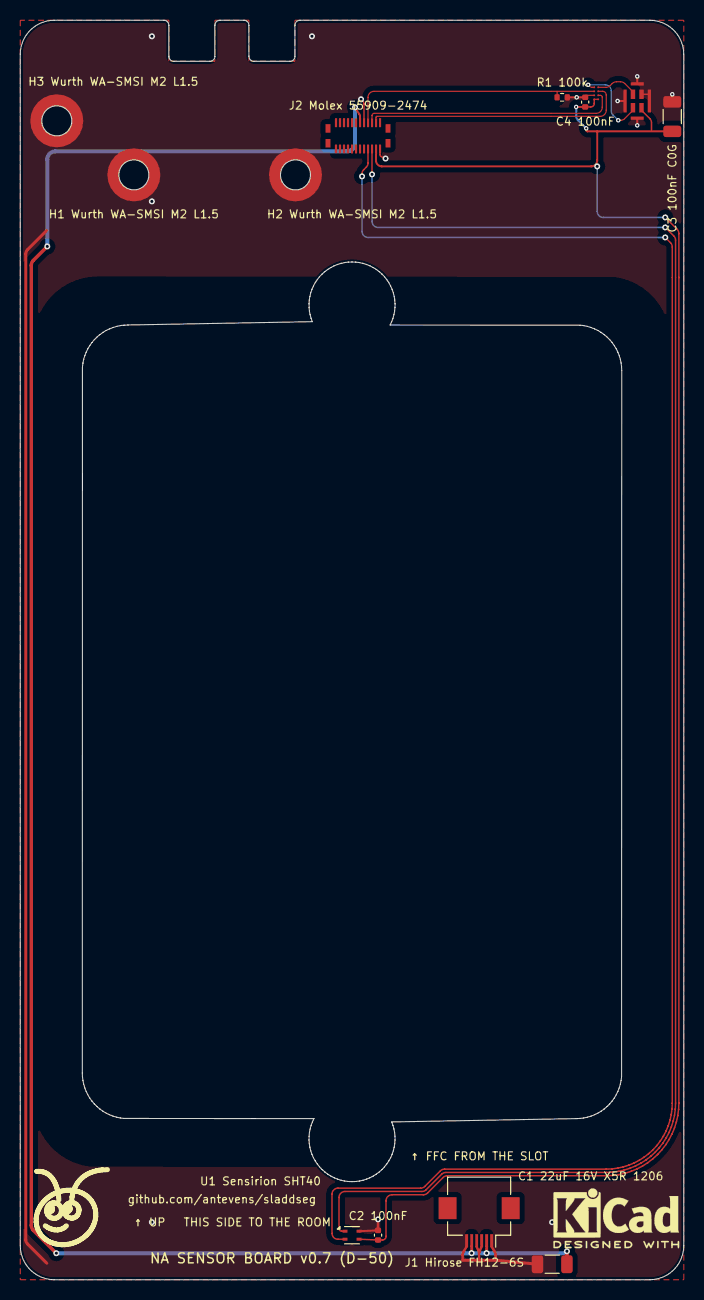
[picture p138: board na_sensor_board.kicad_pcb from above]

Board: 2 copper layers, 66.3 x 125.8 mm, 15 parts (0 on the bottom side), 10 nets.

Other parts of the board:
LOGO1: Ant_Logo_8mm_SilkScreen
LOGO2: KiCad-Logo2_5mm_SilkScreen
