antevens/sladdseg/pcb/na/kicad/na_pin_board.kicad_pcb

## KiCad design pcb/na/kicad/na_pin_board.kicad_pcb (2026-10-13)

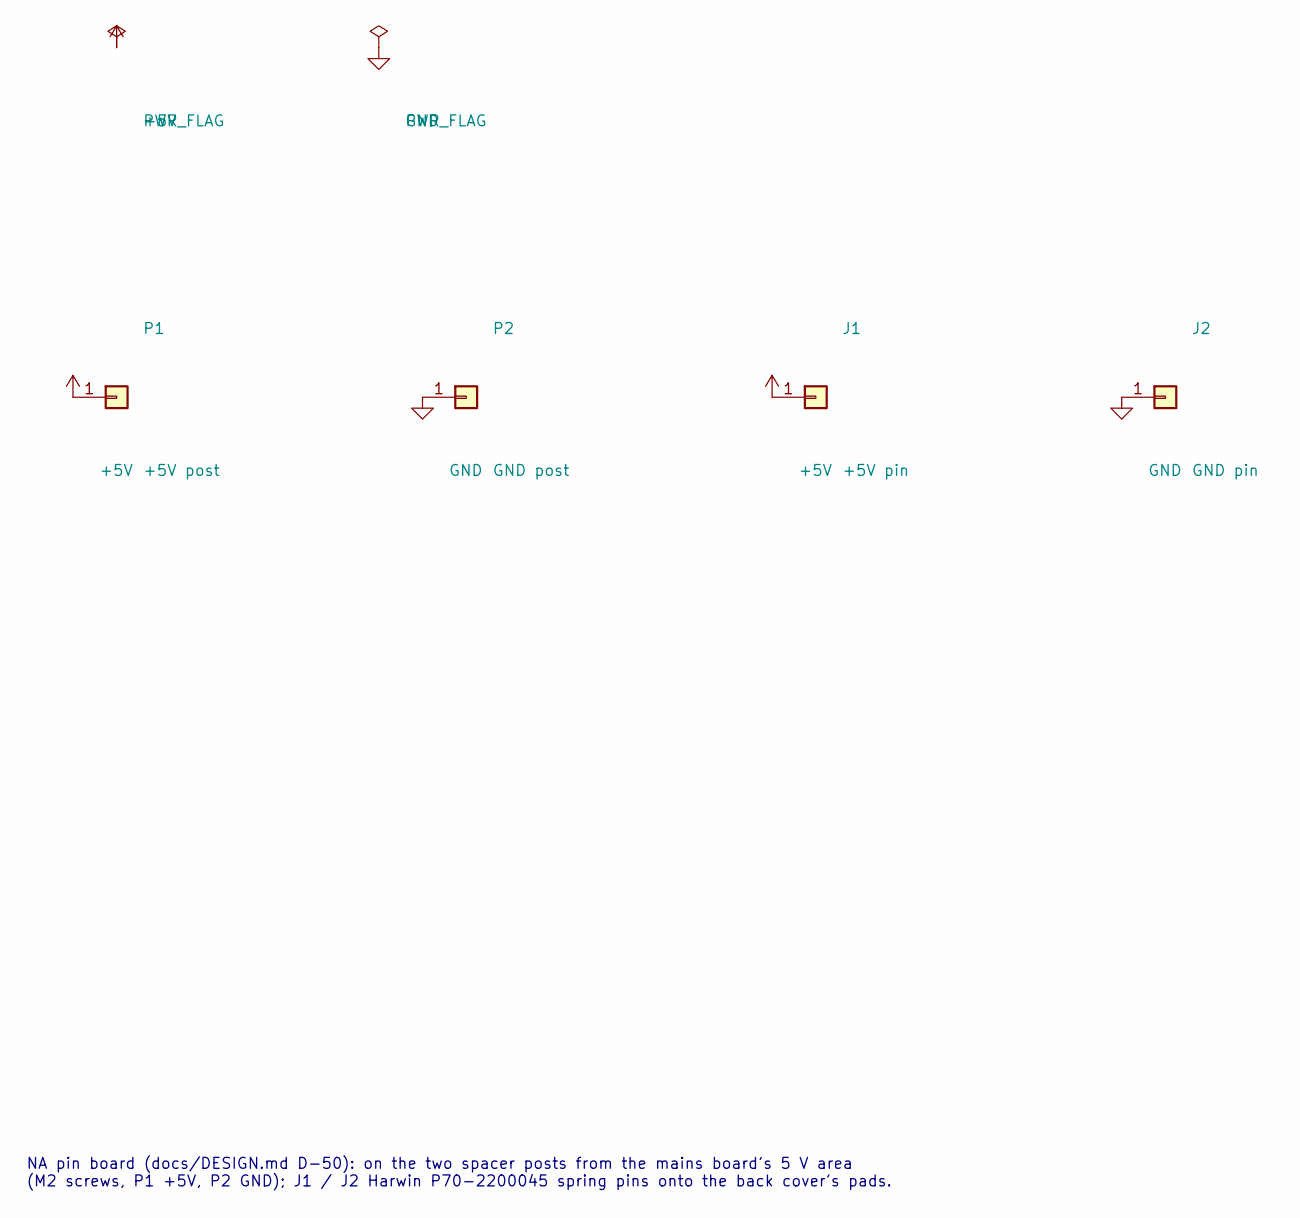
[picture p139: schematic na_pin_board.kicad_sch, Sladdseg - NA pin board]

Parts:
J1: +5V pin; Harwin_P70-2200045; MPN P70-2200045
J2: GND pin; Harwin_P70-2200045; MPN P70-2200045
P1: +5V post; M2_Post_Pad_D3.8mm
P2: GND post; M2_Post_Pad_D3.8mm

Connections:
+5V: J1.1, P1.1
GND: J2.1, P2.1

Notes on the sheet:
NA pin board (docs/DESIGN.md D-50): on the two spacer posts from the mains board's 5 V area (M2 screws, P1 +5V, P2 GND); J1 / J2 Harwin P70-2200045 spring pins onto the back cover's pads.

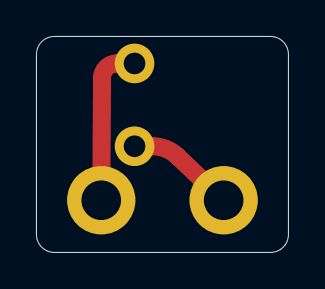
[picture p140: board na_pin_board.kicad_pcb from above]

Board: 2 copper layers, 14.0 x 12.0 mm, 4 parts (0 on the bottom side), 2 nets.
