antevens/sladdseg/pcb/na/kicad/na_mains_board.kicad_pcb

## KiCad design pcb/na/kicad/na_mains_board.kicad_pcb (2026-10-13)

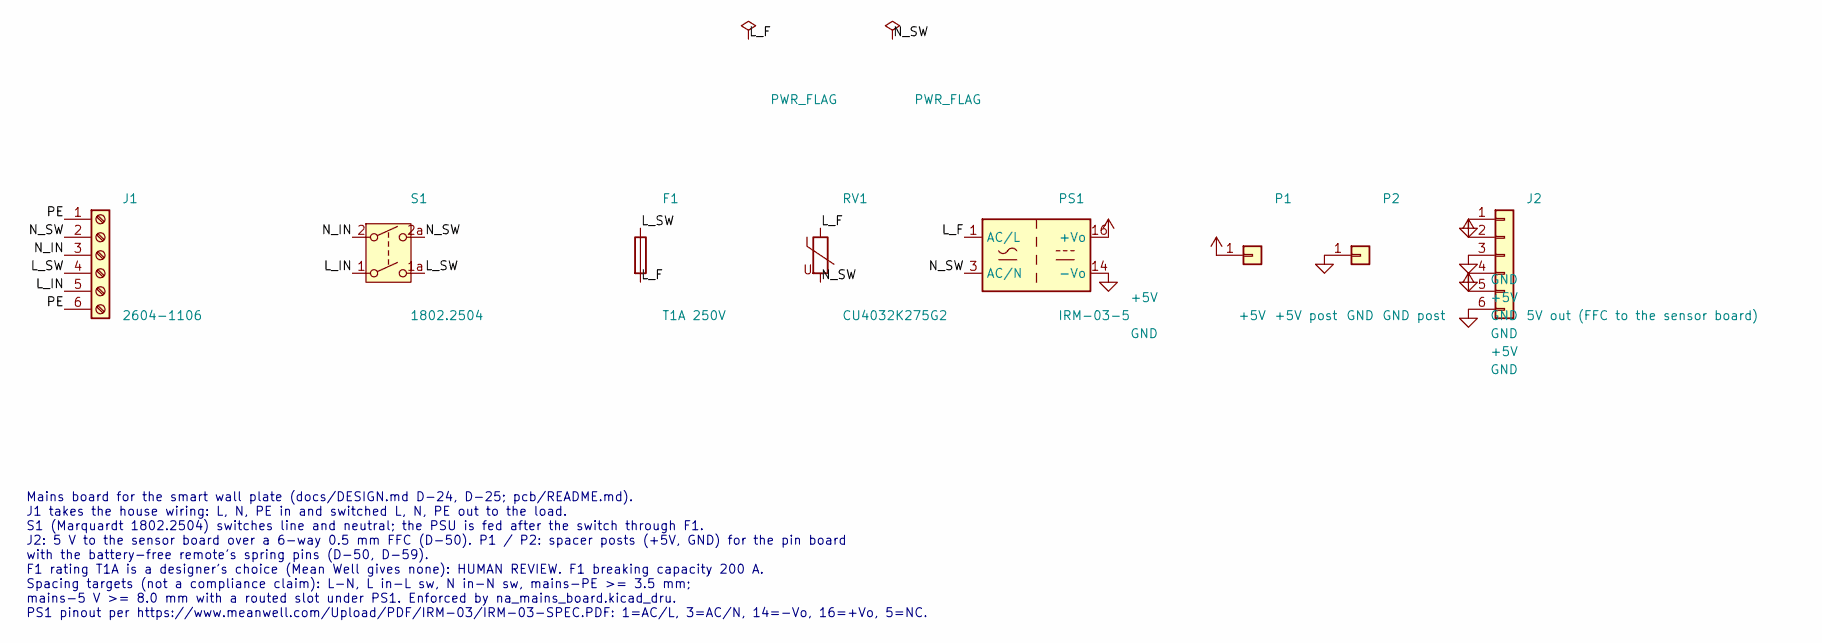
[picture p141: schematic na_mains_board.kicad_sch, Sladdseg - NA mains board]

Parts:
F1: T1A 250V; Fuse_Schurter_UMT250; MPN 3403.0166.11
J1: 2604-1106; WAGO_2604-1106_1x06_P5.00mm_Horizontal; MPN 2604-1106
J2: 5V out (FFC to the sensor board); Hirose_FH12-6S-0.5SH_1x06-1MP_P0.50mm_Horizontal; MPN FH12-6S-0.5SH(55)
P1: +5V post; Wurth_WA-SMSI_M2_SMT_Spacer_L7mm; MPN 9774070243R
P2: GND post; Wurth_WA-SMSI_M2_SMT_Spacer_L7mm; MPN 9774070243R
PS1: IRM-03-5; Converter_ACDC_MeanWell_IRM-03-xx_THT; MPN IRM-03-5
RV1: CU4032K275G2; Varistor_TDK_CU4032; MPN B72660M0271K093
S1: 1802.2504; Rocker_DPST_Marquardt_1802.2504_E-Switch_RA412C1100; MPN 1802.2504

Connections:
+5V: J2.2, J2.5, P1.1, PS1.16 (+Vo)
/L_F: F1.2, PS1.1 (AC/L), RV1.1
/L_IN: J1.5, S1.1
/L_SW: F1.1, J1.4, S1.1a (2)
/N_IN: J1.3, S1.2 (3)
/N_SW: J1.2, PS1.3 (AC/N), RV1.2, S1.2a (4)
/PE: J1.1, J1.6
GND: J2.1, J2.3, J2.4, J2.6, P2.1, PS1.14 (-Vo)

Notes on the sheet:
Mains board for the smart wall plate (docs/DESIGN.md D-24, D-25; pcb/README.md). J1 takes the house wiring: L, N, PE in and switched L, N, PE out to the load. S1 (Marquardt 1802.2504) switches line and neutral; the PSU is fed after the switch through F1. J2: 5 V to the sensor board over a 6-way 0.5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

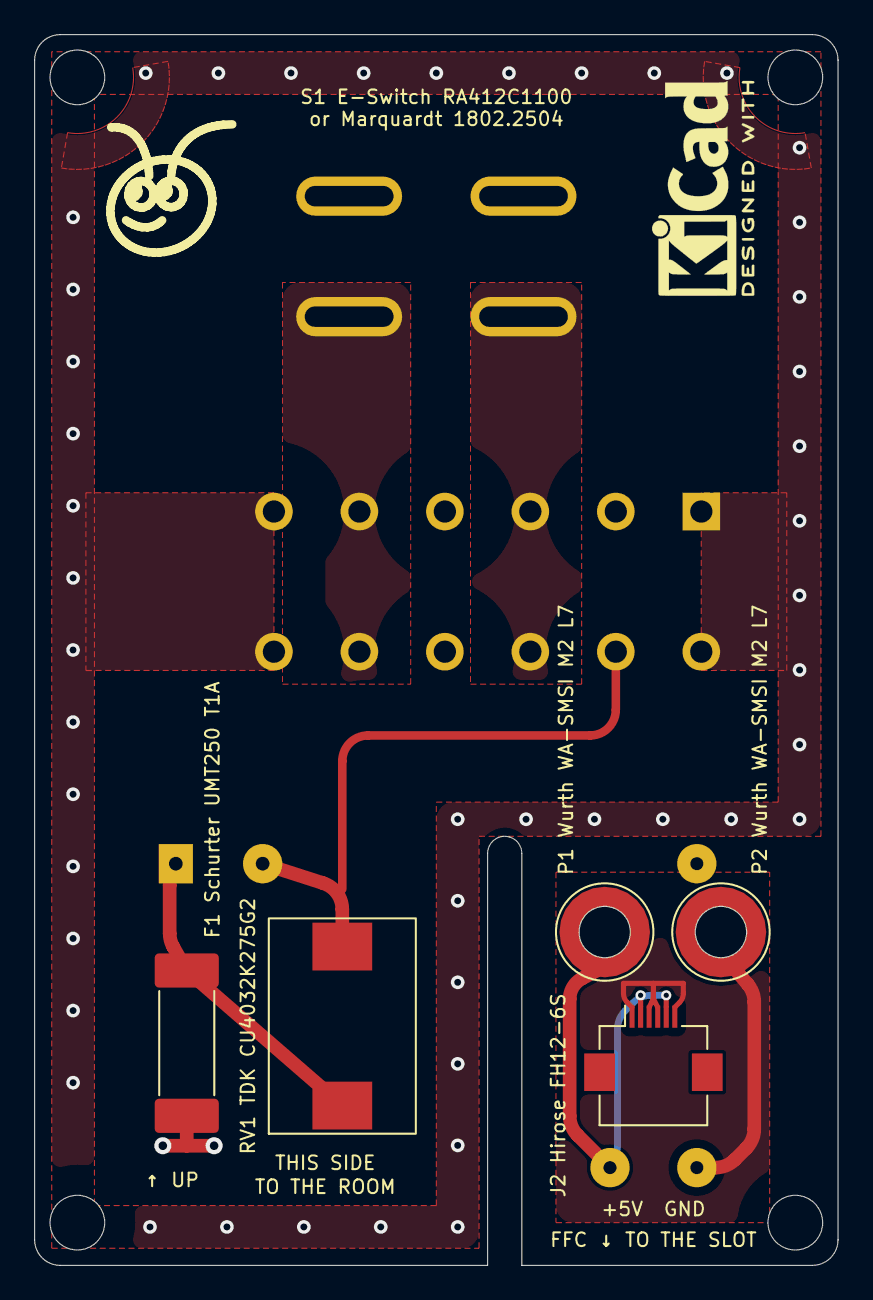
[picture p142: board na_mains_board.kicad_pcb from above]

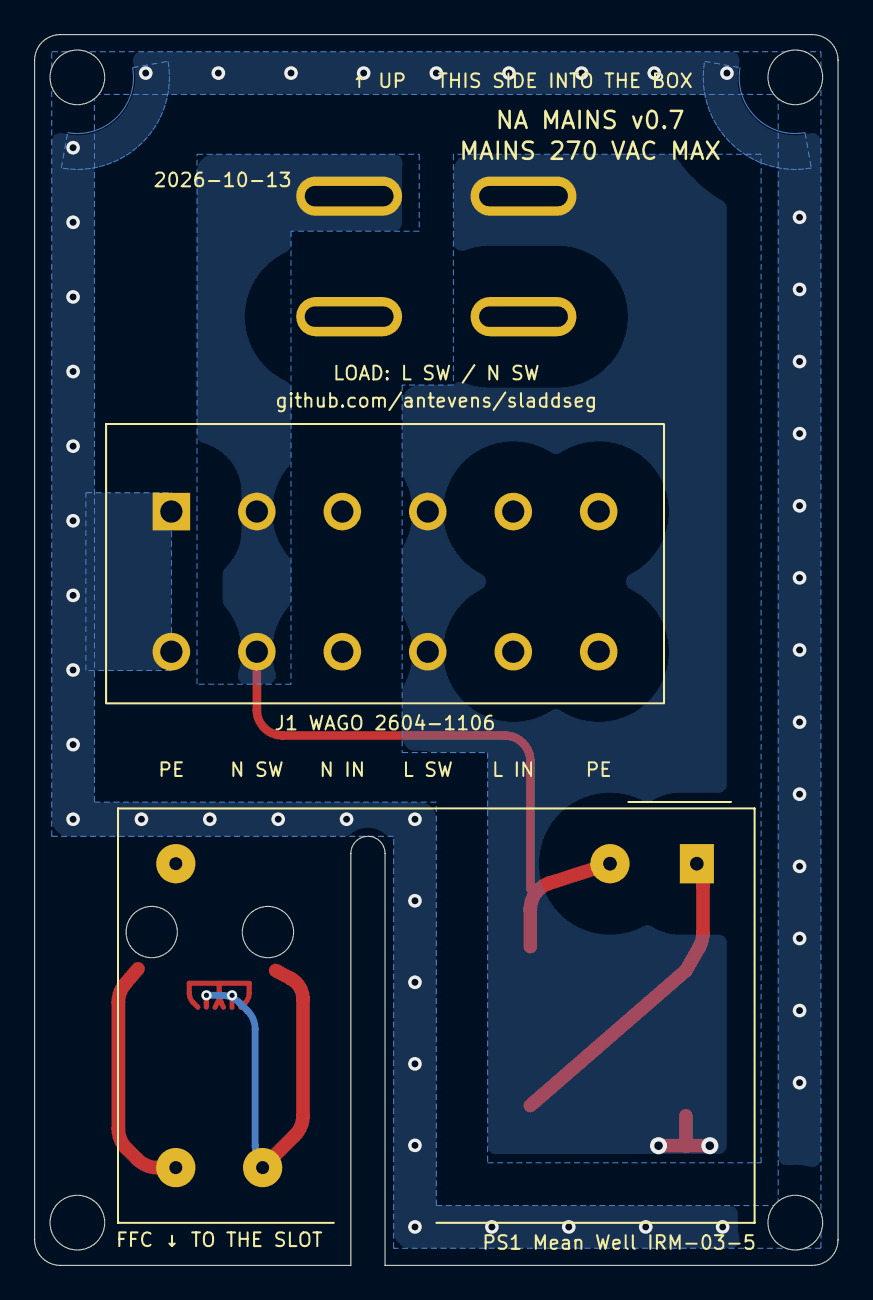
[picture p143: board na_mains_board.kicad_pcb from below]

Board: 2 copper layers, 47.0 x 72.0 mm, 14 parts (2 on the bottom side), 8 nets.

Other parts of the board:
LOGO1: Ant_Logo_8mm_SilkScreen
LOGO2: KiCad-Logo2_5mm_SilkScreen
MH1, MH2, MH3, MH4: MountingHole_3.2mm_M3_NPTH
