antevens/sladdseg/(commit log)

2026-10-09 Back cover: top clip, magnet ridge on the full shell, side ribs from measurements
    [backcover_PETG.3mf]
2026-10-09 Back cover: side ribs 0.8 mm thick
    [backcover_PETG.3mf]
2026-10-09 Back cover: snap hooks for the flex, stronger magnet clips, rounded contact posts; #6 countersink and PLATE_Y on the trim
    [cover_flex.kicad_pcb, cover_flex.kicad_sch, sensor_flex.kicad_pcb]
2026-10-09 Parts: replace the obsolete Murata capacitors, gold SSW socket on the EU 5 V board
    [eu_5v_board.kicad_sch, eu_5v_board_v0.2_bom.csv, wiring_board.kicad_pcb, wiring_board.kicad_sch, wiring_board_v0.3_bom.csv]
2026-10-09 DigiKey and Mouser order lists for test plates (make order)
    [all_digikey.csv, all_digikey_rest_mouser.csv, all_mouser.csv, all_mouser_rest_digikey.csv, eu_digikey.csv, eu_digikey_rest_mouser.csv, eu_mouser.csv, eu_mouser_rest_digikey.csv]
2026-10-09 Docs: back cover fixes, screw holes, parts and order lists
2026-10-09 Renders and print projects for the back cover and trim changes
    [backcover_PETG.3mf, coupons_PETG.3mf, eu_cap_PC-FR.3mf, eu_cap_PETG_testfit.3mf, eu_trim_PETG.3mf, floor_inserts_PETG.3mf, insert_PC-FR.3mf, insert_PETG_testfit.3mf]
2026-10-10 Smaller plate, flex ramps and tape points, battery-free tongue on the sensor flex, back cover hooks
    - Plate 72 x 132, 5 V contact in the corner, band groove, microphone below the band, two-layer
    sensor flex (D-47)
    - Ramps over the flex slopes; tape geometry and tape renders (render_tape.py, D-48)
    - Battery-free tongue moved from the 5 V jumper to the sensor flex: under the trim's tab and strip,
    under the floor insert, which hangs from the strip; EU tongue under its floor insert (D-49)
    - Back cover: bottom latch 2.9 mm from the edge, end-section snap hooks, notch for the run under
    the GND block; plate clips kept for PETG
    [Harwin_S7081-42R.step, PUI_DMM-4026-B-I2S_4x3mm.step, Sensirion_DFN-4_1.5x1.5mm_P0.8mm_SHT4x_NoCentralPad.step, cover_flex.kicad_pcb, eu_sensor_flex.kicad_pcb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]
2026-10-10 Docs: smaller plate, tape points, battery-free tongue on the sensor flex (D-47..D-49)
    DESIGN D-44, D-45, D-47..D-49; ASSEMBLY tape points and what holds each flex; BOM, PRINTING
    (PETG check of the back cover's clips), MEASUREMENTS, README, AGENTS, pcb/sensor/README.
2026-10-10 Renders and print projects for the smaller plate, the tongue and the back cover changes
    [backcover_PETG.3mf, coupons_PETG.3mf, eu_cap_PC-FR.3mf, eu_cap_PETG_testfit.3mf, eu_trim_PETG.3mf, floor_inserts_PETG.3mf, insert_PC-FR.3mf, insert_PETG_testfit.3mf]
2026-10-11 Boards for v0.4: ring board, mic carrier, riser, cover flex, EU cap board, wiring board posts
    - Ring board, mic carrier and riser in pcb/sensor/ (D-50, D-60, D-68); carrier and riser fab
    packs; the ring board waits on the MSR-2's CN2 part and map
    - Riser 14 x 12 mm, pins above and between the posts; cover flex with the run past the GND
    contact post and a jog from the pad section (D-79)
    - EU cap board on the carrier, closed snap windows, wider with the face plate (D-56, D-70,
    D-77, D-78); EU 5 V board pins follow the back cover's pads
    - Wiring board: WA-SMSI spacer posts in the 5 V area (SMT, spigot inside the board), J2
    - ERC / DRC clean on every board
    [Converter_ACDC_TRACO_TMPS03_THT.step, Fuse_Schurter_UMT250.step, Harwin_P70-2200045.step, Harwin_S7081-42R.step, Marquardt_1802.2504.step, PUI_DMM-4026-B-I2S_4x3mm.step, Sensirion_DFN-4_1.5x1.5mm_P0.8mm_SHT4x_NoCentralPad.step, Varistor_TDK_CU4032.step]
2026-10-11 CAD v0.4: ring board insert, straight 5 V bore, EU carrier clamp and snaps, test socket
    - NA: ring board on the collar, passive face plate, riser and spring pins through the pocket
    floor, nylon standoffs (D-50, D-57, D-68); the 5 V pass-through is one straight bore (D-74)
    - Back cover: 0.1 mm more room inside (D-75); pads 4.7 mm up and the run along the GND
    contact post's inner face, the post one piece (D-79)
    - EU: cap board on a carrier the cap pins to the wall (D-71); steel piece in a recess in the
    pocket floor (D-72); NA style finger scoops (D-73); the face plate snaps into closed windows
    in the carrier (D-77); face plate 84.6 mm wide, the carrier whole at the sides (D-78)
    - EU te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
    [backcover_PETG.3mf, coupons_PETG.3mf, eu_cap_PC-FR.3mf, eu_cap_PETG_testfit.3mf, eu_carrier_PETG.3mf, eu_testbox_PETG.3mf, eu_trim_PETG.3mf, floor_inserts_PETG.3mf]
2026-10-11 Docs and renders for v0.4 (D-50..D-79)
    DESIGN decision log D-50..D-79; ASSEMBLY, BOM, PRINTING, MEASUREMENTS, SAFETY, README, AGENTS;
    renders regenerated, the superseded ones removed.
2026-10-11 Board generators: shared P70 and WA-SMSI footprints, fixed revision date, EU boards v0.4
    - One Harwin P70 footprint with its 3D model for the riser and the EU 5 V board; one
    WA-SMSI land pattern for the wiring board posts and the ring board spacers
    - Shared library-table and symbol helpers; dead code from removed boards gone
    - REV_DATE replaces today's date on silkscreen and title blocks
    - EU boards v0.4; EU cap board fab pack written once CN2 is confirmed
    - Order lists key the EU header as TSM-102-02-L-SV (D-59)
    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
    [Converter_ACDC_TRACO_TMPS03_THT.step, Fuse_Schurter_UMT250.step, Harwin_P70-2200045.step, Harwin_S7081-42R.step, Marquardt_1802.2504.step, PUI_DMM-4026-B-I2S_4x3mm.step, Sensirion_DFN-4_1.5x1.5mm_P0.8mm_SHT4x_NoCentralPad.step, Varistor_TDK_CU4032.step]
2026-10-11 CAD cleanup: dead code removed, one bore definition, vent params, EU barrier holes unified
    - Removed parameters and helpers left from the sensor flex, tape points, old snap hooks
    and the EU flex; EU import list trimmed to what is used
    - insert.bore() shared by the insert and its check; redundant bore cut removed (volume
    unchanged)
    - Face plate bay frames and edge vents from params, NA and EU (volumes unchanged)
    - EU cap: all four pin holes 1.94 mm, checked; cap and cup floor checked against the V-0
    thickness (D-80); V0_RATED_T and the EU pin socket tagged MEASURE
    - Marker gauge removed, hacksaw guide only (D-81)
    - Back cover flex views moved into render_backcover.py; render_tape.py rem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
    [backcover_PETG.3mf, coupons_PETG.3mf, eu_cap_PC-FR.3mf, eu_cap_PETG_testfit.3mf, eu_carrier_PETG.3mf, eu_testbox_PETG.3mf, eu_trim_PETG.3mf, insert_PC-FR.3mf]
2026-10-11 Docs: current state, barrier rules for the EU cap, superseded decisions marked (D-80, D-81)
    - AGENTS: hard constraint 2 and SAFETY rules 8-9 cover the NA insert and the EU cap (D-80);
    layout, status, backlog and open questions current
    - DESIGN: superseded decisions marked; table renders again; D-80, D-81
    - ASSEMBLY, BOM, PRINTING, MEASUREMENTS, README, pcb READMEs: no tape, flex, tongue or
    adapter left; steel / magnet roles corrected; back cover five hooks; EU sizes
    - Renders: bc_flex*.png replace tape_cover*.png
2026-10-11 PCBWay order packs: PCBWay SMT assembly or bare boards
    - pcb/tools/order_pcbway.py (run by make order) writes pcb/order/pcbway/ for the boards ready
    to order: wiring board, riser, mic carrier, EU mains board, EU 5 V board
    - Option A: Gerbers, SMD-only BOM and centroid (KiCad, drill / aux origin), assembly
    drawings; DigiKey / Mouser lists for the THT parts, rockers and mechanical parts
    - Option B: Gerbers; DigiKey / Mouser lists for every part
    - README with board settings, order remarks (slots, castellations, panels) and steps; the
    ring board, EU cap board and cover flex are listed as not ready
    - order_bom.collect() takes a part filter, write() an output folder
    [eu_5v_board_pcbway_bom.csv, eu_5v_board_pcbway_centroid.csv, eu_mains_board_pcbway_bom.csv, eu_mains_board_pcbway_centroid.csv, mic_carrier_pcbway_bom.csv, mic_carrier_pcbway_centroid.csv, parts_digikey.csv, parts_digikey_rest_mouser.csv]
2026-10-11 Print projects: PLA for test prints, back cover in PETG and ABS
    - Test jobs print in Elegoo PLA (TEST in slice.py); PC-FR finals for the insert and EU cap
    - Back cover stays PETG (its clips broke in PLA, D-44); backcover_ABS added to test while
    the PETG is on its way (ABS shrinks more: fit check first)
    - PRINTING: re-sliced times and weights, filaments on hand, PC-FR without a UL94 claim;
    BOM, ASSEMBLY, AGENTS and README follow
    [backcover_ABS.3mf, backcover_PETG.3mf, coupons_PETG.3mf, coupons_PLA.3mf, eu_cap_PC-FR.3mf, eu_cap_PETG_testfit.3mf, eu_cap_PLA_testfit.3mf, eu_carrier_PETG.3mf]
2026-10-11 Mic on the boards, parts audit, rocker second source, CN2 land pattern, back cover fit (D-82..D-90)
    - Prototype PCBWay packs for the ring board, EU cap board and cover flex; logos and URL on the
    boards with room for them
    - CN2 mate: Molex 55909-2474 on an assumed 51338-2474 (D-82); land pattern from Molex
    SD-55909-003 rev J, B2B from SD-51338-003 rev K (D-89); contact map and pin 1 still open
    - Microphone: Knowles SPK0641HT4H-1 + ADAU7002 on the ring board and the EU cap board, the mic
    carrier removed; face plate sound column on a gasket (D-83); C3 KEMET C1206C104J3GACTU C0G
    (D-85)
    - Parts rule (active, stocked at DigiKey or Mouser) and audit: F1 3403.0166.11, cover flex 1 uF
    CL05A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
    [Analog_WLCSP-8_0.76x1.56mm_P0.4mm.step, Converter_ACDC_TRACO_TMPS03_THT.step, Fuse_Schurter_UMT250.step, Harwin_P70-2200045.step, Harwin_S7081-42R.step, Knowles_SPK0641HT4H-1_3x4mm.step, Marquardt_1802.2504.step, PUI_DMM-4026-B-I2S_4x3mm.step]
2026-10-11 NA riser: snap clips in its pocket hold it against the pins' push (D-91)
    - ring.riser_clips(): two fingers in the insert's riser pocket (top edge in line with the pins,
    right edge between them), 3.0 x 0.8, freed by a 0.3 mm relief up to 1.6 mm under the seat;
    hook 0.4 under the riser's back face, 0.1 play, 45 deg ramp; none on the left edge (the
    steel recess above leaves no floor for a relief)
    - checks: relief 1.6 mm under the steel recess, pin holes and remote pocket; hooks under the
    riser and clear of the pins, posts, sleeves and screws; barrier and overhangs unchanged
    - ASSEMBLY: the riser snaps in as the wiring board goes on, how to release it; PRINTING times;
    renders and print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
    [back_gauges_PLA.3mf, backcover_ABS.3mf, backcover_PETG.3mf, coupons_PLA.3mf, eu_cap_PC-FR.3mf, eu_cap_PLA_testfit.3mf, eu_carrier_PLA.3mf, eu_testbox_PLA.3mf]
2026-10-11 Back cover after the first print: bottom clip, side tabs, inside width (D-92, D-93)
    - Bottom snap clip (battery-contact end): 3.7 wide in the housing's 4.0 slot, hook 1.1 (was
    3.1 / 0.8); it snapped once, then not again. BC_LATCH_W per end; top clip unchanged
    - Side tabs (D-90): 0.45 out from the wall (was 0.25)
    - Inside 0.1 wider across x: long side walls 1.45 (BC_SIDE_WALL_X), outside 45.0, ends 1.50;
    back_shape() takes a separate inset across x
    - checks: clip widths per end, side wall thicknesses; renders and print projects regenerated
    [back_gauges_PLA.3mf, backcover_ABS.3mf, backcover_PETG.3mf, coupons_PLA.3mf, eu_cap_PC-FR.3mf, eu_cap_PLA_testfit.3mf, eu_carrier_PLA.3mf, eu_testbox_PLA.3mf]
2026-10-11 Docs: how to get the DigiKey and Mouser API keys for make stock / make order-push
    - pcb/order/README.md: DigiKey production app (Product Information V4, client ID and secret),
    Mouser Search API key and Order / Cart key (it can place orders), setting them as environment
    variables or devcontainer remoteEnv; never in the repo
    - AGENTS.md: make stock points to the key instructions
2026-10-11 Order lists: first live DigiKey stock check (D-84)
    - distributors.py: an empty DIGIKEY entry falls back to the MPN (the TSM header went to myLists
    with an empty part number); missing QuantityAvailable counts as 0; retries on server errors
    - 100 nF 0402: GRM155R71C104KA88J (KA88D had 0 at DigiKey); DigiKey numbers from the API for
    the Molex 55909-2474 (WM3787CT-ND), Keystone 25503 (36-25503-ND) and Samtec TSM-102-02-L-SV
    (SAM10268-ND)
    - Result: 24 of 26 active with stock at DigiKey; the FH12 (0 at DigiKey) and the rocker
    (Mouser only) wait for the Mouser Search key
    - Order lists and PCBWay packs regenerated
    [all_digikey.csv, all_mouser.csv, eu_cap_board_pcbway_bom.csv, eu_digikey.csv, eu_mouser.csv, na_digikey.csv, na_mouser.csv, parts_digikey.csv]
2026-10-11 make order-push: one NA plate by default, exact counts, rocker second source, price breaks
    - VARIANT=na|eu|both (default na), PLATES (default 1; both = PLATES of each); exactly what the
    plates use, no spares (make order's CSVs keep theirs)
    - ALTERNATES (order_bom.py): a part the primary distributor does not carry goes as its second
    source on the same footprint: DigiKey gets the E-Switch RA412C1100 (EG5628-ND) for the
    Marquardt 1802.2504 (D-88), so a DigiKey order needs no Mouser line
    - With DigiKey keys, a line goes up to a price break where the larger quantity costs less in
    total (StandardPricing); --no-price-breaks keeps the exact counts
    - DigiKey cut tape numbers for the ADAU7002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
    [all_digikey.csv, eu_digikey.csv, na_digikey.csv, parts_digikey.csv]
2026-10-11 Back cover: D-93 undone, the steel plate, its ridge and clips 0.3 mm deeper (D-96)
    - The old width fitted better: long side walls 1.50 again (inside 42.0 x 67.0); BC_SIDE_WALL_X
    and back_shape's separate x inset removed
    - BC_STEEL_FLOOR 1.6 -> 1.3: plate seat, ridge and clip hooks 0.3 lower (a clip post touched
    the housing); clip tabs 0.65 thick (were 0.8) to keep the snap-in strain at 2.8 %
    - Renders and print projects regenerated
    [back_gauges_PLA.3mf, backcover_ABS.3mf, backcover_PETG.3mf, coupons_PLA.3mf, eu_cap_PC-FR.3mf, eu_cap_PLA_testfit.3mf, eu_carrier_PLA.3mf, eu_testbox_PLA.3mf]
2026-10-11 Parts and order lists: EU PE connector, 22 uF C1, unit and devkit lists, E-Switch rocker (D-94, D-95, D-97)
    - D-94: the EU lights' PE joined in the box in a WAGO 221-412 (EXTRA_EU, ASSEMBLY step 5); the
    boards carry no PE; the steel piece's insulation added to the EU review checklist
    - D-95: 22 uF C1 KEMET C1206C226M4PACTU (16 V X5R, 1.8 max) on the ring board, the EU cap board
    and the EU 5 V board; the Samsung CL31A226KPHNNNE has a 61-week maker lead time
    - D-97: make order writes unit_na, unit_eu, devkit_na, devkit_eu (4 sets per variant,
    DEVKIT_SETS), exact counts; the PCBWay packs are the devkit (5 PCBs per design); the old
    3 NA + 2 EU lists removed
    - Rocker: both variants' lists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
    [Analog_WLCSP-8_0.76x1.56mm_P0.4mm.step, Converter_ACDC_TRACO_TMPS03_THT.step, Fuse_Schurter_UMT250.step, Harwin_P70-2200045.step, Harwin_S7081-42R.step, Knowles_SPK0641HT4H-1_3x4mm.step, Marquardt_1802.2504.step, Sensirion_DFN-4_1.5x1.5mm_P0.8mm_SHT4x_NoCentralPad.step]
2026-10-11 Cost: SHT40, Murata C0G, GCT FFC (D-98)
    - U1 SHT45-AD1B-R2 -> SHT40-AD1B-R2 (same SHT4x DFN-4, I2C 0x44; 9.76 -> 3.10 CAD); renamed in
    the CAD, generators and docs
    - C3 KEMET C1206C104J3GACTU -> Murata GRM3195C1H104JA05D (100 nF C0G 50 V 1206, 0.95 max;
    3.52 -> 0.58)
    - W1 FFC Wurth 687606152002 -> GCT 05-06-A-0152-A-4-06-4-G (same cable; 4.67 -> 3.26), the
    Wurth as the alternative
    - DigiKey, one plate: NA 90.04 -> 79.03, EU 88.51 -> 78.91 CAD; boards ERC / DRC clean, order
    lists and PCBWay packs regenerated
    [Analog_WLCSP-8_0.76x1.56mm_P0.4mm.step, Converter_ACDC_TRACO_TMPS03_THT.step, Fuse_Schurter_UMT250.step, Harwin_P70-2200045.step, Harwin_S7081-42R.step, Knowles_SPK0641HT4H-1_3x4mm.step, Marquardt_1802.2504.step, Sensirion_DFN-4_1.5x1.5mm_P0.8mm_SHT4x_NoCentralPad.step]
2026-10-11 Back cover: the magnet plate as deep as its clips allow (D-99)
    - BC_STEEL_FLOOR 1.3 -> 0.8: plate, ridge and clip hooks 0.5 lower, gap to the pocket's steel
    piece about 1.3 mm (was about 1.8); a lower plate pulls harder
    - Clip tabs 0.48 thick (2.7 mm free, 2.9 % snap-in strain); the hook still 0.30 over the plate
    - Back cover print settings detect thin walls (the tabs print as one line); renders and print
    projects regenerated
    [back_gauges_PLA.3mf, backcover_ABS.3mf, backcover_PETG.3mf, coupons_PLA.3mf, eu_cap_PC-FR.3mf, eu_cap_PLA_testfit.3mf, eu_carrier_PLA.3mf, eu_testbox_PLA.3mf]
2026-10-11 EU PSU: Zettler ZPI03S0500WC instead of the Traco TMPS 03-105 (D-100)
    - 8.72 against 24.09 CAD at DigiKey (an EU plate's parts 63.54, was 78.91); 5 V 600 mA,
    I/P-O/P 3600 VAC, UL/EN 62368-1; body 25 x 25 x 16 +-0.5 (PSU the maximum)
    - Footprint from Zettler's PCB layout (AC pins 15 apart, outputs 5 apart, rows 15 apart, 1.2
    holes), 4-pin symbol; the NC pin and its DRC rule removed
    - Mains board re-laid: fused line track 3.5 from the N pin, relief slot y -15, 5 V header x 8.5
    beside V+, F1 (15.0, -2.5), front logos above the slot; both EU boards ERC / DRC clean,
    make eu passes
    - Open for review: reinforced insulation and overvoltage category not stated; Zettler's input
    fuse 0.5 A (F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
    [Analog_WLCSP-8_0.76x1.56mm_P0.4mm.step, Converter_ACDC_TRACO_TMPS03_THT.step, Converter_ACDC_Zettler_ZPI03_THT.step, Fuse_Schurter_UMT250.step, Harwin_P70-2200045.step, Harwin_S7081-42R.step, Knowles_SPK0641HT4H-1_3x4mm.step, Marquardt_1802.2504.step]
2026-10-11 Remote end shape gauges (D-101); backlog: plain versions without the sensors
    - coupons.end_gauges() / print/end_gauges_PLA.3mf: five flat '#' frames for the inside of the
    original back cover, bar tips cut to its inside outline with corner radius 20.9 (stadium),
    18, 15, 12, 9; bars clear of the magnet holder, the end clips and the side tabs; B_END_R
    added to MEASUREMENTS
    - AGENTS backlog: NA / EU versions without the microphone, temperature sensor and MSR-2 once
    the full plates are done
    [back_gauges_PLA.3mf, backcover_ABS.3mf, backcover_PETG.3mf, coupons_PLA.3mf, end_gauges_PLA.3mf, eu_cap_PC-FR.3mf, eu_cap_PLA_testfit.3mf, eu_carrier_PLA.3mf]
2026-10-12 v0.5: back cover ends, mains spacing 3.0 mm, NA fuse separation, labels, bare renders (D-101..D-106)
    - D-101: back cover shell gauges (R15..R20.9); the stadium end is confirmed
    - D-102: mains spacing 3.0 mm on high-CTI FR4 (MAINS_GAP, NA and EU)
    - D-103: back cover end walls 1.40 mm, inside 0.2 mm longer (BC_END_WALL)
    - D-104: NA wiring board: any two mains nets 3.0 mm apart, L_F re-routed
    F1.2 -> RV1.1, L_SW vias below F1, L_SW pour up towards the rocker;
    EU mains board checked, unchanged
    - D-105: rocker silkscreen "E-Switch RA412C1100 or Marquardt 1802.2504",
    EU 5 V socket part on its label; bare 3D renders for every board
    - D-106: version v0.5; v0.4 fab packs, PCBWay packs and rende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
    [Analog_WLCSP-8_0.76x1.56mm_P0.4mm.step, Converter_ACDC_Zettler_ZPI03_THT.step, Fuse_Schurter_UMT250.step, Harwin_P70-2200045.step, Harwin_S7081-42R.step, Knowles_SPK0641HT4H-1_3x4mm.step, Marquardt_1802.2504.step, Sensirion_DFN-4_1.5x1.5mm_P0.8mm_SHT4x_NoCentralPad.step]
2026-10-12 Back cover: D-103 undone, end clips nearer the ends (D-107); versions tagged per bump
    - End walls 1.50 again (inside 42.0 x 67.0); BC_END_WALL removed
    - Bottom clip hook tip 3.25 mm in from the rim (was 4.0), top clip 0.3 nearer the end (2.7, was 3.0)
    - AGENTS: tag and branch vX.Y at the last commit of each old version
    [back_gauges_PLA.3mf, backcover_ABS.3mf, backcover_PETG.3mf, coupons_PLA.3mf, end_gauges_PLA.3mf, eu_cap_PC-FR.3mf, eu_cap_PLA_testfit.3mf, eu_carrier_PLA.3mf]
2026-10-12 Plain plates, back cover clips, cover flex 0.10 mm (D-108..D-115)
    - D-109: full and plain editions, NA and EU: plain insert without the 5 V cable
    bore, standard-size NA face plate (69.85 x 114.3 mm), EU plain cap, carrier
    and 80 x 80 face plate; checks, print jobs, renders, order lists
    (unit_*_plain, order-push VARIANT=na-plain|eu-plain|both-plain)
    - D-108, D-110, D-112, D-115: bottom clip hook 1.7 mm, tip 3.95 mm in, hook top
    3.25 mm below the rim; side tabs 0.1 higher
    - D-113: bottom hook with a flat underside that catches the housing's slot
    - D-111: magnet plate clips 0.8 mm thick
    - D-114: cover flex 0.10 mm (PCBWay default)
    [Analog_WLCSP-8_0.76x1.56mm_P0.4mm.step, Converter_ACDC_Zettler_ZPI03_THT.step, Fuse_Schurter_UMT250.step, Harwin_P70-2200045.step, Harwin_S7081-42R.step, Knowles_SPK0641HT4H-1_3x4mm.step, Marquardt_1802.2504.step, Sensirion_DFN-4_1.5x1.5mm_P0.8mm_SHT4x_NoCentralPad.step]
2026-10-12 Flex review fixes, back cover clip, README, Sladdseg, order lists (D-116..D-119)
    - D-116: cover flex: 0603 X5R input/output caps, ESD diode TPD1E10B06DYAR,
    0.6 mm bend radius with relief slits, stiffener notch and outlines,
    coverlay expansion, mask-defined pin pads, teardrops, fab notes; the
    cover's snap hooks allow for stiffener adhesive and tolerance
    - D-117, D-118: bottom clip catch 3.22 above the floor, tip as far proud of
    the shell as the top clip's
    - Battery polarity confirmed on a unit
    - README rewritten: three editions, assembly renders, safety and polarity
    warnings, cost for 1 to 10,000 plates, printed parts; detail and board
    renders moved to their docs; the product is n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
    [Analog_WLCSP-8_0.76x1.56mm_P0.4mm.step, Converter_ACDC_Zettler_ZPI03_THT.step, Fuse_Schurter_UMT250.step, Harwin_P70-2200045.step, Harwin_S7081-42R.step, Knowles_SPK0641HT4H-1_3x4mm.step, Marquardt_1802.2504.step, Sensirion_DFN-4_1.5x1.5mm_P0.8mm_SHT4x_NoCentralPad.step]
2026-10-12 Version v0.6 (D-120): boards, fab and PCBWay packs, order upload name and renders renamed; v0.5 files removed
    [Analog_WLCSP-8_0.76x1.56mm_P0.4mm.step, Converter_ACDC_Zettler_ZPI03_THT.step, Fuse_Schurter_UMT250.step, Harwin_P70-2200045.step, Harwin_S7081-42R.step, Knowles_SPK0641HT4H-1_3x4mm.step, Marquardt_1802.2504.step, Sensirion_DFN-4_1.5x1.5mm_P0.8mm_SHT4x_NoCentralPad.step]
2026-10-12 NA face plate: edge chamfer uniform over the sensor bays (D-121)
    [trim_PLA.3mf]
2026-10-12 Switch-only edition: rocker switch and terminal blocks only, NA and EU; battery-free NA fits J2 (D-122)
    [back_gauges_PLA.3mf, coupons_PLA.3mf, end_gauges_PLA.3mf, eu_cap_PC-FR.3mf, eu_cap_PLA_testfit.3mf, eu_carrier_PLA.3mf, eu_plain_cap_PC-FR.3mf, eu_plain_cap_PLA_testfit.3mf]
2026-10-12 Back cover: walls 0.2 mm further out, inside round-over 0.2 mm wider (D-123)
    [backcover_ABS.3mf, backcover_PETG.3mf]
2026-10-12 Gauges removed (D-124); pcb/README.md as the overview of all boards
    [back_gauges_PLA.3mf, backcover_ABS.3mf, backcover_PETG.3mf, coupons_PLA.3mf, end_gauges_PLA.3mf, eu_cap_PC-FR.3mf, eu_cap_PLA_testfit.3mf, eu_carrier_PLA.3mf]
2026-10-12 Variants equal: na/eu/shared layout, shared part names, no default variant (D-125)
    [Analog_WLCSP-8_0.76x1.56mm_P0.4mm.step, Converter_ACDC_Zettler_ZPI03_THT.step, Fuse_Schurter_UMT250.step, Harwin_P70-2200045.step, Harwin_S7081-42R.step, Knowles_SPK0641HT4H-1_3x4mm.step, Marquardt_1802.2504.step, Sensirion_DFN-4_1.5x1.5mm_P0.8mm_SHT4x_NoCentralPad.step]
2026-10-12 Back cover: no ledges in the round-over, inside eased out where the housing rubs, bottom clip 0.1 nearer the rim with a 30 deg ramp (D-126)
    [backcover_ABS.3mf, backcover_PETG.3mf, eu_barrier_PC-FR.3mf, eu_barrier_PLA_testfit.3mf, eu_carrier_PLA.3mf, eu_face_plate_PLA.3mf, eu_plain_barrier_PC-FR.3mf, eu_plain_barrier_PLA_testfit.3mf]
2026-10-13 v0.6: one barrier per variant, EU ridges, NA cable slit, ElegooSlicer projects, back cover and plate fixes (D-127..D-150)
    - One barrier per variant for every edition; printed blank board in switch only (D-127..D-131)
    - EU pin board ridge loop and blank board ridge; more pin board bosses (D-128..D-133)
    - NA face plate lobes round the screws form the pocket's ends (D-132)
    - NA 5 V cable straight from J2 to J1 through a slit in the barrier's bottom wall, 50 mm FFC; MH3 back in line;
    slit open in battery-free and switch only (D-134, D-135)
    - Back cover: flex pad section 1.5 mm in, rim cut at the bottom end with a 0.08 mm-layer taper, steel plate clips
    solid in the shell, bottom clip lead-in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
    [Analog_WLCSP-8_0.76x1.56mm_P0.4mm.step, Converter_ACDC_Zettler_ZPI03_THT.step, Fuse_Schurter_UMT250.step, Harwin_P70-2200045.step, Harwin_S7081-42R.step, Knowles_SPK0641HT4H-1_3x4mm.step, Marquardt_1802.2504.step, Sensirion_DFN-4_1.5x1.5mm_P0.8mm_SHT4x_NoCentralPad.step]
2026-10-13 Version v0.7 (D-151): boards, fab and PCBWay packs, order upload name and section renders renamed; v0.6 files removed
    [Analog_WLCSP-8_0.76x1.56mm_P0.4mm.step, Converter_ACDC_Zettler_ZPI03_THT.step, Fuse_Schurter_UMT250.step, Harwin_P70-2200045.step, Harwin_S7081-42R.step, Knowles_SPK0641HT4H-1_3x4mm.step, Marquardt_1802.2504.step, Sensirion_DFN-4_1.5x1.5mm_P0.8mm_SHT4x_NoCentralPad.step]
2026-10-14 README: front page rewritten around the pitch, why, editions and what is in the plate; EU section render added; status and contributing sections
2026-10-14 README: design section without the market survey, no tool brands or test-fit notes, one mains board (bus bars; high-CTI version dropped)
2026-10-14 README: editions as a feature matrix (Switch, Batt Free, Full), shorter design bullets, status and cost summary removed from the opening
2026-10-14 High-CTI mains boards dropped (D-155): AGENTS, docs, board READMEs and fab checklists describe one bus-bar mains board per variant; README editions as one row each, table cells capitalised
